davinciucberkeley-collab/DBF-VTOL/DESIGN.md

---
name: Design-Build-Fly Review Platform
description: Interactive engineering review platform for a student lift + cruise VTOL; an app shell of sidebar, sub-tabs and visual-first workspaces, dark graphite by default with a light theme, one blue signal accent.
colors:
  signal-blue: "#5B9DFF"
  signal-blue-hover: "#8AB8FF"
  signal-blue-wash: "#15243A"
  signal-blue-rule: "#2C4D7D"
  on-signal: "#0E1116"
  night-graphite: "#0E1116"
  panel-graphite: "#151A21"
  raised-graphite: "#1C222B"
  pressed-graphite: "#242B35"
  hairline: "#20262F"
  divider: "#2A313C"
  strong-rule: "#3A4250"
  text-primary: "#E6EAF0"
  text-secondary: "#A3ADBA"
  text-tertiary: "#828C9A"
  status-met: "#5FD3A2"
  status-met-wash: "#10301F"
  status-risk: "#F0C46E"
  status-risk-wash: "#33270F"
  status-fail: "#F59393"
  status-fail-wash: "#391B1D"
  status-fail-frame: "#7A3A3D"
  status-open: "#B9AEFF"
  status-open-wash: "#251F45"
  status-open-frame: "#4A4290"
  series-1: "#6EA8FE"
  series-2: "#5CC8B8"
  series-3: "#E8B65A"
  series-4: "#D98BC0"
  series-5: "#9AA7B8"
  series-6: "#A9C46A"
  stage-top: "#1B212A"
  stage-bottom: "#0F1318"
  drawing-paper: "#FFFFFF"
  light-canvas: "#F7F8FA"
  light-panel: "#FFFFFF"
  light-raised: "#EEF1F5"
  light-pressed: "#E3E7ED"
  light-hairline: "#E6E9EE"
  light-divider: "#DADEE4"
  light-strong-rule: "#B9C0CA"
  light-text-primary: "#0F1419"
  light-text-secondary: "#4A5361"
  light-text-tertiary: "#616B79"
  light-signal-blue: "#2A66CC"
  light-signal-blue-hover: "#1F57B8"
  light-signal-blue-wash: "#E7EFFC"
  light-signal-blue-rule: "#A9C3EE"
  light-status-met: "#11734A"
  light-status-met-wash: "#E3F5EC"
  light-status-risk: "#8A5A0B"
  light-status-risk-wash: "#FBF0D9"
  light-status-fail: "#A42828"
  light-status-fail-wash: "#FBE5E5"
  light-status-fail-frame: "#E2A5A5"
  light-status-open: "#4B3BA8"
  light-status-open-wash: "#ECE9FC"
  light-status-open-frame: "#B7AEEB"
  light-series-2: "#1E8C7E"
  light-series-3: "#B7791F"
  light-series-4: "#A2427F"
  light-series-5: "#5B6B7C"
  light-series-6: "#5F7A1E"
  light-stage-top: "#F3F5F8"
  light-stage-bottom: "#DCE1E8"
  print-canvas: "#FBFBFA"
  print-surface-2: "#F4F5F6"
  print-line: "#E3E5E8"
  print-line-2: "#CBCFD4"
  print-line-3: "#9EA4AC"
  print-text-primary: "#16191D"
  print-text-secondary: "#474E57"
  print-text-tertiary: "#6C737C"
  print-status-met: "#23744A"
  print-status-risk: "#94600A"
  print-status-fail: "#AD2A1F"
  print-status-open: "#57489A"
typography:
  cover-title:
    fontFamily: "IBM Plex Sans, system-ui, -apple-system, Segoe UI, sans-serif"
    fontSize: "1.875rem"
    fontWeight: 600
    lineHeight: 1.15
    letterSpacing: "-0.025em"
  page-title:
    fontFamily: "IBM Plex Sans, system-ui, -apple-system, Segoe UI, sans-serif"
    fontSize: "1.625rem"
    fontWeight: 600
    lineHeight: 1.15
    letterSpacing: "-0.02em"
  verdict-headline:
    fontFamily: "IBM Plex Sans, system-ui, -apple-system, Segoe UI, sans-serif"
    fontSize: "1.5rem"
    fontWeight: 600
    lineHeight: 1.3
    letterSpacing: "-0.02em"
  section-title:
    fontFamily: "IBM Plex Sans, system-ui, -apple-system, Segoe UI, sans-serif"
    fontSize: "1.125rem"
    fontWeight: 600
    lineHeight: 1.15
    letterSpacing: "-0.012em"
  subhead:
    fontFamily: "IBM Plex Sans, system-ui, -apple-system, Segoe UI, sans-serif"
    fontSize: "0.9375rem"
    fontWeight: 600
    lineHeight: 1.15
    letterSpacing: "-0.012em"
  lede:
    fontFamily: "IBM Plex Sans, system-ui, -apple-system, Segoe UI, sans-serif"
    fontSize: "1.0625rem"
    fontWeight: 400
    lineHeight: 1.65
  body:
    fontFamily: "IBM Plex Sans, system-ui, -apple-system, Segoe UI, sans-serif"
    fontSize: "0.9375rem"
    fontWeight: 400
    lineHeight: 1.6
    letterSpacing: "-0.003em"
    fontFeature: "tnum"
  ui-label:
    fontFamily: "IBM Plex Sans, system-ui, -apple-system, Segoe UI, sans-serif"
    fontSize: "0.875rem"
    fontWeight: 500
    lineHeight: 1.3
  meta-label:
    fontFamily: "IBM Plex Sans, system-ui, -apple-system, Segoe UI, sans-serif"
    fontSize: "0.75rem"
    fontWeight: 500
    lineHeight: 1.3
    letterSpacing: "0.01em"
  chip:
    fontFamily: "IBM Plex Sans, system-ui, -apple-system, Segoe UI, sans-serif"
    fontSize: "0.75rem"
    fontWeight: 600
    lineHeight: 1
  data-value:
    fontFamily: "IBM Plex Mono, ui-monospace, Cascadia Mono, Consolas, monospace"
    fontSize: "1rem"
    fontWeight: 500
    lineHeight: 1.3
    letterSpacing: "-0.01em"
  table-number:
    fontFamily: "IBM Plex Mono, ui-monospace, Cascadia Mono, Consolas, monospace"
    fontSize: "0.78rem"
    fontWeight: 400
    letterSpacing: "-0.01em"
  source-line:
    fontFamily: "IBM Plex Mono, ui-monospace, Cascadia Mono, Consolas, monospace"
    fontSize: "0.75rem"
    fontWeight: 400
    lineHeight: 1.55
  est-mark:
    fontFamily: "IBM Plex Mono, ui-monospace, Cascadia Mono, Consolas, monospace"
    fontSize: "0.75rem"
    fontWeight: 600
    lineHeight: 1
    letterSpacing: "0.04em"
  signature:
    fontFamily: "STIX Two Text, Times New Roman, serif"
    fontSize: "1rem"
    fontWeight: 400
    lineHeight: "30px"
  icon:
    fontFamily: "Material Symbols Outlined"
    fontSize: "20px"
    fontWeight: 300
    lineHeight: 1
rounded:
  mark: "4px"
  chip: "5px"
  control: "6px"
  panel: "8px"
  popover: "10px"
spacing:
  unit: "4px"
  tight: "8px"
  snug: "12px"
  base: "16px"
  roomy: "28px"
  gutter: "40px"
  topbar-height: "52px"
  sidebar-width: "248px"
  inspector-width: "300px"
  workspace-max: "1200px"
components:
  button-primary:
    backgroundColor: "{colors.signal-blue}"
    textColor: "{colors.on-signal}"
    typography: "{typography.ui-label}"
    rounded: "{rounded.control}"
    padding: "0 16px"
    height: "38px"
  button-primary-hover:
    backgroundColor: "{colors.signal-blue-hover}"
    textColor: "{colors.on-signal}"
  button-quiet:
    backgroundColor: "transparent"
    textColor: "{colors.text-primary}"
    rounded: "{rounded.control}"
    padding: "0 16px"
    height: "38px"
  button-quiet-hover:
    backgroundColor: "{colors.raised-graphite}"
  toolbar-button:
    backgroundColor: "transparent"
    textColor: "{colors.text-secondary}"
    rounded: "{rounded.control}"
    padding: "0 9px"
    height: "36px"
  toolbar-button-pressed:
    backgroundColor: "{colors.signal-blue-wash}"
    textColor: "{colors.text-primary}"
  search-trigger:
    backgroundColor: "{colors.panel-graphite}"
    textColor: "{colors.text-tertiary}"
    rounded: "{rounded.control}"
    padding: "0 9px"
    height: "36px"
    width: "220px"
  nav-item:
    backgroundColor: "transparent"
    textColor: "{colors.text-secondary}"
    typography: "{typography.ui-label}"
    rounded: "{rounded.control}"
    padding: "0 10px"
    height: "34px"
  nav-item-current:
    backgroundColor: "{colors.raised-graphite}"
    textColor: "{colors.text-primary}"
  sub-tab:
    backgroundColor: "transparent"
    textColor: "{colors.text-tertiary}"
    typography: "{typography.ui-label}"
    padding: "0 12px"
    height: "40px"
  sub-tab-selected:
    textColor: "{colors.text-primary}"
  viewer-toggle:
    backgroundColor: "{colors.raised-graphite}"
    textColor: "{colors.text-secondary}"
    rounded: "{rounded.chip}"
    padding: "0 15px"
    height: "34px"
  viewer-toggle-pressed:
    backgroundColor: "{colors.signal-blue-wash}"
    textColor: "{colors.text-primary}"
  chip-met:
    backgroundColor: "{colors.status-met-wash}"
    textColor: "{colors.status-met}"
    typography: "{typography.chip}"
    rounded: "{rounded.chip}"
    padding: "4px 7px"
  chip-risk:
    backgroundColor: "{colors.status-risk-wash}"
    textColor: "{colors.status-risk}"
    typography: "{typography.chip}"
    rounded: "{rounded.chip}"
    padding: "4px 7px"
  chip-fail:
    backgroundColor: "{colors.status-fail-wash}"
    textColor: "{colors.status-fail}"
    typography: "{typography.chip}"
    rounded: "{rounded.chip}"
    padding: "4px 7px"
  chip-open:
    backgroundColor: "{colors.status-open-wash}"
    textColor: "{colors.status-open}"
    typography: "{typography.chip}"
    rounded: "{rounded.chip}"
    padding: "4px 7px"
  est-mark:
    backgroundColor: "transparent"
    textColor: "{colors.text-secondary}"
    typography: "{typography.est-mark}"
    rounded: "{rounded.mark}"
    padding: "2px 4px"
  panel:
    backgroundColor: "{colors.panel-graphite}"
    textColor: "{colors.text-primary}"
    rounded: "{rounded.panel}"
    padding: "16px 18px"
  key-parameter-row:
    backgroundColor: "{colors.panel-graphite}"
    textColor: "{colors.text-primary}"
    typography: "{typography.data-value}"
    padding: "10px 14px"
  search-palette:
    backgroundColor: "{colors.panel-graphite}"
    textColor: "{colors.text-primary}"
    rounded: "{rounded.popover}"
    width: "640px"
---

# Design System: Design-Build-Fly Review Platform

## Overview

**Creative North Star: "The Engineering Workspace"**

The review is a tool the client and the team work inside, not a document they scroll. It borrows its presentation of geometry from Onshape, its organisation of analysis cases from SimScale, and its type, spacing and navigation from Linear. A sticky top bar and a persistent left sidebar frame a single workspace; each chapter is a page, long chapters split into sub-tabs, and wherever the project owns a viewer (the live SOLIDWORKS model, the drawing set, the CFD flow field) that viewer leads the page with an inspector beside it.

The surface is quiet so the engineering can be loud. Dark graphite is the default and a light theme is one click away; both are built from the same token names. One blue signal accent marks where the reader is and what is selected. Green, amber, red and violet are reserved for verdicts, and every other hue belongs to data. Panels are flat with 1px borders and 8px corners; nothing floats except popovers. Numbers, parameters and source paths are set in IBM Plex Mono so a reader can tell measured values from prose at a glance.

The traditional report is not abandoned. Report view and print render every page in order from the same content as one document, with a cover, revision record, approvals, contents and every disclosure open.

**Key Characteristics:**
- App shell: 52px sticky top bar, 248px sidebar, workspace capped at 1200px.
- Pages are chapters; sub-tabs come from the chapter's own section headings; hash routes per page and tab.
- Visual-first workspaces: the viewer leads, a 300px inspector sits beside it.
- IBM Plex Sans for prose and UI, IBM Plex Mono for anything measured or cited.
- One blue signal accent; verdict colours carry status only; other hues are data.
- Flat 1px panels, 8px radius, shadows on popovers only.
- Key parameters are a spec list, never hero metric tiles.

## Colors

A cool, low-chroma graphite (or near-white) field, one blue signal, four tinted verdict hues and a separate data palette.

### Primary
- **Signal Blue** (signal-blue; light theme light-signal-blue): links, keyboard focus rings, the selected sub-tab underline, the current sidebar entry's icon, the brand mark, pressed viewer toggles (as a wash with a blue rule), the highlighted row in the search palette, measurement IDs, and the fill of the one primary button style. It is never a status and never a large area.
- **Signal Blue Hover** (signal-blue-hover): link and primary-button hover.
- **Signal Blue Wash / Rule** (signal-blue-wash, signal-blue-rule): the selected state of toggles, the chosen table row, the picked concept card and the active Report view button. A wash with a 1px blue rule is how selection looks on any control larger than a link.

### Tertiary (verdicts)
- **Met** (status-met, on status-met-wash), **At risk** (status-risk, on status-risk-wash), **Fail** (status-fail, on status-fail-wash, framed by status-fail-frame on blocking decisions), **Open** (status-open, on status-open-wash, framed by status-open-frame). Light-theme equivalents carry the light- prefix. These colour status chips, verdict table cells, key-parameter values and decision-card labels, and nothing else.

### Data
- **Series 1 to 6** (series-1 to series-6; light theme uses light-signal-blue as series 1 and light-series-2 to 6): chart series, the design-iterations bars and the CFD colour ramps. Warm and cool hues outside the accent and verdict sets appear only here.
- **Model stage** (stage-top to stage-bottom): the radial gradient behind the live CAD model.
- **Drawing Paper** (drawing-paper): drawing sheets and the static render sit on white in both themes, because the shop drawings are white sheets.

### Neutral
- **Night Graphite** (night-graphite): page canvas, top bar (at 92% with a blur), sidebar and table header background in dark.
- **Panel Graphite** (panel-graphite): every panel: key parameters, tables, charts, viewers, inspector, decision cards, cover, palette.
- **Raised Graphite** (raised-graphite): hover fills, the current sidebar entry, inline code, recommendation boxes, total rows.
- **Pressed Graphite** (pressed-graphite): pressed segmented buttons and viewer-toggle hover.
- **Hairline** (hairline): panel borders, row dividers, the top bar and sidebar edges, the sub-tab baseline.
- **Divider** (divider): control borders, table header underline, decision-card frames.
- **Strong Rule** (strong-rule): the EST outline, scrollbar thumbs, signature lines, total-row rules, chart axes.
- **Text Primary / Secondary / Tertiary** (text-primary, text-secondary, text-tertiary): headings and values; prose summaries, labels and inactive controls; meta, captions, sources, group labels and numbering.
- The light theme mirrors every neutral with the light- prefix.

### Print
Print and the printing state switch to a fixed warm-white paper palette (print- tokens) regardless of screen theme, so charts redrawn before printing use it.

### Named Rules
**The One Signal Rule.** Blue means "here" or "selected" or "follow this". It is never a status, never a section fill and never decoration. A second accent hue is not added.

**The Verdict Colours Rule.** Green, amber, red and violet mean met, at risk, fail and open, and nothing else. They never colour chart series or decoration, and no status is shown that the analysis has not established.

**The Never-Colour-Alone Rule.** Every status shown by colour is also stated in words: chips carry their label, verdict cells carry a note, decision cards carry an "Open" or "Blocking" label.

**The Data-Owns-Hue Rule.** Warm and cool hues beyond the accent and the verdicts are reserved for data: chart series, CFD ramps and the model stage.

## Typography

**Display Font:** IBM Plex Sans (with system-ui, -apple-system, Segoe UI, sans-serif)
**Body Font:** IBM Plex Sans 400/500/600
**Label/Mono Font:** IBM Plex Mono 400/500 (with ui-monospace, Cascadia Mono, Consolas)
**Signature Font:** STIX Two Text italic, loaded only in italic
**Icons:** Material Symbols Outlined, weight 300, unfilled, 19 to 22px

**Character:** A neutral, engineered sans that stays out of the way, paired with its own mono so values and file paths read as a different register without a different personality.

### Hierarchy
- **Cover title** (600, 1.875rem, 1.15, -0.025em): the report title on Report info and in Report view.
- **Page title** (600, 1.625rem, 1.15, -0.02em; 1.375rem below 560px): each page's heading, preceded by its chapter number in mono at text-tertiary. Hidden on the Overview home page, where the verdict headline leads.
- **Verdict headline** (600, 1.5rem, 1.3, -0.02em; 1.25rem on phones): the first bold sentence of the Overview verdict, capped at 34ch.
- **Section title** (600, 1.125rem): sub-section headings; these also become the sub-tab labels.
- **Subhead** (600, 0.9375rem): panel and box headings such as "What the team must measure".
- **Lede** (400, 1.0625rem, 1.65): chapter verdict paragraphs in text-secondary with bold phrases in text-primary, to 78ch.
- **Body** (400, 0.9375rem, 1.6, -0.003em): prose to 72ch, tabular numerals throughout.
- **UI label** (500, 0.875rem): sidebar entries, sub-tabs, disclosure summaries, palette results.
- **Meta label** (500, 0.75rem, 0.01em): sidebar group names, table headers, viewer control group labels.
- **Chip** (600, 0.75rem): status chips.
- **Data value** (Mono 500, 1rem, -0.01em): key-parameter values; chain values at 1.25rem.
- **Table number** (Mono 400, 0.78rem): right-aligned numeric cells.
- **Source line** (Mono 400, 0.75rem, 1.55): every citation, prefixed "Source" in the sans at 600.
- **EST mark** (Mono 600, 0.75rem, 0.04em, uppercase): the estimate label.
- **Signature** (STIX Two Text italic 400, 1rem on a 30px line): approval signature lines only.

### Named Rules
**The Mono-for-Measured Rule.** Every key-parameter value, numeric table cell, formula, file path, source line, issue chip, revision date, measurement and figure number is IBM Plex Mono. Prose, labels and controls are IBM Plex Sans.

**The Tabular Numbers Rule.** Every digit uses tabular numerals so columns of figures line up.

**The Generated Numbering Rule.** Chapter numbers are filled from page order at load and set in mono at text-tertiary; they are never typed by hand.

## Layout

The shell is a 52px sticky top bar over a fixed 248px left sidebar; the workspace beside it centres its content at a 1200px maximum with 28px top and 40px side padding (24px/28px below 1100px, 20px/16px below 900px). The sidebar groups pages as an ungrouped Overview and Requirements block, then Design, Verification, Program, Build and software, and Documentation, each with a 0.75rem group label.

A chapter with four or more section headings gets a sub-tab bar: its lead-in becomes the Summary tab, each section becomes a tab, routes read `#page/tab`, and legacy anchors resolve to the page and tab that now hold them. The CAD page opens on its model tab.

Workspaces put the visual first: a two-column grid with a 16px gap. The Overview pairs the shared live model (about 1.55fr) with the key-parameter list (minimum 300px); the CAD page pairs the model with a 300px parts inspector; the drawing viewer pairs a 220px sticky sheet rail with one large sheet. One SOLIDWORKS viewport is moved between the Overview and CAD slots rather than duplicated.

Below 1100px workspaces stack. Below 900px the sidebar becomes a focus-trapped drawer (up to 300px, 86vw) opened from a menu button, the issue chip and subtitle hide, the search and Report view buttons collapse to icons, and the sheet rail becomes a horizontal strip. Below 900px every top-bar control, sidebar entry and sub-tab grows to 44px. Spacing steps on a 4px unit, mostly 8, 12, 16 and 28px.

### Named Rules
**The Visual-First Rule.** Where the project has a viewer, the page opens on it with its inspector beside; the chapter text follows below.

**The Same-Content Report Rule.** Report view and print show the same chapters, in page order, as one document: cover with revision record and approvals, contents, every tab panel visible and every disclosure open. There is never a second copy of the content.

## Elevation & Depth

The platform is flat. Depth comes from tonal steps (canvas, panel, raised, pressed) and 1px borders. A 1px inset ring (`box-shadow: inset 0 0 0 1px`) marks a pressed or picked control; it is a border drawn inside the box, not elevation. The top bar uses a translucent canvas with a 10px blur so content passing under it stays legible.

### Shadow Vocabulary
- **Popover** (`box-shadow: 0 12px 32px rgba(0,0,0,.45), 0 2px 6px rgba(0,0,0,.3)` in dark; `0 12px 32px rgba(15,20,25,.16), 0 2px 6px rgba(15,20,25,.08)` in light): the search palette, the drawing lightbox, the narrow-screen drawer and the CAD part tooltip.

### Named Rules
**The Popover-Only Shadow Rule.** Only surfaces that sit above the workspace temporarily cast a shadow. Panels, cards, tables, charts and viewers never do.

## Shapes

Gently rounded rectangles on a fixed ladder: 4px for inline marks (code, keyboard hints, the EST mark, decision labels), 5px for status chips and viewer toggles, 6px for controls (buttons, sidebar entries, sheet rail, palette rows), 8px for panels, 10px for the search palette. Borders are always 1px; the only 2px line is the selected sub-tab's blue underline and the focus ring.

## Components

### Buttons
- **Shape:** control radius (6px), 38px tall, 16px side padding, UI label type.
- **Primary:** Signal Blue fill with on-signal text, for links out to companion documents and downloads.
- **Hover / Focus:** fill steps to Signal Blue Hover; focus is a 2px Signal Blue ring offset 2px.
- **Quiet:** transparent with a divider border and text-primary; hover adds a raised fill and strong-rule border.

### Top bar controls
- **Icon and toolbar buttons:** 36px, transparent, text-secondary, 6px radius; hover adds a raised fill. The Report view toggle carries a divider border and, when on, a blue wash with a blue rule.
- **Search trigger:** a 220px field-like button on panel-graphite with a divider border, a search icon, "Search" and a Ctrl K hint in a mono keyboard mark. It opens the search palette.
- **Issue chip:** mono 0.75rem in text-secondary with a divider border and chip radius, naming the document and issue.

### Chips
- **Style:** tinted wash with the verdict colour as text, no border, chip type, 4px 7px padding.
- **State:** met, at risk, fail and open only. The EST mark is the one outlined chip: mono uppercase in text-secondary inside a strong-rule border.

### Cards / Containers
- **Corner Style:** panel radius (8px).
- **Background:** panel-graphite on the canvas.
- **Shadow Strategy:** none (see Elevation & Depth).
- **Border:** 1px hairline; decision cards use the divider, and a blocking decision uses status-fail-frame. A picked option adds a blue inset ring.
- **Internal Padding:** 16px 18px; tables pad cells 8px 12px.

### Key parameters
A bordered spec list, not hero numbers: each row pairs a UI label in text-secondary, a mono value (in a verdict colour when it carries one) and a 0.8125rem note in text-tertiary, divided by hairlines.

### Inputs / Fields
- **Search palette input:** borderless, 50px tall, 1rem body type on the palette panel, separated from results by a hairline. Results are 40px rows with an icon, title and group; the active row takes the blue wash.
- **Sliders:** native range inputs tinted Signal Blue in a bordered panel, with mono output values.

### Navigation
- **Sidebar:** 34px entries (44px on touch widths) with a 19px outlined icon in text-tertiary and a UI label in text-secondary. Hover and current both use a raised fill; the current entry's icon turns Signal Blue and the entry carries `aria-current`.
- **Sub-tabs:** 40px text tabs on a hairline baseline, text-tertiary; the selected tab is text-primary with a 2px Signal Blue underline. Arrow keys move between them.
- **Narrow screens:** the sidebar slides in as a drawer over a canvas-tinted scrim, with the popover shadow, closed by Escape or the scrim.

### Model viewport and inspector
The live SOLIDWORKS model renders on a radial stage gradient inside a panel, with a control bar of 34px viewer toggles (raised fill; pressed = blue wash with a blue rule) and mono meta text. The inspector beside it lists parts as small bordered buttons. Touch devices tap once to arm the canvas before it takes gestures.

### Drawing sheet viewer
A sticky rail of numbered sheets (mono numbers) beside one large sheet on white paper; selecting a sheet shows it, and clicking the sheet opens a lightbox at full resolution.

### Flow viewer
The CFD view on a panel: a control bar of segmented toggles and a play button, a canvas, and a footer pairing a colour-ramp legend with a reading note.

### Report view cover
A panel holding a mono masthead, the cover title, subtitle, document reference, a revision record table and three approval signature lines in STIX italic over a strong-rule line.

## Do's and Don'ts

### Do:
- **Do** use Signal Blue only for links, focus, the current place and selection; show selection on controls as a blue wash with a 1px blue rule.
- **Do** set every measured or cited value (parameters, numeric cells, formulas, paths, sources, dates, IDs) in IBM Plex Mono with tabular numerals.
- **Do** bind every number to its repo source and print a Source line beneath it; mark estimates with the EST mark.
- **Do** lead with the viewer where a page has one, with a 300px inspector beside it above 1100px.
- **Do** build panels flat: panel-graphite, 1px hairline border, 8px radius.
- **Do** give every interactive control a 44px target on touch widths (below 900px).
- **Do** read theme tokens in charts and redraw them on theme change and before printing.
- **Do** respect reduced motion: transitions and animations switch off.

### Don't:
- **Don't** show key parameters as hero metric tiles; they are a spec list.
- **Don't** put shadows on panels, cards, tables, charts or viewers; only the palette, lightbox, drawer and CAD tooltip float.
- **Don't** add a second accent or use the verdict colours for decoration or chart series.
- **Don't** border status chips; only the EST mark is outlined.
- **Don't** show a status the analysis has not established; the states are met, at risk, fail, open and EST.
- **Don't** set UI or prose in a serif; STIX Two Text italic is for signature lines.
- **Don't** keep a separate copy of content for Report view or print.
- **Don't** set any label, chip or chart text below 12 px (0.75rem); the EST mark, key hints and decision labels sit at that floor.
