davinciucberkeley-collab/DBF-VTOL/analysis/aero/plots/aircraft_polar.png

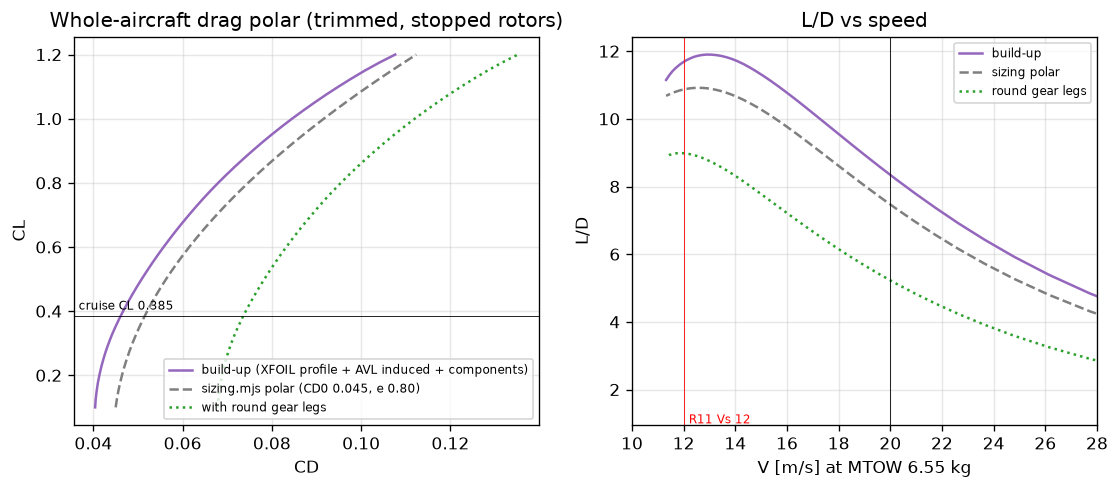
analysis/aero/plots/aircraft_polar.png
