davinciucberkeley-collab/DBF-VTOL/analysis/aero/plots/cg_np.png

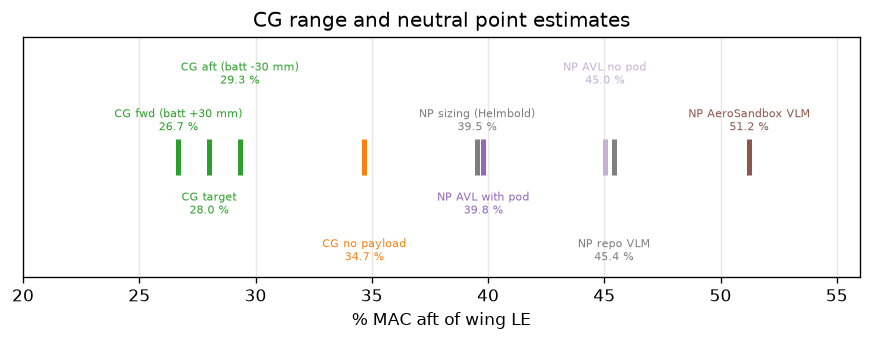
analysis/aero/plots/cg_np.png
