davinciucberkeley-collab/DBF-VTOL/analysis/aero/plots/cp_distributions.png

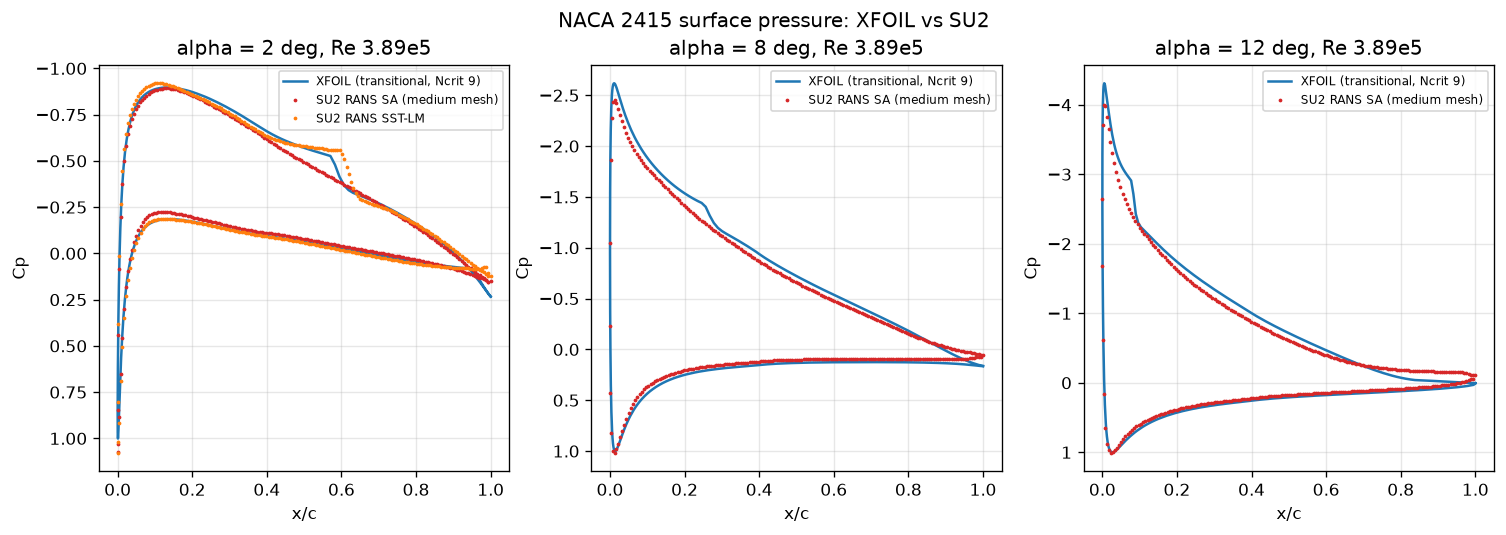
analysis/aero/plots/cp_distributions.png
