davinciucberkeley-collab/DBF-VTOL/analysis/aero/plots/drag_breakdown.png

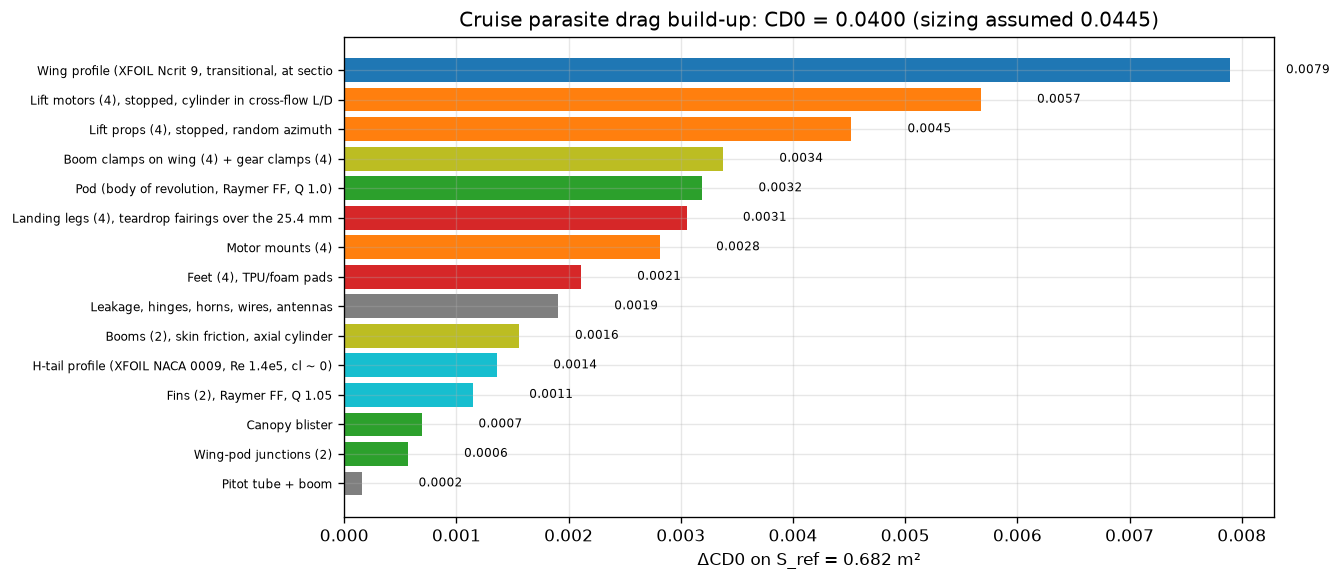
analysis/aero/plots/drag_breakdown.png
