davinciucberkeley-collab/DBF-VTOL/analysis/aero/plots/drag_pie.png

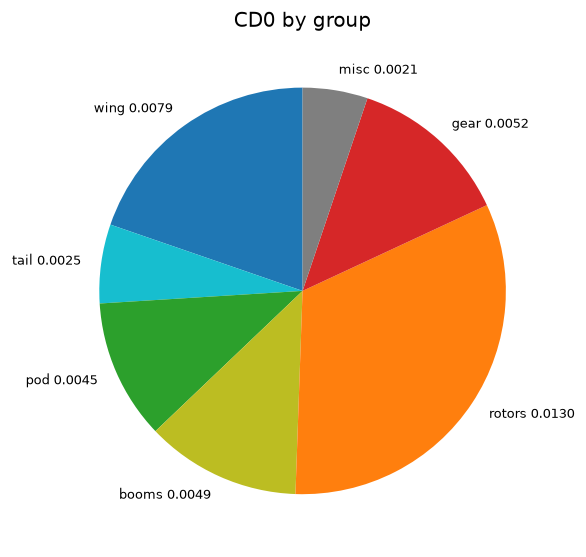
analysis/aero/plots/drag_pie.png
