davinciucberkeley-collab/DBF-VTOL/analysis/aero/plots/flow_0.png

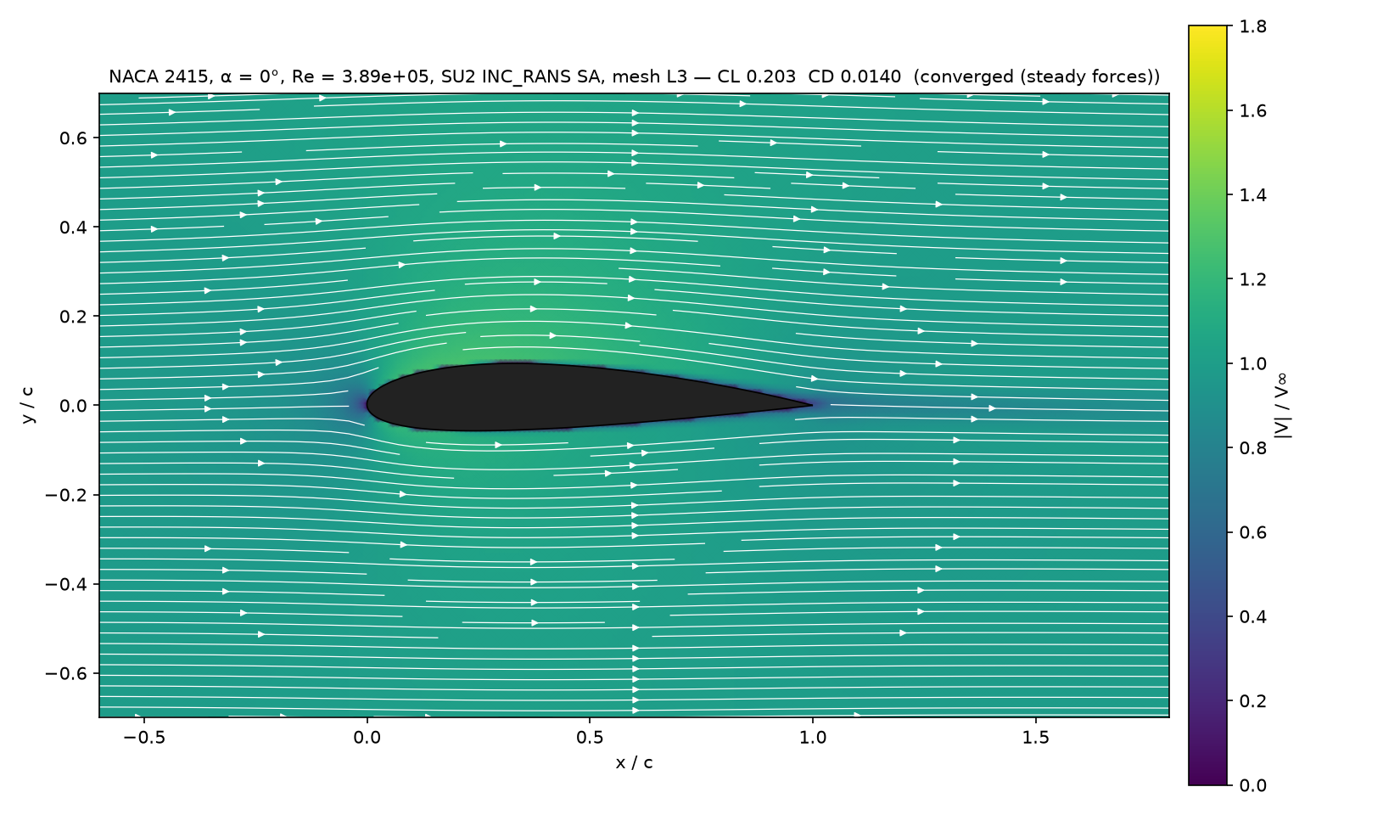
analysis/aero/plots/flow_0.png
