davinciucberkeley-collab/DBF-VTOL/analysis/aero/plots/flow_3d.png

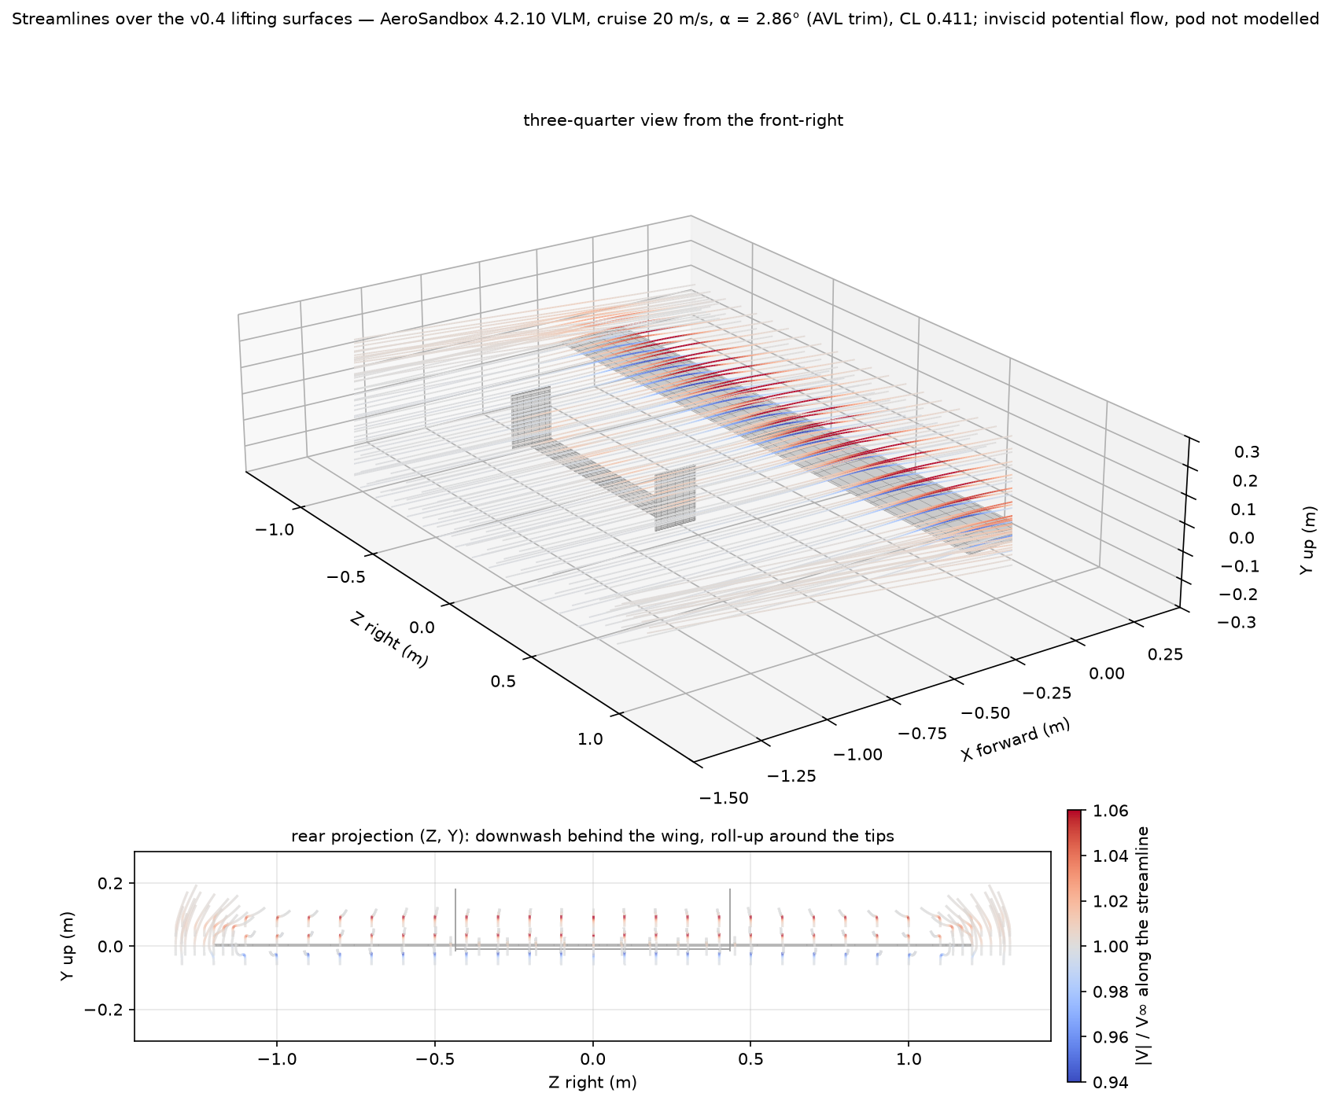
analysis/aero/plots/flow_3d.png
