davinciucberkeley-collab/DBF-VTOL/analysis/aero/plots/flow_4.png

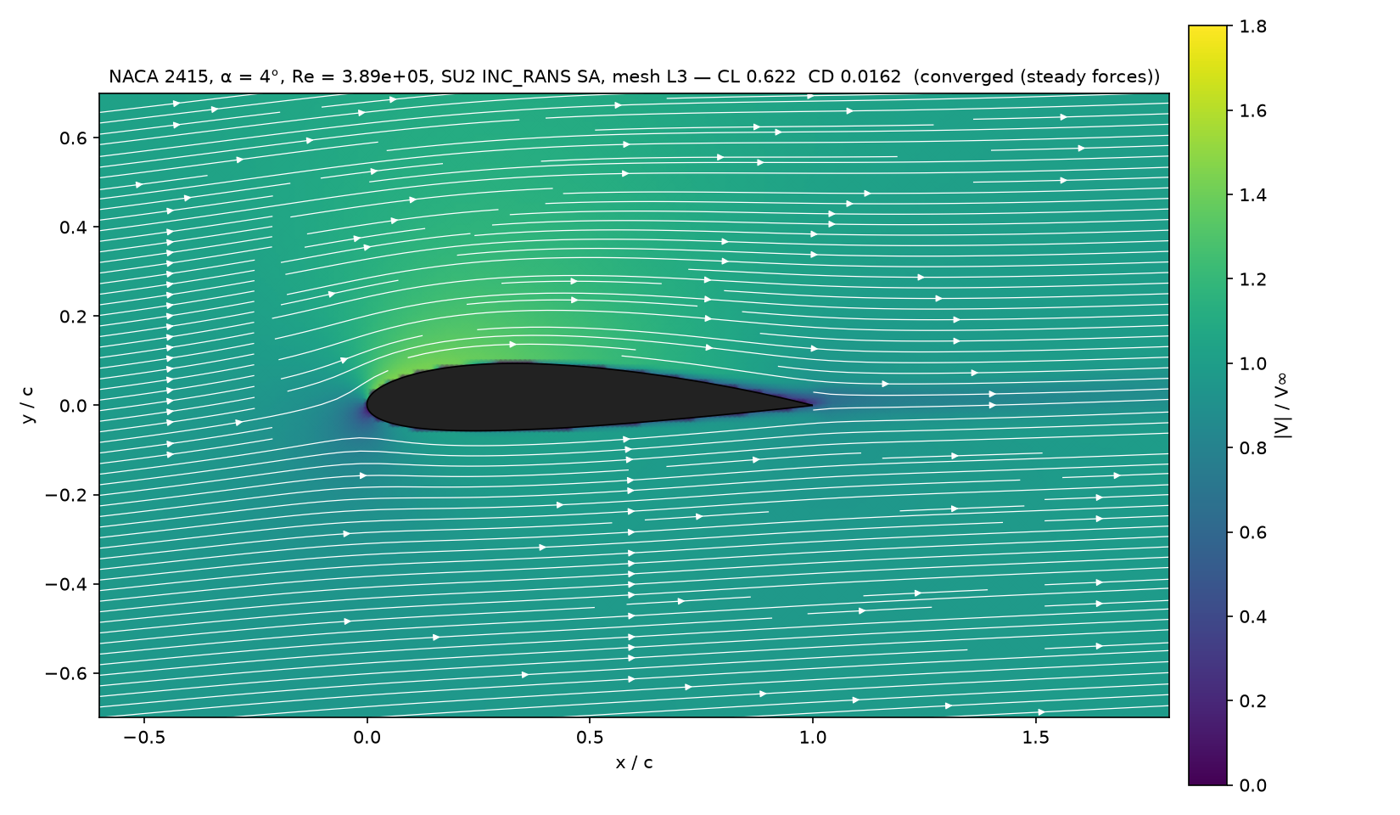
analysis/aero/plots/flow_4.png
