davinciucberkeley-collab/DBF-VTOL/analysis/aero/plots/flow_8.png

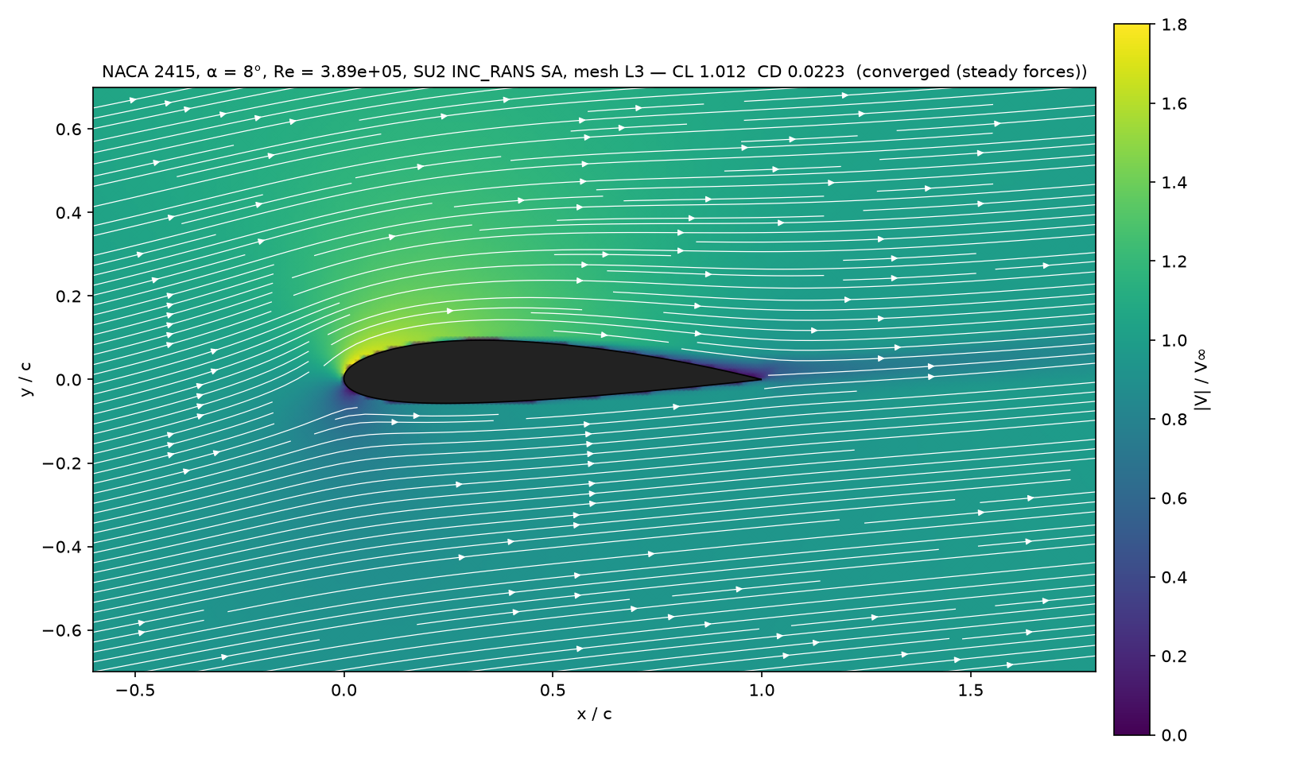
analysis/aero/plots/flow_8.png
