davinciucberkeley-collab/DBF-VTOL/analysis/aero/plots/flow_12.png

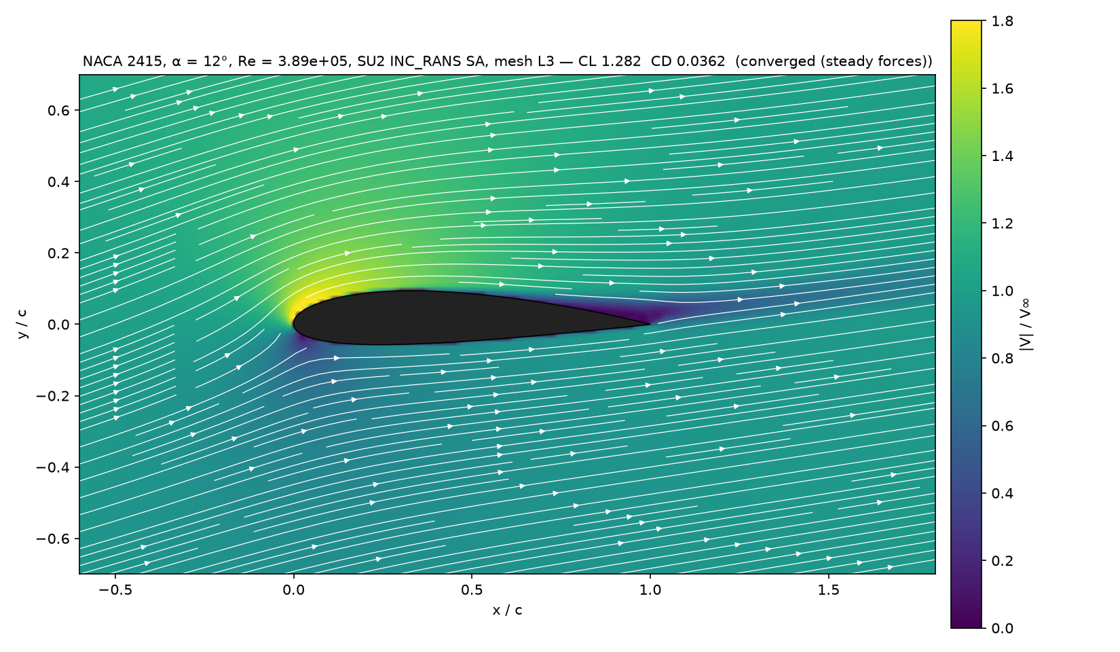
analysis/aero/plots/flow_12.png
