davinciucberkeley-collab/DBF-VTOL/analysis/aero/plots/mesh_check_L1.png

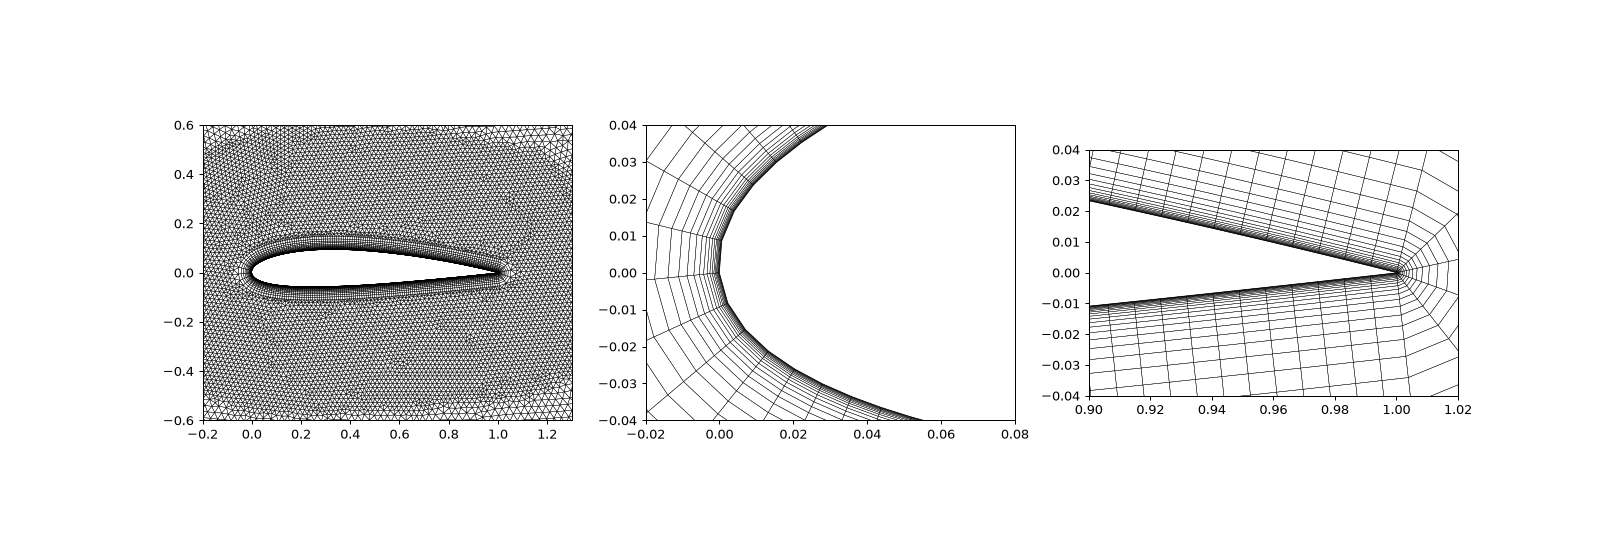
analysis/aero/plots/mesh_check_L1.png
