davinciucberkeley-collab/DBF-VTOL/analysis/aero/plots/section_polars.png

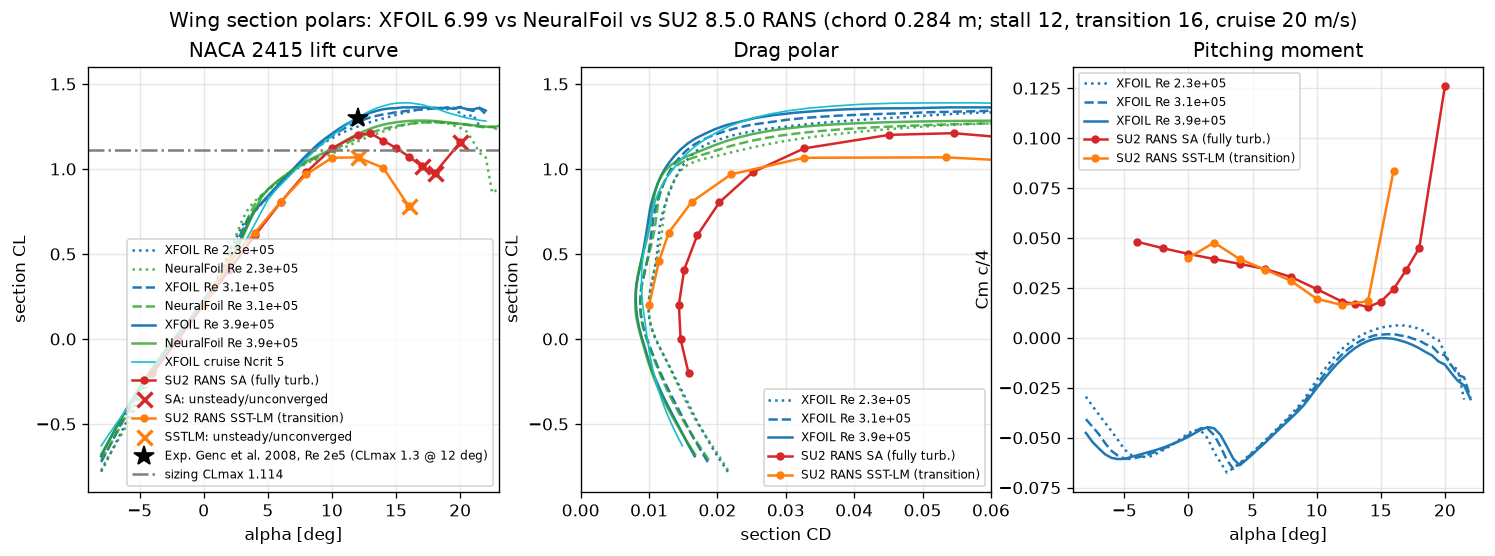
analysis/aero/plots/section_polars.png
