davinciucberkeley-collab/DBF-VTOL/analysis/aero/plots/span_loading.png

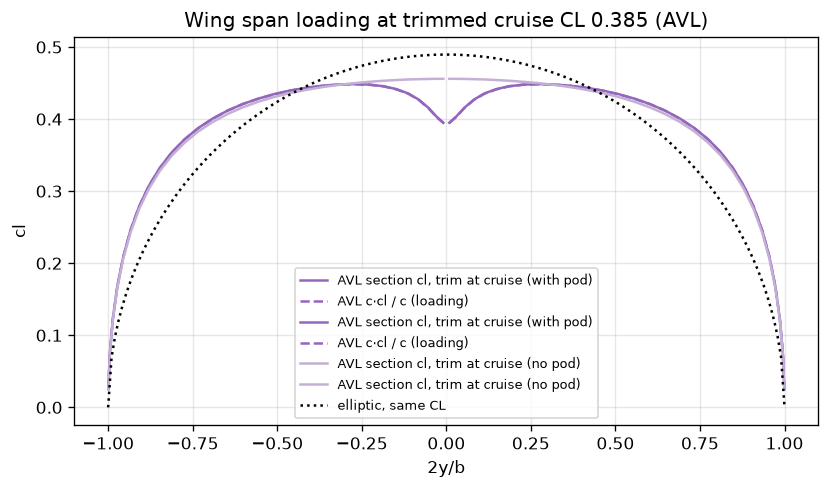
analysis/aero/plots/span_loading.png
