davinciucberkeley-collab/DBF-VTOL/analysis/aero/plots/stability.png

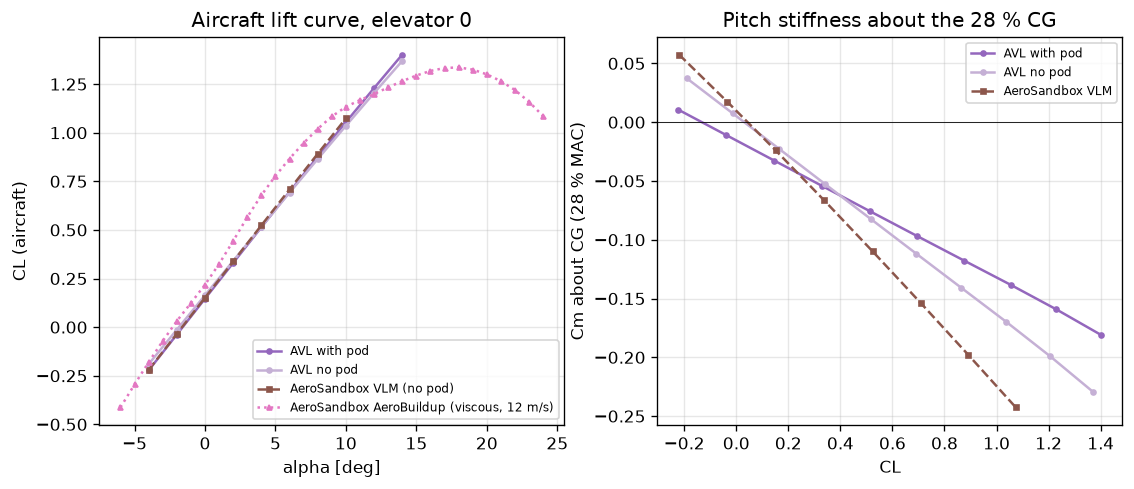
analysis/aero/plots/stability.png
