davinciucberkeley-collab/DBF-VTOL/analysis/aero/plots/su2_convergence.png

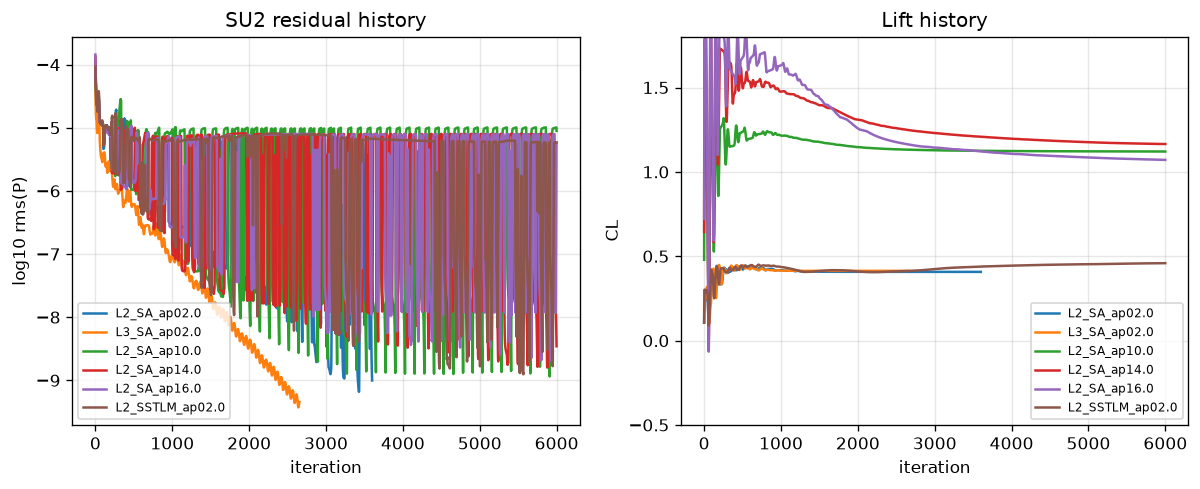
analysis/aero/plots/su2_convergence.png
