davinciucberkeley-collab/DBF-VTOL/analysis/aero/plots/su2_mesh_study.png

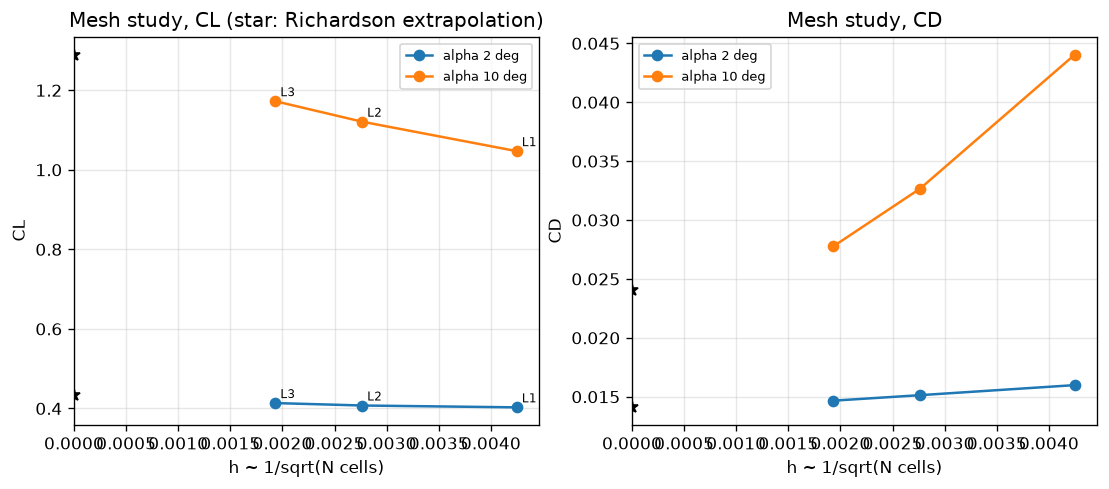
analysis/aero/plots/su2_mesh_study.png
