davinciucberkeley-collab/DBF-VTOL/analysis/aero/plots/tail_section_polars.png

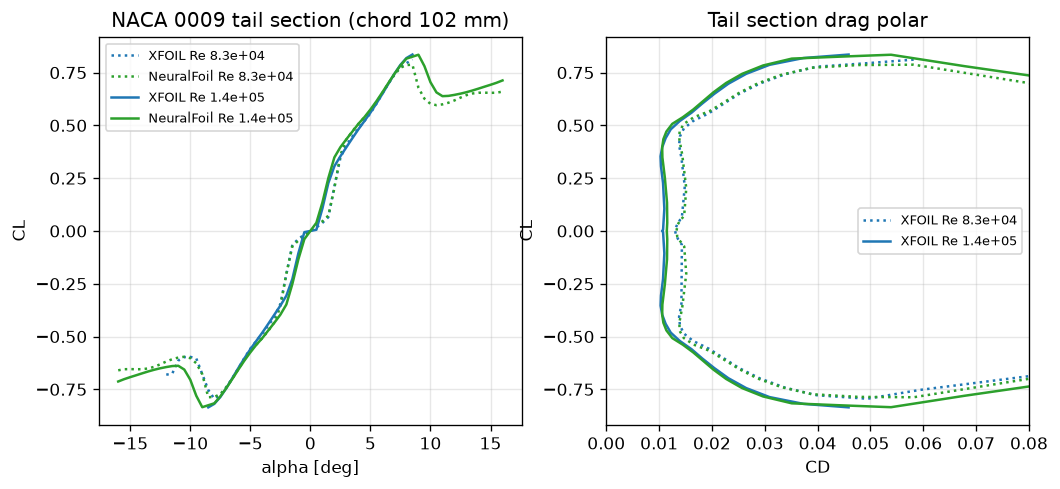
analysis/aero/plots/tail_section_polars.png
