davinciucberkeley-collab/DBF-VTOL/analysis/thermal/img/lift_unit_mission.png

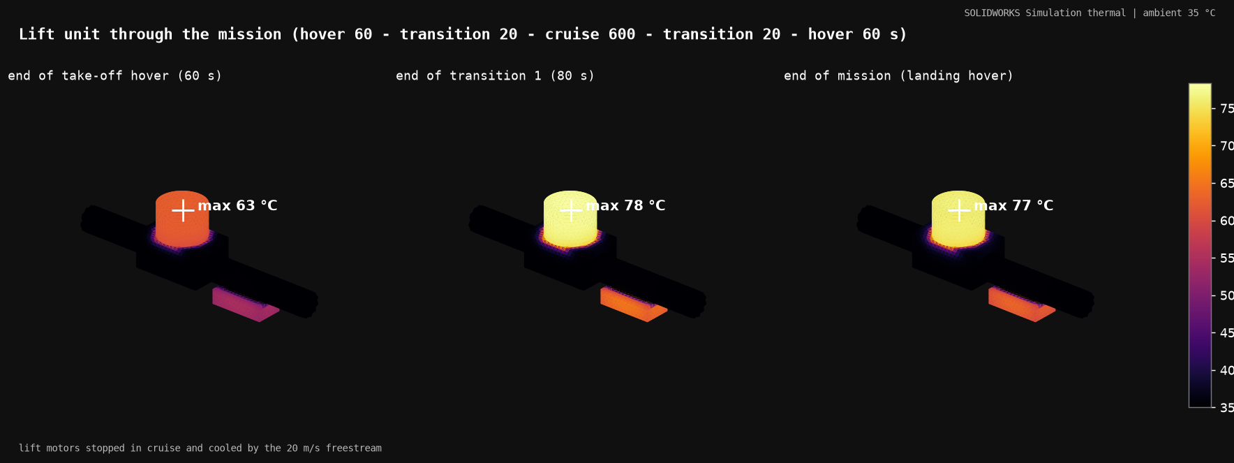
analysis/thermal/img/lift_unit_mission.png
