davinciucberkeley-collab/DBF-VTOL/analysis/thermal/img/lift_unit_steady.png

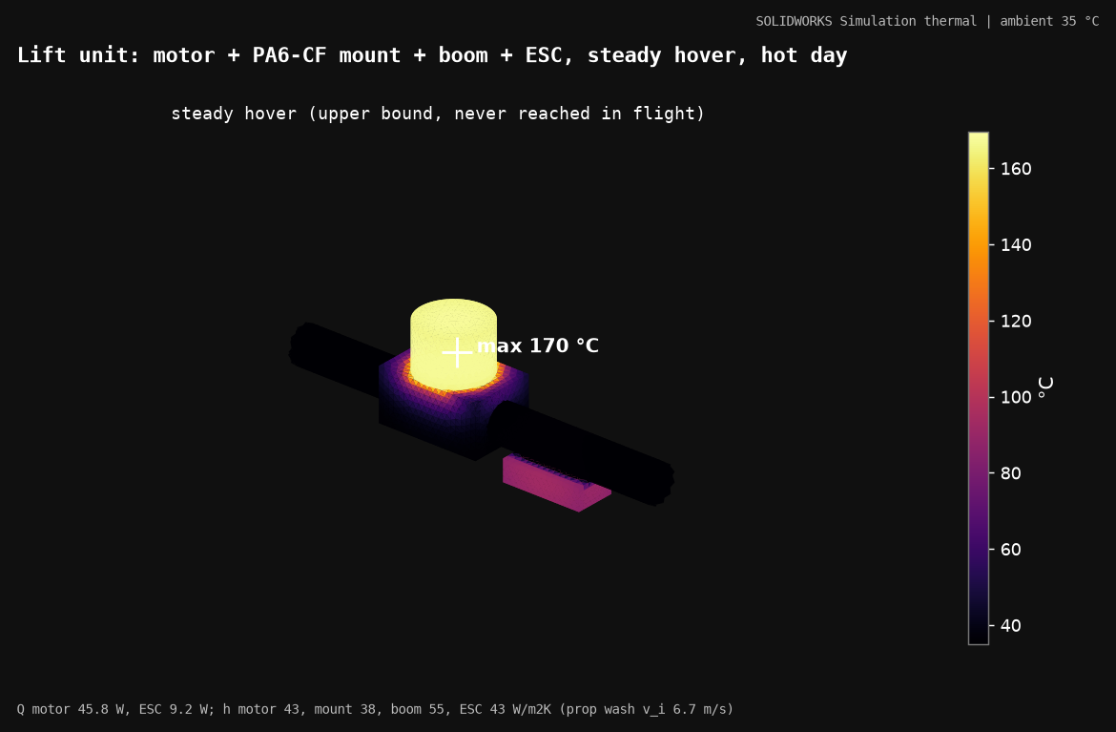
analysis/thermal/img/lift_unit_steady.png
