davinciucberkeley-collab/DBF-VTOL/analysis/thermal/img/pod_end_cruise.png

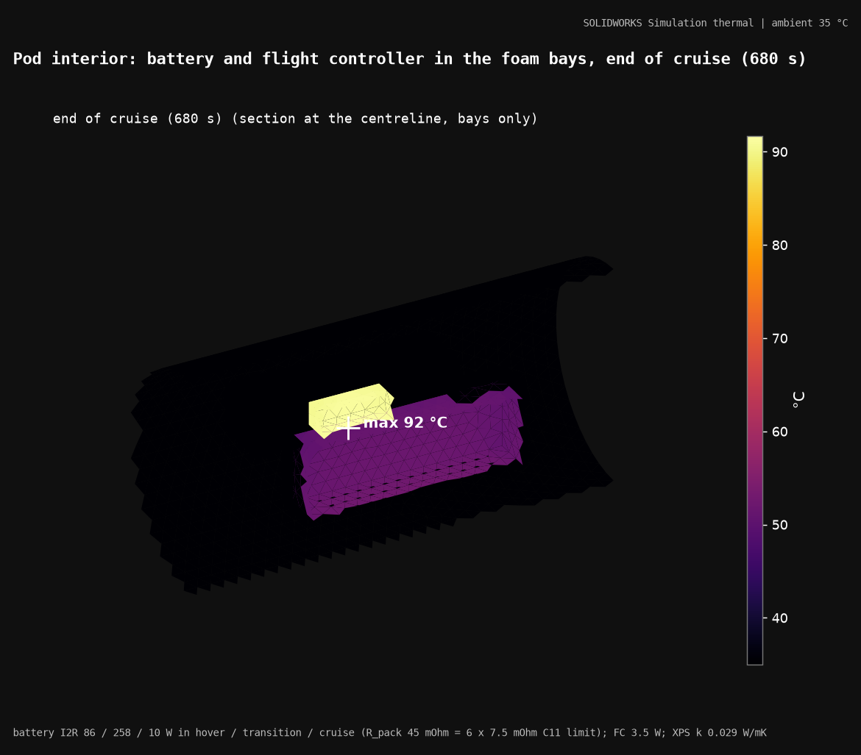
analysis/thermal/img/pod_end_cruise.png
