davinciucberkeley-collab/DBF-VTOL/analysis/thermal/img/pusher_cruise.png

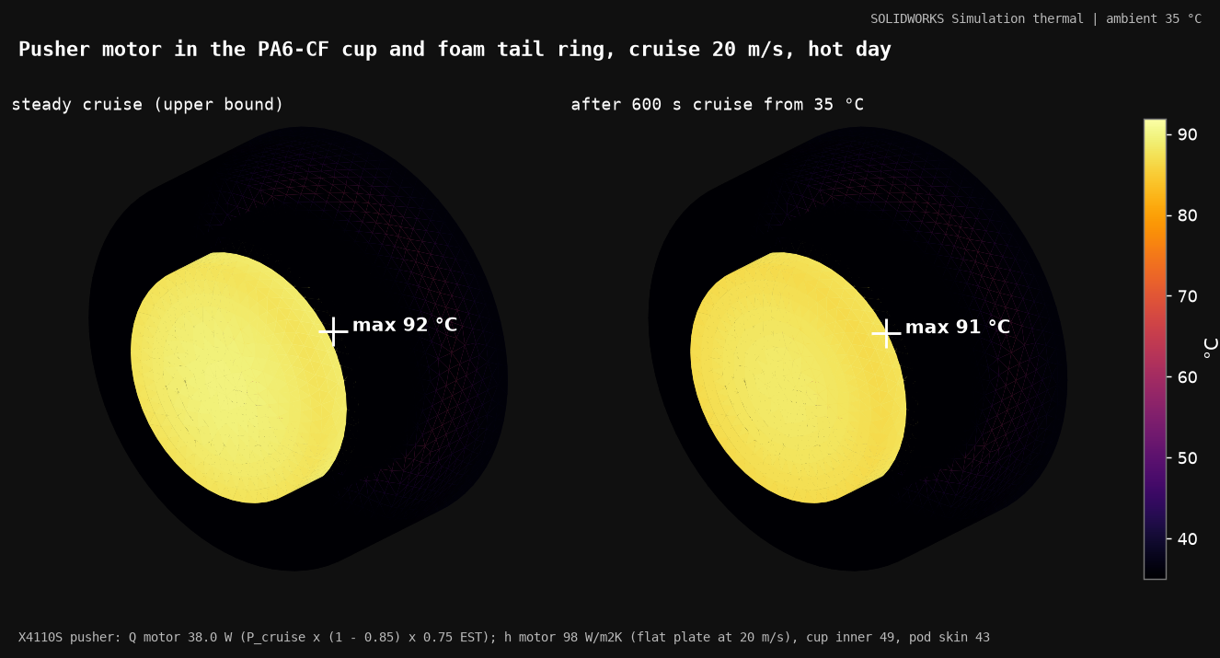
analysis/thermal/img/pusher_cruise.png
