davinciucberkeley-collab/DBF-VTOL/cad/drawings/DBF-DRW-001_sheet2.png

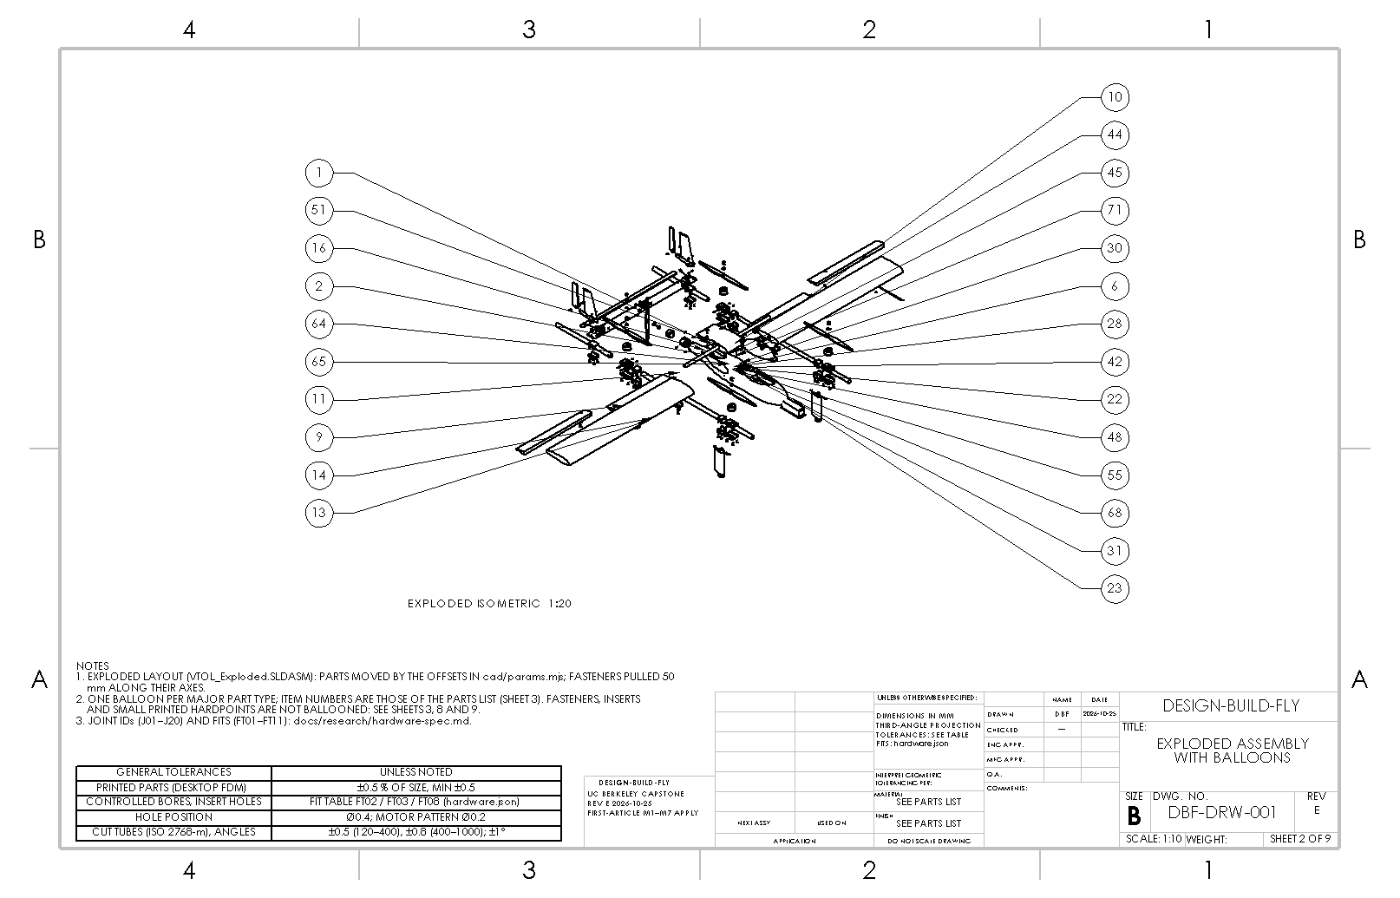
cad/drawings/DBF-DRW-001_sheet2.png
