davinciucberkeley-collab/DBF-VTOL/cad/drawings/DBF-DRW-001_sheet4.png

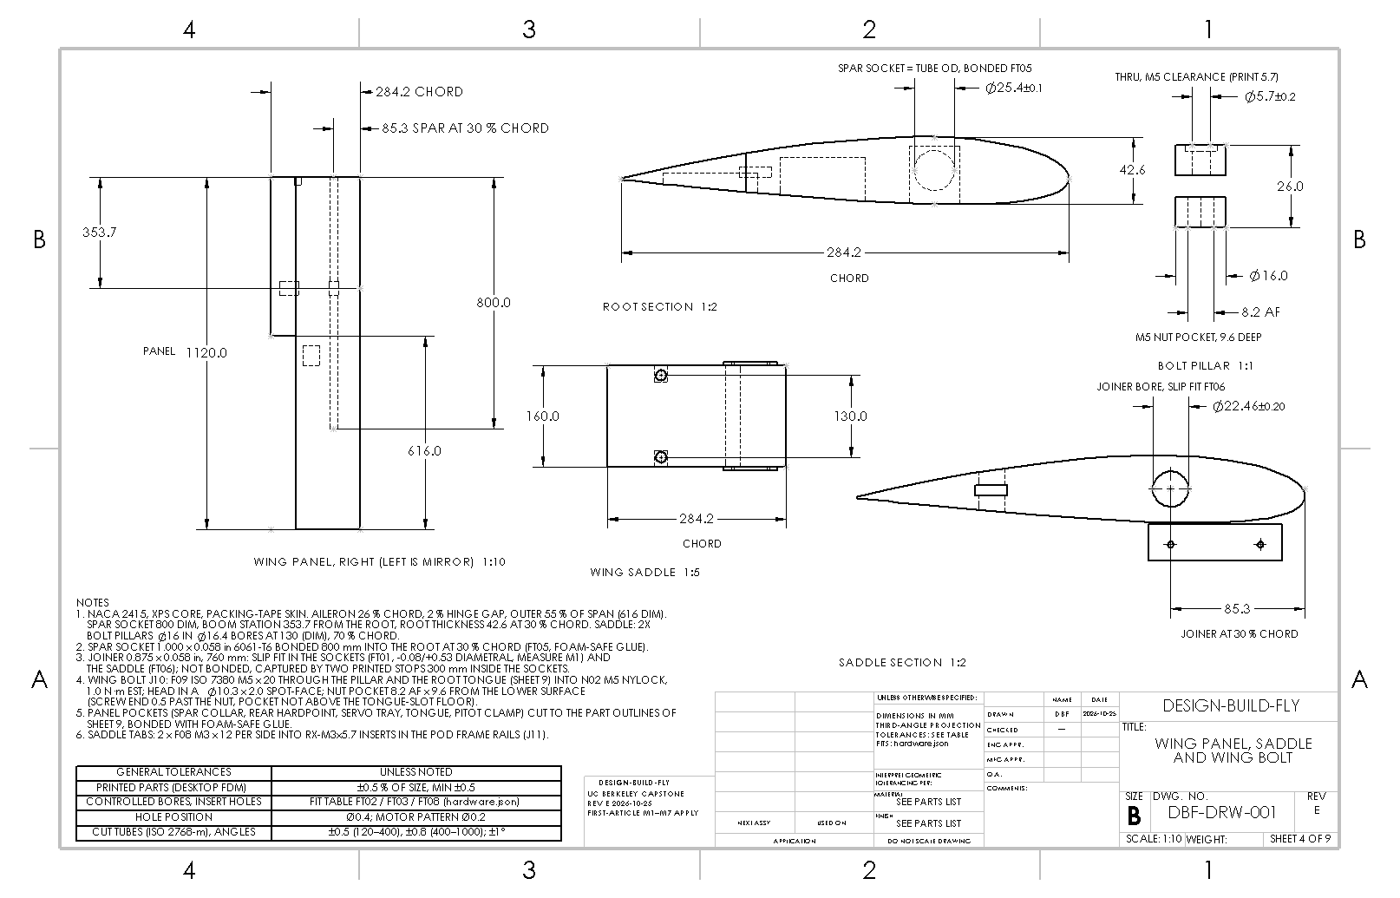
cad/drawings/DBF-DRW-001_sheet4.png
