davinciucberkeley-collab/DBF-VTOL/cad/drawings/DBF-DRW-001_sheet7.png

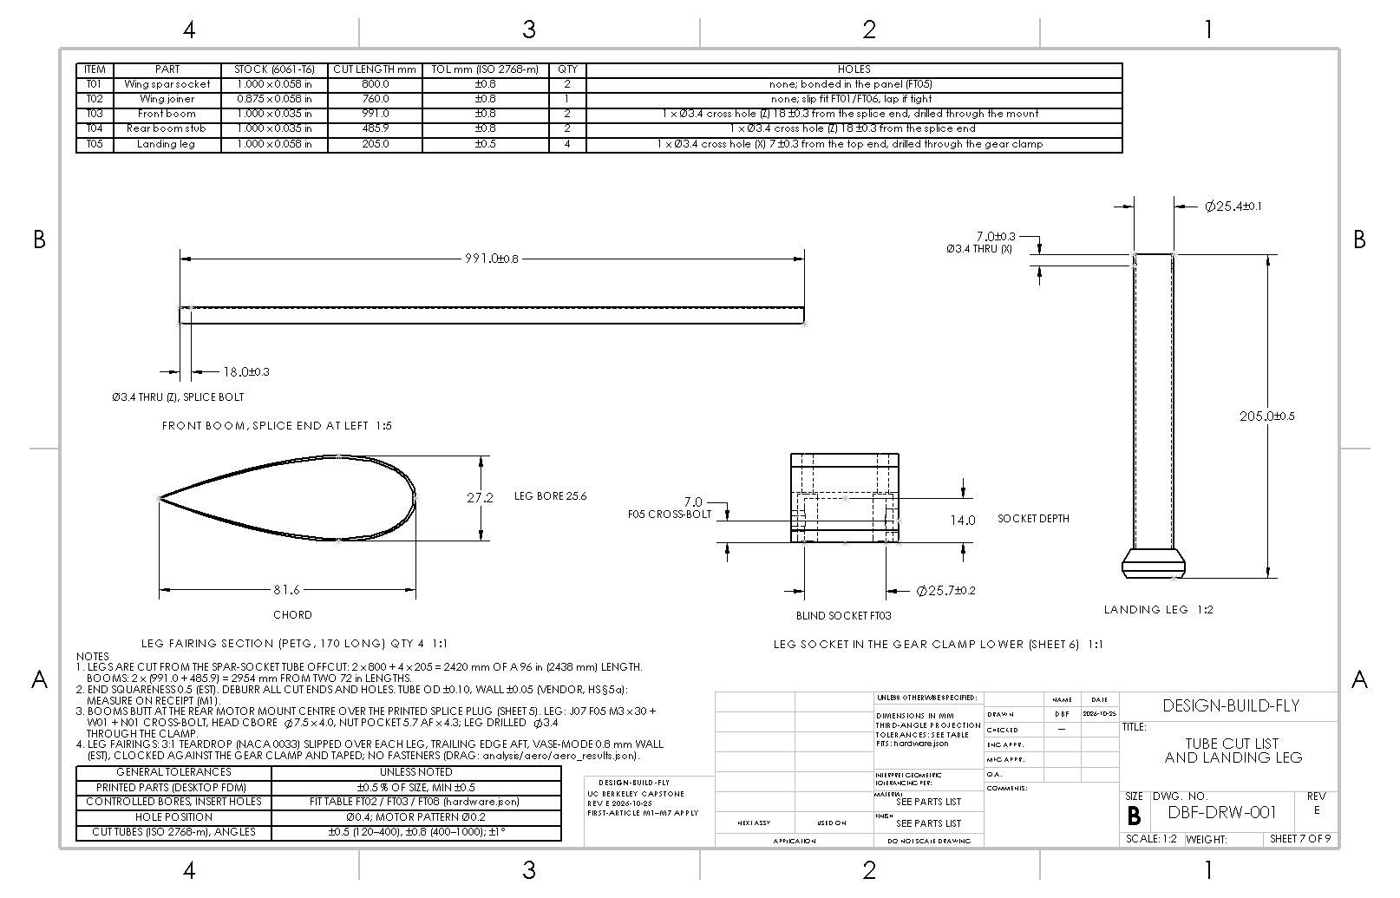
cad/drawings/DBF-DRW-001_sheet7.png
