davinciucberkeley-collab/DBF-VTOL/cad/images/VTOL_Concept_front.png

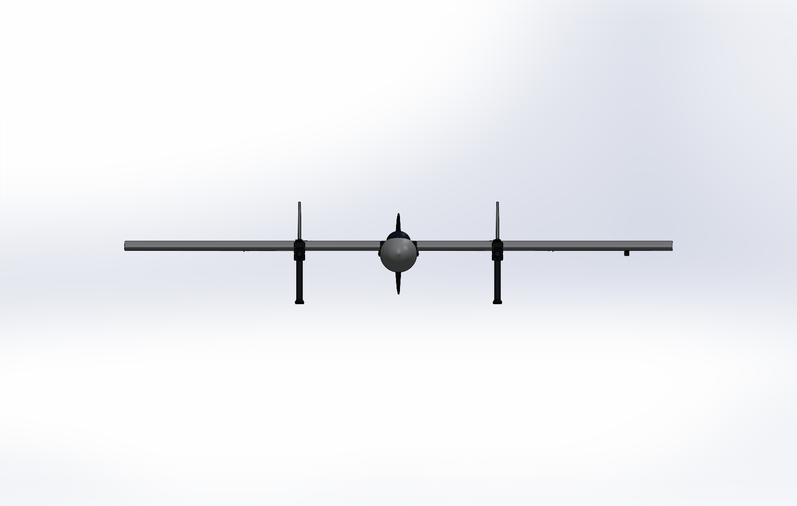
cad/images/VTOL_Concept_front.png
