davinciucberkeley-collab/DBF-VTOL/cad/sim/FEA_Boom_vonMises.png

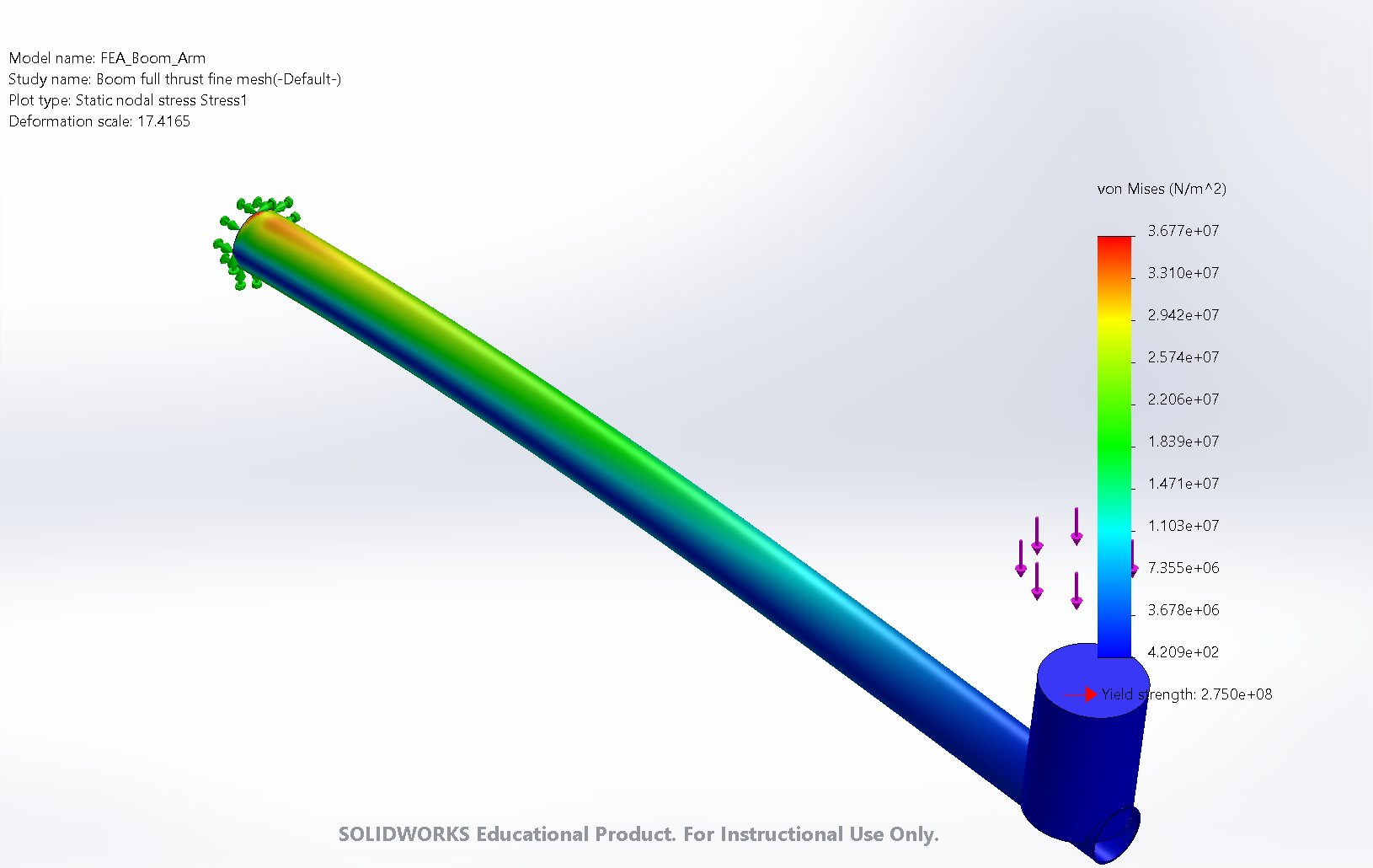
cad/sim/FEA_Boom_vonMises.png
