davinciucberkeley-collab/DBF-VTOL/cad/sim/FEA_Spar_vonMises.png

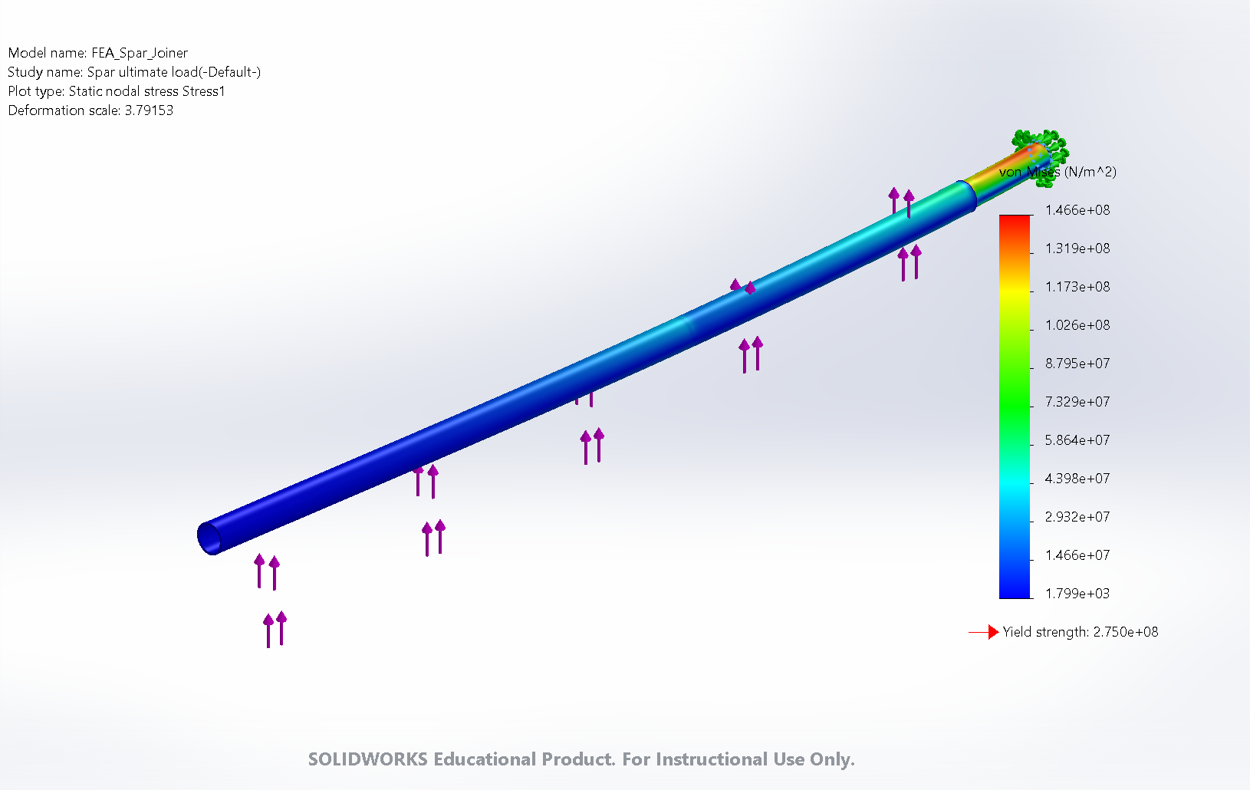
cad/sim/FEA_Spar_vonMises.png
