davinciucberkeley-collab/DBF-VTOL/concepts/variants/a1/fusion/detail_tip_nacelle.png

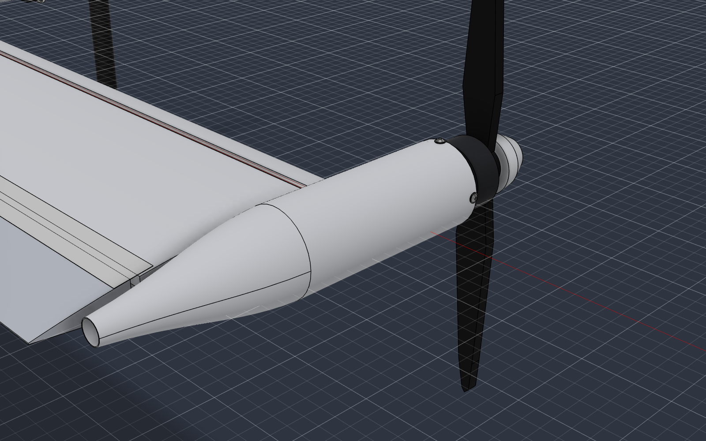
concepts/variants/a1/fusion/detail_tip_nacelle.png
