davinciucberkeley-collab/DBF-VTOL/concepts/variants/a1/fusion/view_iso.png

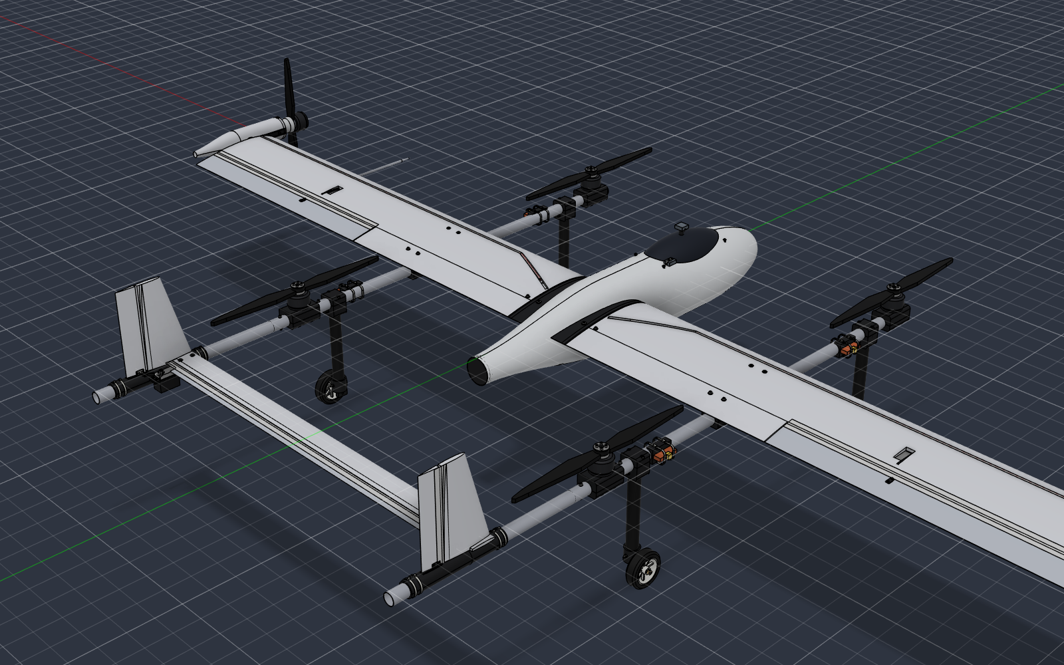
concepts/variants/a1/fusion/view_iso.png
