davinciucberkeley-collab/DBF-VTOL/concepts/variants/a1/fusion/view_side.png

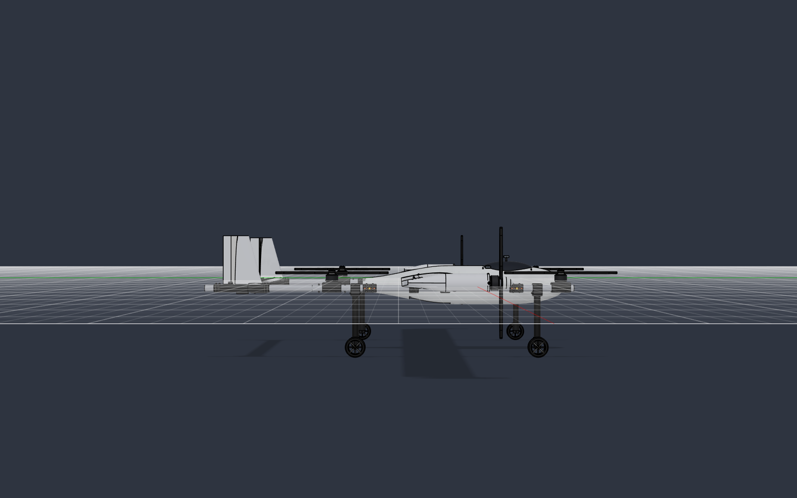
concepts/variants/a1/fusion/view_side.png
