davinciucberkeley-collab/DBF-VTOL/concepts/variants/a1/fusion/view_top.png

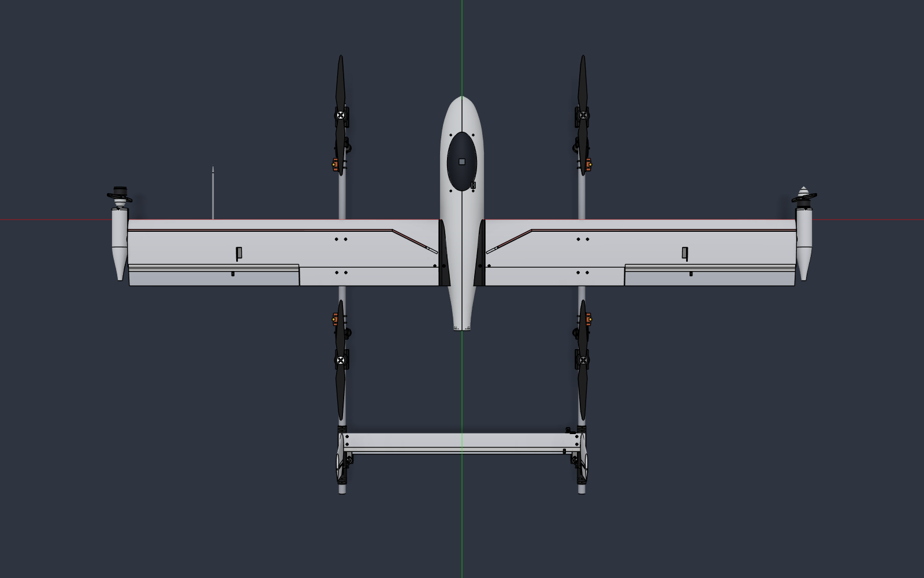
concepts/variants/a1/fusion/view_top.png
