davinciucberkeley-collab/DBF-VTOL/concepts/variants/a2/fusion/detail_tail_cone.png

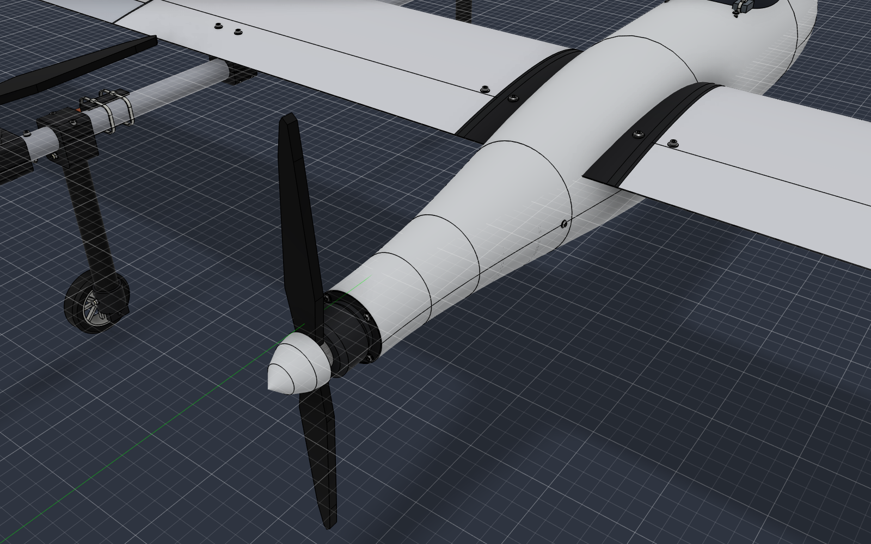
concepts/variants/a2/fusion/detail_tail_cone.png
