davinciucberkeley-collab/DBF-VTOL/concepts/variants/a2/fusion/view_iso.png

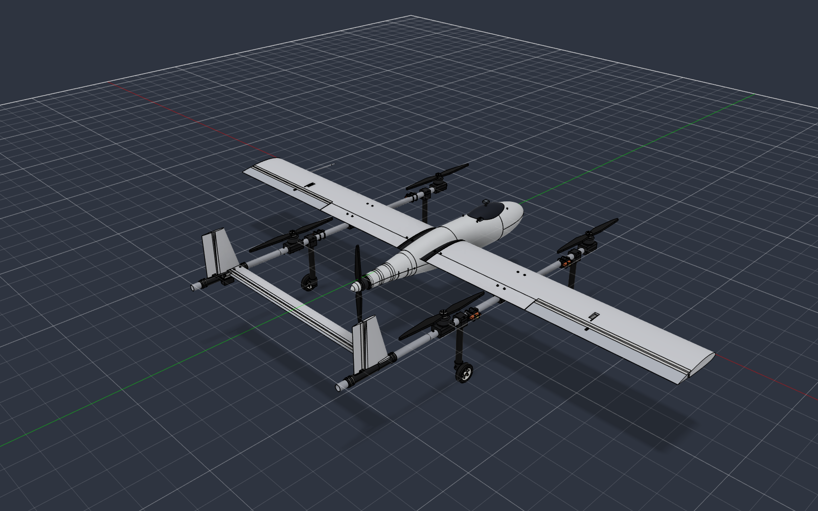
concepts/variants/a2/fusion/view_iso.png
