davinciucberkeley-collab/DBF-VTOL/concepts/variants/a2/fusion/view_side.png

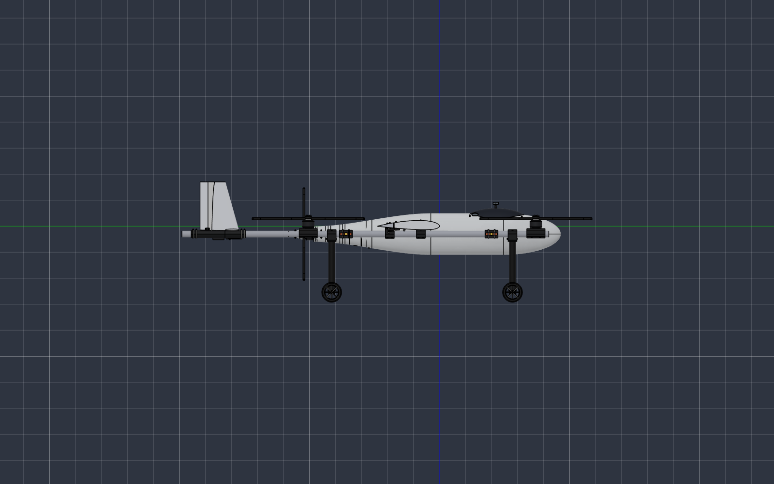
concepts/variants/a2/fusion/view_side.png
