davinciucberkeley-collab/DBF-VTOL/concepts/variants/a2/fusion/view_top.png

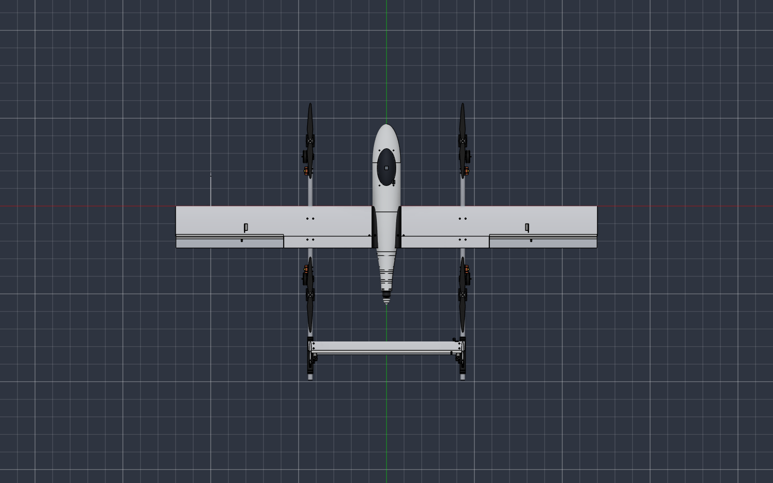
concepts/variants/a2/fusion/view_top.png
