davinciucberkeley-collab/DBF-VTOL/concepts/variants/a3/fusion/detail_nacelle.png

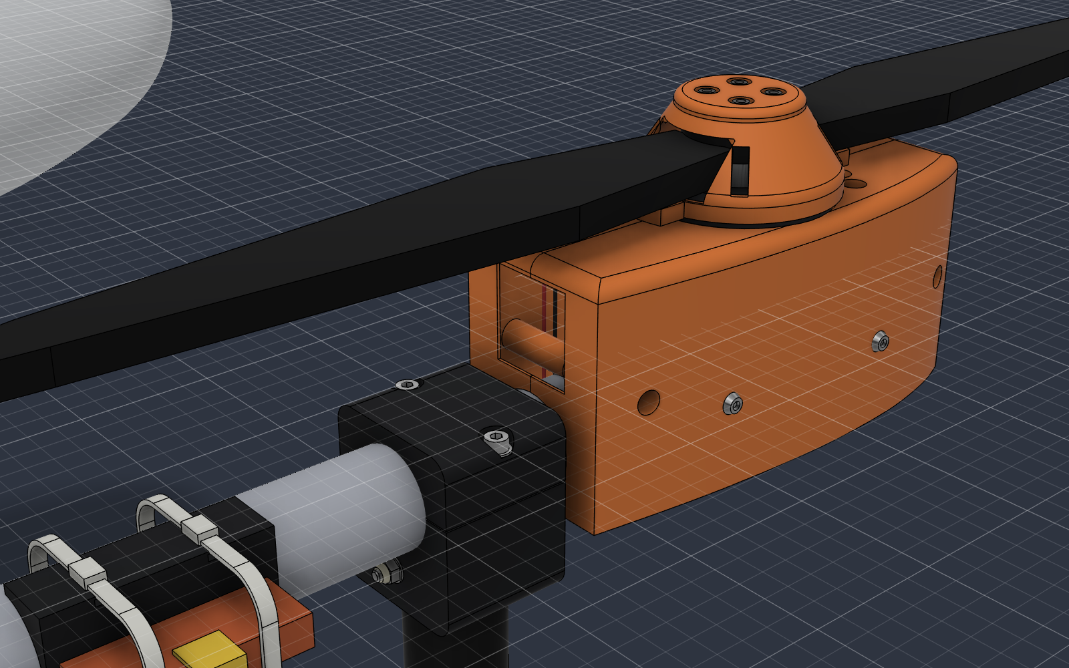
concepts/variants/a3/fusion/detail_nacelle.png
