davinciucberkeley-collab/DBF-VTOL/concepts/variants/a3/fusion/view_top.png

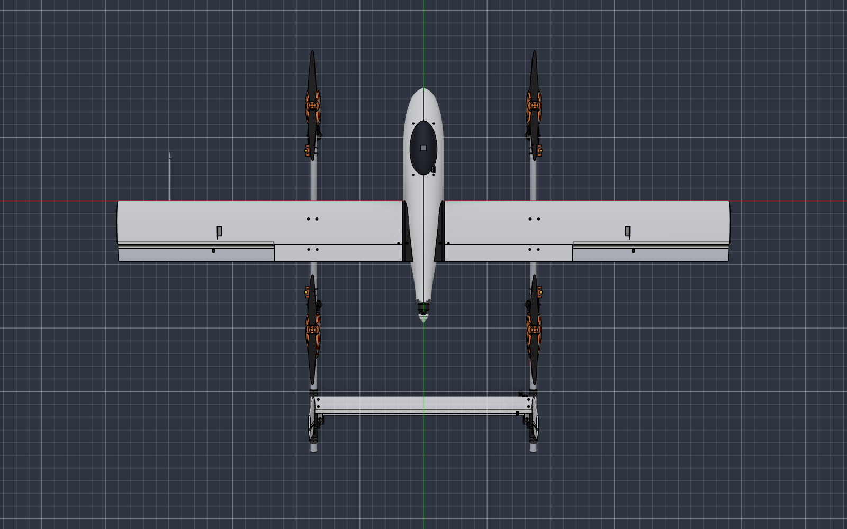
concepts/variants/a3/fusion/view_top.png
