davinciucberkeley-collab/DBF-VTOL/fusion/joints_aileron_max.png

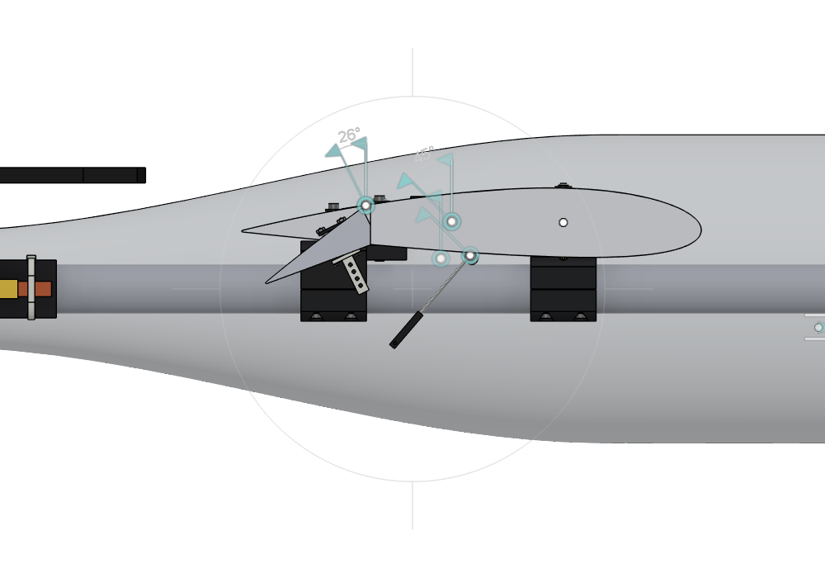
fusion/joints_aileron_max.png
