davinciucberkeley-collab/DBF-VTOL/inventory/DBF-Inventory-sheet.csv

Design-Build-Fly inventory (DBF-INV-001) | Owner: Tristan Hottier, Inventory Czar. Rows generated 2026-10-19 from C0_BOM.csv (prices checked 2026-10-13) and cad/params.txt. Edit Qty ordered, Qty on hand, Status, Location, dates, Inspected, Actual USD, Notes.
Inputs |  | Kit name | Kit | Lines | Still to get | Plan goods USD
Budget cap (DESIGN-BASIS.md R6) | 2000 | Wing | K1 | =COUNTIFS($D$16:$D$1000,D3) | =COUNTIFS($D$16:$D$1000,D3,$I$16:$I$1000,">0") | =SUMIFS($M$16:$M$1000,$D$16:$D$1000,D3,$C$16:$C$1000,"Buy")
Tax rate (C0_BOM.csv, CDTFA 2026-10-01) | 0.1025 | Booms & lift | K2 | =COUNTIFS($D$16:$D$1000,D4) | =COUNTIFS($D$16:$D$1000,D4,$I$16:$I$1000,">0") | =SUMIFS($M$16:$M$1000,$D$16:$D$1000,D4,$C$16:$C$1000,"Buy")
Shipping allowance (estimate) | 100 | Tail | K3 | =COUNTIFS($D$16:$D$1000,D5) | =COUNTIFS($D$16:$D$1000,D5,$I$16:$I$1000,">0") | =SUMIFS($M$16:$M$1000,$D$16:$D$1000,D5,$C$16:$C$1000,"Buy")
Goods subtotal | =SUMIFS($M$16:$M$1000,$C$16:$C$1000,"Buy") | Pod, avionics & pusher | K4 | =COUNTIFS($D$16:$D$1000,D6) | =COUNTIFS($D$16:$D$1000,D6,$I$16:$I$1000,">0") | =SUMIFS($M$16:$M$1000,$D$16:$D$1000,D6,$C$16:$C$1000,"Buy")
Tax | =B6*B4 | Landing gear | K5 | =COUNTIFS($D$16:$D$1000,D7) | =COUNTIFS($D$16:$D$1000,D7,$I$16:$I$1000,">0") | =SUMIFS($M$16:$M$1000,$D$16:$D$1000,D7,$C$16:$C$1000,"Buy")
Committed spend | =B6+B7+B5 | Ground support & test | K6 | =COUNTIFS($D$16:$D$1000,D8) | =COUNTIFS($D$16:$D$1000,D8,$I$16:$I$1000,">0") | =SUMIFS($M$16:$M$1000,$D$16:$D$1000,D8,$C$16:$C$1000,"Buy")
Crash reserve | =B3-B8 | Raw stock & consumables | K7 | =COUNTIFS($D$16:$D$1000,D9) | =COUNTIFS($D$16:$D$1000,D9,$I$16:$I$1000,">0") | =SUMIFS($M$16:$M$1000,$D$16:$D$1000,D9,$C$16:$C$1000,"Buy")
Spent so far (Actual USD) | =SUM($N$16:$N$1000)
NWA swap: retail props on hold, with tax | =SUMIFS($M$16:$M$1000,$J$16:$J$1000,"Hold*")*(1+B4)
Reserve if NWA props confirmed (EST: free, no shipping) | =B9+B11
Proposed additions with tax (not committed) | =SUMIFS($M$16:$M$1000,$C$16:$C$1000,"Proposed")*(1+B4)
Reserve after proposed additions (EST) | =B9-B13
ID | Item | Type | Kit | CAD part | Qty needed | Qty ordered | Qty on hand | Qty still to get | Status | Vendor | Unit USD | Ext USD | Actual USD | Made from | Process | Location | Order date | Received date | Inspected | Notes
P-01 | Polymaker PA6-CF20 500 g (motor mounts: HDT 173 °C) | Buy | K7 |  | 1 | 0 | 0 | =MAX(0,F16-H16-N(G16)) | To order | — | 39.99 | =F16*L16 |  |  |  | — |  |  |  | PETG too close to motor heat (sec. 12)
P-02 | Hot-wire bow, nichrome + bench supply (wing cores) | Buy | K7 |  | 1 | 0 | 0 | =MAX(0,F17-H17-N(G17)) | To order | — | 40 | =F17*L17 |  |  |  | — |  |  |  | not priced; borrow if a makerspace has one
P-03 | Scotch heavy-duty packing tape, 6 rolls (skin) | Buy | K7 |  | 1 | 0 | 0 | =MAX(0,F18-H18-N(G18)) | To order | Amazon | 19.98 | =F18*L18 |  |  |  | —
P-04 | Hardware kit: XT90S, wire, extensions, screws, inserts, horns, pushrods, hinge tape, heat shrink, UBEC, epoxy | Buy | K7 |  | 1 | 0 | 0 | =MAX(0,F19-H19-N(G19)) | To order | Amazon | 124.01 | =F19*L19 |  |  |  | —
P-05 | ELEGOO PETG 1 kg (clamps, pod frames, gear clamps) | Buy | K7 |  | 2 | 0 | 0 | =MAX(0,F20-H20-N(G20)) | To order | Amazon | 12.99 | =F20*L20 |  |  |  | —
P-06 | BNTECHGO 12 AWG silicone wire, 2nd pack (ESC feeds) | Buy | K7 |  | 1 | 0 | 0 | =MAX(0,F21-H21-N(G21)) | To order | Amazon | 14.98 | =F21*L21 |  |  |  | —
P-07 | 14 AWG silicone wire (pusher / BEC feeds) | Buy | K7 |  | 1 | 0 | 0 | =MAX(0,F22-H22-N(G22)) | To order | Amazon | 9.99 | =F22*L22 |  |  |  | —
P-08 | XT60H connectors 12 pairs (boom harness disconnects) | Buy | K7 |  | 1 | 0 | 0 | =MAX(0,F23-H23-N(G23)) | To order | Amazon | 6.99 | =F23*L23 |  |  |  | —
P-09 | 300 mm servo extension leads, 2nd pack | Buy | K7 |  | 1 | 0 | 0 | =MAX(0,F24-H24-N(G24)) | To order | Amazon | 6.99 | =F24*L24 |  |  |  | —
P-10 | Foam-safe glue 4 oz | Buy | K7 |  | 1 | 0 | 0 | =MAX(0,F25-H25-N(G25)) | To order | Amazon | 12.99 | =F25*L25 |  |  |  | —
P-11 | ShareGoo LiPo battery straps (10) | Buy | K7 |  | 1 | 0 | 0 | =MAX(0,F26-H26-N(G26)) | To order | Amazon | 7.99 | =F26*L26 |  |  |  | —
P-12 | Ovonic 6S 6500 100C — 2-pack listing (2 packs) | Buy | K4 | Battery_6S_LiPo | 1 | 0 | 0 | =MAX(0,F27-H27-N(G27)) | To order | Amazon | 138.99 | =F27*L27 |  |  |  | — |  |  |  | second pack per R7; EC5 leads: re-terminate to XT90S
P-13 | HTRC C150 charger (150 W, ~6 A on 6S) | Buy | K6 |  | 1 | 0 | 0 | =MAX(0,F28-H28-N(G28)) | To order | Amazon | 56.99 | =F28*L28 |  |  |  | —
P-14 | JeeFly 1755 carbon prop (pair) | Buy | K2 | Lift_Prop | 2 | 0 | 0 | =MAX(0,F29-H29-N(G29)) | Hold: NWA swap pending | Amazon | 18.6 | =F29*L29 |  |  |  | — |  |  |  | $4.99 delivery, likely CN; Retail fallback if the Nautical Wings carbon props are not confirmed
P-15 | SoloGood 45A ESC (4-pack) | Buy | K2 |  | 2 | 0 | 0 | =MAX(0,F30-H30-N(G30)) | To order | Amazon | 39.99 | =F30*L30 |  |  |  | — |  |  |  | 4 lift + pusher + 3 spare; low stock: fallback LANRC 35A
P-16 | JeeFly 1755 spare pair (amazon.com) | Buy | K2 |  | 1 | 0 | 0 | =MAX(0,F31-H31-N(G31)) | Hold: NWA swap pending | Amazon | 18.6 | =F31*L31 |  |  |  | — |  |  |  | Retail fallback if the Nautical Wings carbon props are not confirmed
P-17 | Du-Bro 230 pushrod 5-pack (spares) | Buy | K7 |  | 1 | 0 | 0 | =MAX(0,F32-H32-N(G32)) | To order | Amazon | 12.48 | =F32*L32 |  |  |  | —
P-18 | Tenergy LiPo bag | Buy | K6 |  | 1 | 0 | 0 | =MAX(0,F33-H33-N(G33)) | To order | Amazon | 8.99 | =F33*L33 |  |  |  | —
P-19 | Watt meter 150 A / 60 V | Buy | K6 |  | 1 | 0 | 0 | =MAX(0,F34-H34-N(G34)) | To order | Amazon | 12.99 | =F34*L34 |  |  |  | —
P-20 | IR thermometer | Buy | K6 |  | 1 | 0 | 0 | =MAX(0,F35-H35-N(G35)) | To order | Amazon | 8.98 | =F35*L35 |  |  |  | —
P-21 | 20 kg load cell + HX711 kit (thrust stand) | Buy | K6 |  | 1 | 0 | 0 | =MAX(0,F36-H36-N(G36)) | To order | Amazon | 8.98 | =F36*L36 |  |  |  | —
P-22 | Arduino Nano clone (thrust stand) | Buy | K6 |  | 1 | 0 | 0 | =MAX(0,F37-H37-N(G37)) | To order | Amazon | 8.99 | =F37*L37 |  |  |  | —
P-23 | APC 14x8.5EP pusher prop | Buy | K4 | Pusher_Prop_14in | 3 | 0 | 0 | =MAX(0,F38-H38-N(G38)) | Hold: NWA swap pending | APC Propellers | 6.79 | =F38*L38 |  |  |  | — |  |  |  | Retail fallback if the Nautical Wings carbon props are not confirmed
P-24 | EMAX ES3005HV servo | Buy | K1 |  | 5 | 0 | 0 | =MAX(0,F39-H39-N(G39)) | To order | EMAX USA | 19.99 | =F39*L39 |  |  |  | — |  |  |  | 2 ailerons, elevator, 2 rudders
P-25 | EMAX ES3005HV spare servo | Buy | K1 |  | 1 | 0 | 0 | =MAX(0,F40-H40-N(G40)) | To order | EMAX USA | 19.99 | =F40*L40 |  |  |  | —
P-26 | Harbor Freight 0.50 cal ammo can (pack storage) | Buy | K6 |  | 1 | 0 | 0 | =MAX(0,F41-H41-N(G41)) | To order | Harbor Freight | 19.99 | =F41*L41 |  |  |  | —
P-27 | Holybro MS5525DSO + PT40 airspeed | Buy | K4 | Pitot_Tube | 1 | 0 | 0 | =MAX(0,F42-H42-N(G42)) | To order | Holybro (ships CN) | 59.99 | =F42*L42 |  |  |  | — |  |  |  | ships CN
P-28 | FOAMULAR NGX F-250 2 in x 4 x 8 ft (wing cores) | Buy | K7 |  | 1 | 0 | 0 | =MAX(0,F43-H43-N(G43)) | To order | Home Depot | 59.97 | =F43*L43 |  |  |  | —
P-29 | FOAMULAR 150 1 in x 4 x 8 ft (tail, pod) | Buy | K7 |  | 1 | 0 | 0 | =MAX(0,F44-H44-N(G44)) | To order | Home Depot | 30.97 | =F44*L44 |  |  |  | —
P-30 | 6061-T6 tube 1.000 x 0.035 in x 72 in (booms) | Buy | K7 |  | 2 | 0 | 0 | =MAX(0,F45-H45-N(G45)) | To order | OnlineMetals | 26.2 | =F45*L45 |  |  |  | — |  |  |  | cut list 0.955 + 0.516 + 0.955 + 0.516 m
P-31 | 6061-T6 tube 1.000 x 0.058 in x 96 in (spar sockets + gear legs) | Buy | K7 |  | 1 | 0 | 0 | =MAX(0,F46-H46-N(G46)) | To order | OnlineMetals | 53.97 | =F46*L46 |  |  |  | — |  |  |  | 2 x 0.8 m sockets + 4 x 0.205 m legs + kerf
P-32 | 6061-T6 tube 0.875 x 0.058 in x 36 in (joiner) | Buy | K7 |  | 1 | 0 | 0 | =MAX(0,F47-H47-N(G47)) | To order | OnlineMetals | 18.45 | =F47*L47 |  |  |  | — |  |  |  | 0.76 m joiner, 0.30 m engagement per side; 0.23 mm clearance
P-33 | HGLRC M100-5883 GPS + compass | Buy | K4 |  | 1 | 0 | 0 | =MAX(0,F48-H48-N(G48)) | To order | RaceDayQuads | 20.49 | =F48*L48 |  |  |  | —
P-34 | NewBeeDrone BeeID v1.1 Remote ID (FAA DoC RID000001995) | Buy | K4 |  | 1 | 0 | 0 | =MAX(0,F49-H49-N(G49)) | To order | RaceDayQuads | 36.99 | =F49*L49 |  |  |  | —
P-35 | RadioMaster Pocket Crush ELRS | Buy | K6 |  | 1 | 0 | 0 | =MAX(0,F50-H50-N(G50)) | To order | RadioMaster | 64.99 | =F50*L50 |  |  |  | —
P-36 | RadioMaster RP3 V2 ELRS receiver | Buy | K4 |  | 1 | 0 | 0 | =MAX(0,F51-H51-N(G51)) | To order | RadioMaster | 19.99 | =F51*L51 |  |  |  | —
P-37 | CoreWing F405 Wing APP V2 (12 out, 90 A sensor) | Buy | K4 |  | 1 | 0 | 0 | =MAX(0,F52-H52-N(G52)) | To order | ReadyMadeRC | 67.26 | =F52*L52 |  |  |  | — |  |  |  | ArduPilot target beta-only (4.7.2-beta); fallback Matek F405-WMO $69.99
P-38 | SunnySky X4110S 400KV (pusher) | Buy | K4 | Pusher_Motor | 1 | 0 | 0 | =MAX(0,F53-H53-N(G53)) | To order | SunnySky USA | 46.99 | =F53*L53 |  |  |  | — |  |  |  | same motor as lift: one spare covers both
P-39 | SunnySky X4110S 400KV | Buy | K2 | Lift_Motor | 4 | 0 | 0 | =MAX(0,F54-H54-N(G54)) | To order | SunnySky USA | 46.99 | =F54*L54 |  |  |  | —
P-40 | X4110S spare motor (lift or pusher) | Buy | K4 |  | 1 | 0 | 0 | =MAX(0,F55-H55-N(G55)) | To order | SunnySky USA | 46.99 | =F55*L55 |  |  |  | —
M-01 | Left wing panel, NACA 2415 (EST), XPS core + tape skin, chord 239 mm | Make | K1 | Wing_Panel_L | 1 |  | 0 | =MAX(0,F56-H56-N(G56)) | To make | In-house | 0 | =F56*L56 |  | P-28 | Hot-wire XPS core, packing-tape skin | —
M-02 | Right wing panel, NACA 2415 (EST), XPS core + tape skin, chord 239 mm | Make | K1 | Wing_Panel_R | 1 |  | 0 | =MAX(0,F57-H57-N(G57)) | To make | In-house | 0 | =F57*L57 |  | P-28 | Hot-wire XPS core, packing-tape skin | —
M-03 | Left aileron, 26 % chord, 55 % of panel span | Make | K1 | Aileron_L | 1 |  | 0 | =MAX(0,F58-H58-N(G58)) | To make | In-house | 0 | =F58*L58 |  | P-28 | Cut from wing panel trailing edge, tape hinge | —
M-04 | Right aileron, 26 % chord, 55 % of panel span | Make | K1 | Aileron_R | 1 |  | 0 | =MAX(0,F59-H59-N(G59)) | To make | In-house | 0 | =F59*L59 |  | P-28 | Cut from wing panel trailing edge, tape hinge | —
M-05 | Wing centre-section saddle over the joiner: XPS block from the budgeted FOAMULAR sheet, taped, with printed PETG root plates (EST) | Make | K1 | Wing_Saddle | 1 |  | 0 | =MAX(0,F60-H60-N(G60)) | To make | In-house | 0 | =F60*L60 |  | P-28 | XPS block, taped; printed PETG root plates; bore for joiner | —
M-06 | 6061-T6 1.000 x 0.058 in spar socket, 0.8 m | Make | K1 | Spar_Tube | 2 |  | 0 | =MAX(0,F61-H61-N(G61)) | To make | In-house | 0 | =F61*L61 |  | P-31 | Cut 0.8 m from 96 in tube | —
M-07 | 6061-T6 0.875 x 0.058 in joiner, 0.76 m | Make | K1 | Wing_Joiner | 1 |  | 0 | =MAX(0,F62-H62-N(G62)) | To make | In-house | 0 | =F62*L62 |  | P-32 | Cut 0.76 m from 36 in tube | —
M-08 | M5 x 30 stainless button screw into a captive nut in the saddle (hardware kit, budget-airframe.md §3a item 5) | Make | K1 | Wing_Bolt | 2 |  | 0 | =MAX(0,F63-H63-N(G63)) | To make | In-house | 0 | =F63*L63 |  | P-04 | M5 x 30 from hardware kit, captive nut in saddle | —
M-09 | Front boom, 6061-T6 1.000 x 0.035 in | Make | K2 | Boom_Front | 2 |  | 0 | =MAX(0,F64-H64-N(G64)) | To make | In-house | 0 | =F64*L64 |  | P-30 | Cut 0.955 m from 72 in tube | —
M-10 | Rear boom stub carrying the tail, 6061-T6 | Make | K2 | Boom_Rear_Stub | 2 |  | 0 | =MAX(0,F65-H65-N(G65)) | To make | In-house | 0 | =F65*L65 |  | P-30 | Cut 0.516 m from 72 in tube | —
M-11 | Printed PETG boom-to-wing clamp at the spar; top meets the wing lower surface | Make | K2 | Boom_Clamp_Front | 2 |  | 0 | =MAX(0,F66-H66-N(G66)) | To make | In-house | 0 | =F66*L66 |  | P-05 | 3D print, PETG | —
M-12 | Printed PETG boom-to-wing clamp at 80 % chord; top meets the wing lower surface | Make | K2 | Boom_Clamp_Rear | 2 |  | 0 | =MAX(0,F67-H67-N(G67)) | To make | In-house | 0 | =F67*L67 |  | P-05 | 3D print, PETG | —
M-13 | Printed PA6-CF motor mount on boom, covers the boom splice at the rear station (EST) | Make | K2 | Motor_Mount | 4 |  | 0 | =MAX(0,F68-H68-N(G68)) | To make | In-house | 0 | =F68*L68 |  | P-01 | 3D print, PA6-CF (motor heat) | —
M-14 | Horizontal stabiliser, NACA 0009 (EST), area from V_h = 0.35 | Make | K3 | H_Tail | 1 |  | 0 | =MAX(0,F69-H69-N(G69)) | To make | In-house | 0 | =F69*L69 |  | P-29 | Hot-wire or sand XPS, tape skin | —
M-15 | Elevator, 30 % chord, NACA 0009 | Make | K3 | Elevator | 1 |  | 0 | =MAX(0,F70-H70-N(G70)) | To make | In-house | 0 | =F70*L70 |  | P-29 | Cut XPS, tape hinge | —
M-16 | Vertical fin, NACA 0009, lofted taper 65 % tip chord | Make | K3 | Fin | 2 |  | 0 | =MAX(0,F71-H71-N(G71)) | To make | In-house | 0 | =F71*L71 |  | P-29 | Cut XPS, tape skin | —
M-17 | Fuselage pod, 0.85 m x 0.16 m, foam + PETG frames + tape (EST) | Make | K4 | Fuselage_Pod | 1 |  | 0 | =MAX(0,F72-H72-N(G72)) | To make | In-house | 0 | =F72*L72 |  | P-29 | XPS shell on printed PETG frames, taped | —
M-18 | Avionics hatch blister (EST) | Make | K4 | Canopy | 1 |  | 0 | =MAX(0,F73-H73-N(G73)) | To make | In-house | 0 | =F73*L73 |  | P-05 | 3D print or foam blister (EST) | —
M-19 | Pusher spinner 42 mm (EST) | Make | K4 | Spinner | 1 |  | 0 | =MAX(0,F74-H74-N(G74)) | To source | — | 0 | =F74*L74 |  | — | Not in the BOM: buy or print (—) | —
M-20 | Gear leg: 6061 1.000 x 0.058 in offcut + printed TPU/PETG foot (EST) | Make | K5 | Landing_Leg | 4 |  | 0 | =MAX(0,F75-H75-N(G75)) | To make | In-house | 0 | =F75*L75 |  | P-31 | Cut 0.205 m from socket-tube offcut; printed TPU/PETG foot | —
M-21 | Printed PETG gear socket clamp under the boom | Make | K5 | Gear_Clamp | 4 |  | 0 | =MAX(0,F76-H76-N(G76)) | To make | In-house | 0 | =F76*L76 |  | P-05 | 3D print, PETG | —
N-01 | Carbon lift prop 17 in (design on demand, 2 CW + 2 CCW + 2 spare) | NWA | K2 | Lift_Prop | 6 | 0 | 0 | =MAX(0,F77-H77-N(G77)) | Proposed: NWA sponsor offer (verbal) | Nautical Wings Aerospace | 0 | =F77*L77 |  |  | Send spec sheet; designer proposes pitch | — |  |  |  | NWA founders offered to sponsor the team (met in person; team-reported, Oct 2026). Sponsorship rules not yet confirmed in writing. Replaces JeeFly 1755 x 6 if confirmed. Fit to X4110S bolt-on adapter (4 mm shaft); hover point 15.2 N per rotor
N-02 | Carbon pusher prop 14 in (design on demand) | NWA | K4 | Pusher_Prop_14in | 2 | 0 | 0 | =MAX(0,F78-H78-N(G78)) | Proposed: NWA sponsor offer (verbal) | Nautical Wings Aerospace | 0 | =F78*L78 |  |  | Send spec sheet; APC 14x8.5EP is the baseline | — |  |  |  | NWA founders offered to sponsor the team (met in person; team-reported, Oct 2026). Sponsorship rules not yet confirmed in writing. Replaces APC 14x8.5EP x 3 if confirmed; keep one APC as thrust-stand baseline (team call)
G-01 | Du-Bro Super Lite 3.00 in wheel pair (SKU 300SL, 16.8 g/wheel, 5/32 in axle) | Proposed | K5 | Landing_Leg | 2 | 0 | 0 | =MAX(0,F79-H79-N(G79)) | Proposed: wheeled gear | Gator RC | 6.75 | =F79*L79 |  |  |  | — |  |  |  | Landing gear on the four existing legs (2 pairs = 4 wheels); raises ground plane 0.048 m EST (wheel radius 0.0381 m + 10 mm axle offset EST), pusher disc clearance 36 to 84 mm. Gator RC page read 2026-10-19: $6.75 per pair, 'Only 1 left' for the product, so one pair must come from another vendor; re-quote before ordering.
G-02 | Du-Bro axle shaft 2-pack, 5/32 in x 2 in (DUB248), with 2 nylon-insert nuts | Proposed | K5 | Landing_Leg | 2 | 0 | 0 | =MAX(0,F80-H80-N(G80)) | Proposed: wheeled gear | Gator RC | 9.05 | =F80*L80 |  |  |  | — |  |  |  | Four axles for four wheels; thread size not published (—), fit-check against leg tip.
G-03 | Du-Bro 5/32 in wheel collars 4-pack (DUB140) | Proposed | K5 | Landing_Leg | 2 | 0 | 0 | =MAX(0,F81-H81-N(G81)) | Proposed: wheeled gear | Gator RC | 2.95 | =F81*L81 |  |  |  | — |  |  |  | Wheel retention; 8 collars, 4 needed, 4 spare.
G-04 | Panasonic 470 uF 35 V low-ESR capacitor | Proposed | K2 |  | 6 | 0 | 0 | =MAX(0,F82-H82-N(G82)) | Proposed: electrical | Race Day Quads | 2.49 | =F82*L82 |  |  |  | — |  |  |  | FC battery-side cap (vendor guide) plus one per lift ESC and pusher ESC; stock, size, lead length not on page (—). Voltage 35 V from title only.
