davinciucberkeley-collab/DBF-VTOL/docs/build/print-list.csv

id | part | cad_part | qty | material | nozzle_mm | nozzle_type | nozzle_C | bed_C | fan_pct | layer_mm | walls | top_bottom_layers | infill_pct | infill_pattern | orientation | supports | cad_volume_cm3 | mass_g_est_each | print_h_est_each | inserts_I01_each | critical_features | post_process | drawing_sheet | source
P01 | Motor mount upper half (motor plate + saddle) | Motor_Mount_Upper | 4 | Polymaker Fiberon PA6-CF20 | 0.4 | hardened steel | 280-300 | 40-50 | 0 | 0.2 | 5 | 6 | 100 | rectilinear | motor plate face DOWN (floor = first layers; bore axis horizontal) | yes (bore roof) | 45.1 | 55 | 6.4 | 4 | Bore dia 25.60 (FT02); floor 4.50 +-0.15; 4 x dia 3.4 on dia 25 PCD at 45 deg to the wire slot (drill after print); counterbores dia 7.5 (rev B: washer 7.0) from the bore to the floor; centre relief dia 8 x 2.0; insert holes 4 x dia 4.0 x 7.5 at (x +-28, z +-17.5); splice cross-bolt half-grooves at x +-18 (used at the rear station) | dry 100 C / 10 h before; anneal 100 C / 16 h after; drill motor holes 3.4; 4 x I01; coupon M2/M3 first | 5 | hardware-spec.md C1 J01 J02 + CAD notes (counterbore 7.5); Fiberon PA6-CF20 TDS v1.1; cad/verification.txt
P02 | Motor mount lower cap | Motor_Mount_Cap | 4 | Polymaker Fiberon PA6-CF20 | 0.4 | hardened steel | 280-300 | 40-50 | 0 | 0.2 | 5 | 6 | 100 | rectilinear | flat face DOWN | no | 27.1 | 33 | 3.9 | 0 | Bore dia 25.60; 4 x dia 3.4 through + counterbore dia 6.5 x 5.6 (F02); splice cross-bolt half-grooves at x +-18 with dia 7.5 x 5.0 head counterbore one side and 5.7 AF x 8.0 nut pocket the other (F04/N01) | anneal with P01; drill the cross holes 3.4 through cap + boom + plug + boom + cap in one pass (WP7 7.6) | 5 | hardware-spec.md J02 J04; cad/mesh/meta.json
P03 | Pusher motor cup | Pusher_Cup | 1 | Polymaker Fiberon PA6-CF20 | 0.4 | hardened steel | 280-300 | 40-50 | 0 | 0.2 | 5 | 6 | 100 | rectilinear | floor DOWN (open end up) | no | 26.9 | 33 | 3.8 | 4 | OD 55.6 x 30 (FT11 in the dia 56 tail ring); floor 4.5 +-0.15; 4 x dia 3.4 on dia 25 PCD + counterbore dia 7.5 from inside; centre relief + wire groove; 4 bosses with radial dia 4.0 x 7.0 insert holes (F07); no vent slots (the cup sits inside the tail-ring bore; thermal.md 6.3-6.4 item 6: measure the pusher first, BUILD-MANUAL 2.7) | anneal; drill motor holes; 4 x I01 (no vent slots: BUILD-MANUAL 2.7) | 9 | hardware-spec.md J12 FT11 + CAD notes
P04 | Boom splice plug | Splice_Plug | 2 | ELEGOO PETG | 0.4 | brass | 250 | 80 | 50 | 0.2 | 4 | 5 | 60 | gyroid | axis VERTICAL | no | 33.4 | 25 | 3.3 | 0 | OD 23.20 +-0.2 (FT04); length 80; 2 x dia 3.4 cross holes at 18 mm from each end (drilled in situ) | sand OD to slide into the boom by hand | 5 | hardware-spec.md J04 FT04
P05 | Boom clamp front (upper + lower) | Boom_Clamp_F_Upper + Boom_Clamp_F_Lower | 2 sets | ELEGOO PETG | 0.4 | brass | 250 | 80 | 50 | 0.2 | 4 | 5 | 40 | gyroid | split plane DOWN for both halves | no | 12.0 + 16.0 | 25 (set) | 2.8 | 0 | Width 46; bore 25.60; split gap 1.2; upper top meets the wing lower surface at 30 % c (clampTopF 14.0) and is bonded to the spar collar; 2 x F06 M3 x 35 on a DIAGONAL (x +-12, z +-17.5 opposite corners, rev B) through both halves into the collar inserts; counterbore dia 6.5 x 4.3 in the lower | check bore on the coupon | 6 | hardware-spec.md J05a + CAD notes; cad/verification.txt
P06 | Boom clamp rear (upper + lower) | Boom_Clamp_R_Upper + Boom_Clamp_R_Lower | 2 sets | ELEGOO PETG | 0.4 | brass | 250 | 80 | 50 | 0.2 | 4 | 5 | 40 | gyroid | split plane DOWN | no | 27.2 + 15.8 | 39 (set) | 4.3 | 0 | Width 46; bore 25.60; upper top meets the lower surface at 80 % c (clampTopR 23.8) and is bonded to the rear hardpoint; 2 x F04 M3 x 40 on a diagonal; counterbore dia 6.5 x 7.5 in the lower | — | 6 | hardware-spec.md J05b + CAD notes
P07 | Gear clamp (upper + lower) | Gear_Clamp_Upper + Gear_Clamp_Lower | 4 sets | ELEGOO PETG | 0.4 | brass | 250 | 80 | 50 | 0.2 | 4 | 5 | 40 | gyroid | split plane DOWN | no | 16.1 + 25.1 | 37 (set) | 4.1 | 4 | Width 46; bore 25.60; lower -28.7..-0.6 with the blind leg socket dia 25.70 x 14.0 (FT03); 4 x F03 M3 x 20 at (x +-12, z +-17.5), counterbore dia 6.5 x 15.3 in the lower; F05 M3 x 30 cross-bolt along x: counterbore dia 7.5 x 4.0 + nut pocket 5.7 AF x 4.3 (both clear of the leg tube, rev B) | 4 x I01 in the upper; ream the socket if tight | 6 | cad/hardware.json F05; hardware-spec.md J06 J07 + CAD notes
P08 | Tail clamp (upper + cap) | Tail_Clamp_Upper + Tail_Clamp_Cap | 2 sets | ELEGOO PETG | 0.4 | brass | 250 | 80 | 50 | 0.2 | 4 | 5 | 40 | gyroid | split plane DOWN | no | 21.4 + 19.2 | 36 (set) | 4.1 | 6 | 50 x 46; upper +0.6..+15.7 with a flat top (2.9 mm wall over the bore) carrying the stabiliser; cap -15.0..-0.6; 4 x F02 M3 x 16 counterbore dia 6.5 x 5.6; 4 inserts from the split face + 2 from the top for the fin-shoe screws (J09) | 6 x I01 | 6 | hardware-spec.md J08 J09 + CAD notes
P09 | Fin root shoe | Fin_Shoe | 2 | ELEGOO PETG | 0.4 | brass | 250 | 80 | 50 | 0.2 | 3 | 4 | 30 | gyroid | flange DOWN | no | 16.4 | 21 | 1.6 | 0 | 3 mm floor; 20 mm walls 1.6 thick around the fin root section (NACA 0009 c 159.68 + 0.4); 32 x 46 flange with 2 x dia 3.6 holes matching the tail-clamp top inserts | bond the fin in with foam-safe glue | 9 | hardware-spec.md J09 + CAD notes
P10 | Stabiliser crush sleeve | Crush_Sleeve | 4 | ELEGOO PETG | 0.4 | brass | 250 | 80 | 50 | 0.1 | 100% walls | — | 100 | — | axis VERTICAL | no | 0.3 | 0.3 | 0.2 | 0 | OD 7.0 / ID 3.4 x 9.1 long (stabiliser 9.1 thick, params tailT) | — | 9 | cad/mesh/meta.json Crush_Sleeve
P11 | Spar collar hardpoint | Spar_Collar | 2 | ELEGOO PETG | 0.4 | brass | 250 | 80 | 50 | 0.2 | 4 | 5 | 100 | — | bosses DOWN | no | 30.3 | 38 | 3.0 | 2 | 32 x 46 collar bonded around the spar socket at the boom station (353.7 mm from the panel root face); 2 x I01 facing down on the DIAGONAL beside the tube (not under it) | 2 x I01 | 9 | hardware-spec.md J05a C5 + CAD notes
P12 | Rear wing hardpoint plate | Rear_Hardpoint | 2 | ELEGOO PETG | 0.4 | brass | 250 | 80 | 50 | 0.2 | 4 | 5 | 100 | — | flat | no | 27.1 | 34 | 2.7 | 2 | 60 x 46 x 10 bonded flush into the lower surface at 80 % c (227.3 mm aft of the LE) at the boom station; 2 x I01 on the diagonal | 2 x I01 | 9 | hardware-spec.md J05b C5
P13 | Saddle root plates + side tabs | (part of Wing_Saddle) | 2 | ELEGOO PETG | 0.4 | brass | 250 | 80 | 50 | 0.2 | 3 | 4 | 30 | gyroid | flat | no | ~50 (EST: 83 cm2 section x 6 mm; 73 cm2 at chord 266.6 x (284.2/266.6)^2) | 35 | 5.0 | 0 | 284.2 mm long (params chord): flat needs a bed >= 286 mm, diagonal >= 250 x 250 mm, else print two halves with a 20 mm half-lap at 46-54 % c and bond (BUILD-MANUAL K1); profile = wing_saddle template; joiner bore dia 22.455 SLIP FIT (FT06: drill 22.6 if tight); 6 mm side tab with 2 x dia 3.4 at -0.10 c and -0.30 c for the F08 screws into the pod-rail inserts (J11) | — | 4 | hardware-spec.md CAD notes J11; cad/mesh/meta.json Wing_Saddle
P14 | Saddle bolt pillar | Bolt_Pillar | 2 | ELEGOO PETG | 0.4 | brass | 250 | 80 | 50 | 0.2 | 100% walls | — | 100 | — | axis VERTICAL | no | 3.0 | 3.7 | 0.3 | 0 | Dia 16 x 26.0 (full section at 70 % c, CAD rev D, params pillarH); tongue slot 20.4 x 6.8; hole dia 5.7; spot-face dia 10.3 x 2.0 top (params pillarSpot: M5 button head near-flush); M5 nylock pocket 8.2 AF x 9.6 from the lower surface (params pillarNutDepth) | — | 4 | cad/mesh/meta.json Bolt_Pillar; hardware-spec.md CAD notes
P15 | Panel root tongue | Root_Tongue | 2 | ELEGOO PETG | 0.4 | brass | 250 | 80 | 50 | 0.2 | 100% walls | — | 100 | — | flat | no | 6.2 | 7.9 | 0.6 | 0 | 20 x 6.4 x 50: 25 mm bonded into the panel root at 70 % c, 25 mm into the pillar slot; hole dia 5.7 | bond into the root pocket with foam-safe glue | 9 | cad/mesh/meta.json Root_Tongue
P16 | Aileron horn hardpoint | Horn_Hardpoint | 2 | ELEGOO PETG | 0.4 | brass | 250 | 80 | 50 | 0.2 | 100% walls | — | 100 | — | flat | no | 2.2 | 2.8 | 0.2 | 0 | 20 x 12 x 10 bonded flush in the aileron lower surface at 75-83 % c, 596.4 mm from the panel root; 2 x dia 2.6 holes + 4.2 AF x 2.0 nut pockets (N03, captive against the foam) | — | 9 | cad/mesh/meta.json Horn_Hardpoint; cad/params.txt zHornPanel hornHpX
P17 | Servo tray (L-bracket) | Servo_Tray | 5 | ELEGOO PETG | 0.4 | brass | 250 | 80 | 50 | 0.2 | 3 | 4 | 30 | gyroid | plate flat | no | 4.0 | 5.1 | 0.4 | 0 | Plate 50 x 28 x 3 with the ES3005HV body cutout, 4 x dia 2.6 + 4.2 AF x 2.0 nut pockets at the tab pattern (46 x 10 EST: MEASURE, M6); 15 mm foot bonded to foam. Ailerons: servo on its side in the wing pocket, arm through the lower surface; tail: foot down on the stabiliser top | do not print before M6 | 9 | cad/mesh/meta.json Servo_Tray Servo; hardware-spec.md J14 + CAD notes
P18 | FC tray | FC_Tray | 1 | ELEGOO PETG | 0.4 | brass | 250 | 80 | 50 | 0.2 | 3 | 4 | 30 | gyroid | flat | no | 9.1 | 11.6 | 0.9 | 4 | 60 x 44 x 3 with 4 insert bosses on 45 x 25 (EST: MEASURE the CoreWing pattern, M6); FC on 4 printed standoffs dia 7 x 5.0 / hole 3.4 with M3 x 12 (thermal.md 6.4 item 5; BUILD-MANUAL 8.2a); bonded to the avionics-bay floor at y -20, x +0.225 | 4 x I01 | 9 | cad/mesh/meta.json FC_Tray; hardware-spec.md J15 M6
P19 | Pitot clamp | Pitot_Clamp | 1 | ELEGOO PETG | 0.4 | brass | 250 | 80 | 50 | 0.2 | 100% walls | — | 100 | — | bore axis VERTICAL | no | 7.8 | 9.9 | 0.8 | 1 | 20 x 20 x 21.5 bonded into the left wing lower surface at x -50 (18 % c), tube centre 9.5 below the lower surface; bore = measured PT40 OD + 0.2 (6.2 EST); 1 x I01 + F07 pinch screw from below | 1 x I01 | 9 | cad/mesh/meta.json Pitot_Clamp; hardware-spec.md J16 + CAD notes
P20 | Pod frames (nose ring; 3 mid frames; 2 top rails; tail ring) | (pod internal structure EST) | 1 set | ELEGOO PETG | 0.4 | brass | 250 | 80 | 50 | 0.2 | 3 | 4 | 25 | gyroid | flat | no | ~60 (EST set) | 65 | 7.0 | 6 | Tail ring bore dia 56.0 +-0.2 (FT11) with 4 radial dia 3.4; 2 side rails at the saddle station with 2 x I01 each for the F08 side-tab screws (horizontal); 2 x I01 for the hatch flange (F07); frame OD to the pod profile (2.0 mm wall EST). The CAD pod is one solid: this is the manual's method | 6 x I01 | — | hardware-spec.md J11 J12 J13 FT11 + CAD notes (EST geometry)
P21 | Battery tray | Battery_Tray | 1 | ELEGOO PETG | 0.4 | brass | 250 | 80 | 50 | 0.2 | 3 | 4 | 25 | gyroid | flat | no | 27.3 | 35 | 2.7 | 0 | 165 x 56 x 3 with two 22 x 3 strap slots; bonded in the bay with the pack centre at x +0.189 +-0.030 (CG sweep), y -0.052 | — | — | cad/mesh/meta.json Battery_Tray; cad/params.txt battX
P22 | Canopy hatch flange + front tongue | (part of Canopy) | 1 | ELEGOO PETG | 0.4 | brass | 250 | 80 | 50 | 0.2 | 3 | 4 | 25 | gyroid | flat | no | ~8 (EST) | 9 | 1.0 | 0 | 2.0 mm rear flange with 2 x dia 3.4 holes (F07) + 2 mm front tongue under the pod skin; pockets in the pod | bond to the foam blister F08 | — | hardware-spec.md J13 + CAD notes
P23 | Dome foot | (part of Landing_Leg) | 4 | ELEGOO PETG | 0.4 | brass | 250 | 80 | 50 | 0.2 | 3 | 4 | 20 | gyroid | dome UP | no | ~6 (EST) | 6 | 0.7 | 0 | Plug dia 22.3 x 15 into the leg ID 22.454; dome dia 40; bonded with epoxy | — | 7 | cad/mesh/meta.json Landing_Leg
P24 | GPS pad + harness anchors | (not modelled) | 1 + 6 | ELEGOO PETG | 0.4 | brass | 250 | 80 | 50 | 0.2 | 2 | 3 | 20 | gyroid | flat | no | ~3 (EST) | 3 | 0.4 | 0 | GPS pad 25 x 25 x 3 on the canopy top; anchors 10 x 10 x 3 with a 4 mm zip-tie slot, bonded | — | — | hardware-spec.md J15 J19
P25 | Landing-leg fairing (teardrop) | Gear_Fairing | 4 | ELEGOO PETG | 0.4 | brass | 250 | 80 | 50 | 0.2 | 1 (vase / spiralise) | 0 top; 2 bottom | 0 | — | standing (170 mm tall; TE up or down) | no | 20.0 | 25 (29.6 EST in the spec) | 1.5 | 0 | 3:1 teardrop, NACA 0033 section, chord 81.6 x 170 long, 0.8 mm vase-mode wall; inner cavity clears the dia 25.4 leg (+0.3); slipped over the leg before the foot is bonded, TE aft, clocked against the gear clamp and taped. Required by the drag build-up (R10) | tape to the clamp; no fasteners | 7 | cad/mesh/meta.json Gear_Fairing; cad/BuildVtol.cs GearFairing; docs/research/aerodynamics.md 7
P26 | Joiner stop | Joiner_Stop | 2 | ELEGOO PETG | 0.4 | brass | 250 | 80 | 50 | 0.2 | 100% walls | — | 100 | — | flat (disc) | no | 3.9 | 5 | 0.4 | 0 | Disc dia 22.4 x 10, bonded with foam-safe/epoxy 300 mm inside each spar socket from the root face; captures the slip-fit joiner once both panels are bolted on (J11/FT06 rev B) | — | 4 | cad/mesh/meta.json Joiner_Stop; hardware-spec.md CAD notes
P27 | Hole + insert coupon (M2 first article) | — | 1 each PETG and PA6-CF | both | 0.4 | per material | per material | per material | per material | 0.2 | 4 | 5 | 100 | — | flat | no | ~12 (EST) | 14 | 1.5 | 3 | M3 clearance holes at 3.4/3.6; insert holes at 3.8/3.9/4.0/4.1; 25.4 bore rings at 25.5/25.6/25.7; 4.5 mm floor pad for the M3 crush test | measure every hole; record on traveler WP2 | — | hardware-spec.md M2 M3 FT07 FT08
P28 | Boom cross-hole drill guide | — | 1 | ELEGOO PETG | 0.4 | brass | 250 | 80 | 50 | 0.2 | 4 | 5 | 100 | — | bore axis VERTICAL | no | ~15 (EST) | 17 | 1.8 | 0 | V-block saddle for a 25.4 tube with a dia 3.4 guide 18.0 +-0.1 from a hard stop face; second guide at the leg hole distance. Used only if the caps/clamps are not yet printed | — | — | this manual WP3
P29 | Hot-wire template backing (optional) | — | 6-9 | ELEGOO PETG | 0.4 | brass | 250 | 80 | 50 | 0.2 | 3 | 4 | 20 | gyroid | flat | no | ~22 (EST each) | 24 | 2.5 | 0 | Profiles from docs/build/templates/section_coordinates.csv extruded 3 mm; the wing root is 284.2 mm long: print flat on a bed >= 286 mm, diagonally on >= 250 x 250 mm, else in two halves with a 20 mm lap joint (BUILD-MANUAL K1) | sand edges; wax | — | this manual WP4
