davinciucberkeley-collab/DBF-VTOL/docs/build/wiring.csv

id | circuit | from | to | fc_output_or_port | conductor | awg | qty_runs | length_m_est | connector | termination | max_current_A | notes | source
W01 | Battery main | Ovonic 6S 6500 pack lead | XT90-S male (re-terminated from EC5) | — | 2 x pack lead | 10 | 1 | 0.10 (pack lead) | XT90-S male on the pack | solder cup + heat shrink 2:1 | 75.7 (transition est) | Cut the EC5 off; strip 6 mm; tin; solder red to +; shrink; polarity check with a meter before the first plug-in | C0_BOM.csv (EC5 note); results.json C0.sized.I_trans; hardware-spec J19
W02 | Battery pigtail | XT90-S female | CoreWing F405 Wing V2 PDB BAT+ / BAT- pads | PDB BAT+ BAT- | 2 x 10 AWG silicone | 10 | 1 | 0.12 | XT90-S female | solder to pads; fit the included 35 V 470 uF capacitor across BAT+/BAT- | 75.7 | XT90-S is the physical disconnect (R20); plugged in last | DESIGN-BASIS R20; firmware/README.md 4.1
W03 | Lift ESC feed - pod side | PDB ESC pads (4 pairs) | XT60H female at the wing root (one per ESC) | PDB | 2 x 12 AWG silicone | 12 | 4 | 0.35 | XT60H female | solder | 27.7 per motor at 100 % (sunnyskyusa X4110S table) | Route out of the pod top beside the saddle tabs; label FR/RL/FL/RR; zip-tie to P24 anchors | budget-lift.md A3; hardware-spec J19
W04 | Lift ESC feed - wing/boom side | XT60H male | SoloGood 45A ESC input leads | — | 2 x 12 AWG silicone | 12 | 4 | 0.75 front / 0.80 rear | XT60H male | solder to the ESC input pads/leads + shrink | 27.7 | 6 x 6 mm channel in the wing lower surface from the root to the boom station (353.7 mm), then along the boom underside and up to the ESC: front ESC on the boom side or top face in the prop wash between the front gear clamp and the front wing clamp (180-240 mm from the boom tip, inside the 216 mm disc radius), rear ESC likewise between the rear wing clamp and the rear gear clamp (780-840 mm); tape over (BUILD-MANUAL 7.8; docs/research/thermal.md 6.4 item 4) | cad/params.txt zBoomPanel xFront xRear (stations calc EST)
W05 | Motor phase | SoloGood 45A ESC output pads | X4110S motor leads (3) | — | motor's own leads (length —); extend with 14 AWG if short | — (motor) | 4 x 3 | as supplied | none (direct solder) | solder + 2:1 shrink each lead | 27.7 | ESC on a 3 mm foam pad on the boom side or top face in the prop wash (BUILD-MANUAL 7.8); swap any two leads to reverse rotation after the direction test | hardware-spec J15 J19
W06 | Pusher ESC feed | PDB ESC pads (5th pair) | SoloGood 45A ESC (pusher) in the pod tail | PDB | 2 x 14 AWG silicone | 14 | 1 | 0.55 | none (soldered both ends) | solder | 33.3 at 25 V (sunnyskyusa X4110S table) | Pusher ESC inside the pod ahead of the tail ring; service loop | C0_BOM.csv 14 AWG; budget-lift A3
W07 | Pusher phase | pusher ESC | X4110S pusher motor leads | — | motor's own leads | — | 3 | as supplied | none | solder + shrink | 33.3 | Solder before the cup is fitted (J12 screws go in from inside the cup) | hardware-spec J12
S01 | Aileron L servo | FC S1 header | EMAX ES3005HV (left aileron; wing pocket at 55 % c, 556.5 mm from the panel root) | SERVO1_FUNCTION 4 (group 1 PWM) | 3-core servo lead | 22-26 (lead) | 1 | 1.0 | JR 3-pin | 300 mm extensions x 3-4 (BOM: 4 packs = 40 leads) | ~1.5 peak EST | Servo rail set to 6 V on the FC (ES3005HV has no 5 V rating). Field disconnect at the wing root | firmware/vtol_c0.param SERVO1; firmware/README.md 4.1; cad/params.txt zServoPanel xServo
S02 | Aileron R servo | FC S2 header | ES3005HV (right aileron) | SERVO2_FUNCTION 4 (group 1) | 3-core | 22-26 | 1 | 1.0 | JR 3-pin | as S01 | ~1.5 | Set SERVO2_REVERSED after the direction check (README 7) | firmware/vtol_c0.param SERVO2
S03 | Elevator servo | FC S3 header | ES3005HV (elevator; standing on the stabiliser top at z -21 mm, x -842) | SERVO3_FUNCTION 19 (group 2) | 3-core | 22-26 | 1 | 1.6 | JR 3-pin | 5 x 300 mm extensions | ~1.5 | Route: pod -> wing channel -> left boom underside -> stub -> tail clamp. Field disconnect at the left tail clamp | firmware/vtol_c0.param SERVO3; cad/params.txt comp Servo
S04 | Rudder L servo | FC S4 header | ES3005HV (left fin; on the stabiliser top at z -361 mm) | SERVO4_FUNCTION 21 (group 2) | 3-core | 22-26 | 1 | 1.6 | JR 3-pin | as S03 | ~1.5 | Same bundle as S03 along the left boom | firmware/vtol_c0.param SERVO4
S11 | Rudder R servo | FC S11 header | ES3005HV (right fin; stabiliser top at z +361 mm) | SERVO11_FUNCTION 21 (group 5; PWM-only output) | 3-core | 22-26 | 1 | 1.6 | JR 3-pin | 5 x 300 mm | ~1.5 | Along the right boom; field disconnect at the right tail clamp. S11 is PWM-only: correct for a servo | firmware/vtol_c0.param SERVO11; firmware/README.md 4.4
M01 | Motor1 DShot | FC S5 header | ESC front-right (motor CCW seen from above) | SERVO5_FUNCTION 33 (group 3 DShot150) | signal + GND | 26 | 1 | 1.0 | servo-lead 2 pins (no red wire to the rail) | solder to ESC signal/GND pads | — | ArduPilot Quad X: M1 front-right CCW. DShot150, no ESC calibration. Motor-test button A | firmware/vtol_c0.param SERVO5 Q_M_PWM_TYPE; firmware/README.md 4.1 and 7
M02 | Motor2 DShot | FC S6 header | ESC rear-left (CCW) | SERVO6_FUNCTION 34 (group 3) | signal + GND | 26 | 1 | 1.0 | — | solder | — | M2 rear-left CCW; motor-test button C | same
M03 | Motor3 DShot | FC S7 header | ESC front-left (CW) | SERVO7_FUNCTION 35 (group 3) | signal + GND | 26 | 1 | 1.0 | — | solder | — | M3 front-left CW; motor-test button D | same
M04 | Motor4 DShot | FC S8 header | ESC rear-right (CW) | SERVO8_FUNCTION 36 (group 4) | signal + GND | 26 | 1 | 1.0 | — | solder | — | M4 rear-right CW; motor-test button B. S10 (same group) must stay empty | same
M05 | Pusher DShot | FC S9 header | pusher ESC | SERVO9_FUNCTION 70 (group 4; SERVO_BLH_MASK bit 8; OTYPE 4) | signal + GND | 26 | 1 | 0.5 | — | solder | — | DShot150; stopped in Q modes; air must blow aft | firmware/vtol_c0.param SERVO9 SERVO_BLH_*; firmware/README.md 7
A01 | GPS + compass | FC GPS connector (UART5 + I2C + 4V5) | HGLRC M100-5883: GPS TX -> R5; GPS RX -> T5; SDA/SCL | SERIAL5_PROTOCOL 5 | 6-wire (4V5 GND TX RX SDA SCL) | 28 | 1 | 0.15 | FC GPS connector (pin order differs from the pads: check the board image) | supplied cable | 0.1 | Module on the printed pad P24 on the canopy top, arrow forward; 115200 UBX | firmware/README.md 4.1 4.2; ardupilot.org common-CoreWingF405WingV2 (checked 2026-10-21)
A02 | RC receiver | FC TX6 / RX6 + 5 V + GND (SERIAL6 RCIN) | RadioMaster RP3 V2: receiver TX -> RX6; receiver RX -> TX6 | SERIAL6_PROTOCOL 23 (CRSF) | 4-wire | 28 | 1 | 0.15 | supplied CRSF wire | solder/plug | 0.1 | Antennas 90 deg apart taped inside the canopy; receiver failsafe = no pulses | firmware/vtol_c0.param SERIAL6_PROTOCOL RC_OPTIONS; firmware/README.md 4.1 and 8
A03 | Remote ID | FC 5 V pad (5.2 V / 4 A BEC) + GND | NewBeeDrone BeeID v1.1: 5V and GND only (TX/RX NOT connected) | — | 2-wire | 28 | 1 | 0.15 | — | solder | 0.1 | Broadcast module only; nav GPS stays the HGLRC. Not the 4V5 USB rail. Foam tape on the canopy, clear of the GPS | firmware/README.md 4.1; budget-avionics 4.2
A04 | Airspeed sensor | FC I2C airspeed connector (SDA SCL 5V GND) | Holybro MS5525DSO board INSIDE the pod near the FC - CSB pin re-strapped to GND (I2C 0x77) BEFORE first power-up | ARSPD_TYPE 5 (MS5525 at 0x77); ARSPD_BUS 0 | 4-wire | 28 | 1 | 0.15 | supplied | plug | 0.05 | Ships at 0x76 = the board baro address on the same (only) I2C bus. Bench check: Messages shows 'MS5525[0]: Found on bus 0 addr 0x77' and the baro still reads altitude. Fallback: MS4525DO sensor-only + PT40 (ARSPD_TYPE 1) | firmware/README.md 4.3; firmware/vtol_c0.param ARSPD_TYPE; firmware/peripherals.md 4; docs/research/firmware.md 4 R8
A05 | Pitot pneumatic lines | MS5525 board ports | PT40 pitot under the left wing (x -50 mm = 18 % c, tube centre 9.5 mm below the lower surface, z -1.0 m) | — | 2 x silicone tube (kit; length —) | — | 2 | 1.25 each | push-on | none | — | Run in the wing channel beside S01; field disconnect at the root (2 tubes). If the kit tubing is short see Gaps G3 | cad/params.txt pitotX pitotY pitotZ; hardware-spec J16 + CAD notes
A06 | Servo rail power | FC servo BEC (5 / 6 / 7.2 V select) | servo rail S1-S11 | — | on-board | — | — | — | — | — | 8 cont / 14 peak (board) | Select 6 V. Five ES3005HV at ~1.5 A peak each EST < 8 A. Never connect an ESC BEC red wire to the rail | ardupilot.org common-CoreWingF405WingV2 (checked 2026-10-21); firmware/README.md 4.1
A07 | UBEC 5 V 5 A (kit item 12) | not installed on the aircraft | — | — | — | — | — | — | — | — | — | Spare; the FC supplies 5.2 V 4 A and the servo rail. Use on the thrust stand to power the Nano if needed | budget-airframe 3a item 12; budget-avionics 1.2
A08 | Bench GCS link | CoreWing BLE/WiFi module on the USB extender connector | laptop (Mission Planner) | SERIAL1_PROTOCOL 2 (MAVLink2 115200) | module | — | — | — | — | — | — | Bench and field laptop link; a SiK radio on TELEM2/4 (SERIAL4) is reserved, not bought | firmware/README.md 4.1 4.2
