davinciucberkeley-collab/DBF-VTOL/docs/test/test-matrix.csv

ID | Series | Title | Requirements | Method | Predicted (source) | Pass criterion | Prerequisites | Planned date | Crew | Duration | Status
C01 | C | Printed hole and bore coupon (first article; adds 22.46 joiner bore) | R2 | I | holes 0.2-0.4 mm undersize EST (Xometry FDM tol via hardware-spec 5b) | model value found that prints 3.4 / 4.0 / 22.46 / 25.6 +-0.1 mm in PETG and PA6-CF | Order B | 2026-12-15 | 1 | 3.5 h | open
C02 | C | Heat-set insert torque-out PETG and PA6-CF | R9 | T | - (not published) | every insert >= 1.0 N.m (hardware-spec M3) | C01 | 2026-12-16 | 1 | 1 h | open
C03 | C | Heat-set insert pull-out PETG and PA6-CF | R9 | T | - (not published) | min >= 300 N PETG and >= 400 N PA6-CF (EST = 10 x Tmax 30.7 N results.json struct.Tmax) | C02 | 2026-12-16 | 2 | 1 h | open
C04 | C | Motor-floor crush and 24 h relaxation PA6-CF (Ø7.5 counterbore) | R9 | T | - (not published) | re-torque angle <= 30 deg after 24 h at 0.6 N.m (hardware-spec M3); washer seats flat in Ø7.5 | C01 | 2026-12-17 | 1 | 0.5 h + 24 h | open
C05 | C | Tube receipt measurement and joiner fit | R9 | I | nominal clearance 0.23 mm (cad/README.md) | OD +-0.102 mm; wall +-0.051 mm; joiner enters by hand; play <= 5 mm at 1.2 m (budget-airframe M4) | Order B | 2026-12-15 | 1 | 1 h | open
C06 | C | Thrust-stand build and calibration (review T1; 2 % of reading) | R13 | T | HX711 resolution << 1 g; linearity set by stand EST | error <= 2 % of reading 0.5-5 kg; hysteresis <= 1 %; drift <= 20 g / 10 min | Order A | 2026-11-16 | 2 | 5 h | open
C07 | C | Lift motor thrust curve every motor (review T2; R13 strict) | R13;R10 | T | 1500 g/8.1 A/180 W; 3130 g/27.7 A/615 W at 22.2 V (budget-lift A3); hover 1638 g at 229 W FMeta 0.516 (results.json sized v0.4, 11.75 m/s stall target 2026-10-25); hover throttle ~0.52 | max >= 2.62 kgf at 22.2 V (1.6 x 6.55 / 4); P_elec at 1638 g <= 300 W; spread <= 5 %; Imax <= 36 A | C06 | 2026-11-18 | 2 | 4 h | open
C08 | C | Hover-duty heat (review T3 expanded) | R9;R10 | T | can +39 K / ESC +28 K over ambient at 90 s EST (74 / 63 degC on a 35 degC day; docs/research/thermal.md 6.1, 45.8 W = 20 % of 229 W); lumped 76 degC; steady 143.9 degC (cad/sim/results.txt) | can <= 80 degC EST after 90 s; ESC <= 70 degC EST; no cut-out; time constant >= 100 s (review 12 M2) | C07 | 2026-11-20 | 2 | 2 h | open
C09 | C | Pusher thrust curve X4110S + APC 14x8.5EP (review T4 expanded) | R11 | T | - (no vendor table); cruise thrust 0.88 kgf sizing / 0.79 kgf aero at 20 m/s (results.json D_cruise; aero_results drag.cruise.D_N); C0 SITL model ~890 W at 100 % on a full pack (EST) | static >= 1.5 kgf at 60 %; peak <= 40 A (review 5 M3); runout < 1 mm; bench M1: power at THR_MAX 85 on a full pack <= 615 W | C06 | 2026-11-21 | 2 | 1 h | open
C10 | C | Stopped-prop behaviour and drag (review T5 + 4 M3; aero M3) | R10 | T | 0.54 N per stopped unit at 20 m/s (calc aero_results CdA_per_rotor_unit 0.00222) | no windmilling; stop <= 30 deg off flow; drag <= 0.8 N EST per unit | C07 | 2026-11-28 | 3 | 1 h | open
C11 | C | Battery capacity sag and internal resistance | R10;R13 | T | 144.3 Wh nameplate; 21.0 V loaded at hover (vtol_c0.param); mission 102.0 Wh from pack lands at 29 % (calc); pack +3.9 K per mOhm/cell over a mission (thermal.md 5) | delivered >= 110 Wh to 3.5 V/cell at 15 A (calc 0.8x144.3x0.95); >= 3.4 V/cell at 41 A; >= 3.2 V/cell at 76 A; <= 7.3 mOhm/cell EST; > 5 mOhm/cell = hot-day no-go (thermal.md 6.4); packs within 3 % | C06 | 2026-11-23 | 2 | 4 h | open
C12 | C | Servo torque speed and centering (ES3005HV x5; no spare in BOM) | R9 | T | 8 kg.cm at 6.0 V (budget-avionics 6) | stall >= 6.4 kg.cm at 6.0 V EST; centring <= 1 deg; five within 10 % | Order B | 2027-01-06 | 1 | 1.5 h | open
C13 | C | Harness connector and ESC heating | R9 | T | 10.3 A per lift ESC hover; 41.2 A / 75.7 A pack (results.json v0.4); lift ESC 56 degC after 60 s hover on a 35 degC day (thermal.md 6.1) | connectors and wire <= 60 degC EST; ESC <= 70 degC EST; no discolouration | G03 | 2027-03-01 | 2 | in G03 | open
C14 | C | Tape-skin mass sample (review 6 M4) | R2;R10 | T | wGlass 0.06 kg/m2 (results.json base) | <= 0.1 kg/m2 per side | Order B | 2026-12-18 | 1 | 0.5 h | open
C15 | C | Prop and hub inspection | R9 | I | - | screw engagement 4.5-8.0 mm (hardware-spec M5); balanced; runout < 1 mm | Order A | 2026-11-17 | 1 | 1 h | open
C16 | C | Gear-clamp F05 M3x30 and motor counterbore Ø7.5 first-article fit (new rev B) | R9 | I;T | cad/verification.txt F05 box 33.0 mm; 0 cut warnings | F05 nut/head clear leg tube >= 0.5 mm; nylock >= 2 threads; Ø7.0 washers seat flat in Ø7.5; motor screw tip <= 3.2 mm (hardware-spec M4) | C01 | 2026-12-18 | 1 | 1 h | open
C17 | C | Joiner slip fit and joiner-stop retention (new rev B) | R4;R9 | T | FT06 band -0.072..+0.532 mm; engagement 0.30 m (results.json struct.engage) | joiner in/out by hand <= 5 kg push EST; stops hold 98 N; no wear after 10 cycles; pod piece <= 0.5 m with joiner out | C05;saddle+panels built | 2027-02-10 | 2 | 1 h | open
S01 | S | Wing static proof load 3.0 g limit | R9;R2 | T | spar tip 15.5 mm at 3 g (FEA 23.2 mm at 4.5 g x 3/4.5, CAD rev D); real 15-60 mm EST; joiner 105 MPa RF 2.62 | tip <= 120 mm; residual <= 2 mm EST; joiner straight <= 0.5 mm; no crush; stop discs intact; 30 s hold | C05;C17;wing built | 2027-02-19 | 3 | 2 h | open
S02 | S | Boom static stiffness (review 12 M1) | R9 | T | 2.84 mm hand (results.json struct.defl_max) / 2.70 mm FEA at 30.7 N, Lb 0.462 m | deflection at 30.7 N <= 4.0 mm (1.5 x FEA); residual 0; no slip | booms built | 2027-01-25 | 2 | 1 h | open
S03 | S | Boom modal tap test (review 6 M2) | R9 | T | 32.3 Hz hand (results.json struct.fn v0.4) / 34.4 Hz FEA (CAD rev D) | 26-41 Hz both planes; not within +-15 % of hover rotor frequency or 2x | S02 | 2027-02-20 | 2 | 1 h | open
S04 | S | Boom clamp and splice slip proof (hardware-spec M7; review 6 M5) | R9 | T | clamp capacity ~16 N.m EST; Mclamp 14.2 N.m | 4.9 N.m torsion: witness unmoved; 46 N bending: rotation <= 1 deg; no crack | C02;booms built | 2027-01-26 | 2 | 1 h | open
S05 | S | Motor-mount pull and insert test on real parts (rev B split mount) | R9 | T | Tmax 30.7 N | 2 x Tmax = 61 N for 60 s: no crack no insert movement; re-torque <= 30 deg | C02;C03;C16;mounts printed | 2027-01-20 | 2 | 0.5 h | open
S06 | S | Landing-gear drop test 0.3 m with leg fairings (review 6 M3) | R9 | T | 2.43 m/s; 8-32 g bare legs (results.json strokes) - expected to fail without feet | peak <= 8 g; no crack or set in legs; fairings undamaged; ballast unmoved | S01;S10;gear built | 2027-02-23 | 2 | 1 h | open
S07 | S | Hinge moment and joiner/spar post-test inspection | R9 | T;I | - (hinge moment not computed) | hinge moment <= 4 kg.cm (review 10 M3); joiner set <= 0.5 mm; no crush | S01 | 2027-02-24 | 2 | 1.5 h | open
S08 | S | Transport car fit (joiner out) and two-person carry | R4;R5 | D | longest piece 1.20 m (results.json geo.longestPiece); pod piece <= 0.5 m | all pieces fit measured car; pod piece <= 0.5 m; carry 50 m assembled | C17;airframe built | 2027-02-25 | 2 | 1 h | open
S09 | S | Built component masses and empty weight (review 2 M1; cad/verification.txt roll-up) | R2 | T | empty 5.23 kg (results.json sized.m 6.55 - pack - payload); CAD modelled 6.36 kg incl. pack | empty <= 6.02 kg (5.23 x 1.15) | none | 2027-01-04 onward | 1 | ongoing | open
S10 | S | Ballast-mount retention (new rev B) | R12;R9 | T | 4.5 g = 22 N; 8 g landing = 39 N on 0.5 kg (calc) | <= 2 mm movement at 78 N (2 x 8 g) in three directions; no strap slip; unchanged after S06 drops | pod built | 2027-02-18 | 1 | 0.5 h | open
E01 | E | Power-up smoke test and V/I sensor calibration | R20 | T | 11.05 V/V; 64 A/V board defaults (vtol_c0.param) | idle <= 1.0 A EST; V within 0.1 V; I within 5 % at >= 5 A | C13 harness;E11 | 2027-02-22 | 2 | 1 h | open
E02 | E | ESC protocol motor order direction spin thresholds | R1;R20 | T | Q_M_SPIN_ARM 0.10 SPIN_MIN 0.15 (vtol_c0.param); lift S5-S8 pusher S9 | correct order/direction; SPIN_ARM >= measured + 0.02; no desync at 100 % 3 s props off | E01 | 2027-02-23 | 2 | 1 h | open
E03 | E | Servo direction throws centering on airframe (5 servos; rudders S4/S11) | R9 | T | elevator at stall -8.2 deg (aero_results stall.trim_at_Vstall); throws +-20 deg EST | correct sense all 5; return within 1 mm; no binding; <= 1 A each EST; elevator throw >= 15 deg EST | C12;E01 | 2027-02-23 | 2 | 1 h | open
E04 | E | RC link channel map switches CRSF telemetry and 300 m range walk | R20 | T | - (ELRS range not in repo) | all switches map; LQ >= 90 % EST at 300 m; handset telemetry V within 0.1 V; no failsafe | E01 | 2027-02-24 | 2 | 1 h | open
E05 | E | Failsafe test: SITL portion done (B C D E F G); hardware bench portion open | R20 | T | FS_LONG_TIMEOUT 5 s; Q_TRANS_FAIL 15 s; low RTL / critical QLAND; fence 110 m peak 113.1 m (firmware/sitl/results/summary.json) | hardware: each failsafe gives configured mode within timeout; params restored (check_params.py) | E04 | 2027-02-25 | 2 | 1.5 h | SITL done 2026-10-21 (generic, firmware/sitl/results/summary.json) and 2026-10-25 (C0 airframe model, firmware/sitl/results_c0.json); hardware open
E06 | E | SITL rehearsal (review F0; 13 M1): scripted A-G done; pilot hand-flying and lift-motor-fail open | R14;R15;R20 | D | mission_test.py scenarios A-G PASS on the generic and on the C0 airframe model; C0: transition 13 s / 144 m, back-transition 1.7 m loss with a -17/+33 deg pitch swing, VTOL land 0.0 m from home (firmware/sitl/README.md) | each pilot (on the C0 model, run_c0_sitl.ps1) recovers failed transition and pusher-out 3/3, flies 3 back-transitions from 20 m/s and stays inside the 300 m fence; SIM_ENGINE_FAIL hover scenario run | E11 | 2027-01-11 to 02-19 | PIC+GCS | 2 h/pilot | scripted done 2026-10-21 (generic) and 2026-10-25 (C0 model, firmware/sitl/results_c0/); pilot portion open
E07 | E | Compass and GPS calibration | R20 | T | - | fitness good; heading error <= 10 deg EST; HDOP <= 1.5; sats >= 10 EST | E01 | 2027-02-24 | 1 | 0.5 h | open
E08 | E | Airspeed sensor bench check (MS5525DSO strapped to 0x77; ARSPD_TYPE 5) | R11 | T | blow test >= 6 m/s (ardupilot.org airspeed calibration 2026-10-21); baro at 0x76 (firmware.md D4) | baro and airspeed both detected on bus 0; 0 +-1 m/s static; >= 6 m/s blow; holds 10 s sealed | E01 | 2027-02-24 | 1 | 0.5 h | open
E09 | E | Bench vibration and ESC thermal soak (in G03) | R9 | T | VIBE < 30 m/s2 (ardupilot.org measuring vibration 2026-10-21) | VIBE X/Y/Z < 30; clip 0; ESC <= 70 degC EST | G03 | 2027-03-01 | 2 | in G03 | open
E10 | E | Telemetry links (CRSF handset; ELRS MAVLink overlay; BLE/WiFi bench) | R20 | T | - (ranges not in repo); no SiK radio (firmware.md 4 R9) | handset telemetry at 300 m; MAVLink overlay if used holds >= 300 m EST; BLE/WiFi range recorded | E04 | 2027-02-26 | 2 | 0.5 h | open
E11 | E | Firmware and parameter inspection (R17; beta risk closed) | R17;R20 | I | ArduPlane 4.7.2 stable CoreWingF405WingV2 (vtol_c0.param header; firmware.md 4 R20) | stable release with QuadPlane; zero mismatches (SITL read-back 133 equal); ARMING_SKIPCHK 0 | FC received | 2026-12-20 and 2027-02-22 | 1 | 1 h | open
E12 | E | Remote ID check (serial and broadcast) | R18 | I;T | BeeID DoC RID000001995 (BOM) | serial listed at uasdoc.faa.gov; broadcast received at 30 m EST | BeeID received;registration | 2026-12-20 | 1 | 0.5 h | open
G01 | G | Weight and balance with ballast (review 9 M1) | R2;R12 | T | CG 26.7-29.3 % MAC with payload (results.json cg); SM 11.8 % aero / 11.5 % sizing | mass <= 7.53 kg; CG 28 +-2 % MAC (+-5.7 mm); never aft of 31.8 % MAC (NP 39.8 - 8); within 20 mm of thrust centroid | S09;avionics fitted | 2027-02-26 | 2 | 1 h | open
G09 | G | CG with and without ballast; ballast rule check (new rev B; aero M4) | R12;R9 | T | 34.7 % MAC without payload (results.json cg.pct.noPayload; aero_results CG_no_payload); SM 5.1 % aero / 4.9 % sizing | empty-bay CG recorded (expected aft of 31.8 %); with 0.5 kg ballast 28 +-2 % MAC; rule and station written on GA note 5 and every card | G01;S10 | 2027-02-26 | 2 | 0.5 h | open
G02 | G | Hand-carry sensor sanity walk | R20 | T | - | attitude within 5 deg; GPS track matches; no EKF/compass warning; airspeed < 3 m/s | E07;E08 | 2027-02-27 | 2 | 0.5 h | open
G03 | G | Full-system tied-down run (review T6 expanded) | R10;R13;R20 | T | 41.2 A hover; 43.6 A at 21 V; 75.7 A transition (results.json v0.4) | >= 3.4 V/cell hover; >= 3.2 V/cell burst; I_hover 41.2 A +-15 % EST; I_trans <= 85 A; VIBE < 30 clip 0; temps per C08/C13; no desync | S04;E02;E03;E05;G01 | 2027-03-01 | 3 | 2 h | open
G04 | G | Compass interference (compassmot) | R20 | T | - | interference <= 30 % EST (ardupilot compassmot page 404 on 2026-10-21); heading change < 10 deg | E07;G03 | 2027-03-01 | 2 | in G03 | open
G05 | G | Tethered hover (review F2) | R13;R20 | T | hover throttle ~0.52 (1638/3130 calc) | 30 s stable at 1 m; attitude error < 15 deg; lift output < 60 %; VIBE < 30; tether slack | G03;G04;G09;I02 | 2027-03-13 | 4 | 2 h | open
G06 | G | Pusher ground run on airframe | R11 | T | pusher ground clearance 41.9 mm (cad/verification.txt) | pull >= 1.5 kgf at 60 %; <= 40 A; no tail buffet; clearance >= 40 mm loaded | C09;G03 | 2027-03-02 | 3 | 0.5 h | open
G07 | G | Assembly and breakdown time incl. joiner slide-in (review 2 M3) | R5 | D | <= 15 min (design basis R5 EST) | median of 3 runs <= 15 min; hex keys only | S08 | 2027-03-05 | 2 | 1.5 h | open
G08 | G | Field procedure rehearsal and charge time (review 13 M2) | R19;R20 | D | ~1.1 h per pack at 6 A EST (review 13) | checklist complete; charge <= 1.5 h per pack | G05 planned | 2027-03-10 | 4 | 2 h | open
F01 | F | First lift-off QSTABILIZE hops (card FTC-F01) | R13;R20 | T | hover throttle ~0.52 | no oscillation; attitude error < 15 deg; VIBE < 30; clip 0 | G05 | 2027-03-14 | 4 | 1 session | open
F02 | F | QHOVER hover-throttle learn and notch log from two 60 s batch-logged hovers (FTC-F02) | R13 | T | Q_M_THST_HOVER learned 0.3-0.6 (ardupilot tuning 2026-10-21); expected 0.52; INS_LOG_BAT_OPT 4 (firmware.md D13) | learned <= 0.60; FFT peak found; front/rear split <= 15 % (review 9 M2) | F01 | 2027-03-16 | 4 | 1 session | open
F03 | F | QLOITER free hover 3 x 60 s thermal (FTC-F03) | R9;R13 | T | hover current 41.2 A; can 63 degC / ESC 56 degC after a 60 s hover on a 35 degC day EST (thermal.md 6.1) | hold within 2 m EST; motors <= 80 degC; cooled < 45 degC between; current 41.2 A +-15 %; hovers <= 60 s | F02 | 2027-03-18 | 4 | 1 session | open
F04 | F | Q-mode handling low forward speed (FTC-F04) | R9 | T | - | box at 5-8 m/s; no unexpected Q_ASSIST; attitude error < 15 deg; airspeed reads +-2 m/s | F03 | 2027-03-21 | 4 | 1 session | open
F05 | F | Hover failsafes and R20 demonstration (FTC-F05) | R20 | D | QLAND on RC loss in Q modes (SITL C); low RTL (SITL E); fence RTL (SITL F) | each action within timeout; touchdown within 5 m of pad EST | F04;E05 | 2027-03-25 | 4 | 1 session | open
F06 | F | Partial transitions Q_ASSIST on from the upwind edge (FTC-F06) | R9;R11 | T | C0 SITL model: 16 m/s 8 s after start, transition done 13 s / 144 m; back-transition airbrake pitch-up <= 2 m loss (firmware/sitl/README.md) | airspeed rising within 6 s (review F5); altitude loss <= 10 m EST; back-transition clean; x3 | F05;I02 RFS | 2027-04-03 | 4 | 1 session | open
F07 | F | Full transition with immediate turn circuit back-transition QLAND (FTC-F07) | R1;R9;R11;R14;R16 | T | transition 10-11 s in generic SITL, 13-14 s on the C0 model; <= 15 s and <= 100 m (review 10 M2); straight run reaches 300 m fence ~6 s after transition | transition <= 15 s <= 100 m; turn started <= 3 s after Transition done; lift outputs at min in cruise; QLAND touchdown <= 1 m/s EST | F06 x3 | 2027-04-05 | 4 | 1 session | open
F08 | F | Airspeed calibration and cruise performance (FTC-F08) | R10;R11 | T | P_cruise 337 W sizing / 302 W aero; 15.2 / 13.6 A at 20 m/s; ARSPD_RATIO 1.5-3.0; pusher can 90 degC after 600 s (thermal.md 6.3 bound) | ratio 1.5-3.0; airspeed vs GPS error <= 10 %; cruise power <= 414 W / 18.6 A at 20 m/s (calc); pusher can <= 80 degC EST by IR after the legs | F07 | 2027-04-08 | 4 | 1 session | open
F13 | F | Gear-fairing A/B at 20 m/s (new rev B; aero M5) (FTC-F13) | R10 | T | 302 W faired vs 482 W bare legs (aero_results drag.gear_faired_case / gear_round_case) | faired <= 414 W; delta >= 100 W confirms fairings are R10-critical | F08 | 2027-04-09 | 4 | 1 session (2 flights) | open
F09 | F | Stall-speed determination in fixed-wing mode (new rev B; aero M2) (FTC-F09) | R11 | T;A | Vs 11.75 m/s (aero_results stall.V_stall_mps; CLmax3D 1.114 = sizing CL_max; 11.75 m/s design stall target, 2.1 % margin to R11); elevator -8.2 deg at stall | Vs <= 12.0 pass; 12.0-12.5 team decision; > 12.5 fail; AIRSPEED_MIN 16 >= 1.3 x Vs; altitude loss <= 30 m EST | F08 | 2027-04-10 | 4 | 1 session | open
F10 | F | Fixed-wing failsafes pusher-out and RC loss in cruise (FTC-F10) | R15;R20 | D | Q_ASSIST_SPEED 13; RTL_RADIUS 100 (vtol_c0.param); SITL B and D PASS | hover re-entered altitude loss <= 30 m EST; RTL -> QRTL lands within 100 m of home | F09 | 2027-04-12 | 4 | 1 session | open
F11 | F | Mission dress rehearsal half duration (FTC-F11) | R9;R10 | T | 58.6 Wh = 53 % of usable for half mission (calc from results.json v0.4) | energy used <= 60 % of C11 usable; all phases logged; no failsafe | F10;F13 | 2027-04-14 | 4 | 1 session | open
F12 | F | Full mission with ballast and fairings (FTC-F12) | R1;R8;R9;R10;R12;R16 | D;T | land at 29 % energy (calc); cruise 12.3 min sizing / 13.7 min aero available | hover >= 120 s; cruise >= 600 s at 18-22 m/s; landing >= 20 % usable and >= 1300 mAh; no failsafe; undamaged; by 2027-04-30 | F11 x2 | 2027-04-17 | 4 | 1 session | open
I01 | I | Budget ledger audit (no spare servo/pushrods held) | R6;R7 | I | $1896.79 committed; $103.21 reserve (C0_BOM.csv) | receipts total <= $2000.00; reserve >= $100 target; 2nd pack, spare motor, 3 ESCs, prop pair on shelf | orders placed | 2027-03-01 | 1 | 1 h | open
I02 | I | Legal and site compliance checklist | R18;R19 | I | review 11 compliance checklist | all items done before first flight; request on file per flight date | E12 | 2027-03-03 | 1 | ongoing | open
I03 | I | Configuration inspection against DBF-DRW-001 rev E | R1;R3;R14 | I | span 2.40 m; disc clearance 79.0 mm; pusher ground clearance 41.9 mm (cad/verification.txt) | matches drawing; span 2.40 +-0.02 m; clearance >= 20 mm; ground clearance >= 40 mm; ballast note and hover limits on cards | airframe built | 2027-02-26 | 1 | 1 h | open
