davinciucberkeley-collab/DBF-VTOL/inventory/fusion/animations/aileron_right.gif

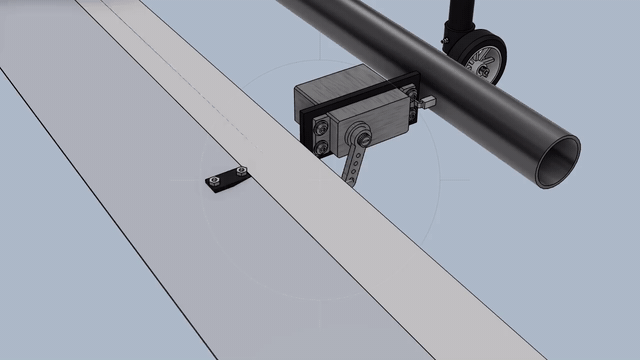
inventory/fusion/animations/aileron_right.gif
