davinciucberkeley-collab/DBF-VTOL/inventory/fusion/animations/all_controls.gif

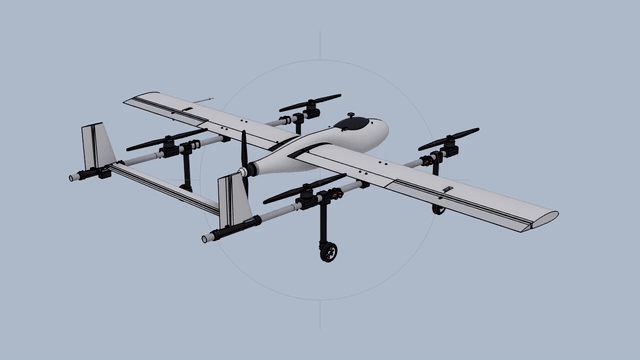
inventory/fusion/animations/all_controls.gif
