davinciucberkeley-collab/DBF-VTOL/inventory/fusion/detail_aileron.png

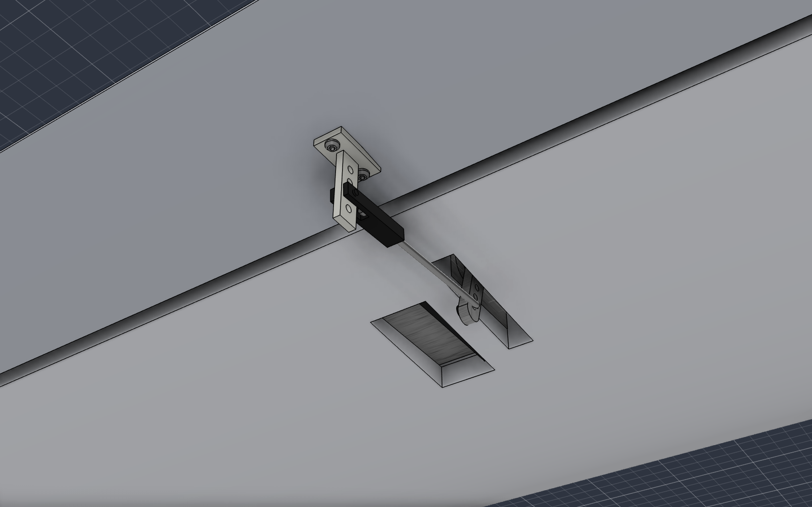
inventory/fusion/detail_aileron.png
