davinciucberkeley-collab/DBF-VTOL/inventory/fusion/detail_gear.png

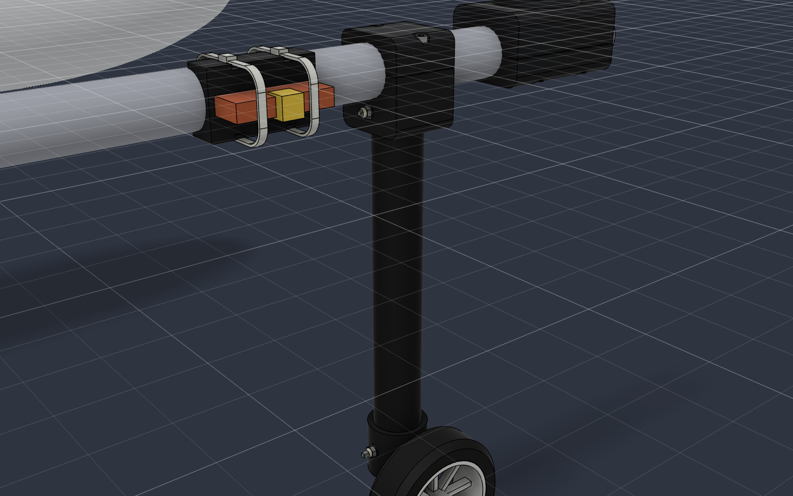
inventory/fusion/detail_gear.png
