davinciucberkeley-collab/DBF-VTOL/inventory/fusion/detail_motor.png

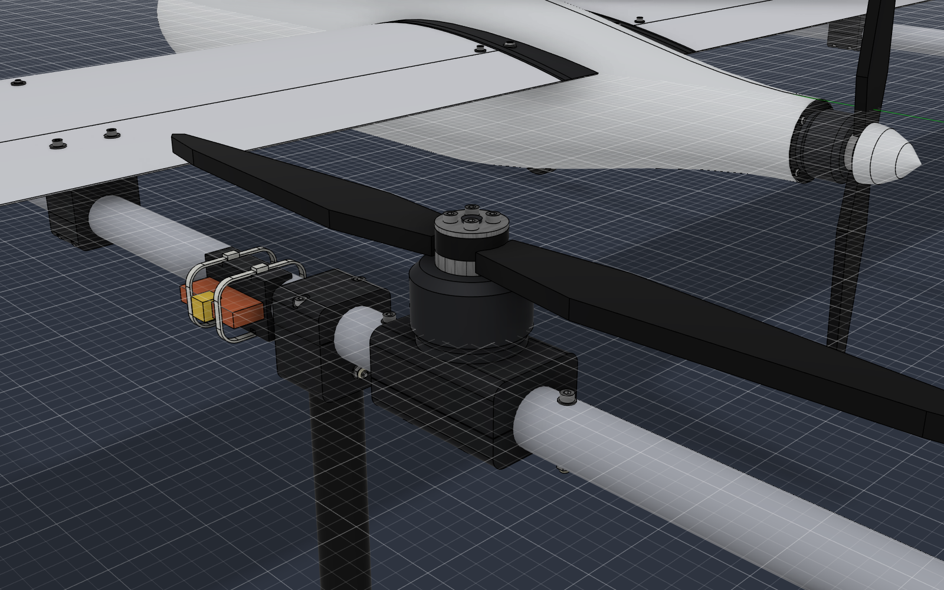
inventory/fusion/detail_motor.png
