davinciucberkeley-collab/DBF-VTOL/inventory/fusion/detail_saddle.png

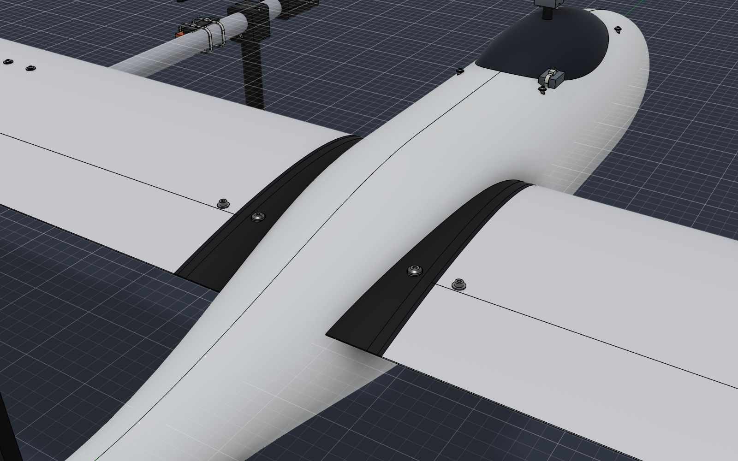
inventory/fusion/detail_saddle.png
