davinciucberkeley-collab/DBF-VTOL/inventory/fusion/detail_section.png

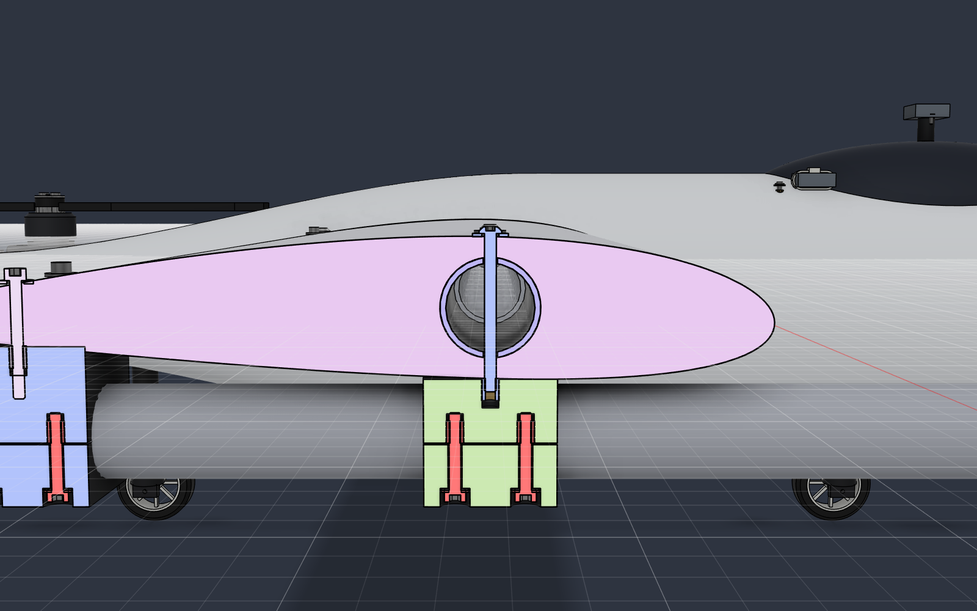
inventory/fusion/detail_section.png
