davinciucberkeley-collab/DBF-VTOL/inventory/fusion/detail_tail.png

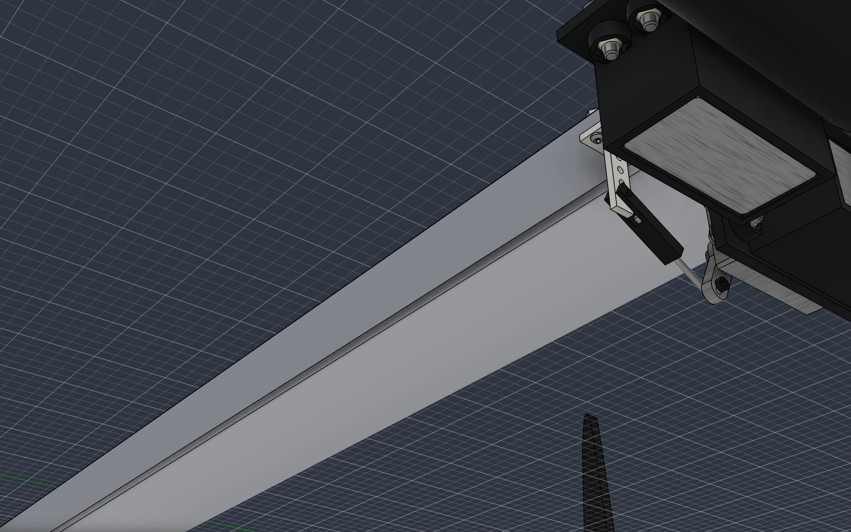
inventory/fusion/detail_tail.png
