davinciucberkeley-collab/DBF-VTOL/inventory/fusion/motion_clearance_aileron_te_down.png

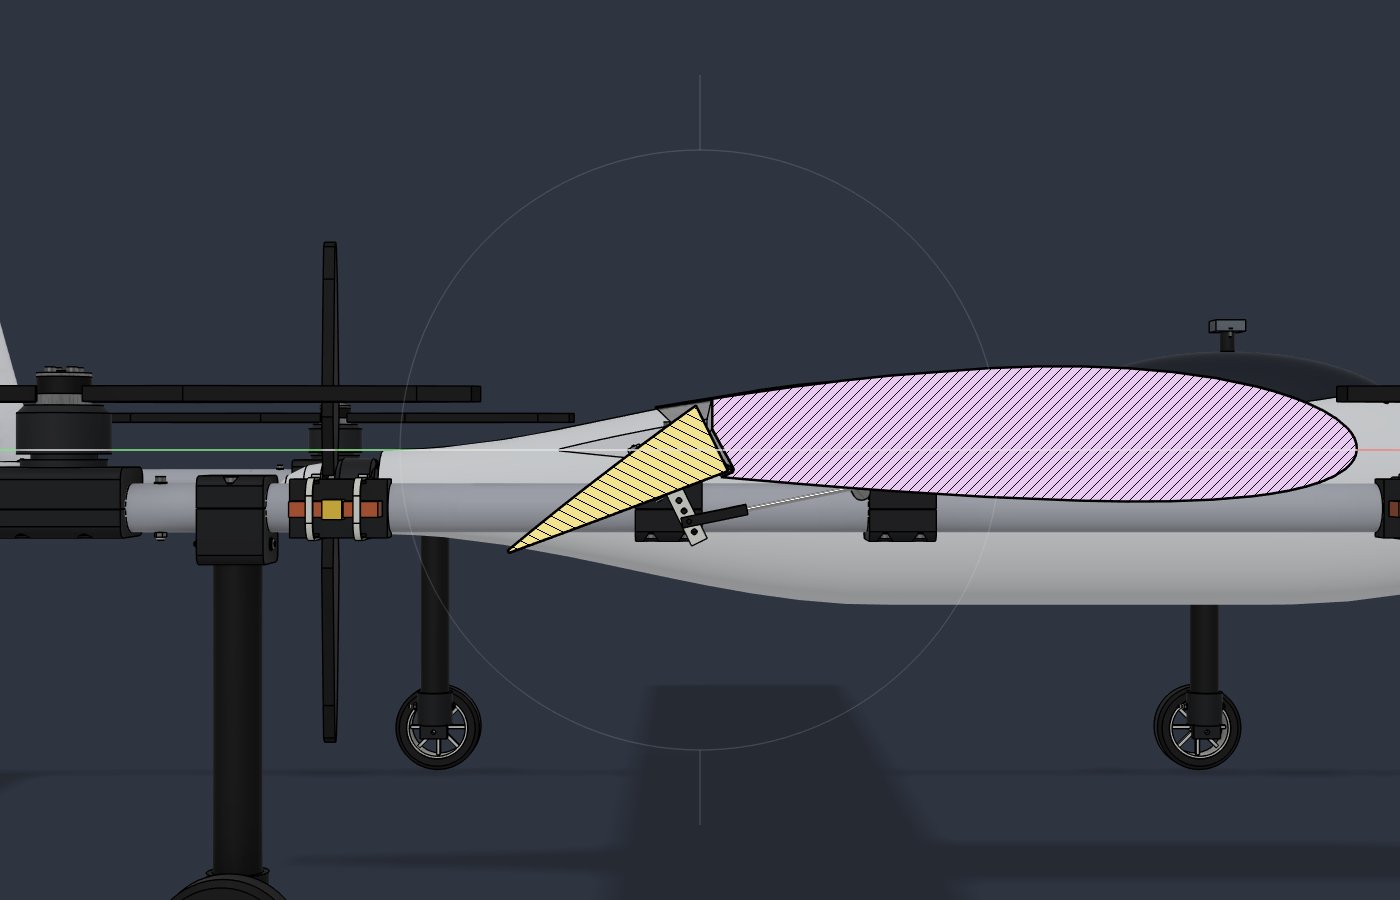
inventory/fusion/motion_clearance_aileron_te_down.png
