davinciucberkeley-collab/DBF-VTOL/inventory/fusion/motion_clearance_elevator_max.png

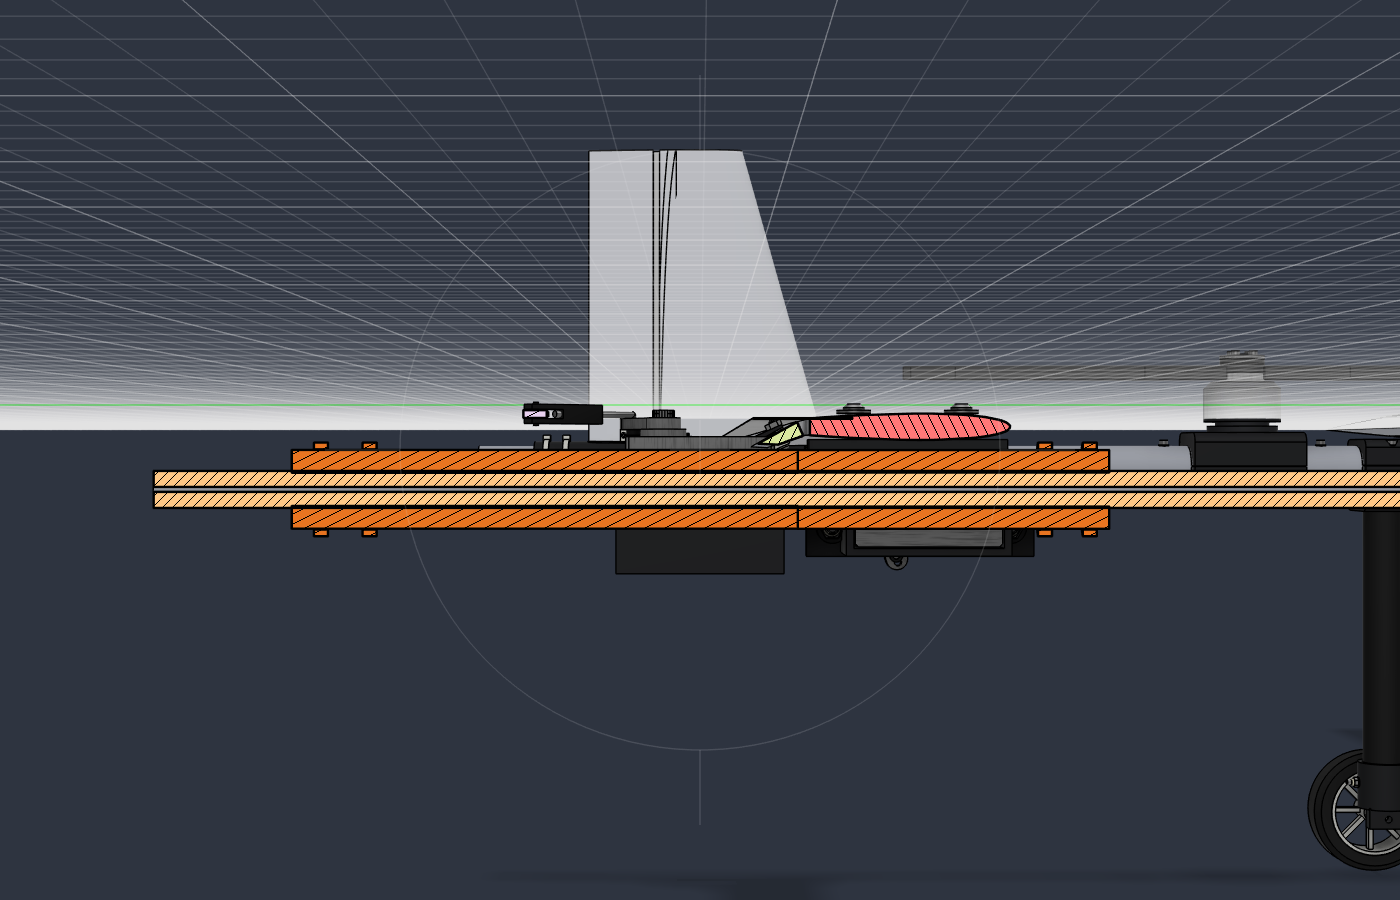
inventory/fusion/motion_clearance_elevator_max.png
