davinciucberkeley-collab/DBF-VTOL/inventory/fusion/motion_clearance_pushrod_slot.png

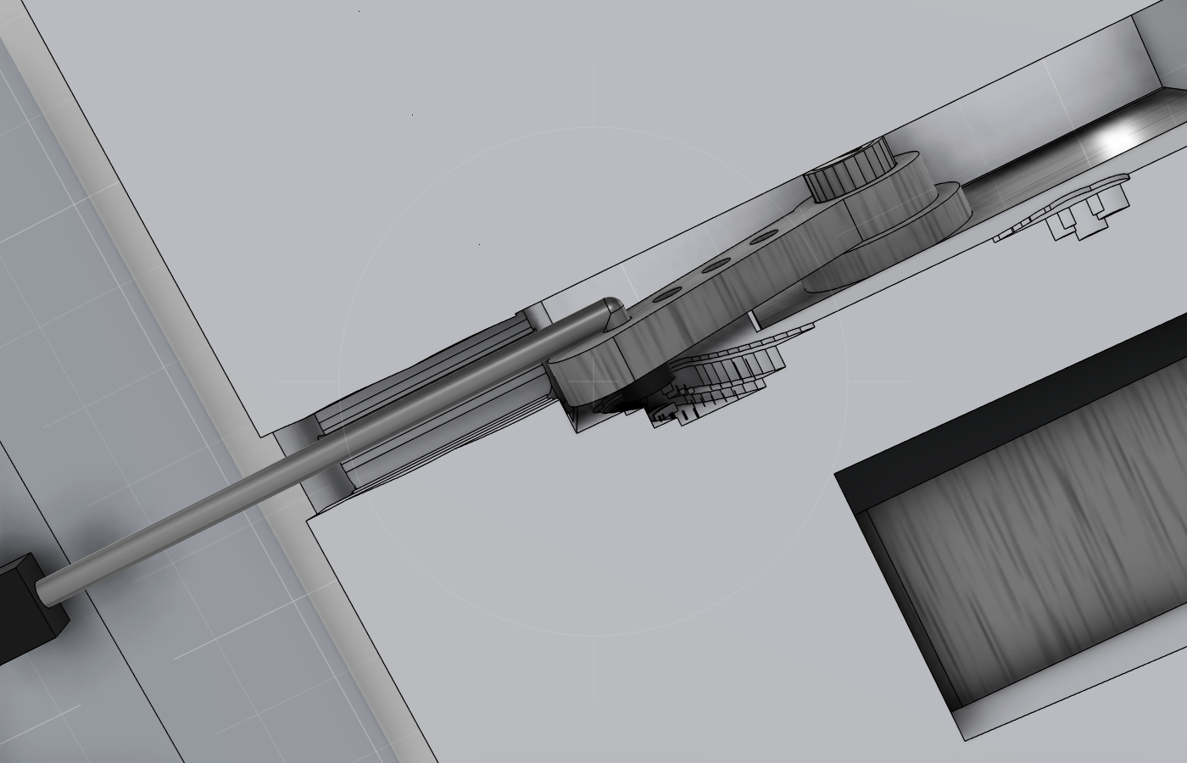
inventory/fusion/motion_clearance_pushrod_slot.png
