davinciucberkeley-collab/DBF-VTOL/inventory/fusion/view_front.png

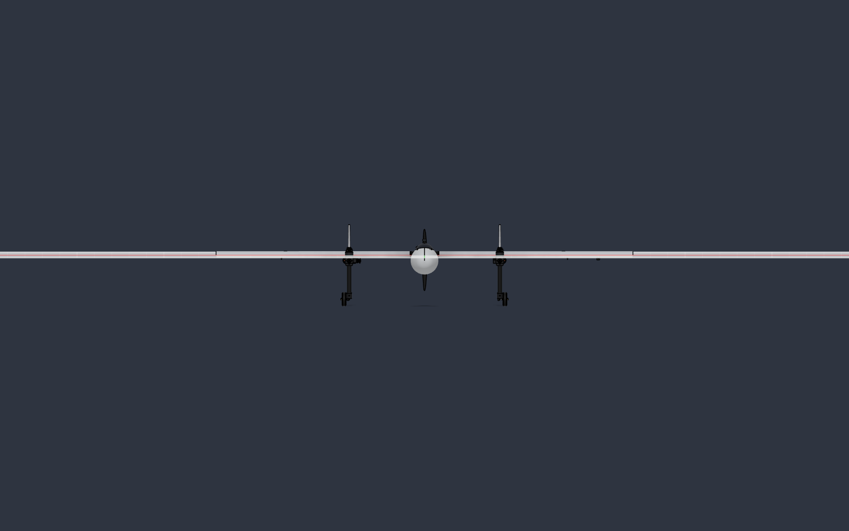
inventory/fusion/view_front.png
