davinciucberkeley-collab/DBF-VTOL/inventory/fusion/view_iso.png

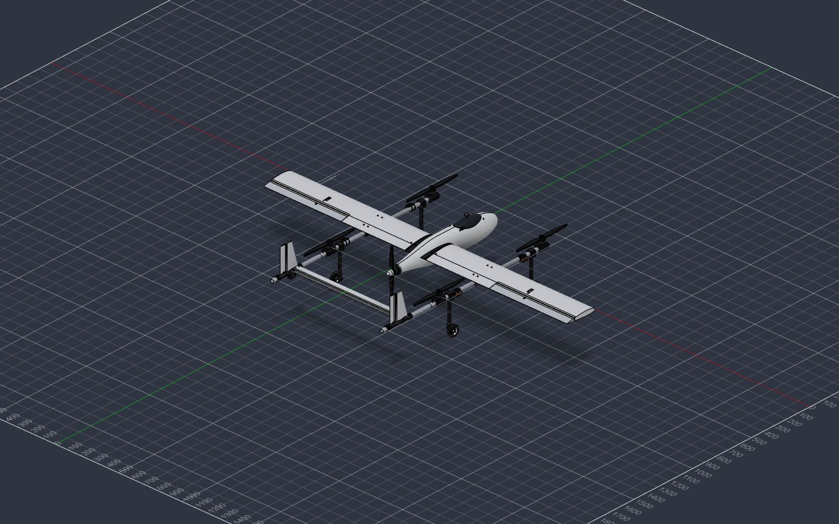
inventory/fusion/view_iso.png
