davinciucberkeley-collab/DBF-VTOL/inventory/fusion/view_side.png

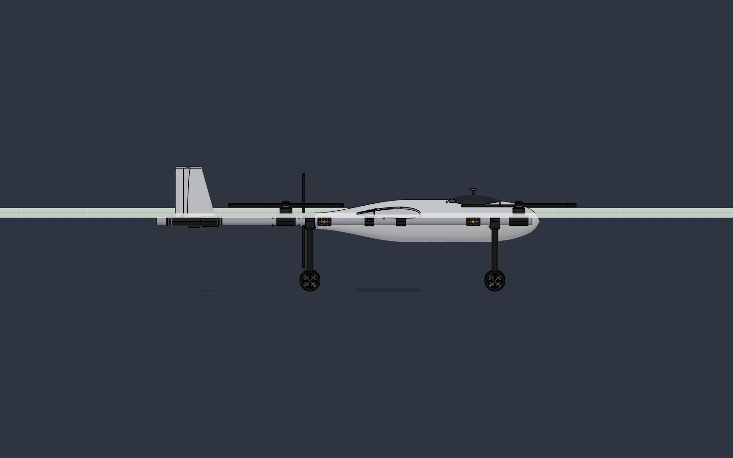
inventory/fusion/view_side.png
