davinciucberkeley-collab/DBF-VTOL/inventory/fusion/view_top.png

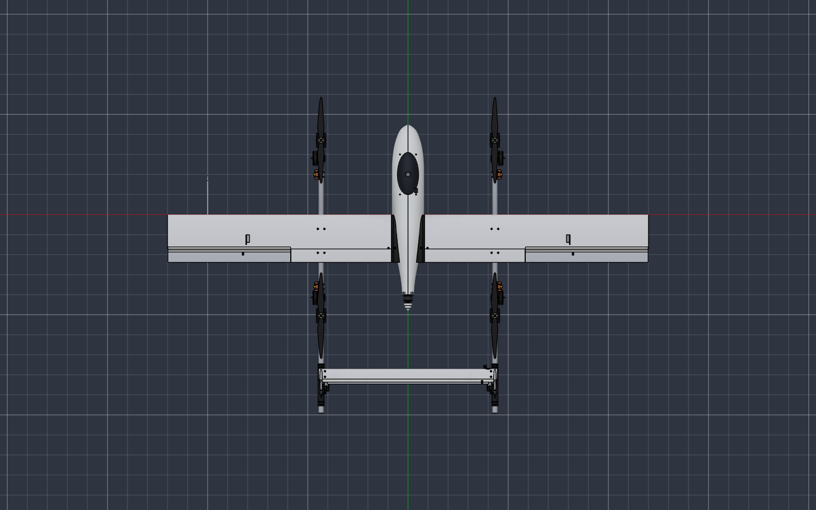
inventory/fusion/view_top.png
