davinciucberkeley-collab/DBF-VTOL/cad/mesh/N02_M5_Nylock.STL

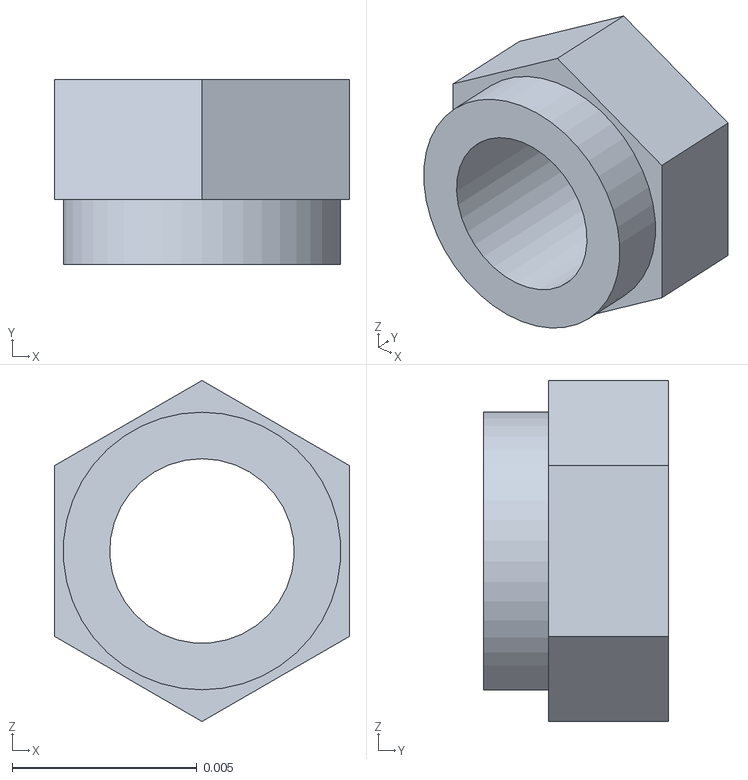
[picture p69: CAD file, 2026-11-04]
cad/mesh/N02_M5_Nylock.STL
0.008 x 0.005 x 0.00924
