davinciucberkeley-collab/DBF-VTOL/cad/sim/THERM_Lift_Motor.SLDPRT

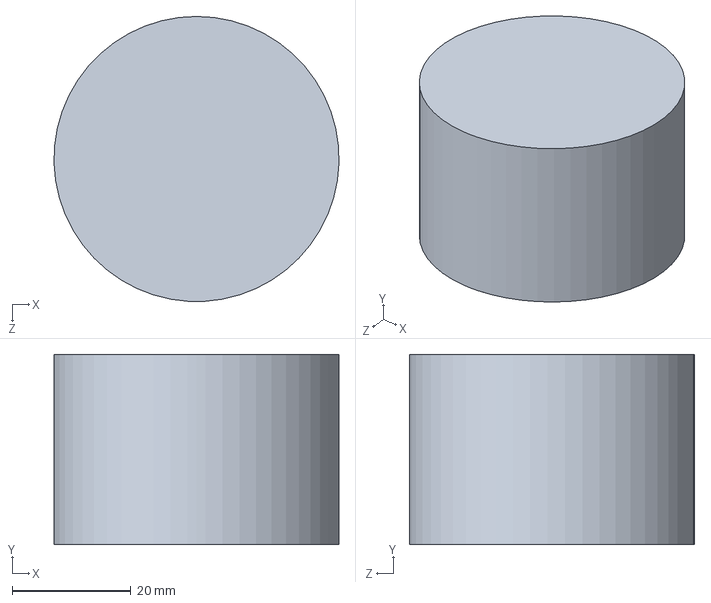
[picture p71: CAD file, 2026-11-04]
cad/sim/THERM_Lift_Motor.SLDPRT
48.0 x 32.0 x 48.0 mm
