davinciucberkeley-collab/DBF-VTOL/cad/sim/thermal/THERM_Pusher.SLDPRT

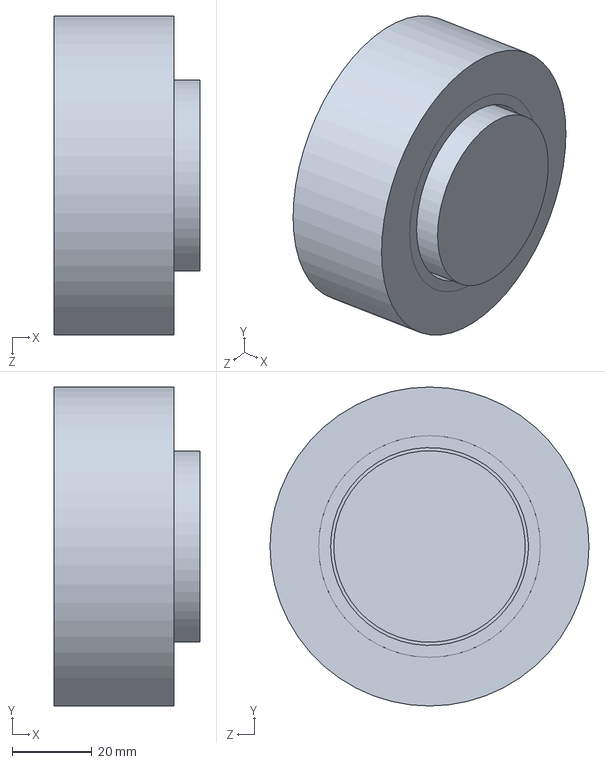
[picture p72: CAD file, 2026-11-04]
cad/sim/thermal/THERM_Pusher.SLDPRT
36.5 x 80.0 x 80.0 mm
