davinciucberkeley-collab/DBF-VTOL/concepts/variants/a1/fusion/a1.step

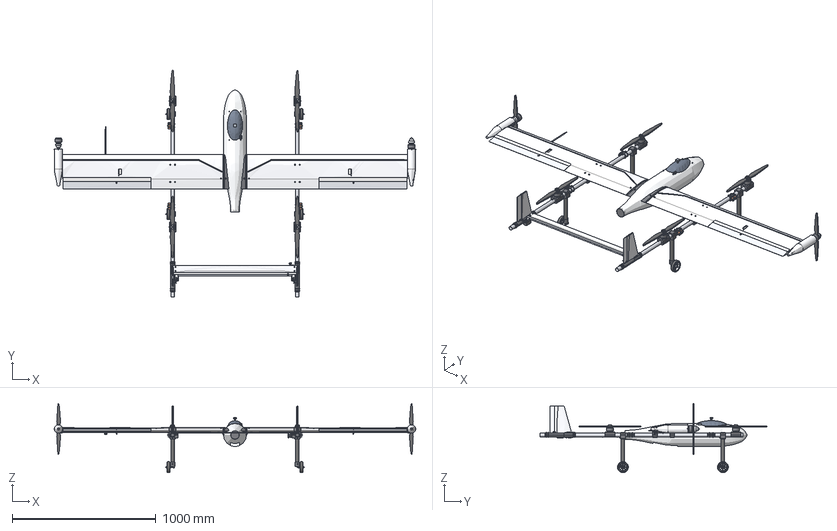
[picture p73: CAD file, 2026-11-03]
concepts/variants/a1/fusion/a1.step
2518.1 x 1577.3 x 481.6 mm
