davinciucberkeley-collab/DBF-VTOL/concepts/variants/a1/fusion/kinematics/Tip_Prop_Set_L.stl

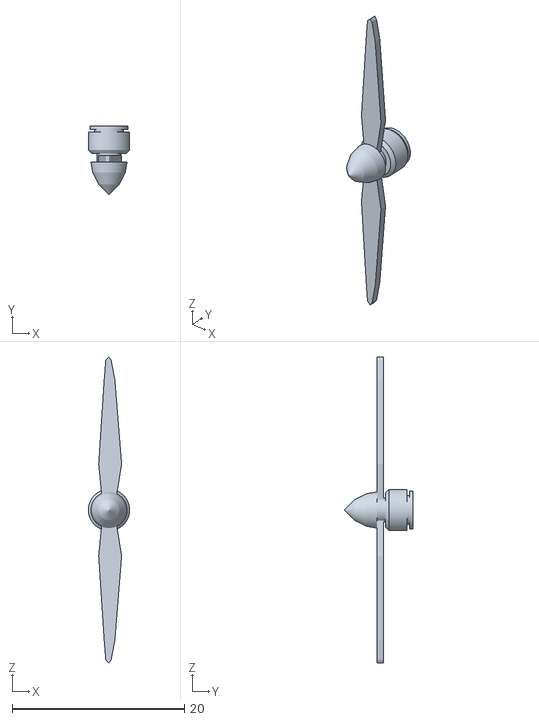
[picture p74: CAD file, 2026-11-03]
concepts/variants/a1/fusion/kinematics/Tip_Prop_Set_L.stl
4.80 x 8.00 x 35.6
