davinciucberkeley-collab/DBF-VTOL/concepts/variants/a1/fusion/stl/Fuselage_Pod.stl

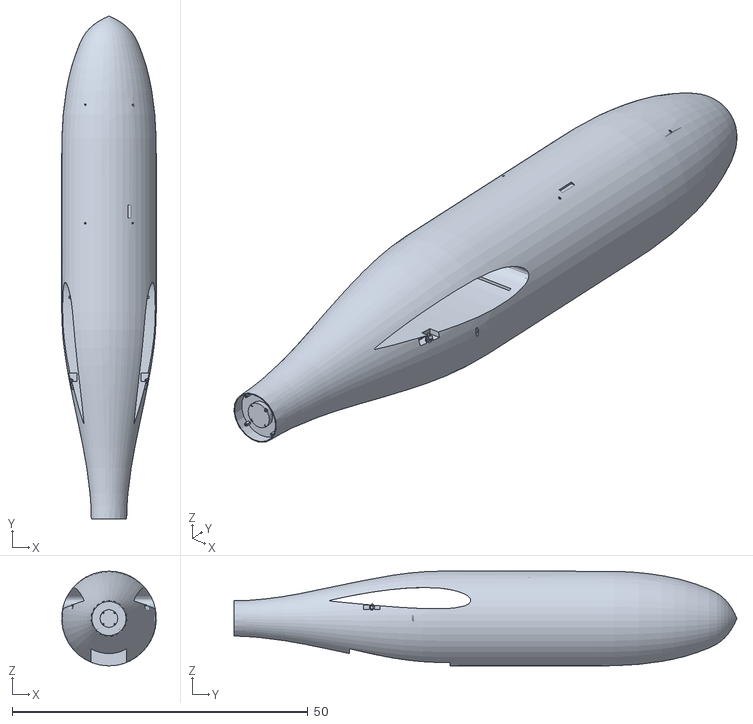
[picture p75: CAD file, 2026-11-03]
concepts/variants/a1/fusion/stl/Fuselage_Pod.stl
16.0 x 85.0 x 16.0
