davinciucberkeley-collab/DBF-VTOL/concepts/variants/a2/fusion/a2.step

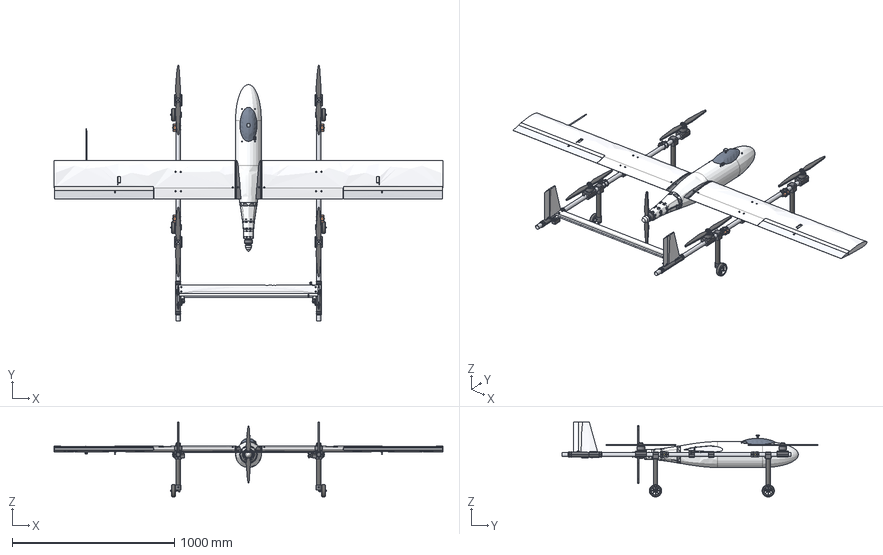
[picture p76: CAD file, 2026-11-03]
concepts/variants/a2/fusion/a2.step
2400.0 x 1577.3 x 462.5 mm
