davinciucberkeley-collab/DBF-VTOL/concepts/variants/a2/fusion/kinematics/Canopy.stl

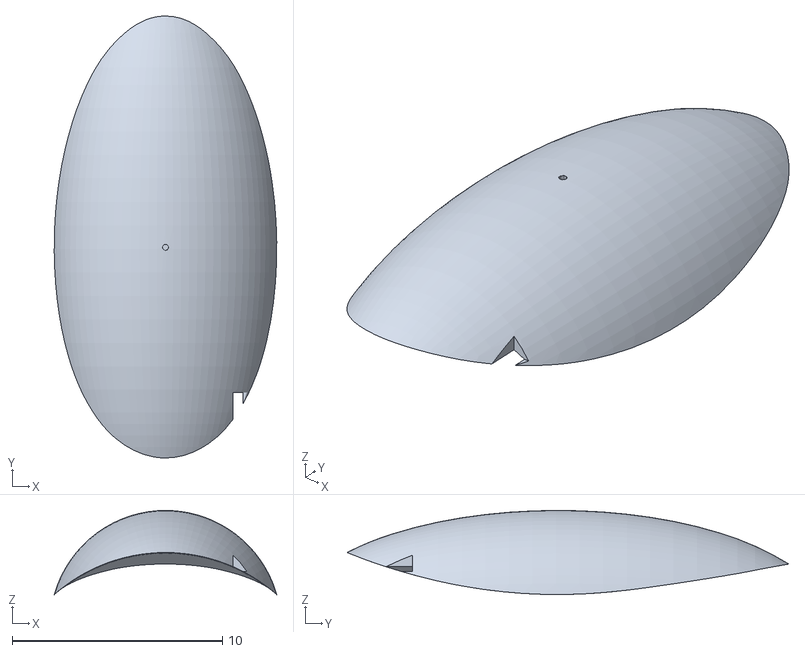
[picture p77: CAD file, 2026-11-03]
concepts/variants/a2/fusion/kinematics/Canopy.stl
10.6 x 21.0 x 4.00
