davinciucberkeley-collab/DBF-VTOL/concepts/variants/a2/fusion/stl/RX1.stl

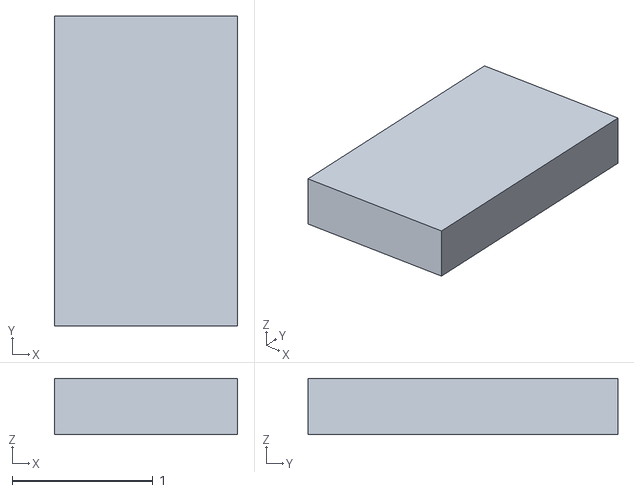
[picture p78: CAD file, 2026-11-03]
concepts/variants/a2/fusion/stl/RX1.stl
1.30 x 2.20 x 0.4
