davinciucberkeley-collab/DBF-VTOL/concepts/variants/a3/fusion/a3.step

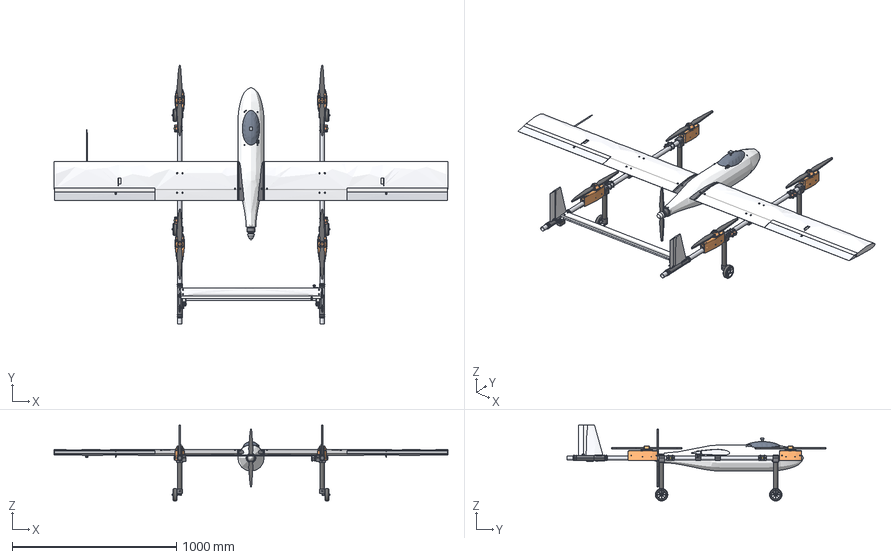
[picture p79: CAD file, 2026-11-03]
concepts/variants/a3/fusion/a3.step
2400.0 x 1577.3 x 462.5 mm
