davinciucberkeley-collab/DBF-VTOL/concepts/variants/a3/fusion/stl/Lift_Nacelle_L1.stl

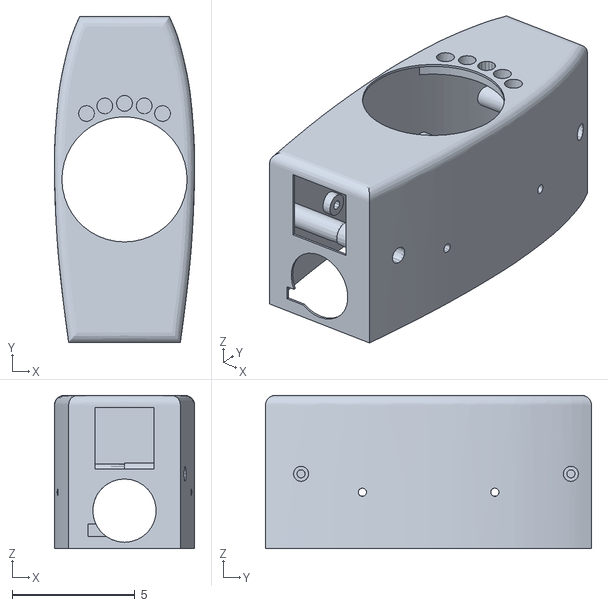
[picture p80: CAD file, 2026-11-03]
concepts/variants/a3/fusion/stl/Lift_Nacelle_L1.stl
5.72 x 13.3 x 6.25
