davinciucberkeley-collab/DBF-VTOL/inventory/fusion/kinematics/Elevator.stl

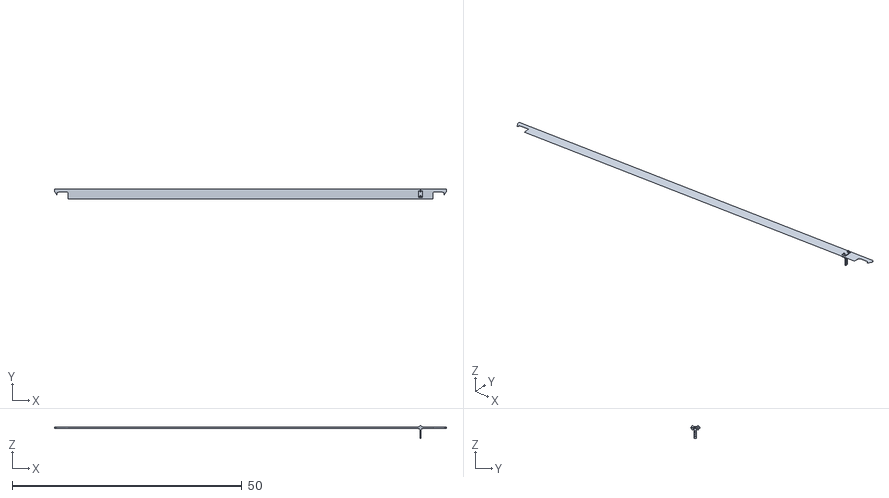
[picture p81: CAD file, 2026-11-02]
inventory/fusion/kinematics/Elevator.stl
85.2 x 2.07 x 2.80
