davinciucberkeley-collab/DBF-VTOL/inventory/fusion/stl/Fuselage_Pod.stl

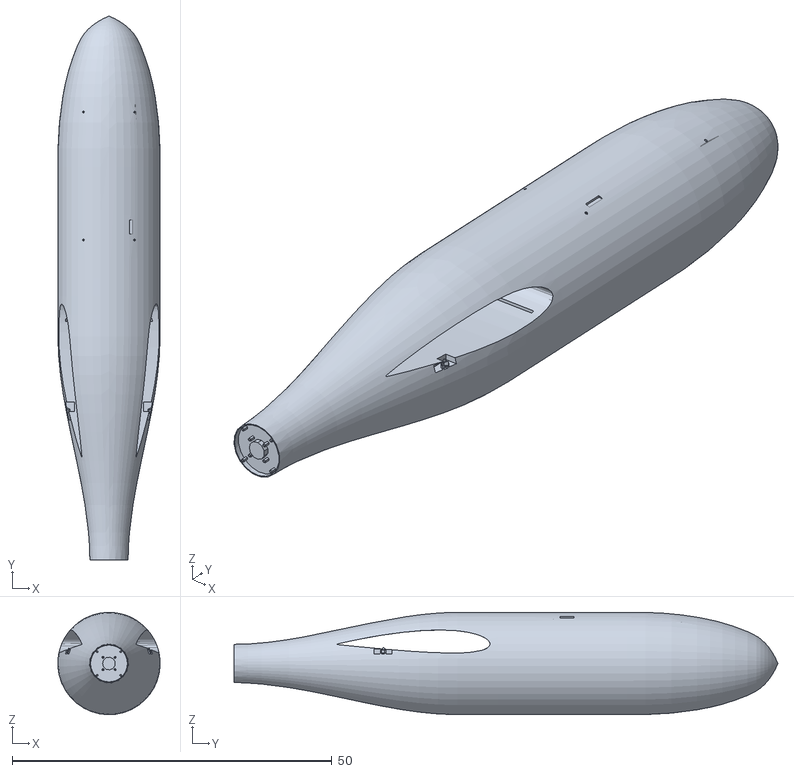
[picture p82: CAD file, 2026-11-02]
inventory/fusion/stl/Fuselage_Pod.stl
16.0 x 85.0 x 16.0
