davinciucberkeley-collab/DBF-VTOL/inventory/fusion/VTOL_Fusion.step

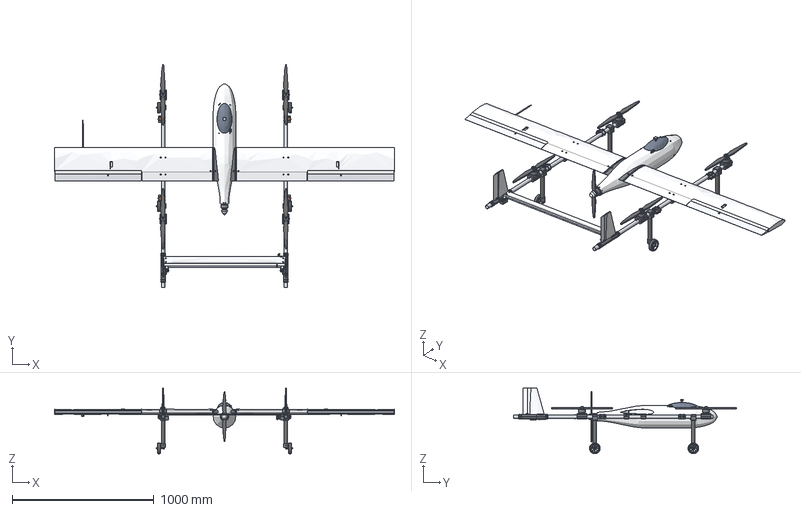
[picture p83: CAD file, 2026-11-02]
inventory/fusion/VTOL_Fusion.step
2400.0 x 1577.3 x 462.5 mm
