davinciucberkeley-collab/DBF-VTOL/inventory/v031/cad/mesh/Fuselage_Pod.STL

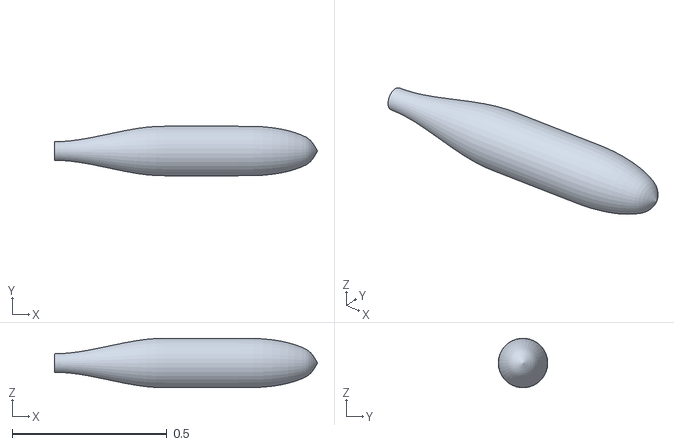
[picture p84: CAD file, 2026-11-04]
inventory/v031/cad/mesh/Fuselage_Pod.STL
0.85 x 0.16 x 0.159
