davinciucberkeley-collab/DBF-VTOL/cad/mesh/Fuselage_Pod.STL

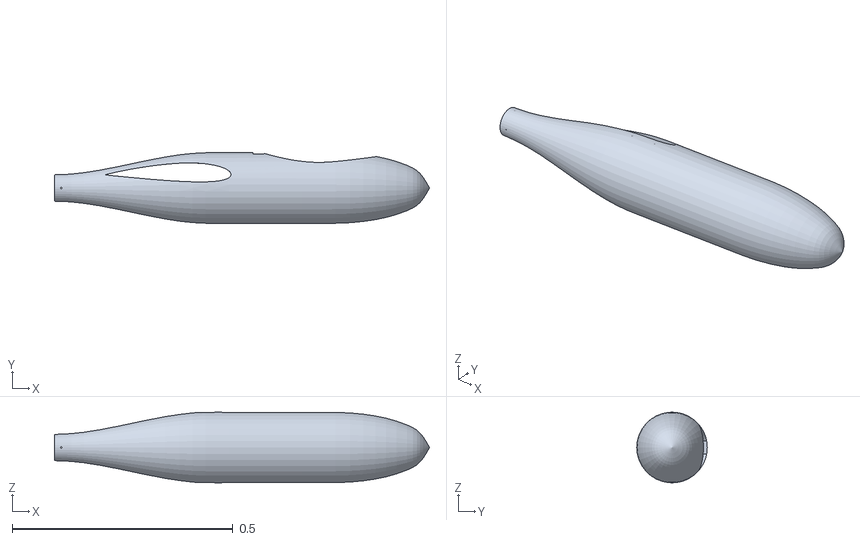
[picture p85: CAD file, 2026-11-04]
cad/mesh/Fuselage_Pod.STL
0.85 x 0.16 x 0.16
