davinciucberkeley-collab/DBF-VTOL/cad/model/Pushrod_Rudder.SLDPRT

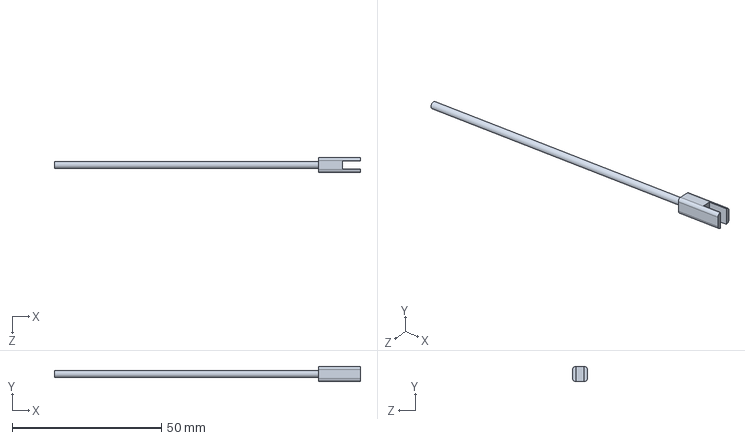
[picture p86: CAD file, 2026-11-04]
cad/model/Pushrod_Rudder.SLDPRT
102.4 x 5.00 x 5.00 mm
