davinciucberkeley-collab/DBF-VTOL/cad/sim/FEA_Boom_Arm.SLDPRT

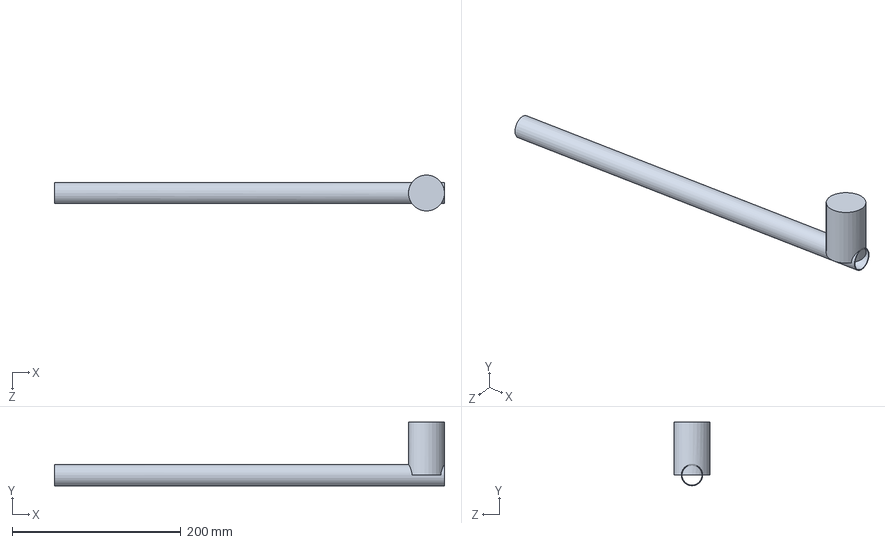
[picture p87: CAD file, 2026-11-04]
cad/sim/FEA_Boom_Arm.SLDPRT
462.0 x 75.4 x 42.7 mm
