davinciucberkeley-collab/DBF-VTOL/cad/sim/thermal/THERM_Pod.SLDPRT

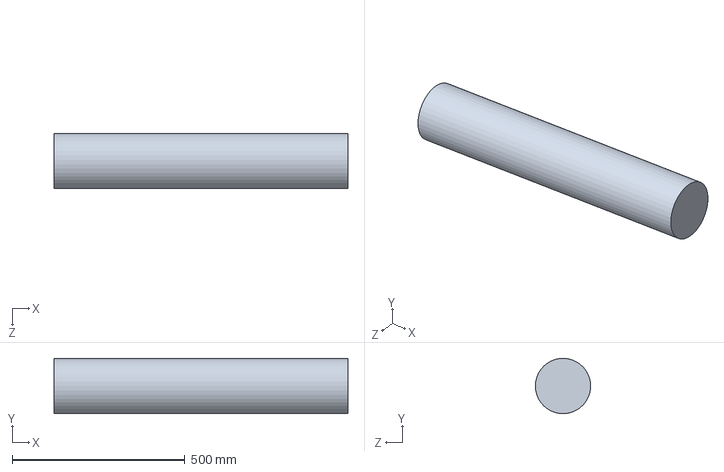
[picture p88: CAD file, 2026-11-04]
cad/sim/thermal/THERM_Pod.SLDPRT
850.0 x 159.9 x 160.0 mm
