davinciucberkeley-collab/DBF-VTOL/concepts/variants/a1/fusion/stl/Nacelle_Mount_R.stl

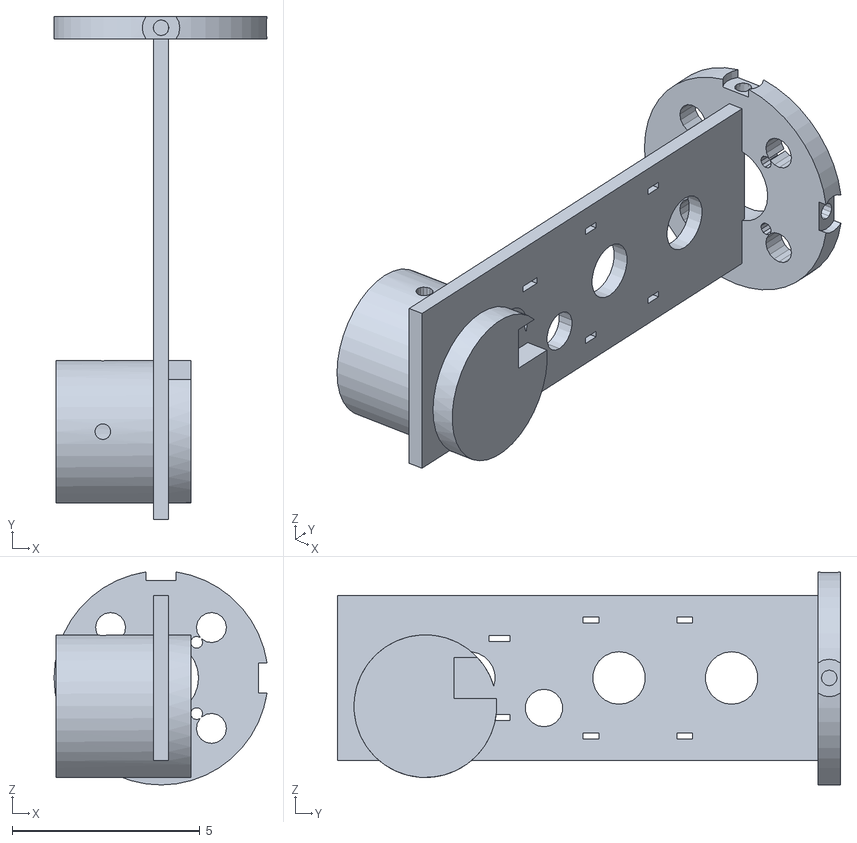
[picture p89: CAD file, 2026-11-03]
concepts/variants/a1/fusion/stl/Nacelle_Mount_R.stl
5.67 x 13.4 x 5.67
