davinciucberkeley-collab/DBF-VTOL/concepts/variants/a2/fusion/kinematics/Battery_6S_LiPo.stl

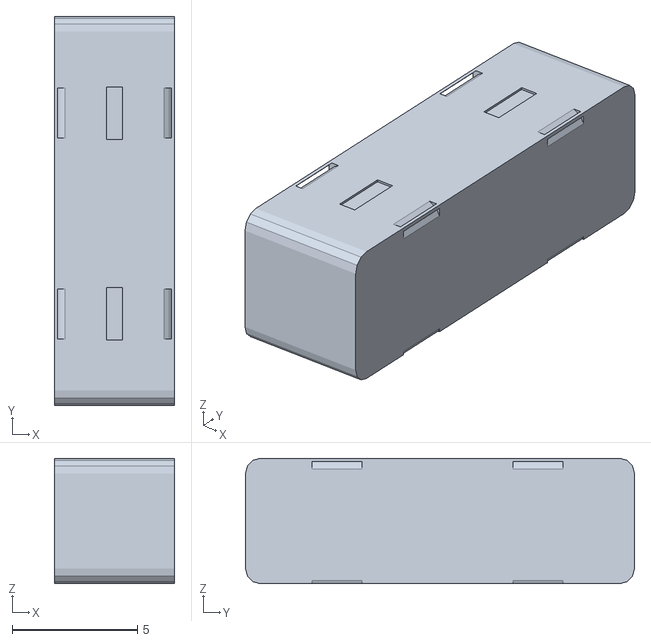
[picture p90: CAD file, 2026-11-03]
concepts/variants/a2/fusion/kinematics/Battery_6S_LiPo.stl
4.80 x 15.5 x 5.00
