davinciucberkeley-collab/DBF-VTOL/concepts/variants/a2/fusion/stl/J-A2-01_Tail_joint_inserts.stl

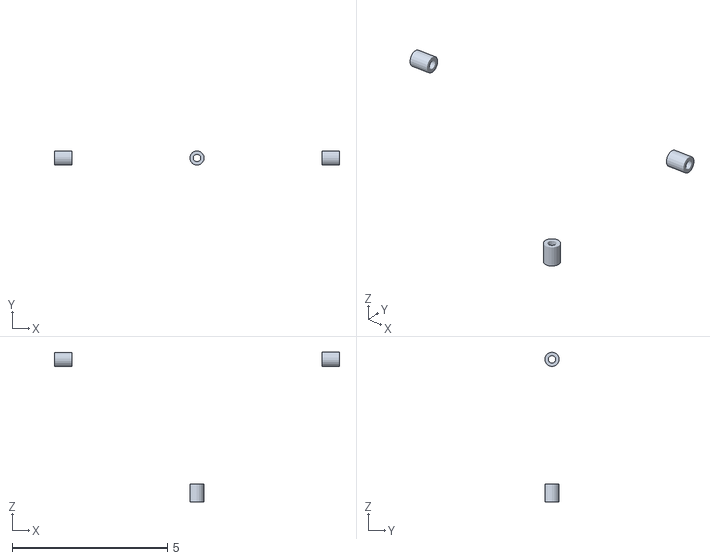
[picture p91: CAD file, 2026-11-03]
concepts/variants/a2/fusion/stl/J-A2-01_Tail_joint_inserts.stl
9.18 x 0.458 x 4.82
