davinciucberkeley-collab/DBF-VTOL/concepts/variants/a3/fusion/kinematics/Lift_Prop_L4.stl

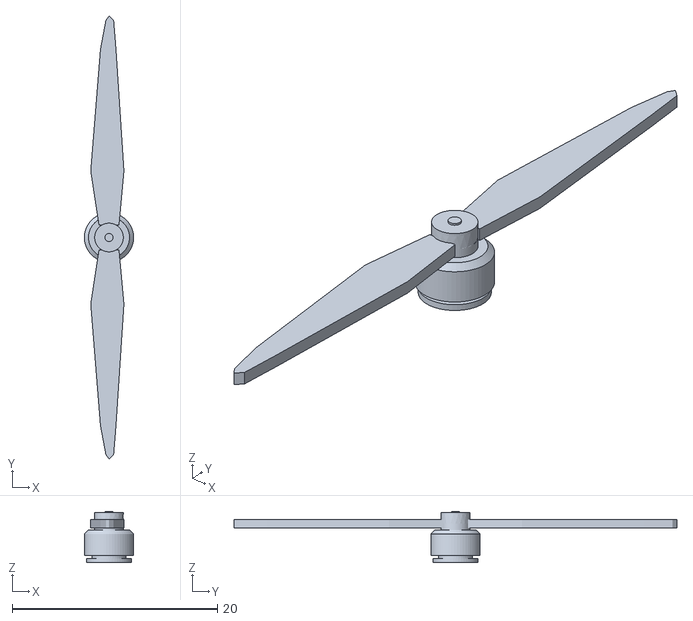
[picture p92: CAD file, 2026-11-03]
concepts/variants/a3/fusion/kinematics/Lift_Prop_L4.stl
4.79 x 43.2 x 5.00
