davinciucberkeley-collab/DBF-VTOL/concepts/variants/a3/fusion/stl/Motor_Mount_1.stl

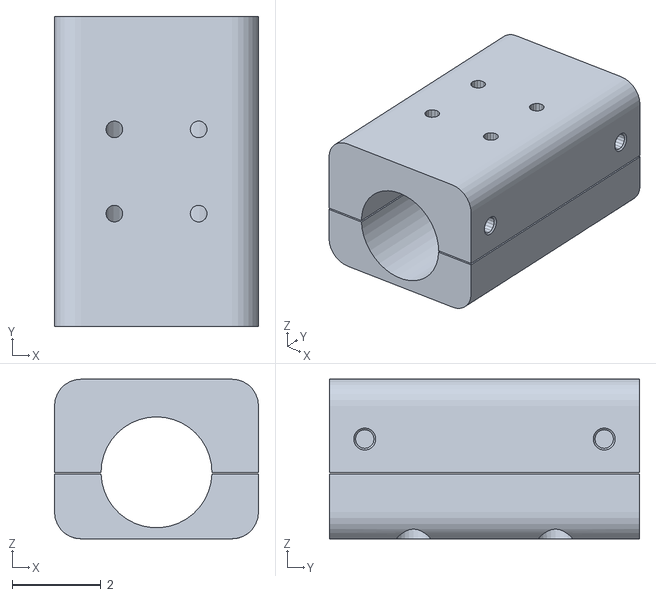
[picture p93: CAD file, 2026-11-03]
concepts/variants/a3/fusion/stl/Motor_Mount_1.stl
4.60 x 7.00 x 3.60
