davinciucberkeley-collab/DBF-VTOL/inventory/fusion/kinematics/Rudder_R.stl

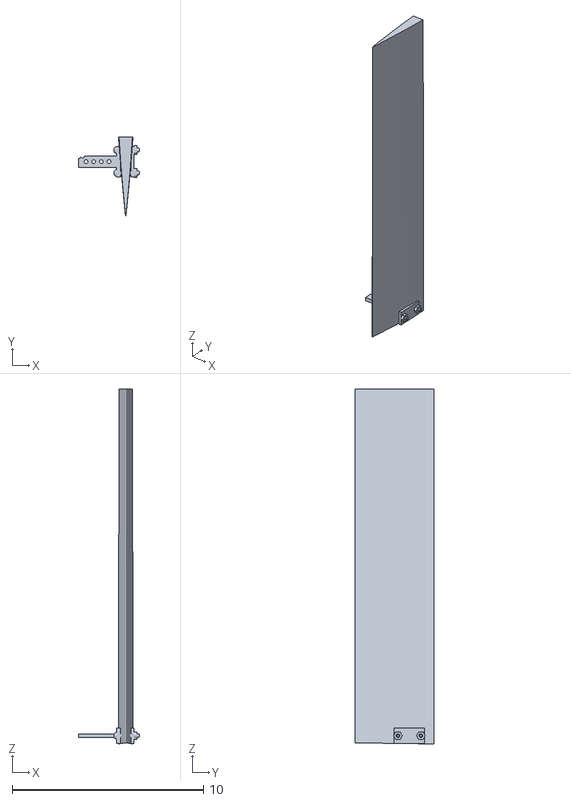
[picture p94: CAD file, 2026-11-02]
inventory/fusion/kinematics/Rudder_R.stl
3.20 x 4.11 x 18.6
