davinciucberkeley-collab/DBF-VTOL/inventory/fusion/stl/Wing_Panel_L.stl

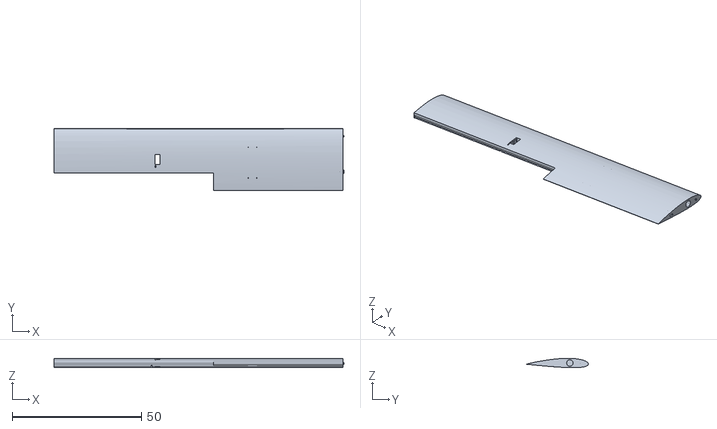
[picture p95: CAD file, 2026-11-02]
inventory/fusion/stl/Wing_Panel_L.stl
112.0 x 23.9 x 3.60
