davinciucberkeley-collab/DBF-VTOL/inventory/v031/cad/mesh/Pusher_Prop_14in.STL

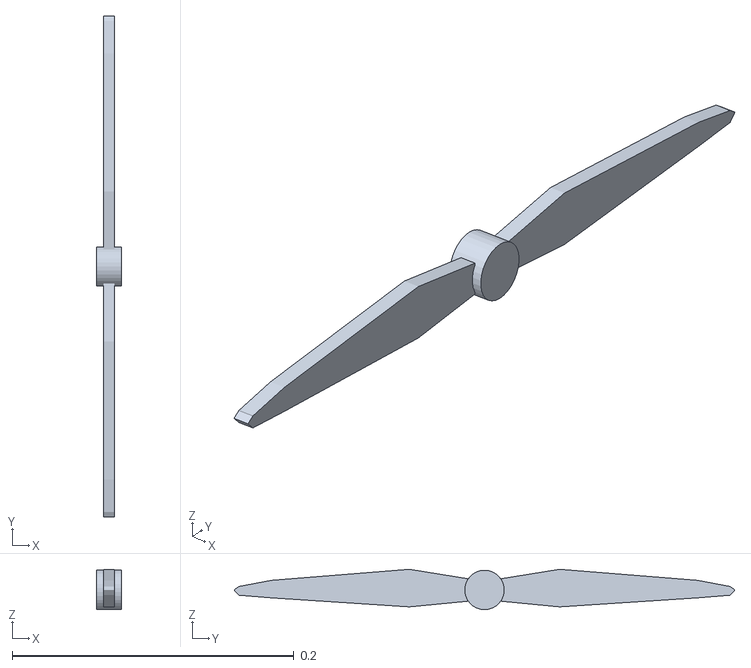
[picture p96: CAD file, 2026-11-04]
inventory/v031/cad/mesh/Pusher_Prop_14in.STL
0.0176 x 0.356 x 0.0287
