davinciucberkeley-collab/DBF-VTOL/cad/model/Pusher_Motor.SLDPRT

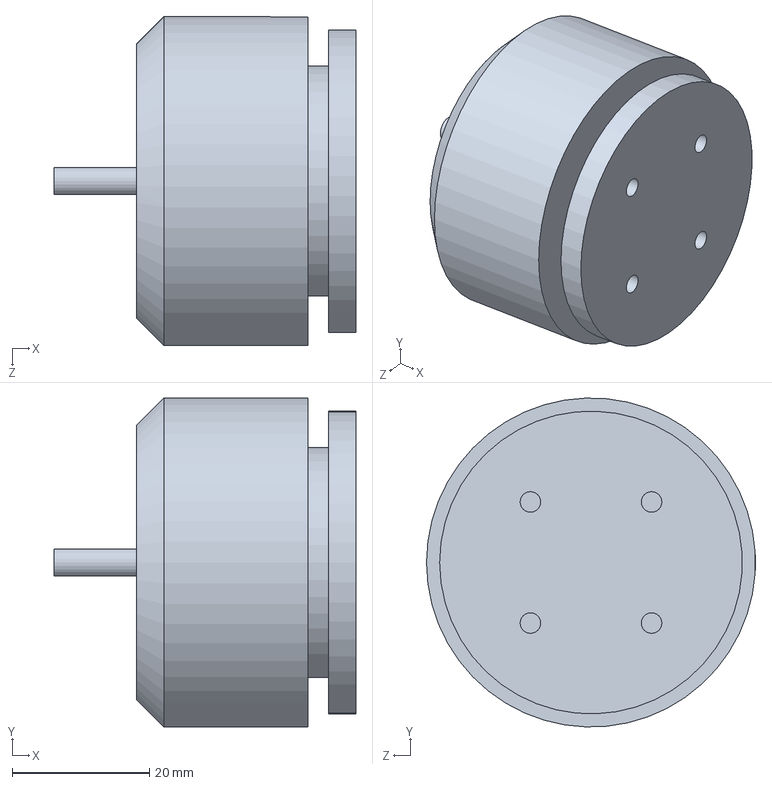
[picture p97: CAD file, 2026-11-04]
cad/model/Pusher_Motor.SLDPRT
44.0 x 48.0 x 48.0 mm
