davinciucberkeley-collab/DBF-VTOL/cad/sim/thermal/THERM_Lift_Unit.SLDPRT

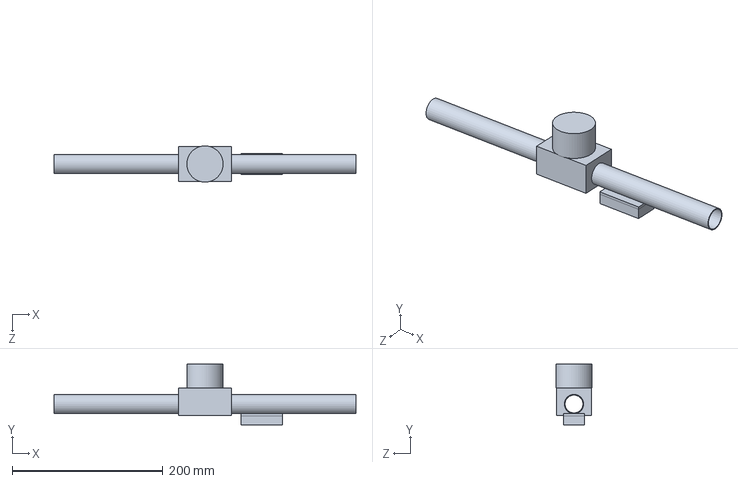
[picture p99: CAD file, 2026-11-04]
cad/sim/thermal/THERM_Lift_Unit.SLDPRT
400.0 x 80.7 x 48.0 mm
