davinciucberkeley-collab/DBF-VTOL/concepts/variants/a1/fusion/stl/Tip_Tube_Ext_R.stl

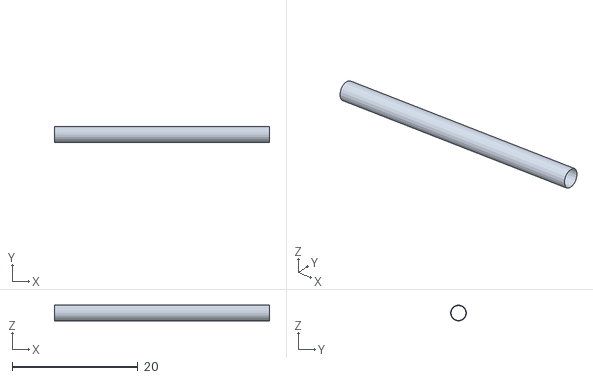
[picture p100: CAD file, 2026-11-03]
concepts/variants/a1/fusion/stl/Tip_Tube_Ext_R.stl
34.2 x 2.54 x 2.54
