davinciucberkeley-collab/DBF-VTOL/concepts/variants/a2/fusion/stl/J-26_FC_stack_on_avionics_deck_deck_on_formers.stl

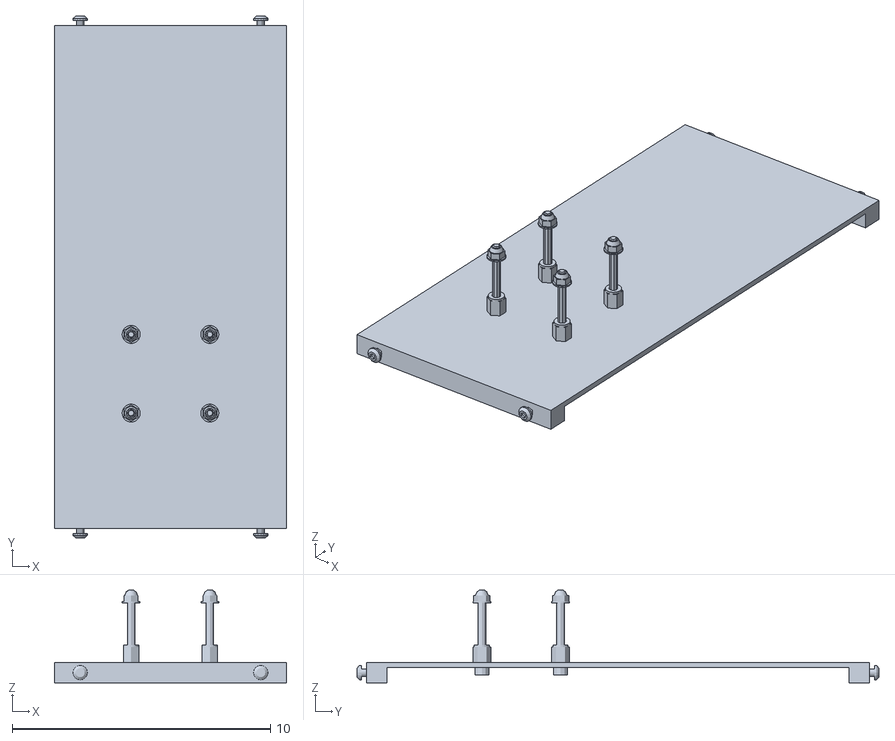
[picture p101: CAD file, 2026-11-03]
concepts/variants/a2/fusion/stl/J-26_FC_stack_on_avionics_deck_deck_on_formers.stl
9.00 x 20.2 x 3.60
