davinciucberkeley-collab/DBF-VTOL/inventory/v031/cad/mesh/Gear_Clamp.STL

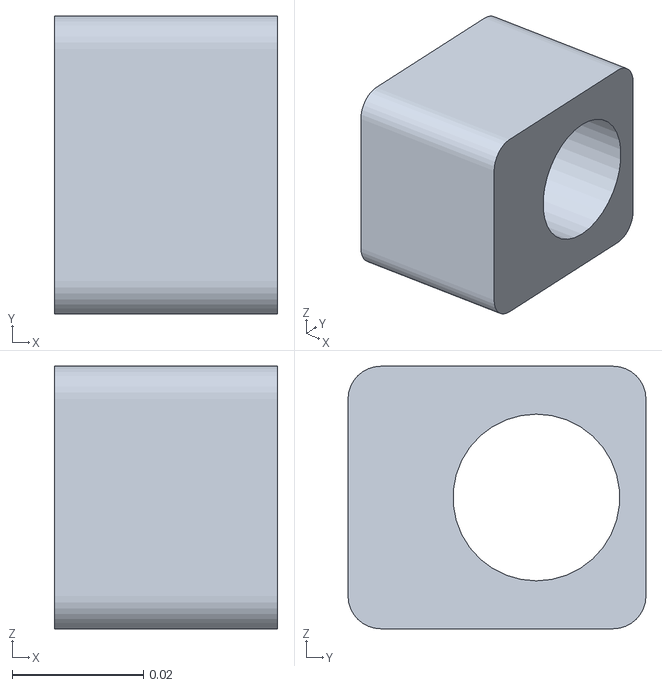
[picture p102: CAD file, 2026-11-04]
inventory/v031/cad/mesh/Gear_Clamp.STL
0.034 x 0.0454 x 0.04
