davinciucberkeley-collab/DBF-VTOL/cad/mesh/Battery_Tray.STL

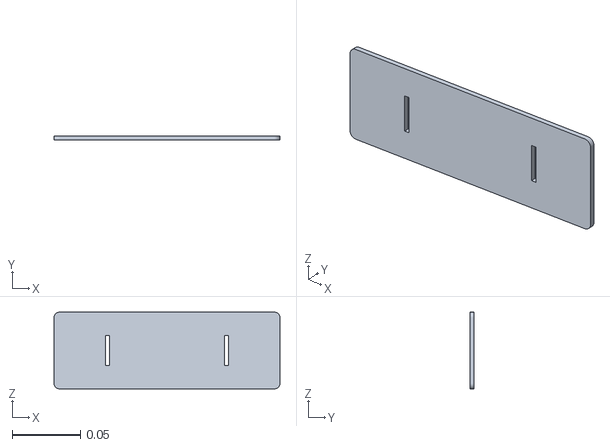
[picture p103: CAD file, 2026-11-04]
cad/mesh/Battery_Tray.STL
0.165 x 0.003 x 0.056
