davinciucberkeley-collab/DBF-VTOL/cad/model/Fin_Shoe.SLDPRT

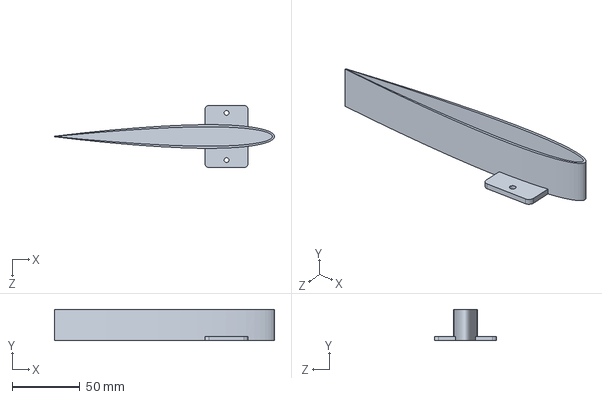
[picture p104: CAD file, 2026-11-04]
cad/model/Fin_Shoe.SLDPRT
162.9 x 23.0 x 46.0 mm
