davinciucberkeley-collab/DBF-VTOL/concepts/variants/a1/fusion/stl/Tip_Connectors_L.stl

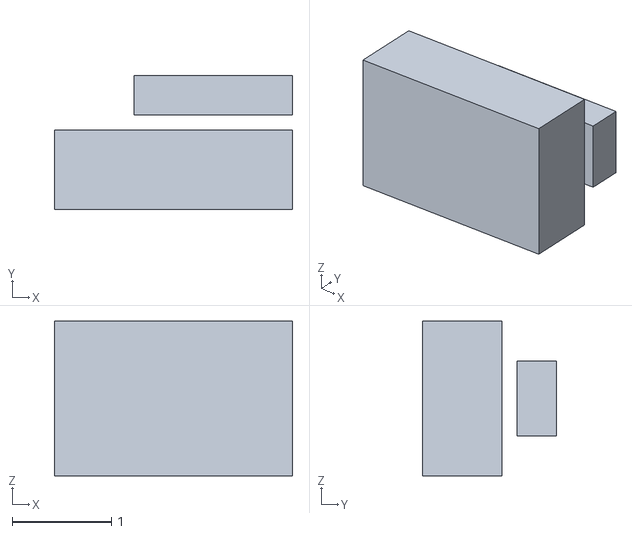
[picture p105: CAD file, 2026-11-03]
concepts/variants/a1/fusion/stl/Tip_Connectors_L.stl
2.40 x 1.35 x 1.56
