davinciucberkeley-collab/DBF-VTOL/concepts/variants/a2/fusion/stl/RID1.stl

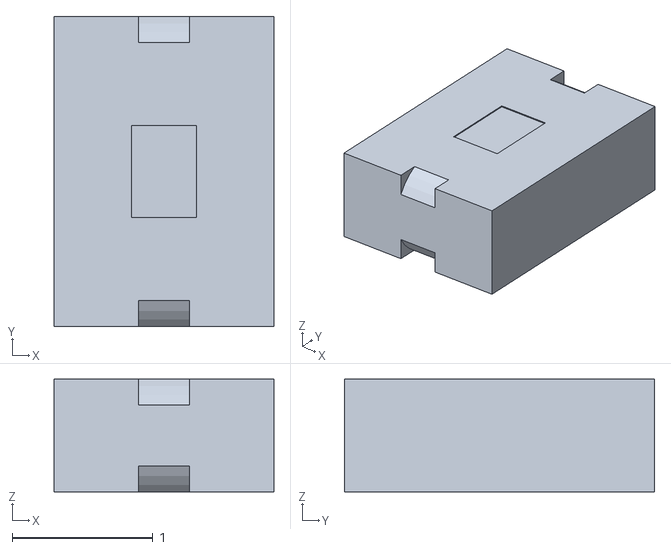
[picture p106: CAD file, 2026-11-03]
concepts/variants/a2/fusion/stl/RID1.stl
1.56 x 2.20 x 0.8
