davinciucberkeley-collab/DBF-VTOL/concepts/variants/a3/fusion/stl/Reed_L2.stl

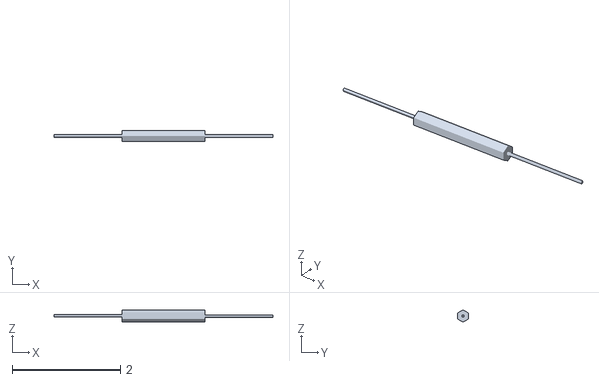
[picture p107: CAD file, 2026-11-03]
concepts/variants/a3/fusion/stl/Reed_L2.stl
4.04 x 0.197 x 0.228
