davinciucberkeley-collab/DBF-VTOL/inventory/fusion/kinematics/Arm_Aileron_R.stl

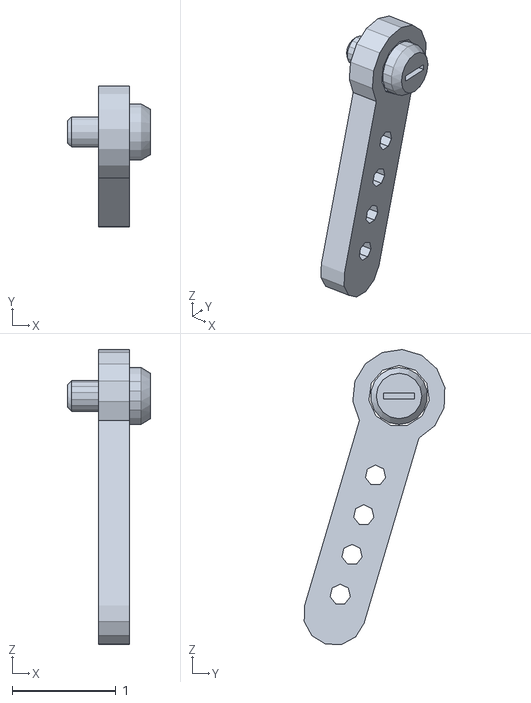
[picture p108: CAD file, 2026-11-02]
inventory/fusion/kinematics/Arm_Aileron_R.stl
0.8 x 1.36 x 2.85
