davinciucberkeley-collab/DBF-VTOL/inventory/fusion/stl/J-16_Tail_fin_and_R.stl

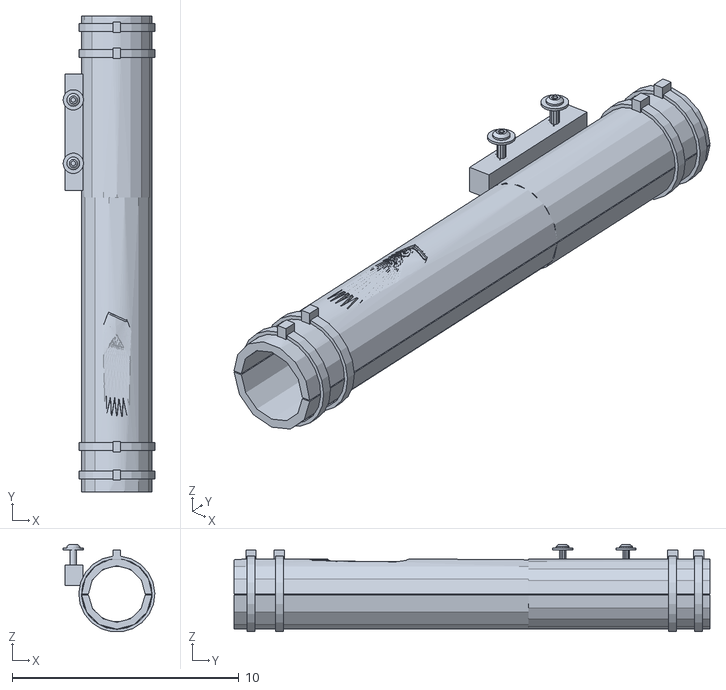
[picture p109: CAD file, 2026-11-02]
inventory/fusion/stl/J-16_Tail_fin_and_R.stl
4.05 x 21.0 x 3.86
