davinciucberkeley-collab/DBF-VTOL/inventory/v031/cad/mesh/Pitot_Tube.STL

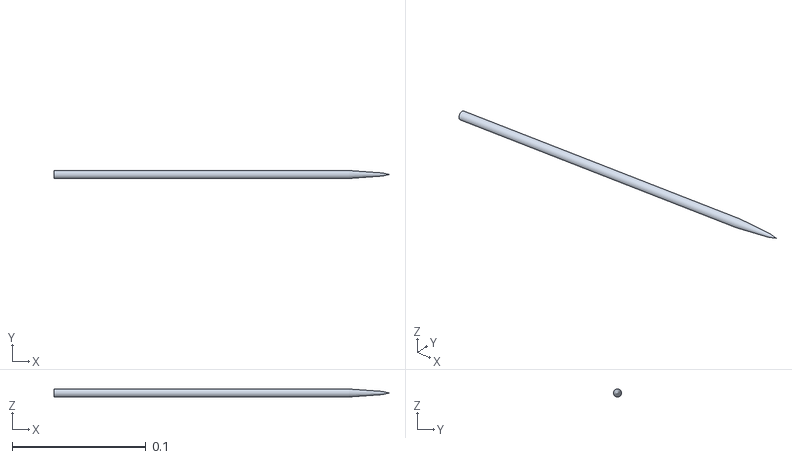
[picture p110: CAD file, 2026-11-04]
inventory/v031/cad/mesh/Pitot_Tube.STL
0.25 x 0.00597 x 0.006
