davinciucberkeley-collab/DBF-VTOL/cad/mesh/Lift_Motor.STL

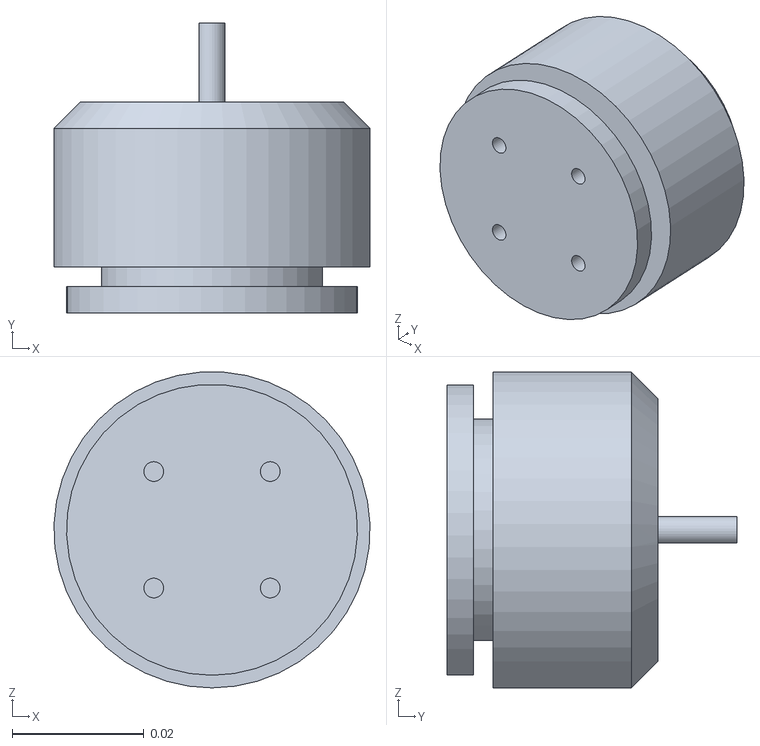
[picture p111: CAD file, 2026-11-04]
cad/mesh/Lift_Motor.STL
0.048 x 0.044 x 0.0479
