davinciucberkeley-collab/DBF-VTOL/cad/model/Boom_Rear_Stub.SLDPRT

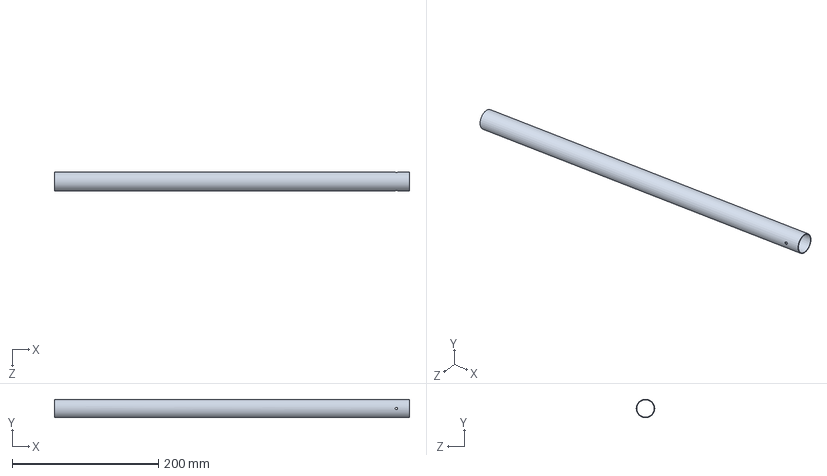
[picture p112: CAD file, 2026-11-04]
cad/model/Boom_Rear_Stub.SLDPRT
485.9 x 25.3 x 25.4 mm
