davinciucberkeley-collab/DBF-VTOL/concepts/variants/a1/fusion/stl/Pod_Aft_Cap.stl

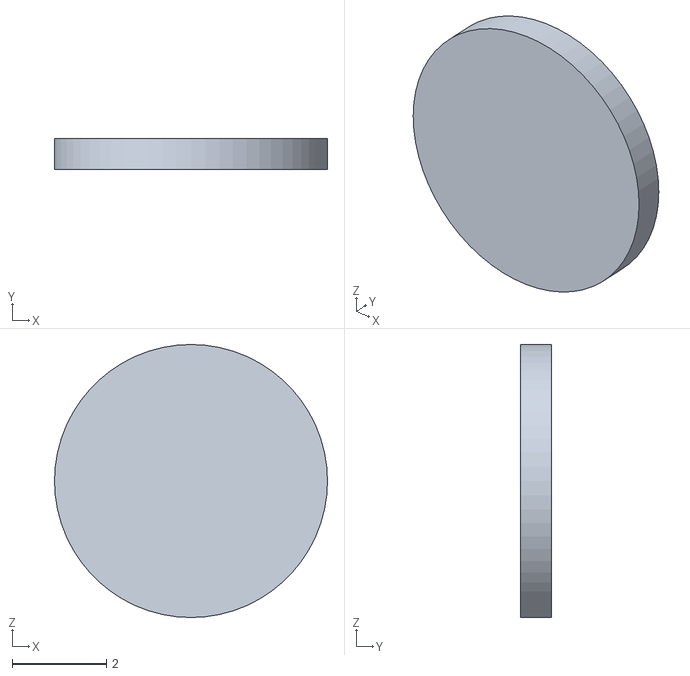
[picture p113: CAD file, 2026-11-03]
concepts/variants/a1/fusion/stl/Pod_Aft_Cap.stl
5.80 x 0.65 x 5.80
