davinciucberkeley-collab/DBF-VTOL/concepts/variants/a2/fusion/stl/XT90S_1.stl

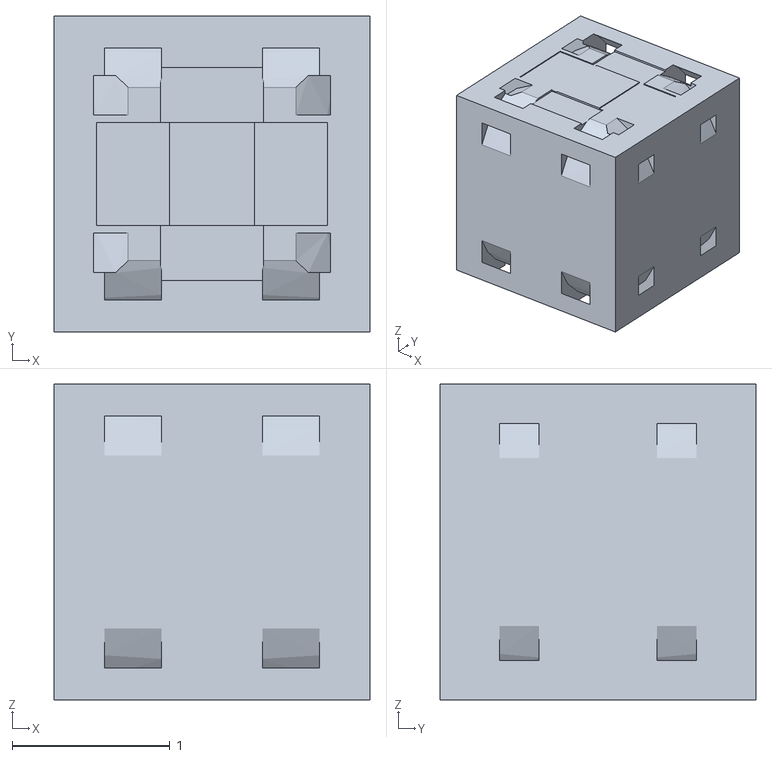
[picture p114: CAD file, 2026-11-03]
concepts/variants/a2/fusion/stl/XT90S_1.stl
2.00 x 2.00 x 2.00
