davinciucberkeley-collab/DBF-VTOL/concepts/variants/a3/fusion/stl/Reed_Wire_L1.stl

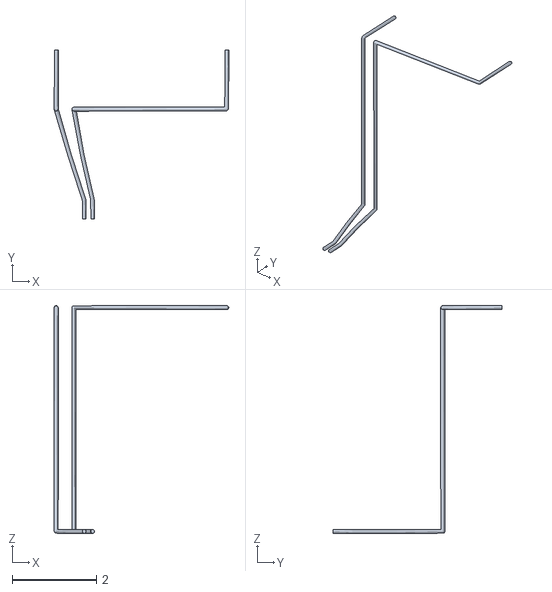
[picture p115: CAD file, 2026-11-03]
concepts/variants/a3/fusion/stl/Reed_Wire_L1.stl
4.14 x 4.00 x 5.40
