davinciucberkeley-collab/DBF-VTOL/inventory/fusion/kinematics/Pushrod_Aileron_L.stl

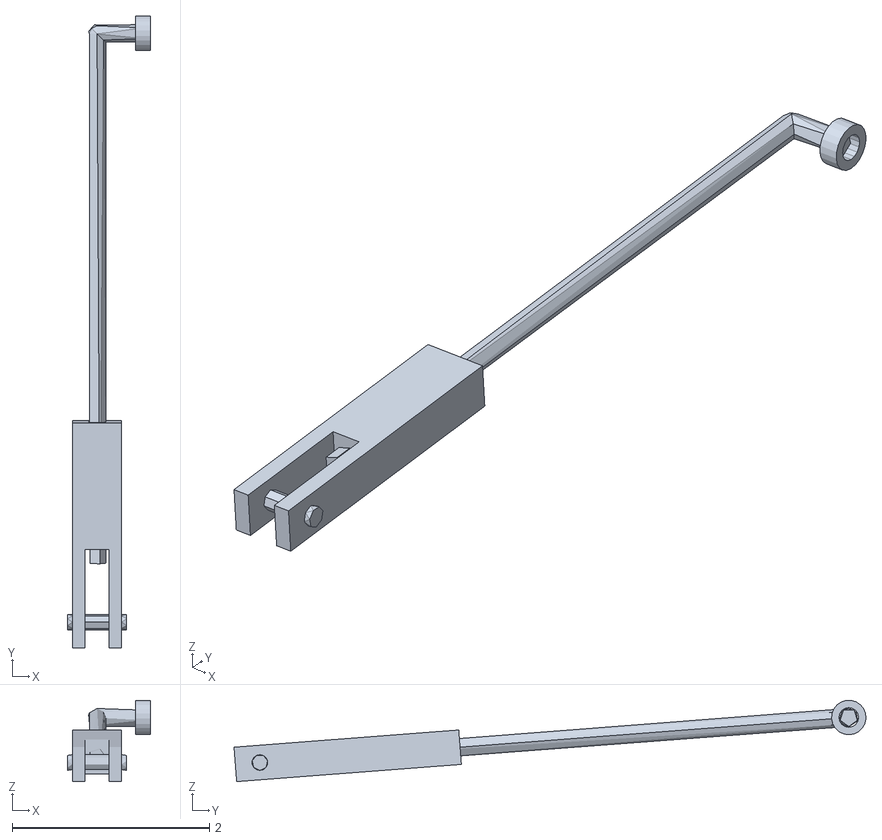
[picture p116: CAD file, 2026-11-02]
inventory/fusion/kinematics/Pushrod_Aileron_L.stl
0.842 x 6.41 x 0.824
