davinciucberkeley-collab/DBF-VTOL/inventory/fusion/stl/J-16_Tail_fin_and_L.stl

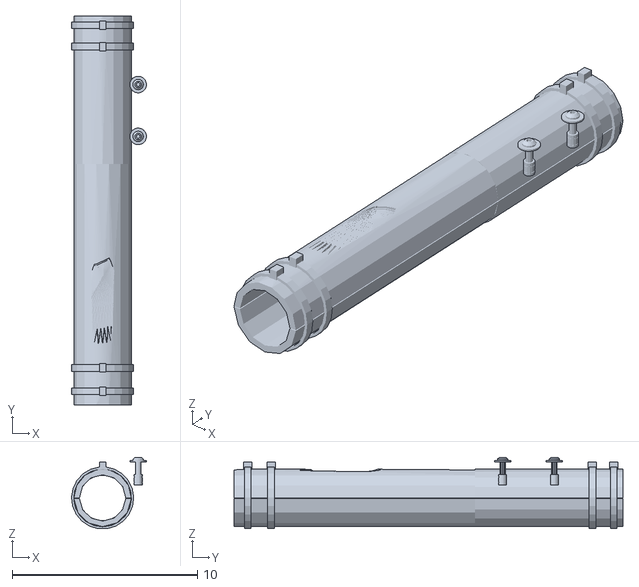
[picture p117: CAD file, 2026-11-02]
inventory/fusion/stl/J-16_Tail_fin_and_L.stl
4.05 x 21.0 x 3.86
