davinciucberkeley-collab/DBF-VTOL/inventory/v031/cad/mesh/Wing_Panel_R.STL

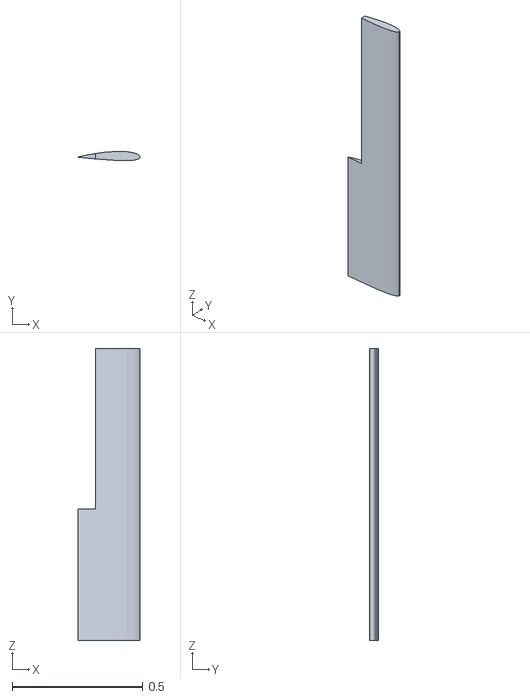
[picture p118: CAD file, 2026-11-04]
inventory/v031/cad/mesh/Wing_Panel_R.STL
0.239 x 0.036 x 1.12
