davinciucberkeley-collab/DBF-VTOL/cad/mesh/Spar_Collar.STL

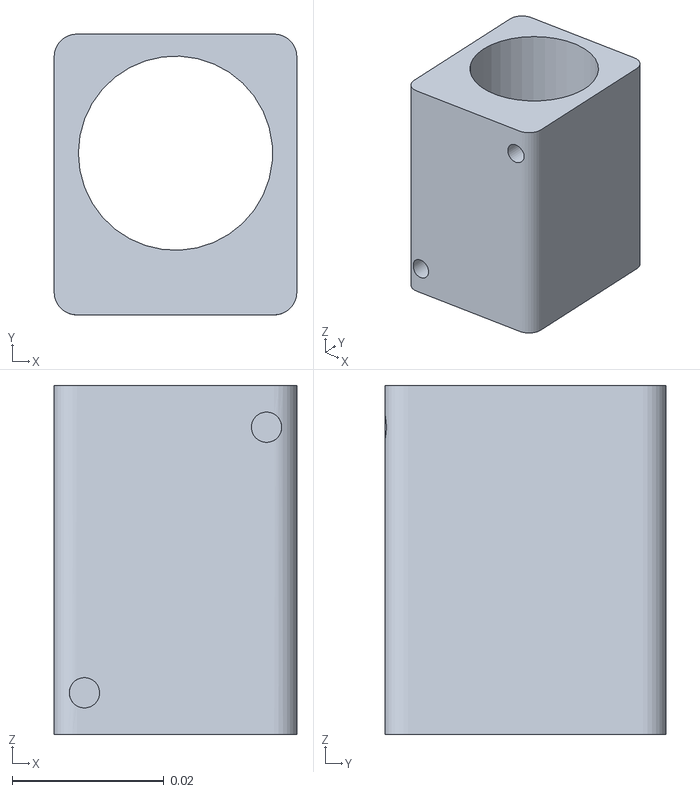
[picture p119: CAD file, 2026-11-04]
cad/mesh/Spar_Collar.STL
0.032 x 0.037 x 0.046
