davinciucberkeley-collab/DBF-VTOL/cad/model/Tail_Clamp_Cap.SLDPRT

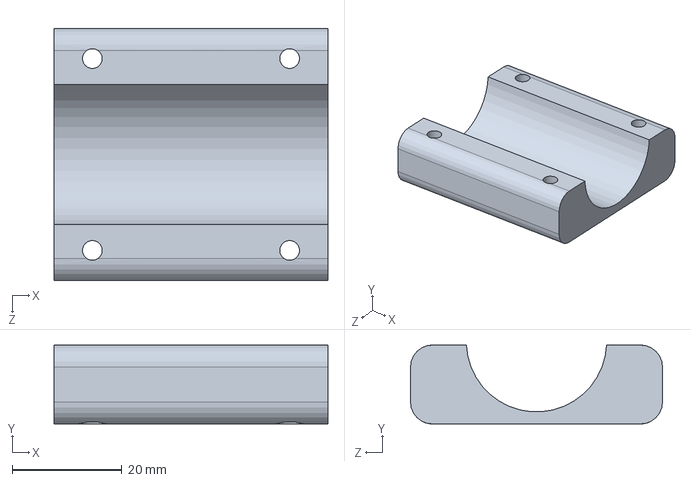
[picture p120: CAD file, 2026-11-04]
cad/model/Tail_Clamp_Cap.SLDPRT
50.0 x 14.4 x 46.0 mm
