davinciucberkeley-collab/DBF-VTOL/concepts/variants/a3/fusion/stl/Reed_Wire_L2.stl

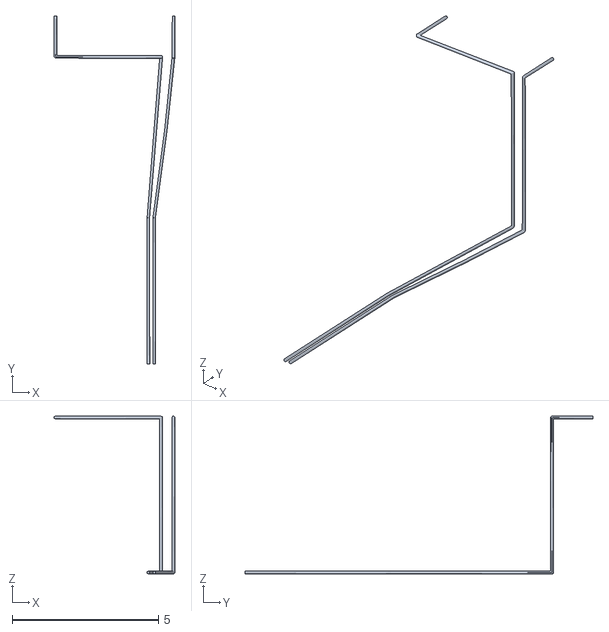
[picture p121: CAD file, 2026-11-03]
concepts/variants/a3/fusion/stl/Reed_Wire_L2.stl
4.13 x 11.9 x 5.40
