davinciucberkeley-collab/DBF-VTOL/inventory/fusion/kinematics/Wheel_RL.stl

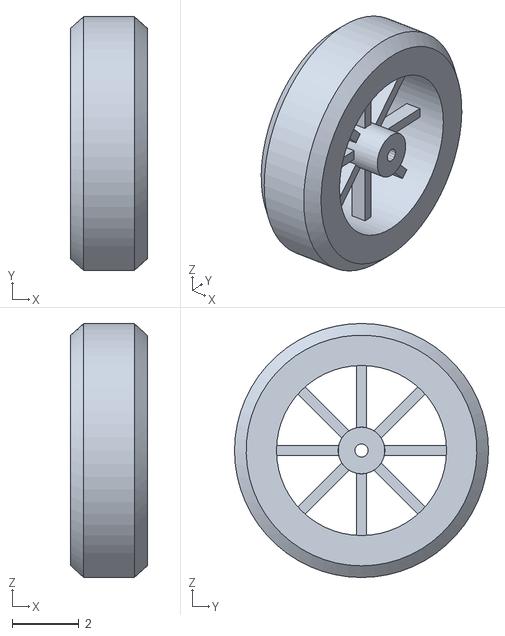
[picture p122: CAD file, 2026-11-02]
inventory/fusion/kinematics/Wheel_RL.stl
2.30 x 7.62 x 7.62
