davinciucberkeley-collab/DBF-VTOL/inventory/fusion/stl/J-29_ESC_mounting_lift_L.stl

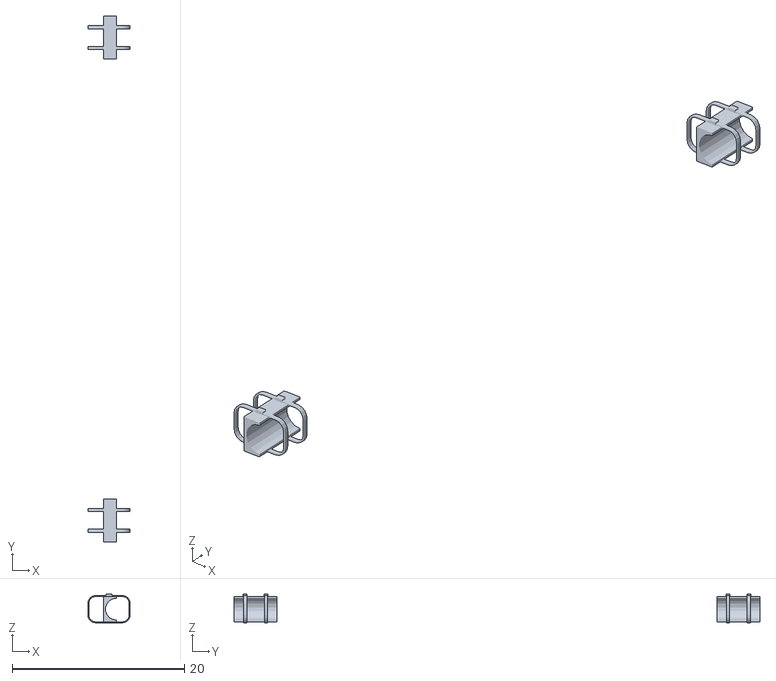
[picture p123: CAD file, 2026-11-02]
inventory/fusion/stl/J-29_ESC_mounting_lift_L.stl
4.91 x 61.0 x 3.34
