davinciucberkeley-collab/DBF-VTOL/inventory/v031/cad/mesh/Aileron_R.STL

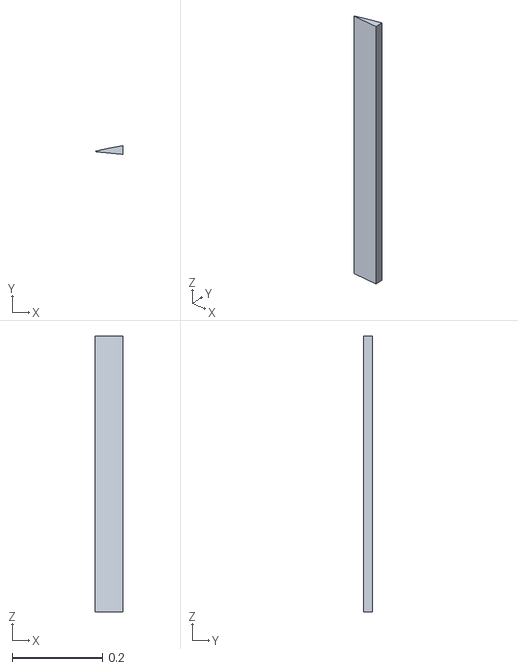
[picture p124: CAD file, 2026-11-04]
inventory/v031/cad/mesh/Aileron_R.STL
0.0621 x 0.0195 x 0.612
