davinciucberkeley-collab/DBF-VTOL/cad/mesh/Flight_Controller.STL

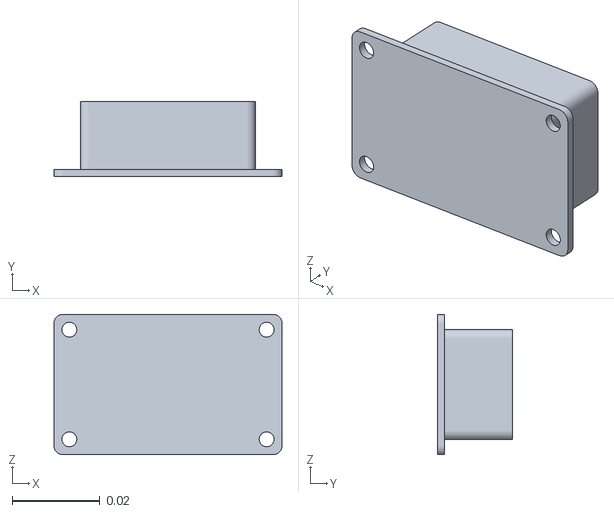
[picture p125: CAD file, 2026-11-04]
cad/mesh/Flight_Controller.STL
0.052 x 0.017 x 0.032
