davinciucberkeley-collab/DBF-VTOL/cad/model/Battery_Tray.SLDPRT

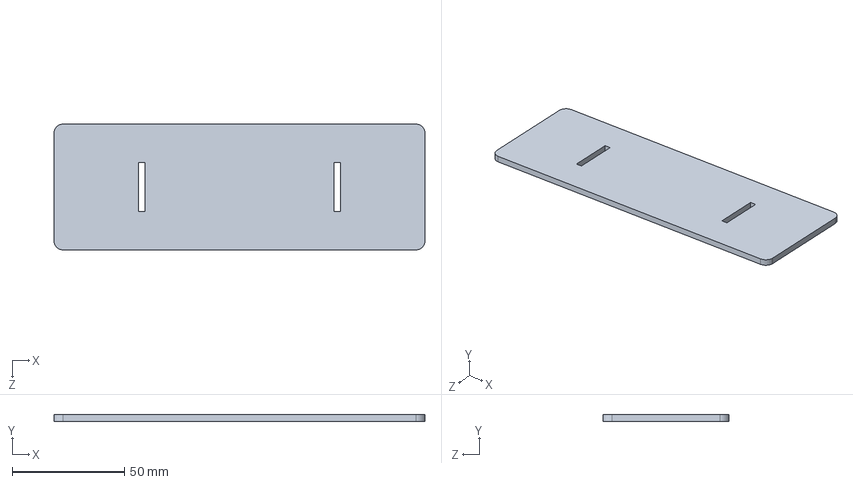
[picture p126: CAD file, 2026-11-04]
cad/model/Battery_Tray.SLDPRT
165.0 x 3.00 x 56.0 mm
