davinciucberkeley-collab/DBF-VTOL/concepts/variants/a2/fusion/stl/Fuselage_Pod.stl

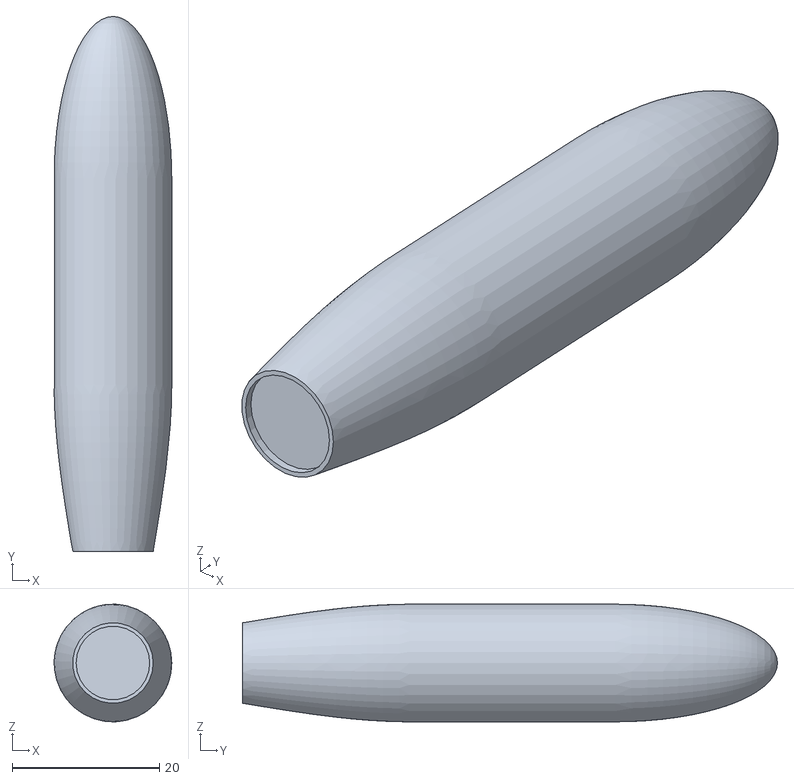
[picture p127: CAD file, 2026-11-03]
concepts/variants/a2/fusion/stl/Fuselage_Pod.stl
16.0 x 72.7 x 16.0
