davinciucberkeley-collab/DBF-VTOL/concepts/variants/a3/fusion/kinematics/Lift_Cap_L1.stl

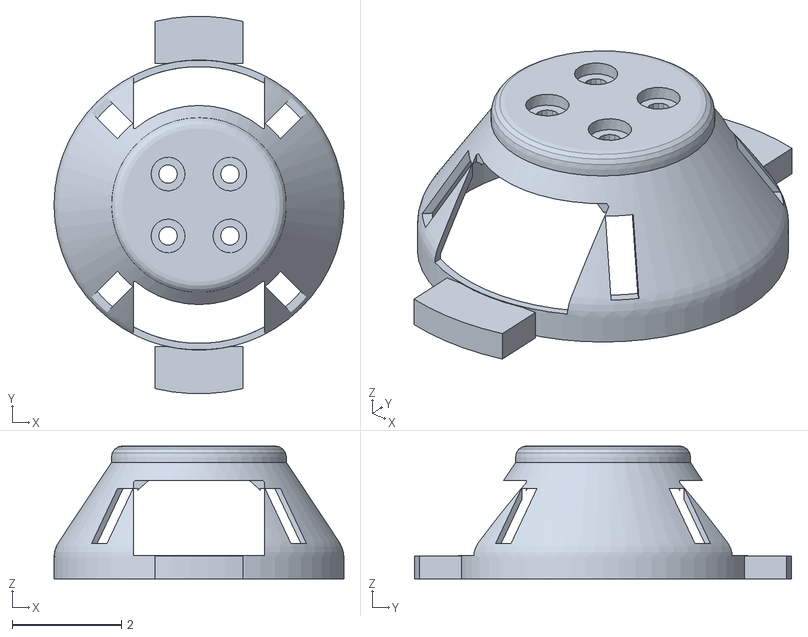
[picture p128: CAD file, 2026-11-03]
concepts/variants/a3/fusion/kinematics/Lift_Cap_L1.stl
5.30 x 6.89 x 2.43
