davinciucberkeley-collab/DBF-VTOL/concepts/variants/a3/fusion/stl/Magnet_Fix_L2.stl

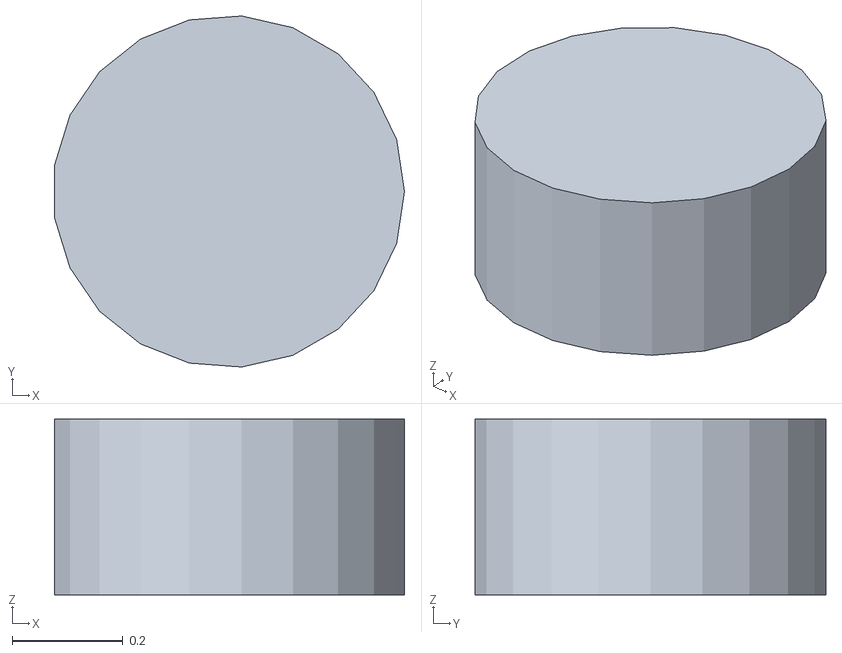
[picture p129: CAD file, 2026-11-03]
concepts/variants/a3/fusion/stl/Magnet_Fix_L2.stl
0.631 x 0.633 x 0.317
