davinciucberkeley-collab/DBF-VTOL/inventory/fusion/stl/JB_J1_L.stl

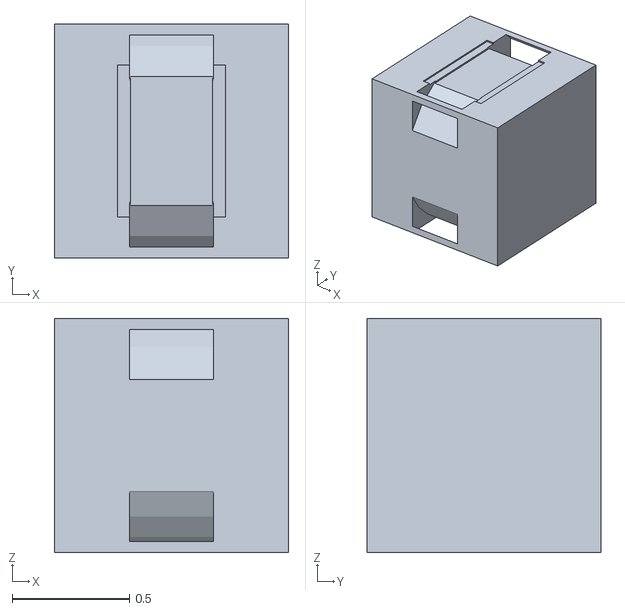
[picture p130: CAD file, 2026-11-02]
inventory/fusion/stl/JB_J1_L.stl
1.00 x 1.00 x 1.00
