davinciucberkeley-collab/DBF-VTOL/inventory/v031/cad/mesh/Landing_Leg.STL

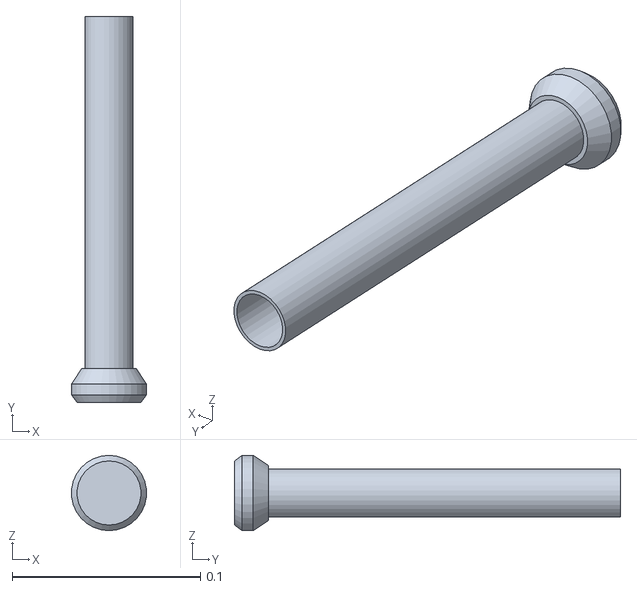
[picture p131: CAD file, 2026-11-04]
inventory/v031/cad/mesh/Landing_Leg.STL
0.0398 x 0.205 x 0.04
