davinciucberkeley-collab/DBF-VTOL/cad/mesh/Pushrod_Aileron.STL

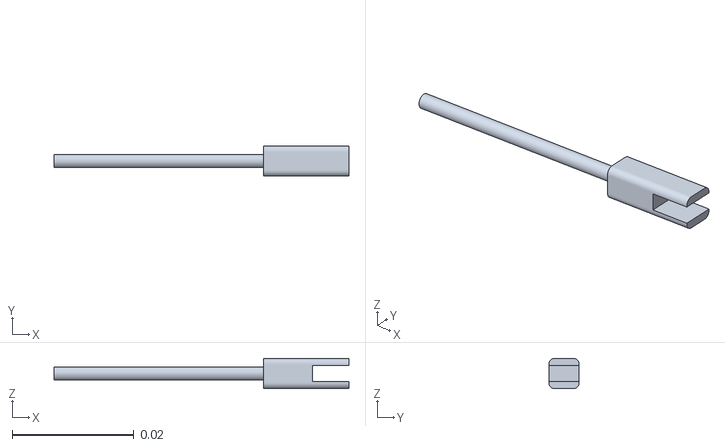
[picture p132: CAD file, 2026-11-04]
cad/mesh/Pushrod_Aileron.STL
0.0484 x 0.005 x 0.005
