davinciucberkeley-collab/DBF-VTOL/concepts/variants/a2/fusion/stl/Tail_connectors.stl

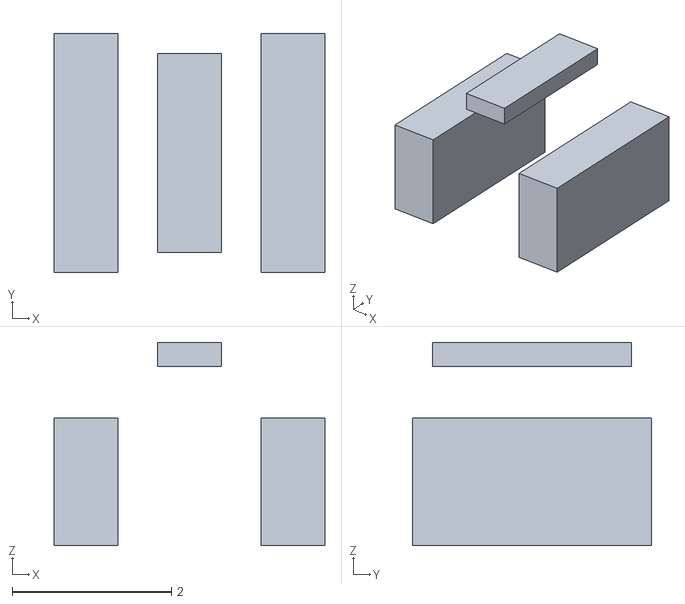
[picture p134: CAD file, 2026-11-03]
concepts/variants/a2/fusion/stl/Tail_connectors.stl
3.40 x 3.00 x 2.55
