davinciucberkeley-collab/DBF-VTOL/inventory/fusion/kinematics/Lift_Prop_L2.stl

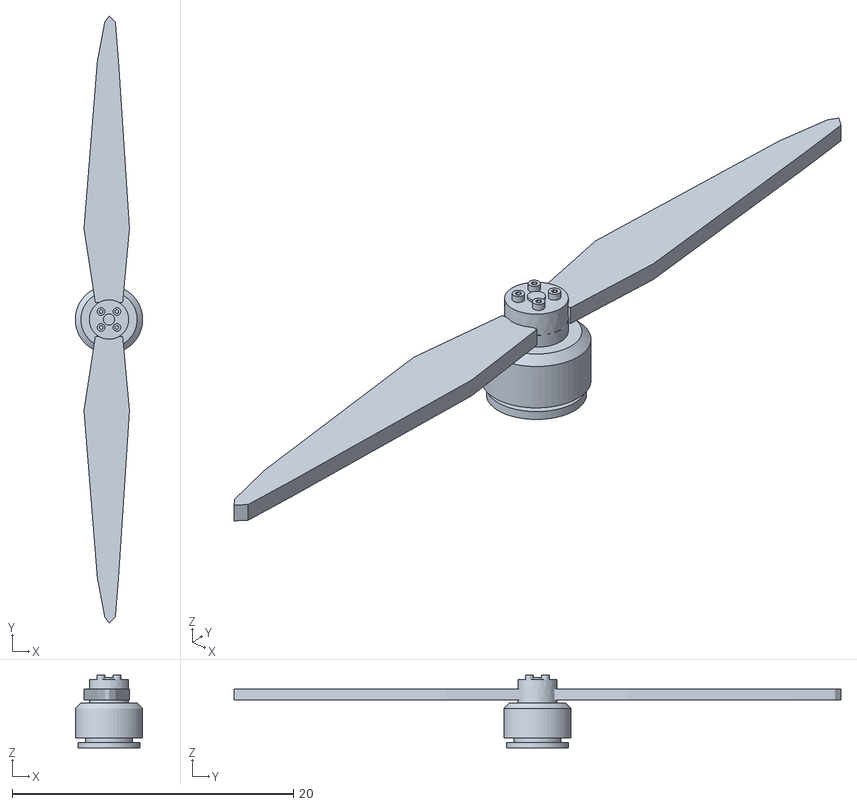
[picture p135: CAD file, 2026-11-02]
inventory/fusion/kinematics/Lift_Prop_L2.stl
4.79 x 43.2 x 5.18
