davinciucberkeley-collab/DBF-VTOL/inventory/fusion/stl/Hinge_Elevator.stl

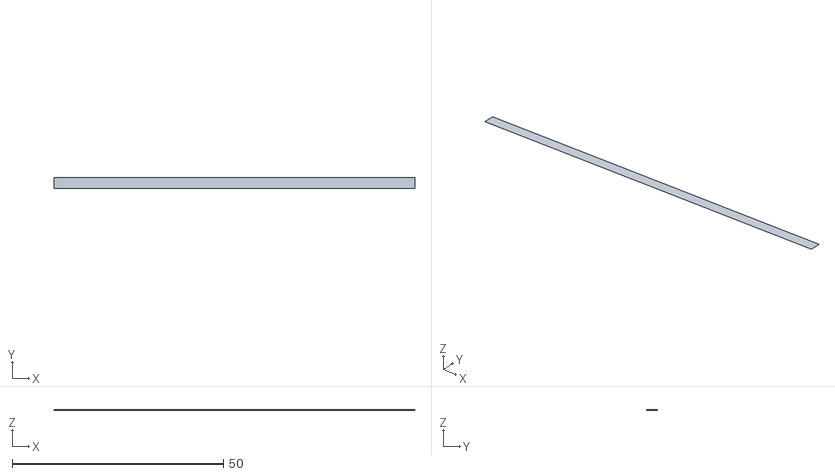
[picture p136: CAD file, 2026-11-02]
inventory/fusion/stl/Hinge_Elevator.stl
85.5 x 2.54 x 0.02
