davinciucberkeley-collab/DBF-VTOL/inventory/v031/cad/mesh/Battery_6S_LiPo.STL

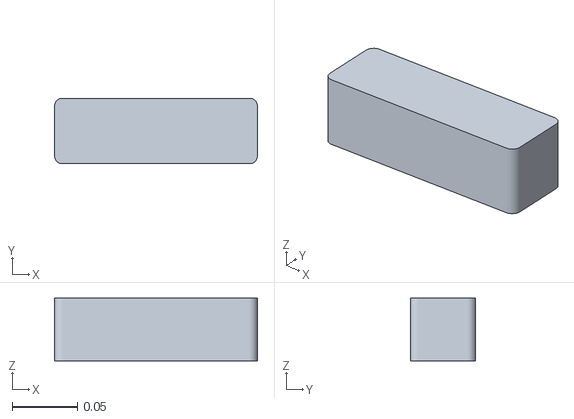
[picture p137: CAD file, 2026-11-04]
inventory/v031/cad/mesh/Battery_6S_LiPo.STL
0.155 x 0.05 x 0.048
