davinciucberkeley-collab/DBF-VTOL/cad/mesh/F02_M3x16_SHCS.STL

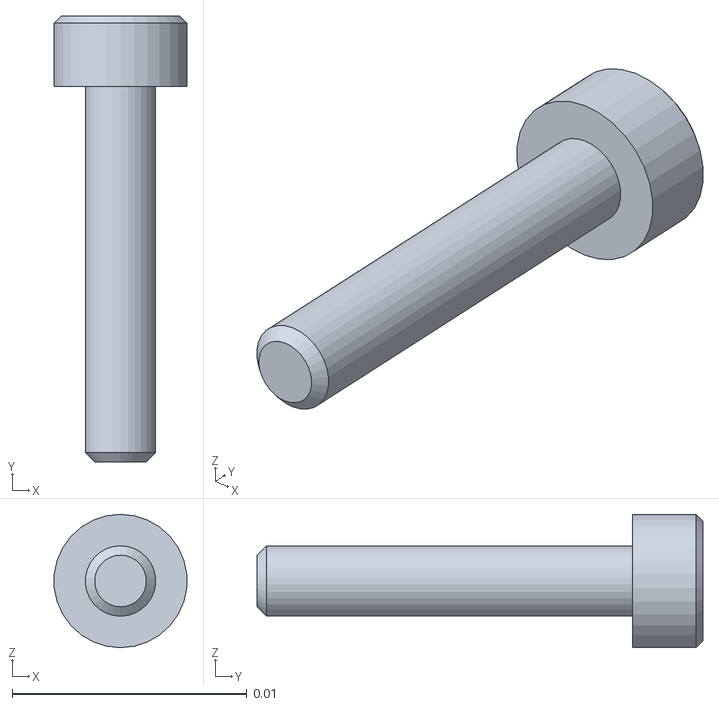
[picture p138: CAD file, 2026-11-04]
cad/mesh/F02_M3x16_SHCS.STL
0.00565 x 0.019 x 0.00568
