davinciucberkeley-collab/DBF-VTOL/cad/model/Pushrod_Aileron.SLDPRT

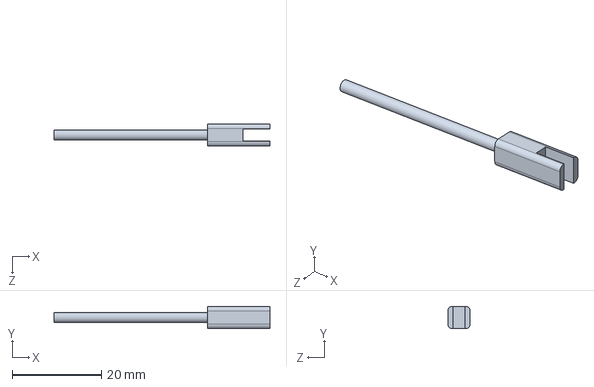
[picture p139: CAD file, 2026-11-04]
cad/model/Pushrod_Aileron.SLDPRT
48.4 x 5.00 x 5.00 mm
