davinciucberkeley-collab/DBF-VTOL/concepts/variants/a1/fusion/stl/Pitot_Tube.stl

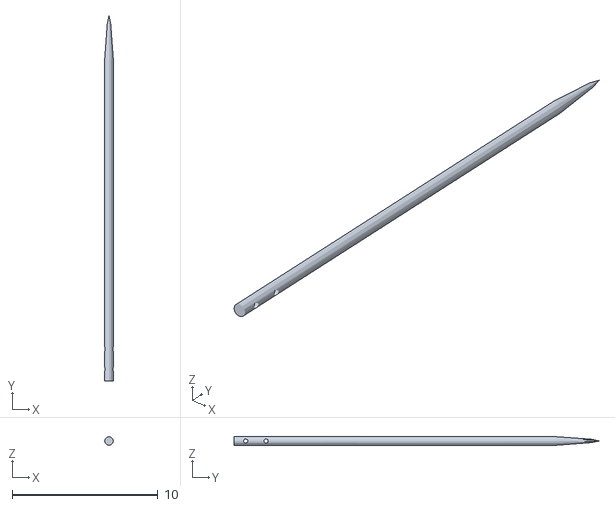
[picture p140: CAD file, 2026-11-03]
concepts/variants/a1/fusion/stl/Pitot_Tube.stl
0.6 x 25.0 x 0.6
