davinciucberkeley-collab/DBF-VTOL/concepts/variants/a2/fusion/stl/W15x_phase_extension.stl

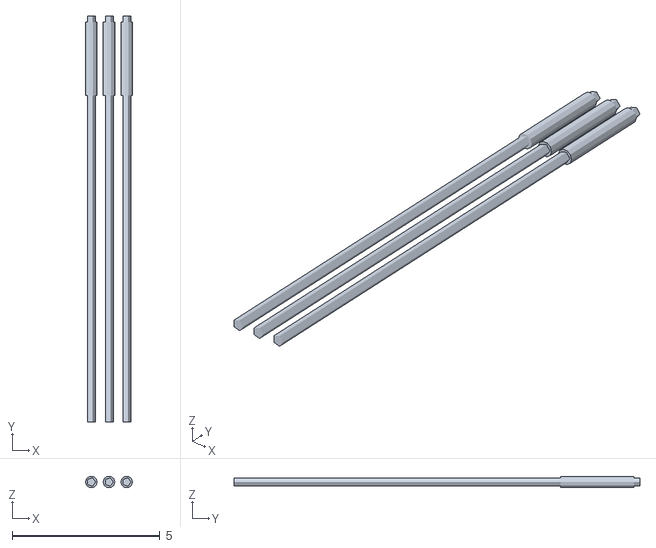
[picture p141: CAD file, 2026-11-03]
concepts/variants/a2/fusion/stl/W15x_phase_extension.stl
1.60 x 13.8 x 0.38
