davinciucberkeley-collab/DBF-VTOL/inventory/fusion/kinematics/Pushrod_Rudder_L.stl

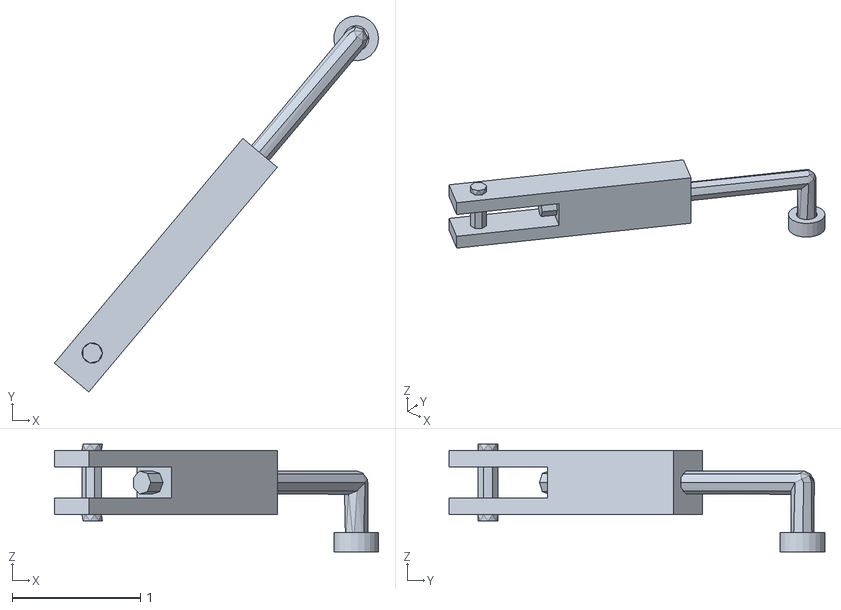
[picture p142: CAD file, 2026-11-02]
inventory/fusion/kinematics/Pushrod_Rudder_L.stl
2.53 x 2.93 x 0.841
