davinciucberkeley-collab/DBF-VTOL/inventory/fusion/stl/J-05_Rear_boom_clamp_R.stl

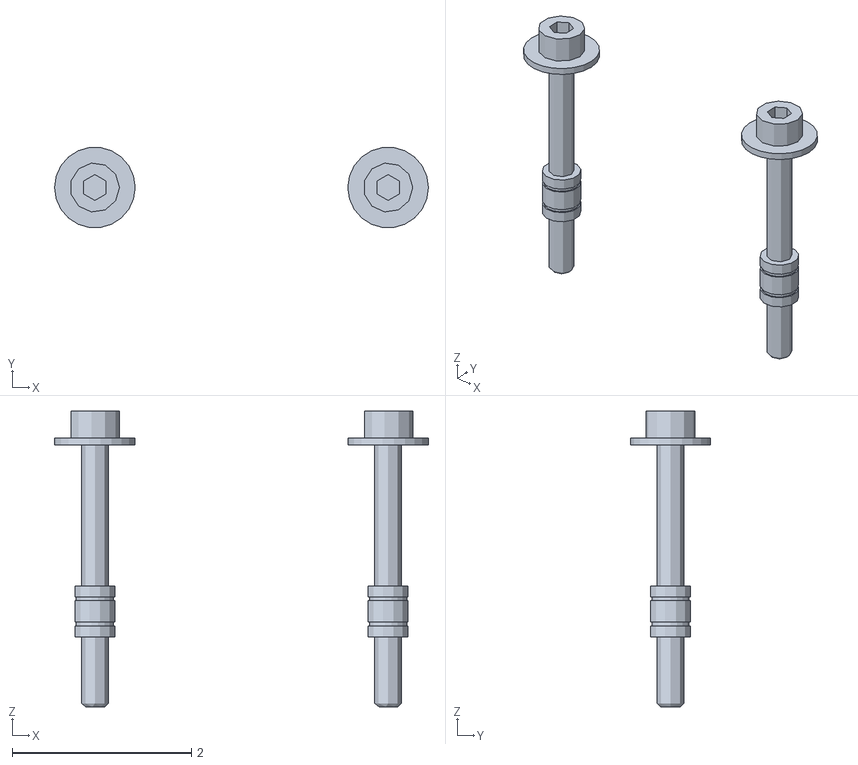
[picture p143: CAD file, 2026-11-02]
inventory/fusion/stl/J-05_Rear_boom_clamp_R.stl
4.17 x 0.891 x 3.30
