davinciucberkeley-collab/DBF-VTOL/inventory/v031/cad/mesh/Boom_Rear_Stub.STL

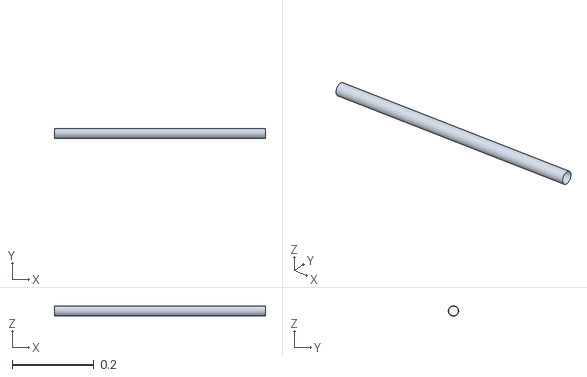
[picture p144: CAD file, 2026-11-04]
inventory/v031/cad/mesh/Boom_Rear_Stub.STL
0.516 x 0.0253 x 0.0254
