davinciucberkeley-collab/DBF-VTOL/cad/mesh/Boom_Rear_Stub.STL

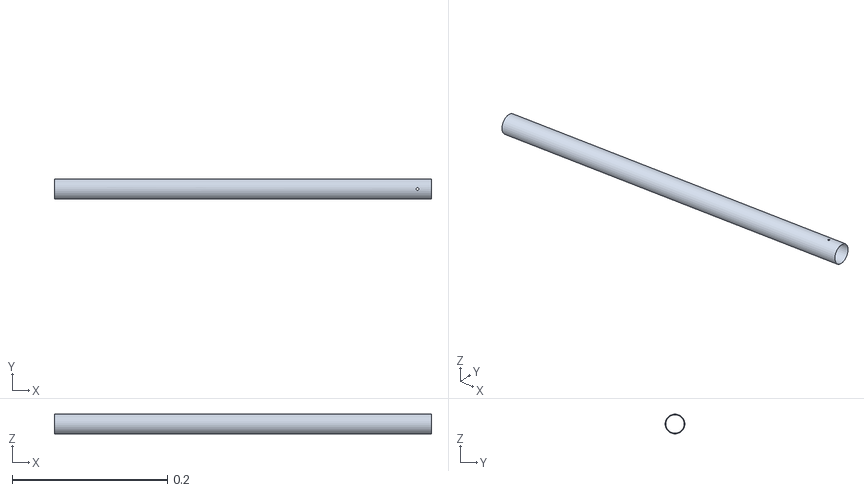
[picture p145: CAD file, 2026-11-04]
cad/mesh/Boom_Rear_Stub.STL
0.486 x 0.0253 x 0.0254
