davinciucberkeley-collab/DBF-VTOL/concepts/variants/a1/fusion/stl/W_TIP_R_pod.stl

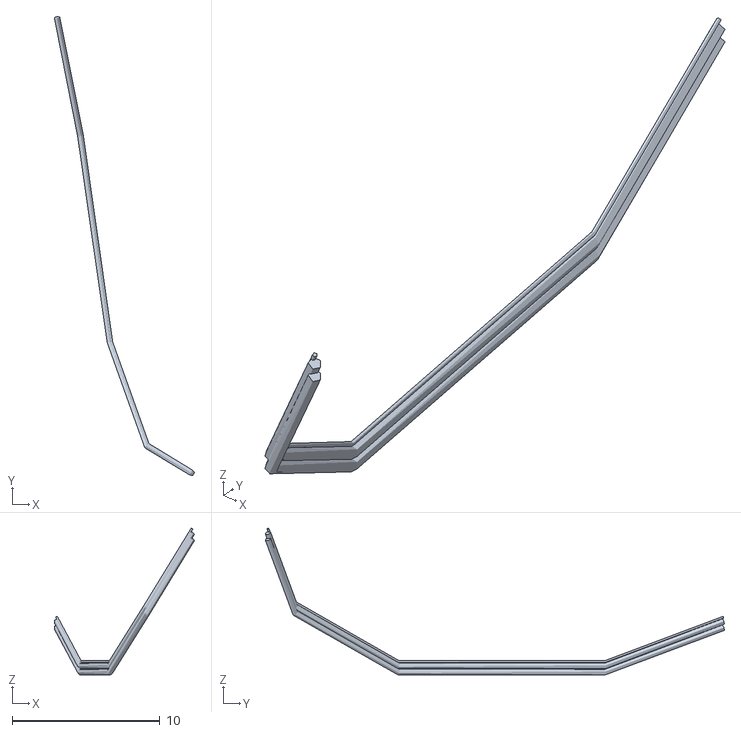
[picture p147: CAD file, 2026-11-03]
concepts/variants/a1/fusion/stl/W_TIP_R_pod.stl
9.48 x 31.1 x 9.95
