davinciucberkeley-collab/DBF-VTOL/concepts/variants/a2/fusion/stl/J-29_ESC_mounting_lift_ESCs_on_boom_outboard_faces__C_.stl

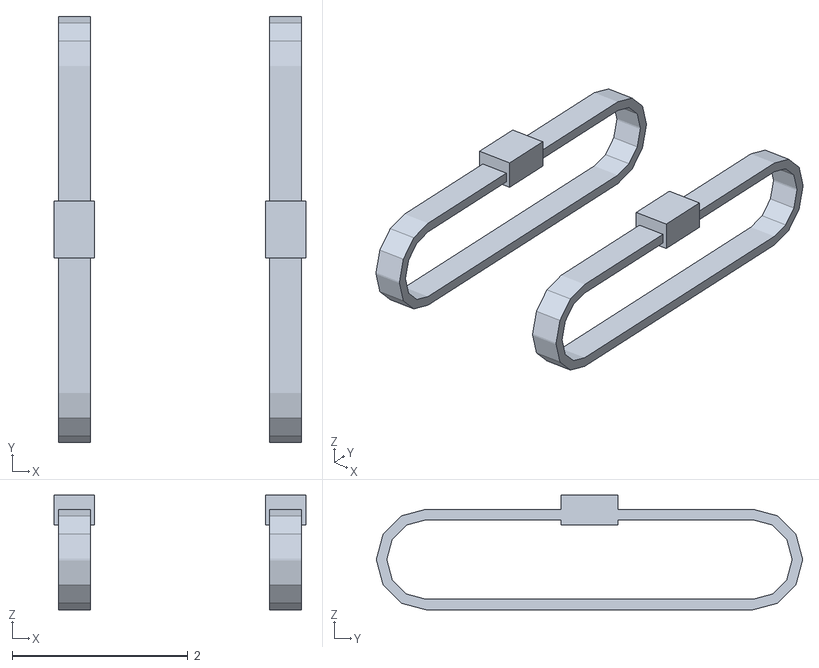
[picture p148: CAD file, 2026-11-03]
concepts/variants/a2/fusion/stl/J-29_ESC_mounting_lift_ESCs_on_boom_outboard_faces__C_.stl
2.86 x 4.84 x 1.30
