davinciucberkeley-collab/DBF-VTOL/inventory/fusion/kinematics/Arm_Rudder_R.stl

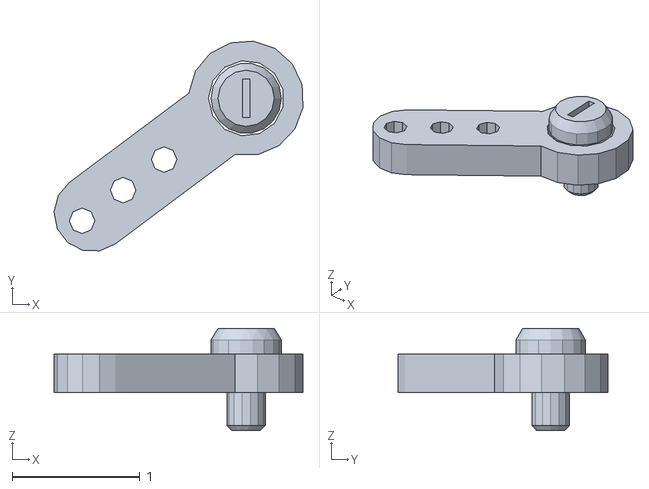
[picture p149: CAD file, 2026-11-02]
inventory/fusion/kinematics/Arm_Rudder_R.stl
1.95 x 1.64 x 0.8
