davinciucberkeley-collab/DBF-VTOL/inventory/fusion/stl/ESC_L4.stl

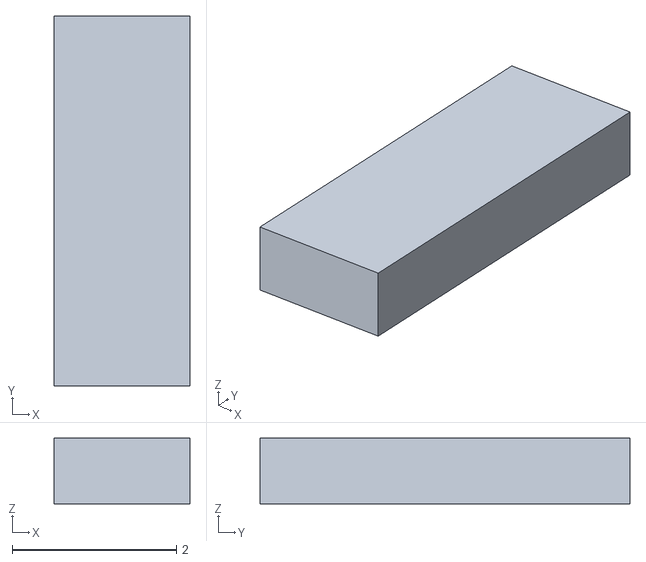
[picture p150: CAD file, 2026-11-02]
inventory/fusion/stl/ESC_L4.stl
1.65 x 4.50 x 0.8
