davinciucberkeley-collab/DBF-VTOL/inventory/v031/cad/mesh/Fin.STL

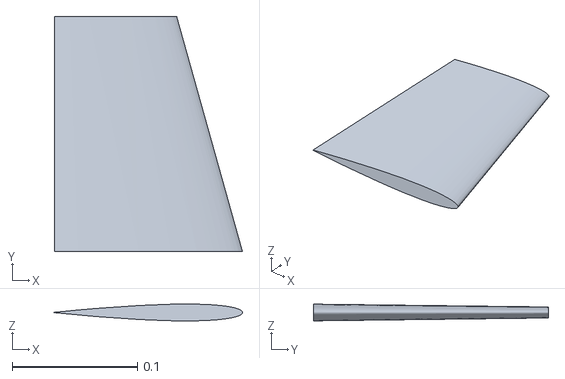
[picture p151: CAD file, 2026-11-04]
inventory/v031/cad/mesh/Fin.STL
0.15 x 0.188 x 0.0134
