davinciucberkeley-collab/DBF-VTOL/cad/mesh/N01_M3_Nylock.STL

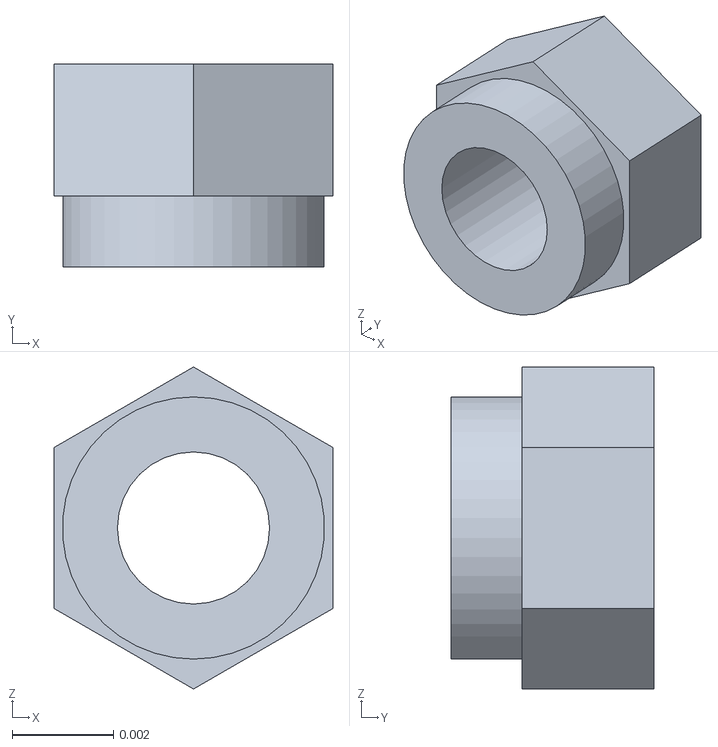
[picture p152: CAD file, 2026-11-04]
cad/mesh/N01_M3_Nylock.STL
0.0055 x 0.004 x 0.00635
