davinciucberkeley-collab/DBF-VTOL/cad/model/Wing_Joiner.SLDPRT

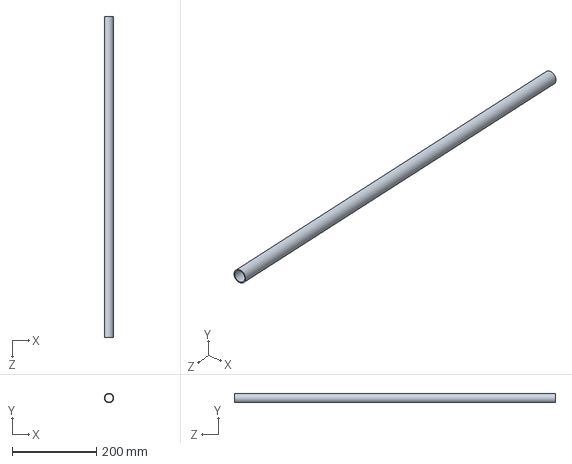
[picture p153: CAD file, 2026-11-04]
cad/model/Wing_Joiner.SLDPRT
22.2 x 22.1 x 760.0 mm
