davinciucberkeley-collab/DBF-VTOL/concepts/variants/a2/fusion/stl/J-28_RX_Remote_ID_UBEC_BUS1_XT90S_airspeed_module_c__C_.stl

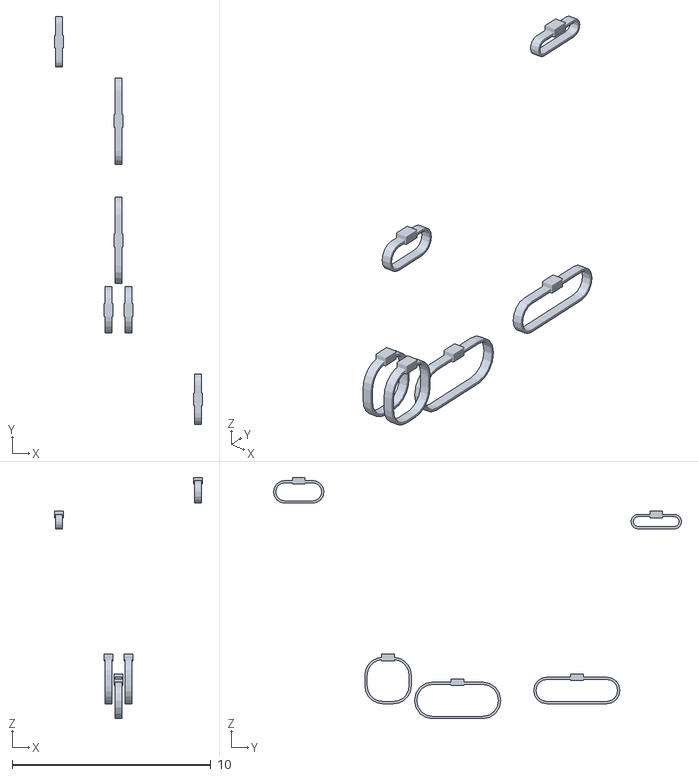
[picture p154: CAD file, 2026-11-03]
concepts/variants/a2/fusion/stl/J-28_RX_Remote_ID_UBEC_BUS1_XT90S_airspeed_module_c__C_.stl
7.46 x 20.5 x 12.2
