davinciucberkeley-collab/DBF-VTOL/concepts/variants/a3/fusion/kinematics/Magnet_Rot_L1.stl

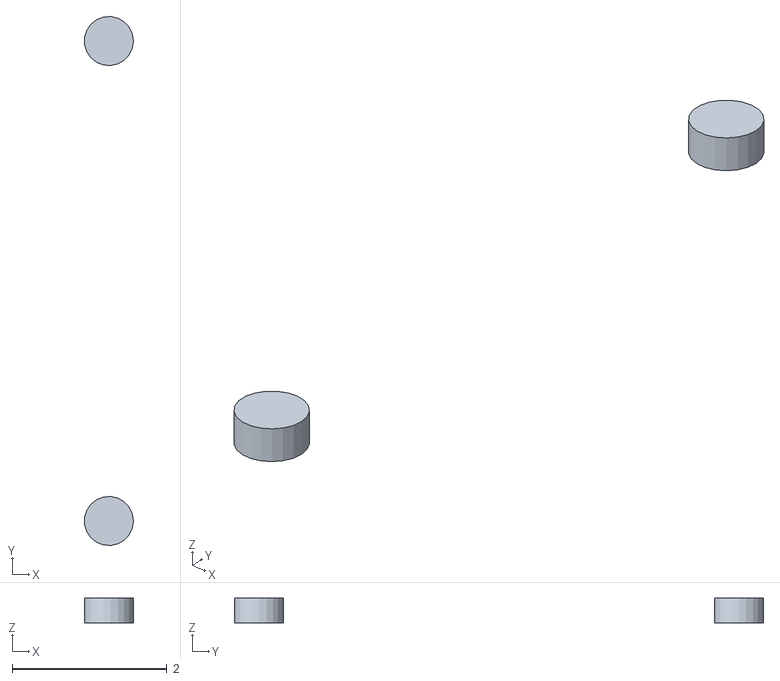
[picture p155: CAD file, 2026-11-03]
concepts/variants/a3/fusion/kinematics/Magnet_Rot_L1.stl
0.631 x 6.83 x 0.317
