davinciucberkeley-collab/DBF-VTOL/inventory/fusion/stl/J-02_Wing_saddle_pod_R.stl

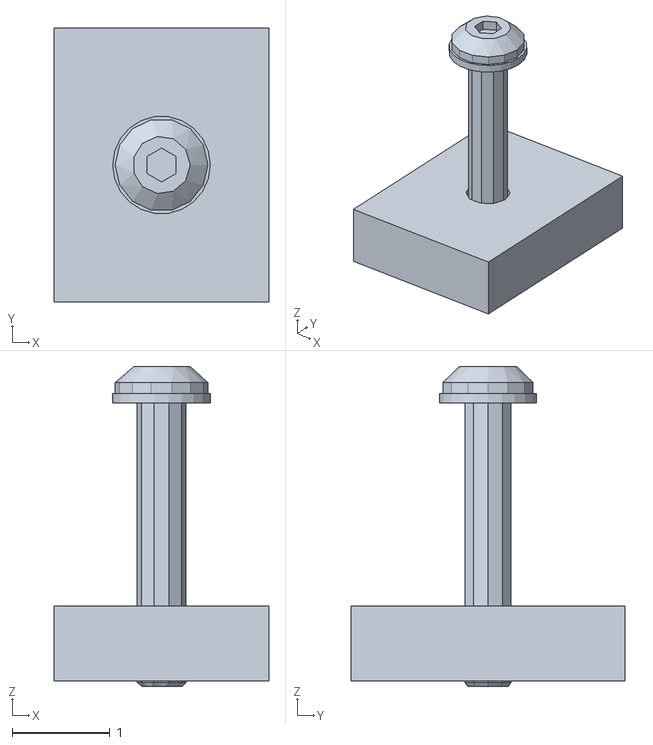
[picture p156: CAD file, 2026-11-02]
inventory/fusion/stl/J-02_Wing_saddle_pod_R.stl
2.20 x 2.80 x 3.27
