davinciucberkeley-collab/DBF-VTOL/inventory/v031/cad/mesh/Lift_Motor.STL

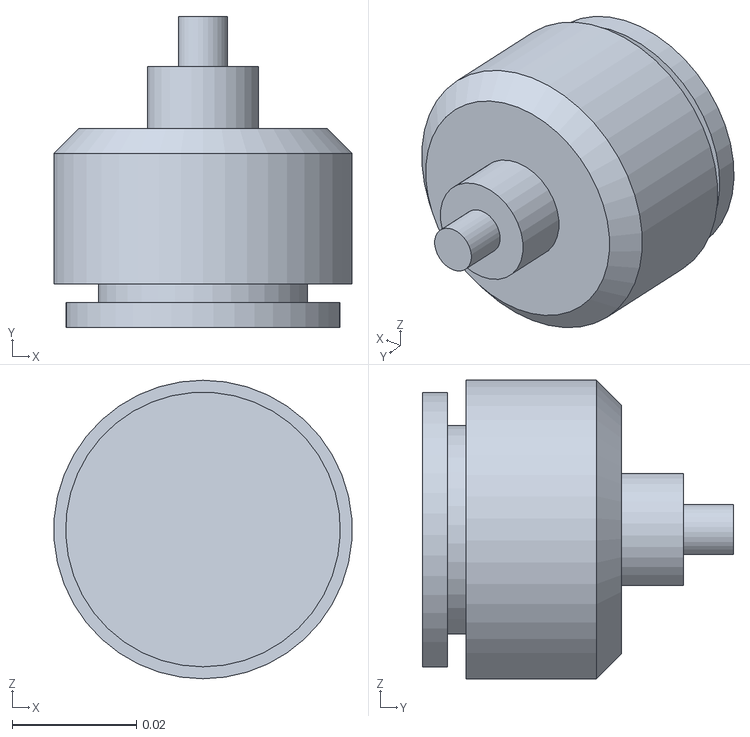
[picture p157: CAD file, 2026-11-04]
inventory/v031/cad/mesh/Lift_Motor.STL
0.0479 x 0.05 x 0.048
