davinciucberkeley-collab/DBF-VTOL/cad/mesh/H_Tail.STL

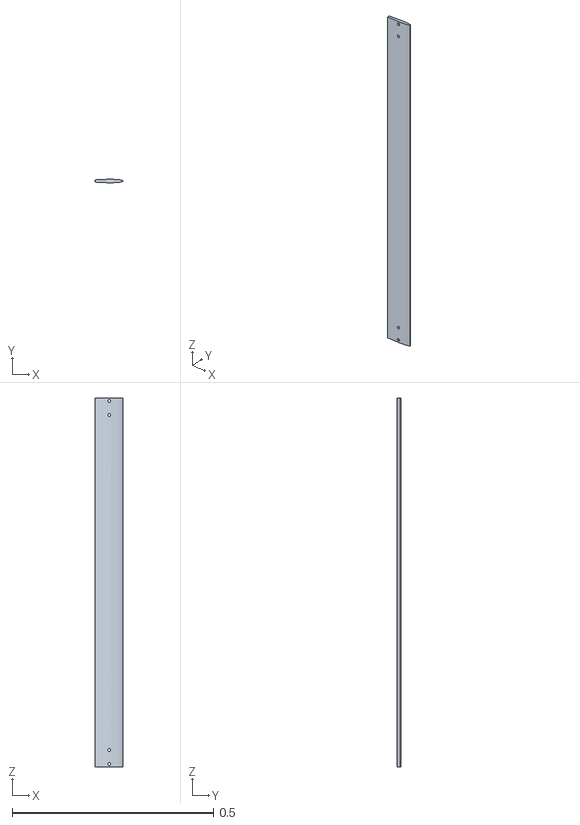
[picture p158: CAD file, 2026-11-04]
cad/mesh/H_Tail.STL
0.069 x 0.00914 x 0.917
