davinciucberkeley-collab/DBF-VTOL/concepts/variants/a1/fusion/stl/Nacelle_Shell_R.stl

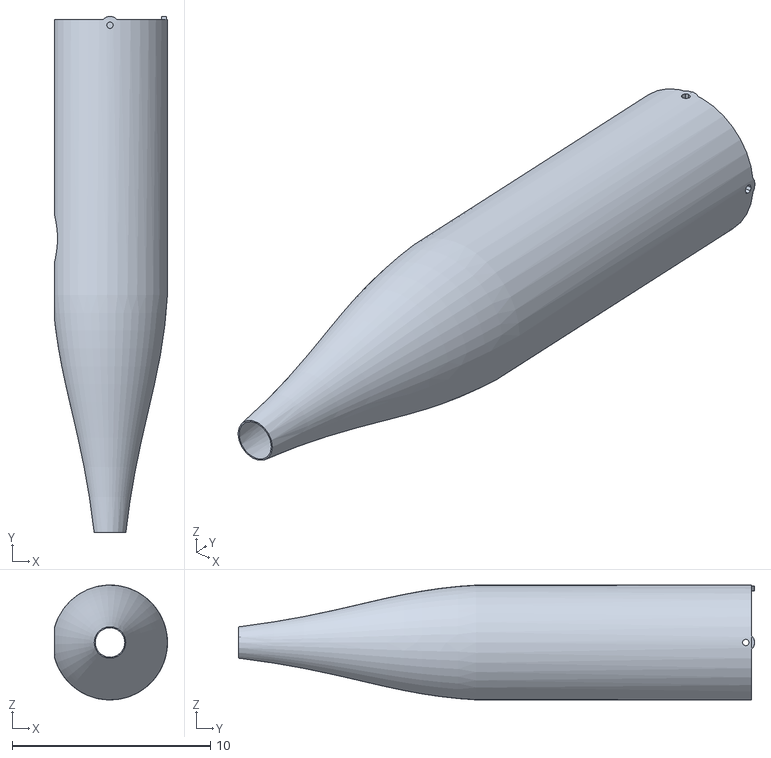
[picture p160: CAD file, 2026-11-03]
concepts/variants/a1/fusion/stl/Nacelle_Shell_R.stl
5.70 x 26.1 x 5.80
