davinciucberkeley-collab/DBF-VTOL/concepts/variants/a2/fusion/stl/CAP_P.stl

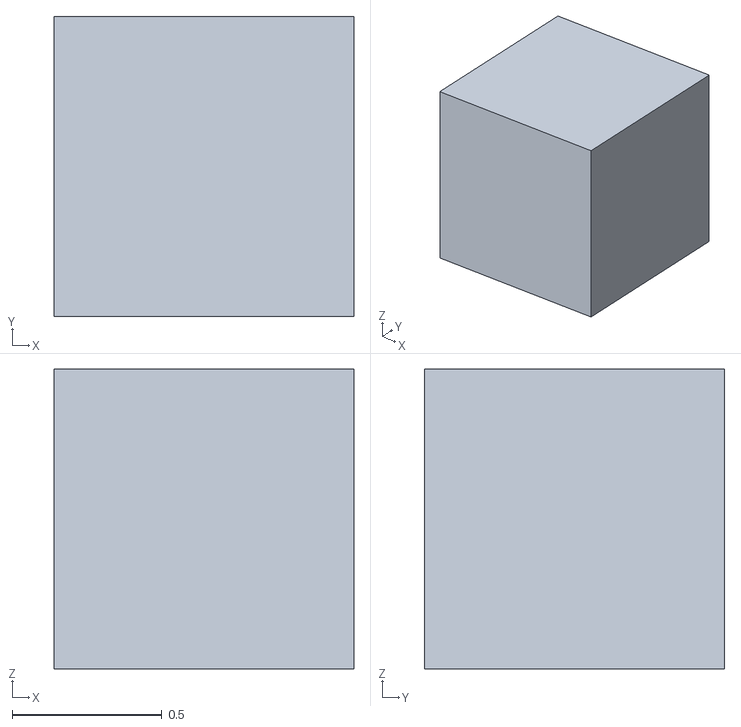
[picture p161: CAD file, 2026-11-03]
concepts/variants/a2/fusion/stl/CAP_P.stl
1.00 x 1.00 x 1.00
