davinciucberkeley-collab/DBF-VTOL/concepts/variants/a3/fusion/stl/Lift_Nacelle_L4.stl

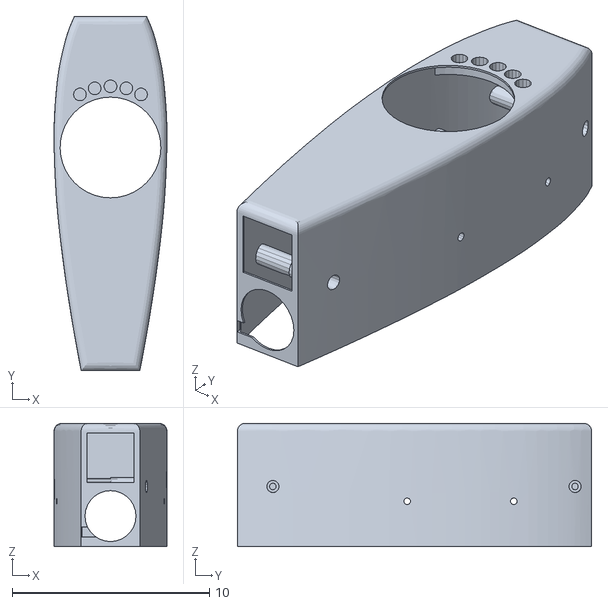
[picture p162: CAD file, 2026-11-03]
concepts/variants/a3/fusion/stl/Lift_Nacelle_L4.stl
5.72 x 17.9 x 6.25
