davinciucberkeley-collab/DBF-VTOL/inventory/fusion/stl/Boom_Front_1.stl

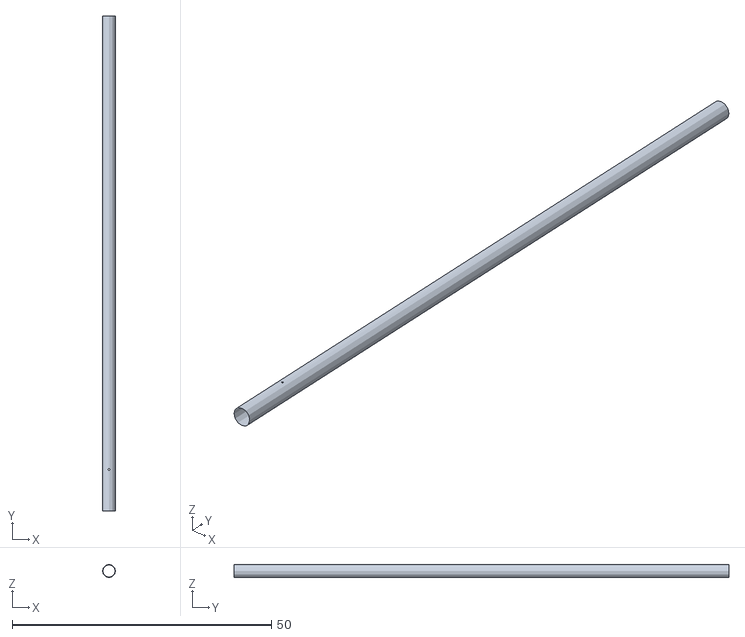
[picture p163: CAD file, 2026-11-02]
inventory/fusion/stl/Boom_Front_1.stl
2.54 x 95.5 x 2.54
