davinciucberkeley-collab/DBF-VTOL/inventory/v031/cad/mesh/H_Tail.STL

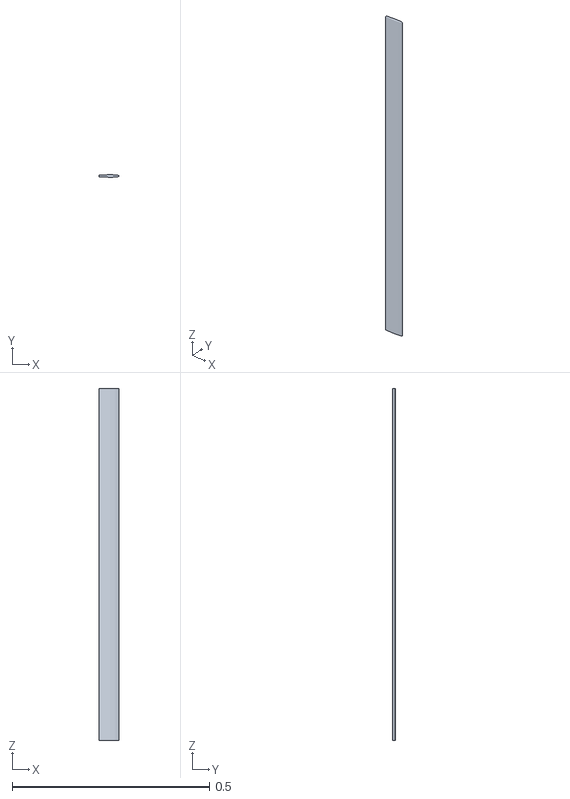
[picture p164: CAD file, 2026-11-04]
inventory/v031/cad/mesh/H_Tail.STL
0.0514 x 0.0068 x 0.893
