davinciucberkeley-collab/DBF-VTOL/cad/mesh/Tail_Clamp_Cap.STL

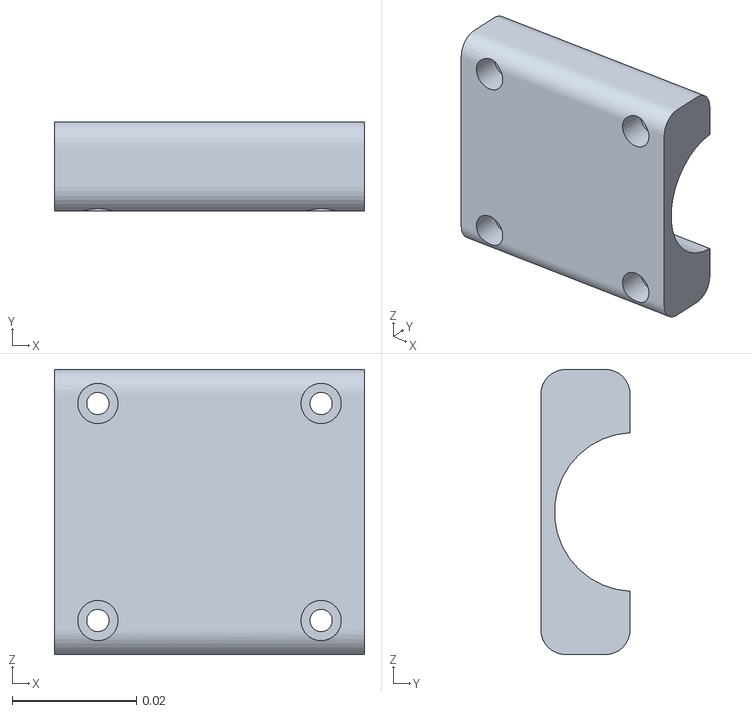
[picture p165: CAD file, 2026-11-04]
cad/mesh/Tail_Clamp_Cap.STL
0.05 x 0.0144 x 0.046
