davinciucberkeley-collab/DBF-VTOL/concepts/variants/a1/fusion/stl/Wing_Panel_L.stl

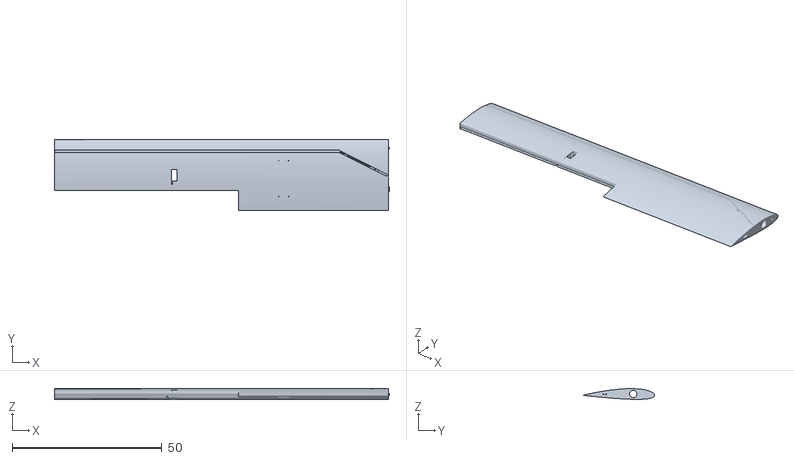
[picture p166: CAD file, 2026-11-03]
concepts/variants/a1/fusion/stl/Wing_Panel_L.stl
112.0 x 23.9 x 3.61
