davinciucberkeley-collab/DBF-VTOL/concepts/variants/a2/fusion/stl/GPS1.stl

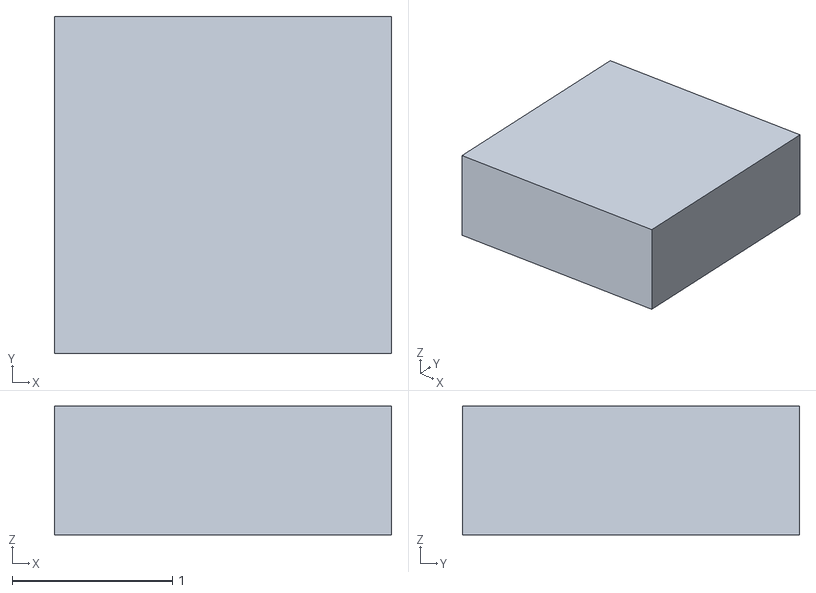
[picture p167: CAD file, 2026-11-03]
concepts/variants/a2/fusion/stl/GPS1.stl
2.10 x 2.10 x 0.802
