davinciucberkeley-collab/DBF-VTOL/inventory/fusion/kinematics/Pushrod_Aileron_R.stl

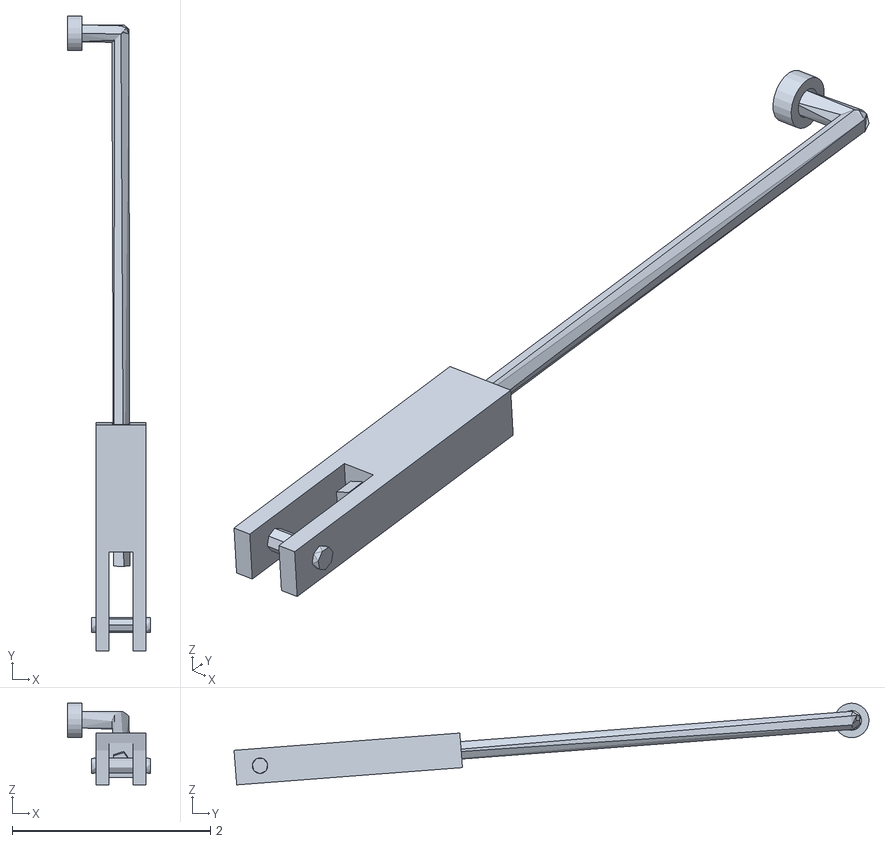
[picture p168: CAD file, 2026-11-02]
inventory/fusion/kinematics/Pushrod_Aileron_R.stl
0.842 x 6.41 x 0.826
