davinciucberkeley-collab/DBF-VTOL/inventory/fusion/stl/Boom_Rear_Stub_2.stl

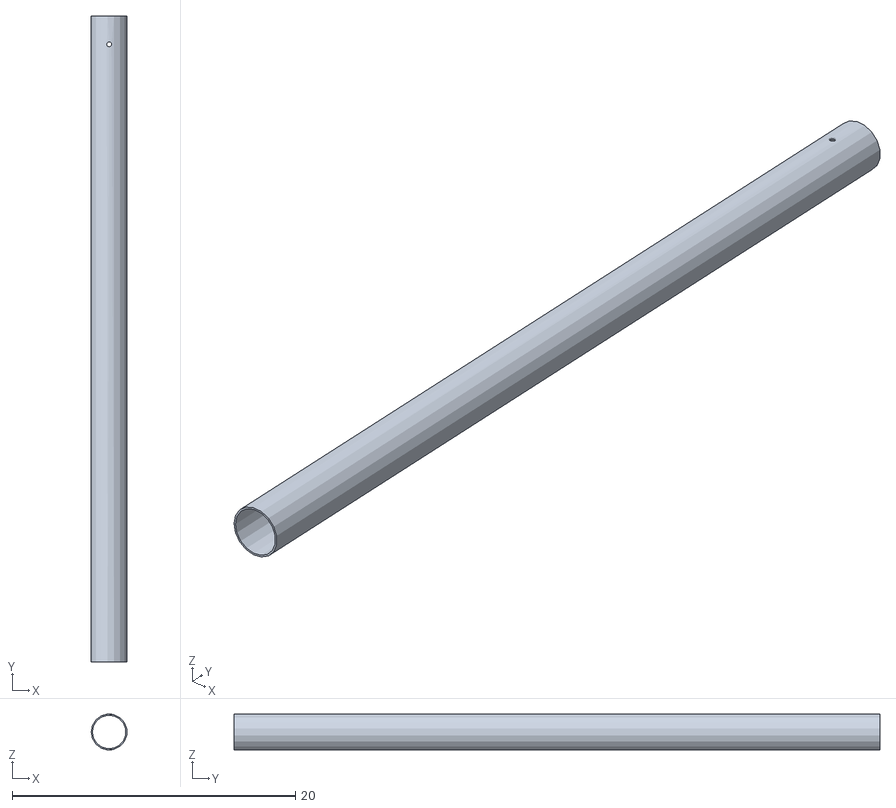
[picture p169: CAD file, 2026-11-02]
inventory/fusion/stl/Boom_Rear_Stub_2.stl
2.52 x 45.6 x 2.54
