davinciucberkeley-collab/DBF-VTOL/cad/model/Crush_Sleeve.SLDPRT

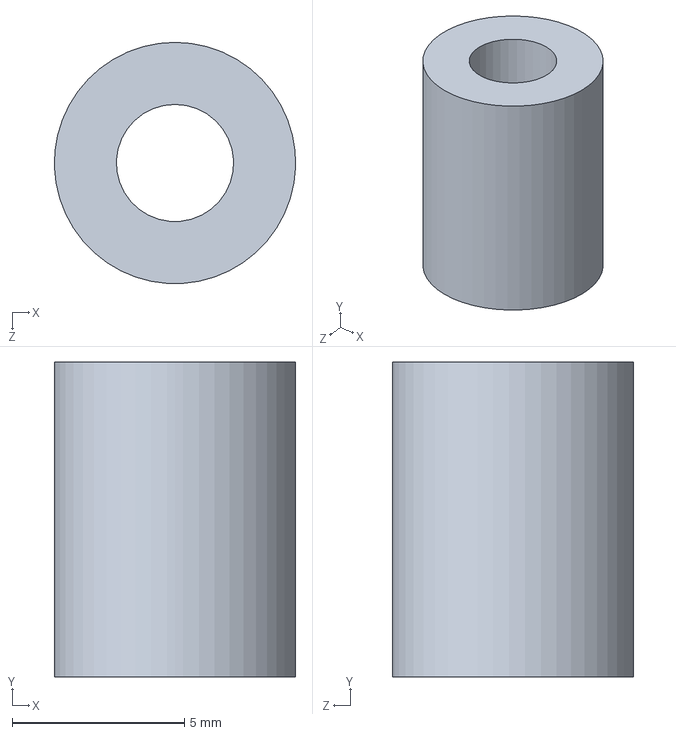
[picture p170: CAD file, 2026-11-04]
cad/model/Crush_Sleeve.SLDPRT
7.00 x 9.14 x 7.00 mm
