davinciucberkeley-collab/DBF-VTOL/concepts/variants/a1/fusion/stl/ESC_T_R.stl

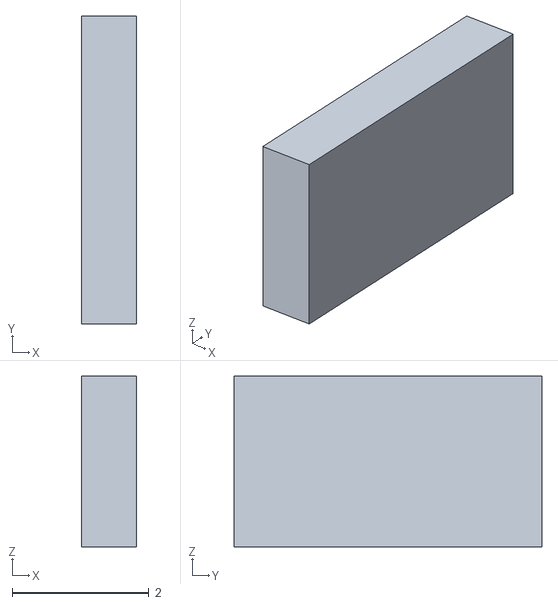
[picture p171: CAD file, 2026-11-03]
concepts/variants/a1/fusion/stl/ESC_T_R.stl
0.8 x 4.50 x 2.50
