davinciucberkeley-collab/DBF-VTOL/concepts/variants/a2/fusion/stl/FC1.stl

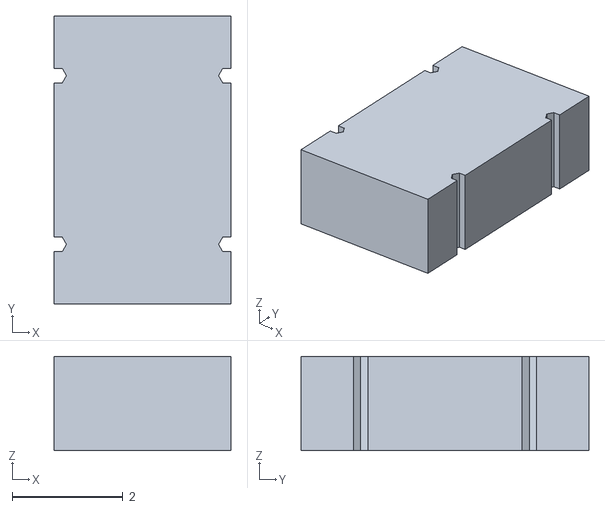
[picture p172: CAD file, 2026-11-03]
concepts/variants/a2/fusion/stl/FC1.stl
3.20 x 5.20 x 1.70
