davinciucberkeley-collab/DBF-VTOL/inventory/fusion/kinematics/Aileron_L.stl

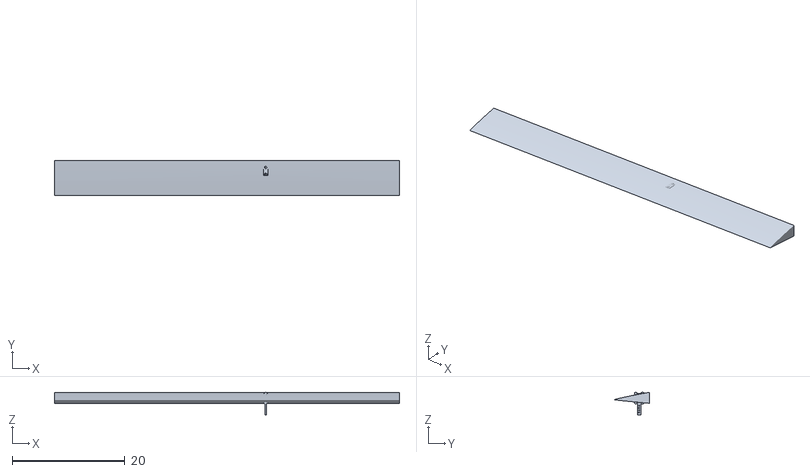
[picture p173: CAD file, 2026-11-02]
inventory/fusion/kinematics/Aileron_L.stl
61.2 x 6.21 x 4.00
