davinciucberkeley-collab/DBF-VTOL/inventory/v031/cad/mesh/Spinner.STL

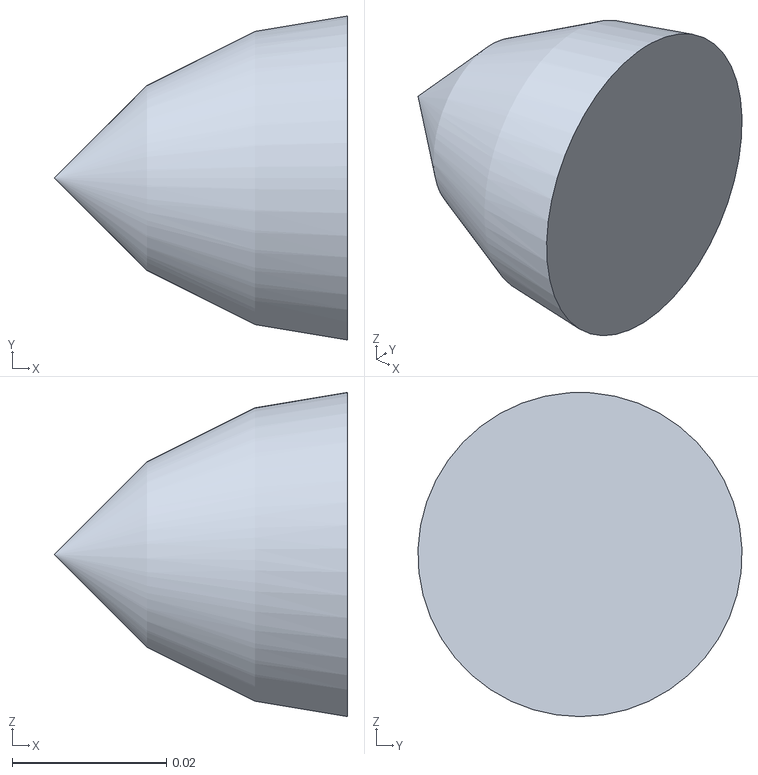
[picture p174: CAD file, 2026-11-04]
inventory/v031/cad/mesh/Spinner.STL
0.038 x 0.042 x 0.042
