davinciucberkeley-collab/DBF-VTOL/cad/model/F09_M5x20_BHCS.SLDPRT

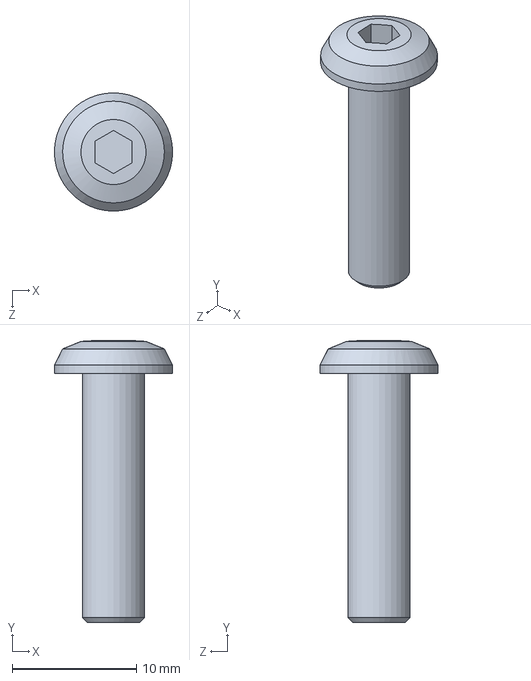
[picture p175: CAD file, 2026-11-04]
cad/model/F09_M5x20_BHCS.SLDPRT
9.50 x 22.7 x 9.50 mm
