davinciucberkeley-collab/DBF-VTOL/concepts/variants/a1/fusion/stl/Battery_6S_LiPo.stl

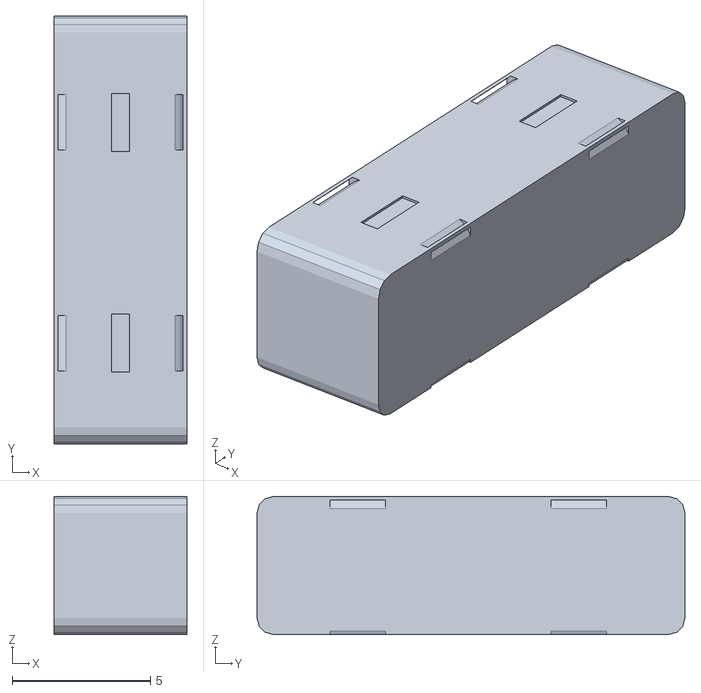
[picture p176: CAD file, 2026-11-03]
concepts/variants/a1/fusion/stl/Battery_6S_LiPo.stl
4.80 x 15.5 x 5.00
