davinciucberkeley-collab/DBF-VTOL/concepts/variants/a2/fusion/stl/Tail_Cone.stl

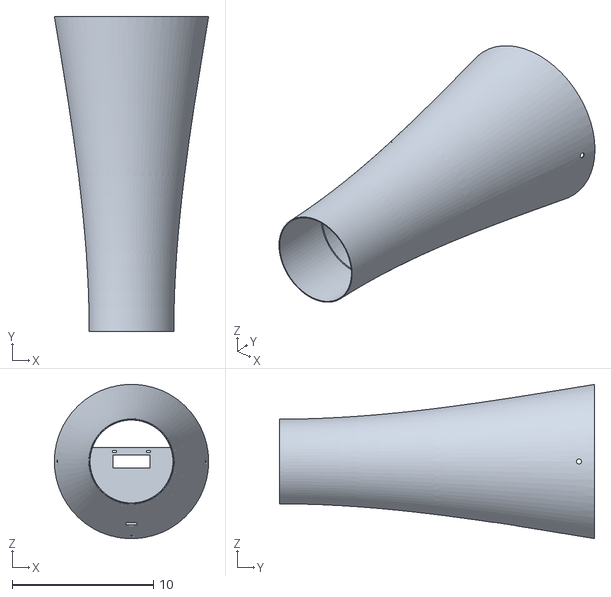
[picture p177: CAD file, 2026-11-03]
concepts/variants/a2/fusion/stl/Tail_Cone.stl
10.9 x 22.3 x 10.9
