davinciucberkeley-collab/DBF-VTOL/inventory/fusion/stl/J-18_Elevator_servo_right_R.stl

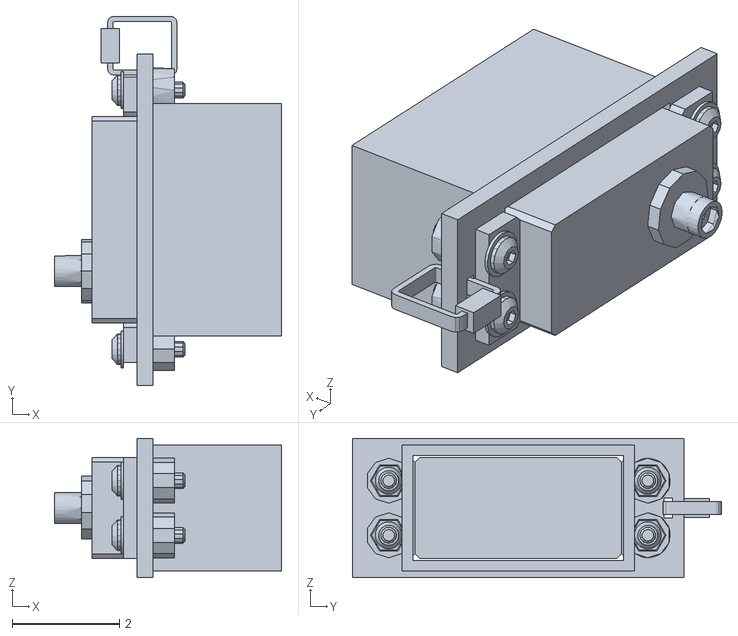
[picture p178: CAD file, 2026-11-02]
inventory/fusion/stl/J-18_Elevator_servo_right_R.stl
4.24 x 6.90 x 2.60
