davinciucberkeley-collab/DBF-VTOL/inventory/v031/cad/mesh/Boom_Clamp_Front.STL

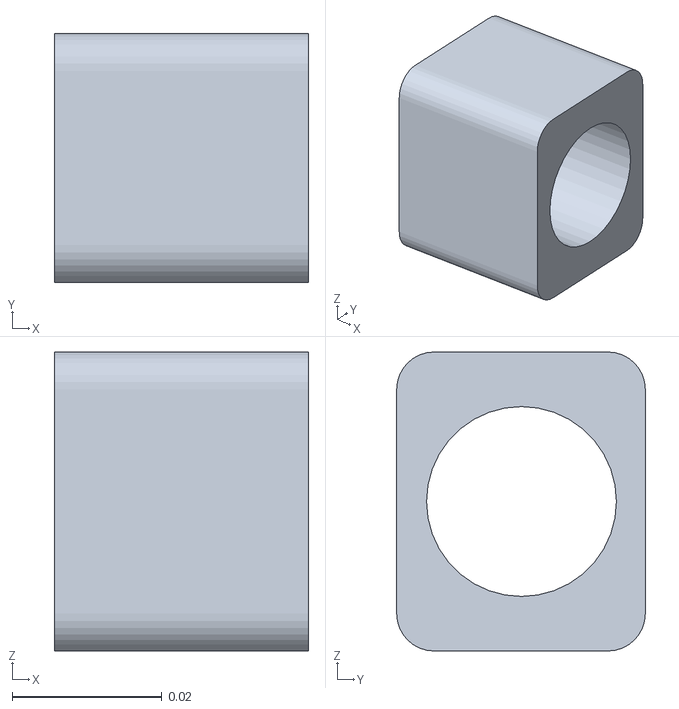
[picture p179: CAD file, 2026-11-04]
inventory/v031/cad/mesh/Boom_Clamp_Front.STL
0.034 x 0.0333 x 0.04
