davinciucberkeley-collab/DBF-VTOL/cad/mesh/F06_M3x35_SHCS.STL

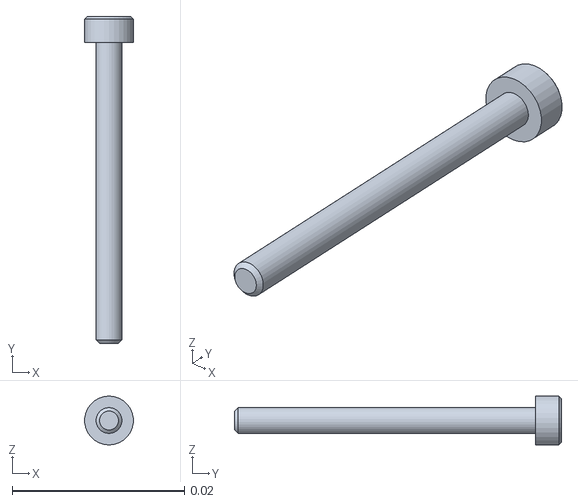
[picture p180: CAD file, 2026-11-04]
cad/mesh/F06_M3x35_SHCS.STL
0.00565 x 0.038 x 0.00568
