davinciucberkeley-collab/DBF-VTOL/concepts/variants/a1/fusion/stl/W_TIP_L_wing.stl

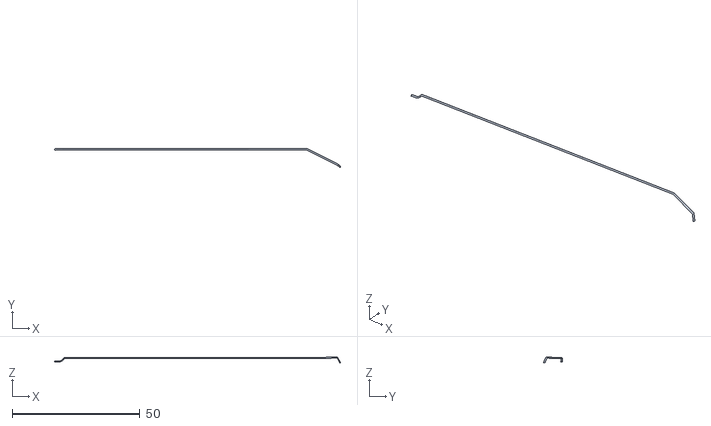
[picture p181: CAD file, 2026-11-03]
concepts/variants/a1/fusion/stl/W_TIP_L_wing.stl
111.8 x 7.49 x 2.32
