davinciucberkeley-collab/DBF-VTOL/inventory/fusion/stl/Gear_Clamp_3.stl

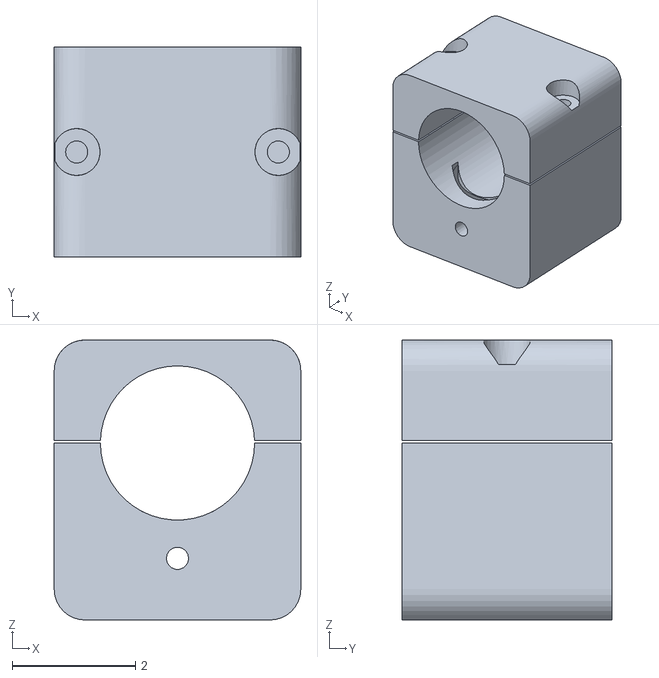
[picture p182: CAD file, 2026-11-02]
inventory/fusion/stl/Gear_Clamp_3.stl
4.00 x 3.40 x 4.54
