davinciucberkeley-collab/DBF-VTOL/(list of files, cad)

Other CAD files:
concepts/variants/a1/fusion/kinematics/Tip_Prop_Set_R.stl
concepts/variants/a2/fusion/kinematics/Pusher_Prop_Set.stl
concepts/variants/a3/fusion/stl/Motor_Mount_3.stl
inventory/fusion/kinematics/Rudder_L.stl
inventory/fusion/stl/Wing_Panel_R.stl
cad/sim/thermal/THERM_Motor_Only.SLDPRT
concepts/variants/a3/fusion/kinematics/Lift_Prop_L2.stl
concepts/variants/a1/fusion/stl/Tip_Tube_Ext_L.stl
concepts/variants/a1/fusion/stl/Nacelle_Mount_L.stl
inventory/fusion/kinematics/Arm_Aileron_L.stl
concepts/variants/a3/fusion/kinematics/Lift_Prop_L1.stl
concepts/variants/a3/fusion/stl/Reed_L1.stl
concepts/variants/a3/fusion/kinematics/Lift_Cap_L2.stl
concepts/variants/a3/fusion/stl/Reed_Wire_L4.stl
concepts/variants/a3/fusion/kinematics/Lift_Cap_L4.stl
concepts/variants/a3/fusion/stl/Motor_Mount_2.stl
concepts/variants/a3/fusion/stl/Lift_Nacelle_L3.stl
inventory/fusion/kinematics/Pusher_Prop_Set.stl
concepts/variants/a3/fusion/kinematics/Lift_Cap_L3.stl
inventory/fusion/kinematics/Lift_Prop_L4.stl
cad/model/Lift_Motor.SLDPRT
concepts/variants/a3/fusion/kinematics/Lift_Prop_L3.stl
concepts/variants/a3/fusion/stl/Magnet_Fix_L1.stl
inventory/v031/cad/mesh/Pusher_Motor.STL
cad/mesh/Pusher_Motor.STL
concepts/variants/a3/fusion/kinematics/Magnet_Rot_L3.stl
concepts/variants/a3/fusion/stl/Reed_L3.stl
inventory/fusion/stl/JB_J2_R.stl
concepts/variants/a3/fusion/kinematics/Magnet_Rot_L4.stl
concepts/variants/a3/fusion/stl/Lift_Nacelle_L2.stl
inventory/fusion/kinematics/Pushrod_Rudder_R.stl
concepts/variants/a2/fusion/stl/ESC_P.stl
concepts/variants/a3/fusion/kinematics/Magnet_Rot_L2.stl
concepts/variants/a3/fusion/stl/Magnet_Fix_L3.stl
inventory/fusion/kinematics/Arm_Rudder_L.stl
cad/drawings/DBF-DRW-001.SLDDRW
cad/mesh/Aileron_L.STL
cad/mesh/Aileron_R.STL
cad/mesh/Bolt_Pillar.STL
cad/mesh/Boom_Clamp_F_Lower.STL
cad/mesh/Boom_Clamp_F_Upper.STL
cad/mesh/Boom_Clamp_R_Lower.STL
cad/mesh/Boom_Clamp_R_Upper.STL
cad/mesh/Boom_Front.STL
cad/mesh/Canopy.STL
cad/mesh/Control_Horn.STL
cad/mesh/Crush_Sleeve.STL
cad/mesh/Elevator.STL
cad/mesh/F01_M3x8_SHCS.STL
cad/mesh/F03_M3x20_SHCS.STL
cad/mesh/F04_M3x40_SHCS.STL
cad/mesh/F05_M3x30_SHCS.STL
cad/mesh/F07_M3x8_BHCS.STL
cad/mesh/F08_M3x12_SHCS.STL
cad/mesh/F09_M5x20_BHCS.STL
cad/mesh/F10_M2x10_SHCS.STL
cad/mesh/F11_M2x14_PAN.STL
cad/mesh/F13_M3x8_SHCS.STL
cad/mesh/FC_Tray.STL
cad/mesh/Fin.STL
cad/mesh/Fin_Shoe.STL
cad/mesh/Gear_Clamp_Lower.STL
cad/mesh/Gear_Clamp_Upper.STL
cad/mesh/Gear_Fairing.STL
cad/mesh/Horn_Backplate.STL
cad/mesh/Horn_Hardpoint.STL
cad/mesh/I01_M3_Insert.STL
cad/mesh/Joiner_Stop.STL
cad/mesh/Landing_Leg.STL
cad/mesh/Lift_Prop.STL
cad/mesh/Motor_Mount_Cap.STL
cad/mesh/Motor_Mount_Upper.STL
cad/mesh/N03_M2_Hex_Nut.STL
cad/mesh/N04_M6_Bullet_Nut.STL
cad/mesh/Pitot_Clamp.STL
cad/mesh/Prop_Plate.STL
cad/mesh/Prop_Washer.STL
cad/mesh/Pusher_Adapter.STL
cad/mesh/Pusher_Cup.STL
cad/mesh/Pusher_Prop_14in.STL
cad/mesh/Pushrod_Elevator.STL
cad/mesh/Pushrod_Rudder.STL
cad/mesh/Rear_Hardpoint.STL
cad/mesh/Root_Tongue.STL
cad/mesh/Rudder.STL
cad/mesh/Servo.STL
cad/mesh/Servo_Tray.STL
cad/mesh/Splice_Plug.STL
cad/mesh/Tail_Clamp_Upper.STL
cad/mesh/W01_M3_Washer.STL
cad/mesh/Wing_Panel_L.STL
cad/mesh/Wing_Panel_R.STL
cad/mesh/Wing_Saddle.STL
cad/model/Aileron_L.SLDPRT
cad/model/Aileron_R.SLDPRT
cad/model/Battery_6S_LiPo.SLDPRT
cad/model/Bolt_Pillar.SLDPRT
cad/model/Boom_Clamp_F_Lower.SLDPRT
cad/model/Boom_Clamp_F_Upper.SLDPRT
cad/model/Boom_Clamp_R_Lower.SLDPRT
cad/model/Boom_Clamp_R_Upper.SLDPRT
cad/model/Boom_Front.SLDPRT
cad/model/Canopy.SLDPRT
cad/model/Control_Horn.SLDPRT
cad/model/Elevator.SLDPRT
cad/model/F01_M3x8_SHCS.SLDPRT
cad/model/F02_M3x16_SHCS.SLDPRT
cad/model/F03_M3x20_SHCS.SLDPRT
cad/model/F04_M3x40_SHCS.SLDPRT
cad/model/F05_M3x30_SHCS.SLDPRT
cad/model/F06_M3x35_SHCS.SLDPRT
cad/model/F07_M3x8_BHCS.SLDPRT
cad/model/F08_M3x12_SHCS.SLDPRT
cad/model/F10_M2x10_SHCS.SLDPRT
cad/model/F11_M2x14_PAN.SLDPRT
cad/model/F13_M3x8_SHCS.SLDPRT
cad/model/Fin.SLDPRT
cad/model/Flight_Controller.SLDPRT
cad/model/Fuselage_Pod.SLDPRT
cad/model/Gear_Clamp_Lower.SLDPRT
cad/model/Gear_Clamp_Upper.SLDPRT
cad/model/Gear_Fairing.SLDPRT
cad/model/H_Tail.SLDPRT
cad/model/Horn_Hardpoint.SLDPRT
cad/model/Joiner_Stop.SLDPRT
cad/model/Landing_Leg.SLDPRT
cad/model/Motor_Mount_Cap.SLDPRT
cad/model/Motor_Mount_Upper.SLDPRT
cad/model/N01_M3_Nylock.SLDPRT
cad/model/N02_M5_Nylock.SLDPRT
cad/model/N03_M2_Hex_Nut.SLDPRT
cad/model/N04_M6_Bullet_Nut.SLDPRT
cad/model/Pitot_Clamp.SLDPRT
cad/model/Pitot_Tube.SLDPRT
cad/model/Prop_Plate.SLDPRT
cad/model/Prop_Washer.SLDPRT
cad/model/Pusher_Adapter.SLDPRT
cad/model/Pusher_Cup.SLDPRT
cad/model/Pusher_Prop_14in.SLDPRT
cad/model/Pushrod_Elevator.SLDPRT
cad/model/Rear_Hardpoint.SLDPRT
cad/model/Root_Tongue.SLDPRT
cad/model/Rudder.SLDPRT
cad/model/Servo.SLDPRT
cad/model/Servo_Tray.SLDPRT
cad/model/Spar_Collar.SLDPRT
cad/model/Spar_Tube.SLDPRT
cad/model/Splice_Plug.SLDPRT
cad/model/Tail_Clamp_Upper.SLDPRT
cad/model/VTOL_Concept.SLDASM
cad/model/VTOL_Concept.STEP
cad/model/W01_M3_Washer.SLDPRT
cad/model/Wing_Panel_L.SLDPRT
cad/model/Wing_Panel_R.SLDPRT
cad/model/Wing_Saddle.SLDPRT
concepts/variants/a1/fusion/a1.f3d
concepts/variants/a1/fusion/stl/Battery_Tray_Ext.stl
concepts/variants/a1/fusion/stl/CAP_T_L.stl
concepts/variants/a1/fusion/stl/CAP_T_R.stl
concepts/variants/a1/fusion/stl/ESC_T_L.stl
concepts/variants/a1/fusion/stl/J-25_Pod_formers_battery_tray_straps.stl
concepts/variants/a1/fusion/stl/J-31_Pitot_clamp_on_left_wing_lower_skin__L_.stl
concepts/variants/a1/fusion/stl/J-A1-2_Tip_tube_-_nacelle_mount_barrel_2_x_M3x5_7_inserts___2_x_M3x6_grub__L_.stl
concepts/variants/a1/fusion/stl/J-A1-2_Tip_tube_-_nacelle_mount_barrel_2_x_M3x5_7_inserts___2_x_M3x6_grub__R_.stl
concepts/variants/a1/fusion/stl/J-A1-3_Tip_motor_-_nacelle_mount_4_x_M3x10___washers__ESC_and_cap_cable_ties__L_.stl
concepts/variants/a1/fusion/stl/J-A1-3_Tip_motor_-_nacelle_mount_4_x_M3x10___washers__ESC_and_cap_cable_ties__R_.stl
concepts/variants/a1/fusion/stl/J-A1-5_Nacelle_shell_-_mount_ring_2_x_M3x8___washers_into_inserts__L_.stl
concepts/variants/a1/fusion/stl/J-A1-5_Nacelle_shell_-_mount_ring_2_x_M3x8___washers_into_inserts__R_.stl
concepts/variants/a1/fusion/stl/J-A1-6_XT60H_mated-pair_retention_cable_tie__L_.stl
concepts/variants/a1/fusion/stl/J-A1-6_XT60H_mated-pair_retention_cable_tie__R_.stl
concepts/variants/a1/fusion/stl/Nacelle_Shell_L.stl
concepts/variants/a1/fusion/stl/Tip_Connectors_R.stl
concepts/variants/a1/fusion/stl/Tip_Splice_Sleeve_L.stl
concepts/variants/a1/fusion/stl/Tip_Splice_Sleeve_R.stl
concepts/variants/a1/fusion/stl/W_TIP_L_pod.stl
concepts/variants/a1/fusion/stl/W_TIP_R_wing.stl
concepts/variants/a1/fusion/stl/Wing_Panel_R.stl
concepts/variants/a1/fusion/stl/XT90S_1.stl
concepts/variants/a2/fusion/a2.f3d
concepts/variants/a2/fusion/stl/BUS1.stl
concepts/variants/a2/fusion/stl/J-11_Pusher_motor_-_firewall_-_pod_aft_bulkhead.stl
concepts/variants/a2/fusion/stl/J-24_27_Canopy_screws_and_GPS_mast.stl
concepts/variants/a2/fusion/stl/J-25_Pod_formers_battery_tray_straps.stl
concepts/variants/a2/fusion/stl/J-A2-01_Tail_cone_screws_washers.stl
concepts/variants/a2/fusion/stl/Tail_Joint_Sleeve.stl
concepts/variants/a2/fusion/stl/Tail_Joint_Spigot.stl
concepts/variants/a2/fusion/stl/UBEC1.stl
concepts/variants/a3/fusion/a3.f3d
concepts/variants/a3/fusion/kinematics/HW-A3-03_Cap_screws_L1.stl
concepts/variants/a3/fusion/kinematics/HW-A3-03_Cap_screws_L2.stl
concepts/variants/a3/fusion/kinematics/HW-A3-03_Cap_screws_L3.stl
concepts/variants/a3/fusion/kinematics/HW-A3-03_Cap_screws_L4.stl
concepts/variants/a3/fusion/stl/J-A3-01_Lift_Nacelle_Motor_Mount_L.stl
concepts/variants/a3/fusion/stl/J-A3-01_Lift_Nacelle_Motor_Mount_R.stl
concepts/variants/a3/fusion/stl/Magnet_Fix_L4.stl
concepts/variants/a3/fusion/stl/Motor_Mount_4.stl
concepts/variants/a3/fusion/stl/Reed_L4.stl
concepts/variants/a3/fusion/stl/Reed_Ladder_R.stl
concepts/variants/a3/fusion/stl/Reed_Wire_L3.stl
inventory/fusion/VTOL_Fusion.f3d
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
