davinciucberkeley-collab/DBF-VTOL/cad/verification.txt

# CAD verification log, generated by cad/BuildVtol.cs on 2026-10-25 13:59 (SOLIDWORKS 33.4.0)
# cut-direction probe: Dir=false cuts along -normal (COM y 0.025 mm)
  WARNING cut 'tail ring radial hole bottom' in Part88 removed nothing

## Model content
components 397 (122 structural/purchased + 275 fasteners); unique part files 75
cosmetic threads: 17 created, 0 failed; cut warnings 1
assembly bounding box x -1.036..0.607  y -0.250..0.197  z -1.200..1.200 m
pusher/lift disc clearance (params.mjs) 79.0 mm; pusher prop ground clearance 41.9 mm; boom cut lengths 991.0 / 485.9 mm
rotation check F05 (expected along X): box extents x 33.0 y 5.7 z 5.7 mm

## Mass roll-up (volume x density, or fixed vendor mass)  [part | qty | each g | total g | basis]
Aileron_L              |   1 |    18.18 |     18.2 | 568.25 cm3 x 32 kg/m3 (analysis/sizing.mjs rhoFoam 32 kg/m3 (AM 2a))
Aileron_R              |   1 |    18.18 |     18.2 | 568.27 cm3 x 32 kg/m3 (analysis/sizing.mjs rhoFoam 32 kg/m3 (AM 2a))
Battery_6S_LiPo        |   1 |   820.00 |    820.0 | fixed 820 g: Ovonic 6S 6500 (budget-energy-test.md 1)
Battery_Tray           |   1 |    34.65 |     34.6 | 27.28 cm3 x 1270 kg/m3 (EST: PETG typical datasheet density 1.27 g/cm3)
Bolt_Pillar            |   2 |     3.74 |      7.5 | 2.95 cm3 x 1270 kg/m3 (EST: PETG typical datasheet density 1.27 g/cm3)
Boom_Clamp_F_Lower     |   2 |    20.27 |     40.5 | 15.96 cm3 x 1270 kg/m3 (EST: PETG typical datasheet density 1.27 g/cm3)
Boom_Clamp_F_Upper     |   2 |    15.24 |     30.5 | 12.00 cm3 x 1270 kg/m3 (EST: PETG typical datasheet density 1.27 g/cm3)
Boom_Clamp_R_Lower     |   2 |    20.08 |     40.2 | 15.81 cm3 x 1270 kg/m3 (EST: PETG typical datasheet density 1.27 g/cm3)
Boom_Clamp_R_Upper     |   2 |    34.52 |     69.0 | 27.18 cm3 x 1270 kg/m3 (EST: PETG typical datasheet density 1.27 g/cm3)
Boom_Front             |   2 |   183.13 |    366.3 | 67.82 cm3 x 2700 kg/m3 (SOLIDWORKS library 6061-T6 (SS))
Boom_Rear_Stub         |   2 |    89.77 |    179.5 | 33.25 cm3 x 2700 kg/m3 (SOLIDWORKS library 6061-T6 (SS))
Canopy                 |   1 |    26.43 |     26.4 | 825.78 cm3 x 32 kg/m3 (analysis/sizing.mjs rhoFoam 32 kg/m3 (AM 2a))
Control_Horn           |   5 |     0.76 |      3.8 | 0.67 cm3 x 1140 kg/m3 (EST: nylon 6)
Crush_Sleeve           |   4 |     0.34 |      1.4 | 0.27 cm3 x 1270 kg/m3 (EST: PETG typical datasheet density 1.27 g/cm3)
Elevator               |   1 |     2.51 |      2.5 | 78.48 cm3 x 32 kg/m3 (analysis/sizing.mjs rhoFoam 32 kg/m3 (AM 2a))
F01_M3x8_SHCS          |  20 |     0.98 |     19.6 | 0.12 cm3 x 7900 kg/m3 (EST: 18-8 stainless, typical 7.9 g/cm3 (vendor gives none))
F02_M3x16_SHCS         |  36 |     1.42 |     51.3 | 0.18 cm3 x 7900 kg/m3 (EST: 18-8 stainless, typical 7.9 g/cm3 (vendor gives none))
F03_M3x20_SHCS         |  16 |     1.65 |     26.4 | 0.21 cm3 x 7900 kg/m3 (EST: 18-8 stainless, typical 7.9 g/cm3 (vendor gives none))
F04_M3x40_SHCS         |   8 |     2.76 |     22.1 | 0.35 cm3 x 7900 kg/m3 (EST: 18-8 stainless, typical 7.9 g/cm3 (vendor gives none))
F05_M3x30_SHCS         |   4 |     2.21 |      8.8 | 0.28 cm3 x 7900 kg/m3 (EST: 18-8 stainless, typical 7.9 g/cm3 (vendor gives none))
F06_M3x35_SHCS         |   4 |     2.49 |      9.9 | 0.31 cm3 x 7900 kg/m3 (EST: 18-8 stainless, typical 7.9 g/cm3 (vendor gives none))
F07_M3x8_BHCS          |  11 |     0.66 |      7.3 | 0.08 cm3 x 7900 kg/m3 (EST: 18-8 stainless, typical 7.9 g/cm3 (vendor gives none))
F08_M3x12_SHCS         |   4 |     1.20 |      4.8 | 0.15 cm3 x 7900 kg/m3 (EST: 18-8 stainless, typical 7.9 g/cm3 (vendor gives none))
F09_M5x20_BHCS         |   2 |     4.15 |      8.3 | 0.53 cm3 x 7900 kg/m3 (EST: 18-8 stainless, typical 7.9 g/cm3 (vendor gives none))
F10_M2x10_SHCS         |  20 |     0.42 |      8.5 | 0.05 cm3 x 7900 kg/m3 (EST: 18-8 stainless, typical 7.9 g/cm3 (vendor gives none))
F11_M2x14_PAN          |  10 |     0.45 |      4.5 | 0.06 cm3 x 7900 kg/m3 (EST: 18-8 stainless, typical 7.9 g/cm3 (vendor gives none))
F13_M3x8_SHCS          |   4 |     0.98 |      3.9 | 0.12 cm3 x 7900 kg/m3 (EST: 18-8 stainless, typical 7.9 g/cm3 (vendor gives none))
FC_Tray                |   1 |    11.60 |     11.6 | 9.14 cm3 x 1270 kg/m3 (EST: PETG typical datasheet density 1.27 g/cm3)
Fin                    |   2 |     5.97 |     11.9 | 186.44 cm3 x 32 kg/m3 (analysis/sizing.mjs rhoFoam 32 kg/m3 (AM 2a))
Fin_Shoe               |   2 |    20.80 |     41.6 | 16.38 cm3 x 1270 kg/m3 (EST: PETG typical datasheet density 1.27 g/cm3)
Flight_Controller      |   1 |    40.00 |     40.0 | fixed 40 g: CoreWing F405 Wing V2 (ArduPilot wiki)
Fuselage_Pod           |   1 |   301.56 |    301.6 | 9423.75 cm3 x 32 kg/m3 (analysis/sizing.mjs rhoFoam 32 kg/m3 (AM 2a))
Gear_Clamp_Lower       |   4 |    31.93 |    127.7 | 25.14 cm3 x 1270 kg/m3 (EST: PETG typical datasheet density 1.27 g/cm3)
Gear_Clamp_Upper       |   4 |    20.46 |     81.8 | 16.11 cm3 x 1270 kg/m3 (EST: PETG typical datasheet density 1.27 g/cm3)
Gear_Fairing           |   4 |    25.38 |    101.5 | 19.98 cm3 x 1270 kg/m3 (EST: PETG typical datasheet density 1.27 g/cm3)
H_Tail                 |   1 |    15.55 |     15.5 | 485.88 cm3 x 32 kg/m3 (analysis/sizing.mjs rhoFoam 32 kg/m3 (AM 2a))
Horn_Backplate         |   3 |     0.36 |      1.1 | 0.32 cm3 x 1140 kg/m3 (EST: nylon 6)
Horn_Hardpoint         |   2 |     2.85 |      5.7 | 2.24 cm3 x 1270 kg/m3 (EST: PETG typical datasheet density 1.27 g/cm3)
I01_M3_Insert          |  67 |     0.44 |     29.6 | 0.05 cm3 x 8500 kg/m3 (EST: brass, typical 8.5 g/cm3)
Joiner_Stop            |   2 |     5.00 |     10.0 | 3.94 cm3 x 1270 kg/m3 (EST: PETG typical datasheet density 1.27 g/cm3)
Landing_Leg            |   4 |   108.22 |    432.9 | 40.08 cm3 x 2700 kg/m3 (SOLIDWORKS library 6061-T6 (SS))
Lift_Motor             |   4 |   165.00 |    660.0 | fixed 165 g: SunnySky X4110S (budget-lift.md A3)
Lift_Prop              |   4 |    32.00 |    128.0 | fixed 32 g EST (analysis/sizing.mjs mProp)
Motor_Mount_Cap        |   4 |    33.28 |    133.1 | 27.06 cm3 x 1230 kg/m3 (EST: Polymaker PA6-CF20 about 1.23 g/cm3)
Motor_Mount_Upper      |   4 |    55.45 |    221.8 | 45.08 cm3 x 1230 kg/m3 (EST: Polymaker PA6-CF20 about 1.23 g/cm3)
N01_M3_Nylock          |   8 |     0.55 |      4.4 | 0.07 cm3 x 7900 kg/m3 (EST: 18-8 stainless, typical 7.9 g/cm3 (vendor gives none))
N02_M5_Nylock          |   2 |     1.26 |      2.5 | 0.16 cm3 x 7900 kg/m3 (EST: 18-8 stainless, typical 7.9 g/cm3 (vendor gives none))
N03_M2_Hex_Nut         |  30 |     0.14 |      4.1 | 0.02 cm3 x 7900 kg/m3 (EST: 18-8 stainless, typical 7.9 g/cm3 (vendor gives none))
N04_M6_Bullet_Nut      |   1 |     8.13 |      8.1 | 1.04 cm3 x 7850 kg/m3 (EST: carbon steel)
Pitot_Clamp            |   1 |     9.93 |      9.9 | 7.82 cm3 x 1270 kg/m3 (EST: PETG typical datasheet density 1.27 g/cm3)
Pitot_Tube             |   1 |    17.81 |     17.8 | 6.60 cm3 x 2700 kg/m3 (SOLIDWORKS library 6061-T6 (SS))
Prop_Plate             |   4 |     5.58 |     22.3 | 0.71 cm3 x 7850 kg/m3 (EST: carbon steel)
Prop_Washer            |   1 |     4.31 |      4.3 | 0.55 cm3 x 7850 kg/m3 (EST: carbon steel)
Pusher_Adapter         |   1 |    11.12 |     11.1 | 1.42 cm3 x 7850 kg/m3 (EST: carbon steel)
Pusher_Cup             |   1 |    33.02 |     33.0 | 26.85 cm3 x 1230 kg/m3 (EST: Polymaker PA6-CF20 about 1.23 g/cm3)
Pusher_Motor           |   1 |   165.00 |    165.0 | fixed 165 g: SunnySky X4110S (budget-lift.md A3)
Pusher_Prop_14in       |   1 |    37.00 |     37.0 | fixed 37 g: APC 14x8.5EP (pusher-battery-servo.md)
Pushrod_Aileron        |   2 |     3.05 |      6.1 | 0.39 cm3 x 7850 kg/m3 (EST: carbon steel)
Pushrod_Elevator       |   1 |     2.79 |      2.8 | 0.36 cm3 x 7850 kg/m3 (EST: carbon steel)
Pushrod_Rudder         |   2 |     4.63 |      9.3 | 0.59 cm3 x 7850 kg/m3 (EST: carbon steel)
Rear_Hardpoint         |   2 |    34.36 |     68.7 | 27.06 cm3 x 1270 kg/m3 (EST: PETG typical datasheet density 1.27 g/cm3)
Root_Tongue            |   2 |     7.87 |     15.7 | 6.19 cm3 x 1270 kg/m3 (EST: PETG typical datasheet density 1.27 g/cm3)
Rudder                 |   2 |     0.86 |      1.7 | 26.80 cm3 x 32 kg/m3 (analysis/sizing.mjs rhoFoam 32 kg/m3 (AM 2a))
Servo                  |   5 |    43.20 |    216.0 | fixed 43.2 g: EMAX ES3005HV (budget-avionics.md 6)
Servo_Tray             |   5 |     5.10 |     25.5 | 4.02 cm3 x 1270 kg/m3 (EST: PETG typical datasheet density 1.27 g/cm3)
Spar_Collar            |   2 |    38.44 |     76.9 | 30.27 cm3 x 1270 kg/m3 (EST: PETG typical datasheet density 1.27 g/cm3)
Spar_Tube              |   2 |   239.16 |    478.3 | 88.58 cm3 x 2700 kg/m3 (SOLIDWORKS library 6061-T6 (SS))
Splice_Plug            |   2 |    42.42 |     84.8 | 33.40 cm3 x 1270 kg/m3 (EST: PETG typical datasheet density 1.27 g/cm3)
Tail_Clamp_Cap         |   2 |    24.43 |     48.9 | 19.23 cm3 x 1270 kg/m3 (EST: PETG typical datasheet density 1.27 g/cm3)
Tail_Clamp_Upper       |   2 |    27.15 |     54.3 | 21.38 cm3 x 1270 kg/m3 (EST: PETG typical datasheet density 1.27 g/cm3)
W01_M3_Washer          |  28 |     0.12 |      3.4 | 0.02 cm3 x 7900 kg/m3 (EST: 18-8 stainless, typical 7.9 g/cm3 (vendor gives none))
Wing_Joiner            |   1 |   197.06 |    197.1 | 72.98 cm3 x 2700 kg/m3 (SOLIDWORKS library 6061-T6 (SS))
Wing_Panel_L           |   1 |   258.70 |    258.7 | 8084.36 cm3 x 32 kg/m3 (analysis/sizing.mjs rhoFoam 32 kg/m3 (AM 2a))
Wing_Panel_R           |   1 |   258.75 |    258.8 | 8085.95 cm3 x 32 kg/m3 (analysis/sizing.mjs rhoFoam 32 kg/m3 (AM 2a))
Wing_Saddle            |   1 |    40.76 |     40.8 | 1273.68 cm3 x 32 kg/m3 (analysis/sizing.mjs rhoFoam 32 kg/m3 (AM 2a))
TOTAL modelled mass 6.357 kg: fasteners 227.5 g, printed parts 1381.3 g, 6061 tubes 1671.9 g, foam (XPS at 32 kg/m3, skins not modelled) 954.3 g, fixed vendor masses 2121.9 g
sizing MTOW (analysis/results.json C0 sized.m) 6.552 kg includes wiring, ESCs, payload allowance, skins and avionics that are not solid-modelled; fastener mass is not tracked by sizing.mjs (see cad/README.md)

## Interference detection (InterferenceDetectionMgr, coincidence not counted)
277 interferences: 193 are heat-set inserts in their 4.0 holes (intended press fit FT08, total 1400.1 mm3), 84 other (total 446.1 mm3)
    102.45 mm3  Control_Horn-1  x  Pushrod_Rudder-1
     25.82 mm3  Wing_Panel_L-1  x  Spar_Tube-2
     23.48 mm3  Wing_Panel_R-1  x  Spar_Tube-1
     20.17 mm3  Wing_Panel_L-1  x  Spar_Tube-2
     18.34 mm3  Wing_Panel_R-1  x  Spar_Tube-1
     14.16 mm3  Elevator-1  x  F11_M2x14_PAN-9
     10.92 mm3  Elevator-1  x  Horn_Backplate-3
     10.92 mm3  Elevator-1  x  Control_Horn-5
      9.95 mm3  Elevator-1  x  F11_M2x14_PAN-10
      8.88 mm3  Wing_Panel_R-1  x  Boom_Clamp_F_Upper-1
      8.88 mm3  Wing_Panel_L-1  x  Boom_Clamp_F_Upper-2
      8.41 mm3  Control_Horn-5  x  F11_M2x14_PAN-9
      8.41 mm3  Control_Horn-5  x  F11_M2x14_PAN-10
      8.41 mm3  Control_Horn-4  x  F11_M2x14_PAN-8
      8.41 mm3  Control_Horn-4  x  F11_M2x14_PAN-7
      8.41 mm3  Control_Horn-3  x  F11_M2x14_PAN-6
      8.41 mm3  Control_Horn-3  x  F11_M2x14_PAN-5
      8.41 mm3  Control_Horn-2  x  F11_M2x14_PAN-4
      8.41 mm3  Control_Horn-2  x  F11_M2x14_PAN-3
      8.41 mm3  Control_Horn-1  x  F11_M2x14_PAN-2
      8.41 mm3  Control_Horn-1  x  F11_M2x14_PAN-1
      7.01 mm3  Spar_Collar-2  x  F06_M3x35_SHCS-4
      7.01 mm3  Spar_Collar-2  x  F06_M3x35_SHCS-3
      7.01 mm3  Spar_Collar-1  x  F06_M3x35_SHCS-2
      7.01 mm3  Spar_Collar-1  x  F06_M3x35_SHCS-1
      6.29 mm3  Aileron_R-1  x  F11_M2x14_PAN-4
      6.29 mm3  Aileron_R-1  x  F11_M2x14_PAN-3
      6.29 mm3  Aileron_L-1  x  F11_M2x14_PAN-8
      6.29 mm3  Aileron_L-1  x  F11_M2x14_PAN-7
      4.75 mm3  Fuselage_Pod-1  x  F07_M3x8_BHCS-9
      4.75 mm3  Fuselage_Pod-1  x  F07_M3x8_BHCS-8
      4.75 mm3  Fuselage_Pod-1  x  F07_M3x8_BHCS-7
      4.75 mm3  Fuselage_Pod-1  x  F07_M3x8_BHCS-10
      4.31 mm3  Wing_Panel_R-1  x  Spar_Collar-1
      4.31 mm3  Wing_Panel_L-1  x  Spar_Collar-2
      2.77 mm3  F11_M2x14_PAN-2  x  Pushrod_Rudder-1
      2.41 mm3  Wing_Panel_R-1  x  Spar_Collar-1
      2.41 mm3  Wing_Panel_L-1  x  Spar_Collar-2
      2.37 mm3  Control_Horn-3  x  Pushrod_Rudder-2
      1.54 mm3  Control_Horn-3  x  Pushrod_Rudder-2
      1.36 mm3  Fuselage_Pod-1  x  Wing_Saddle-1
      1.36 mm3  Fuselage_Pod-1  x  Wing_Saddle-1
      0.48 mm3  Gear_Clamp_Lower-4  x  N01_M3_Nylock-8
      0.48 mm3  Gear_Clamp_Lower-4  x  N01_M3_Nylock-8
      0.48 mm3  Gear_Clamp_Lower-3  x  N01_M3_Nylock-7
      0.48 mm3  Gear_Clamp_Lower-3  x  N01_M3_Nylock-7
      0.48 mm3  Gear_Clamp_Lower-2  x  N01_M3_Nylock-4
      0.48 mm3  Gear_Clamp_Lower-2  x  N01_M3_Nylock-4
      0.48 mm3  Gear_Clamp_Lower-1  x  N01_M3_Nylock-3
      0.48 mm3  Gear_Clamp_Lower-1  x  N01_M3_Nylock-3
      0.47 mm3  Gear_Clamp_Lower-4  x  N01_M3_Nylock-8
      0.47 mm3  Gear_Clamp_Lower-4  x  N01_M3_Nylock-8
      0.47 mm3  Gear_Clamp_Lower-4  x  N01_M3_Nylock-8
      0.47 mm3  Gear_Clamp_Lower-4  x  N01_M3_Nylock-8
      0.47 mm3  Gear_Clamp_Lower-3  x  N01_M3_Nylock-7
      0.47 mm3  Gear_Clamp_Lower-3  x  N01_M3_Nylock-7
      0.47 mm3  Gear_Clamp_Lower-3  x  N01_M3_Nylock-7
      0.47 mm3  Gear_Clamp_Lower-3  x  N01_M3_Nylock-7
      0.47 mm3  Gear_Clamp_Lower-2  x  N01_M3_Nylock-4
      0.47 mm3  Gear_Clamp_Lower-2  x  N01_M3_Nylock-4
      0.47 mm3  Gear_Clamp_Lower-2  x  N01_M3_Nylock-4
      0.47 mm3  Gear_Clamp_Lower-2  x  N01_M3_Nylock-4
      0.47 mm3  Gear_Clamp_Lower-1  x  N01_M3_Nylock-3
      0.47 mm3  Gear_Clamp_Lower-1  x  N01_M3_Nylock-3
      0.47 mm3  Gear_Clamp_Lower-1  x  N01_M3_Nylock-3
      0.47 mm3  Gear_Clamp_Lower-1  x  N01_M3_Nylock-3
      0.41 mm3  Fuselage_Pod-1  x  Wing_Saddle-1
      0.37 mm3  Aileron_R-1  x  Horn_Hardpoint-1
      0.37 mm3  Aileron_L-1  x  Horn_Hardpoint-2
      0.15 mm3  Wing_Panel_R-1  x  Rear_Hardpoint-1
      0.15 mm3  Wing_Panel_L-1  x  Rear_Hardpoint-2
      0.05 mm3  Fin_Shoe-2  x  Fin-2
      0.05 mm3  Fin_Shoe-1  x  Fin-1
      0.03 mm3  Rudder-2  x  Horn_Backplate-2
      0.03 mm3  Rudder-2  x  Control_Horn-3
      0.03 mm3  Rudder-1  x  Horn_Backplate-1
      0.03 mm3  Rudder-1  x  Control_Horn-1
      0.00 mm3  Servo-4  x  Pushrod_Aileron-2
      0.00 mm3  Fuselage_Pod-1  x  Canopy-1
      0.00 mm3  Fin_Shoe-2  x  Fin-2
      0.00 mm3  Fin_Shoe-2  x  Fin-2
      0.00 mm3  Fin_Shoe-1  x  Fin-1
      0.00 mm3  Fin_Shoe-1  x  Fin-1
      0.00 mm3  Fin_Shoe-1  x  Fin-1
