davinciucberkeley-collab/DBF-VTOL/docs/test/cards/DS-C01.md

# Data sheet DS-C01 — Printed hole and bore coupon (first article)
DBF-TP-001 rev B data sheet · Test C01 · Date ____ · Operator ____ · Witness ____ · Article/serials ____

Reference: docs/research/hardware-spec.md §5b (FT02, FT07, FT08) and M2. Pass: a modelled value prints 3.4 / 4.0 / 25.6 ±0.1 mm.

Printer ____ · Nozzle ____ mm · Layer ____ mm · Profile name ____ · Ambient ____ °C

| Material | Feature | Modelled (mm) | Measured 1 (mm) | Measured 2 (mm) | Mean | Offset (model − mean) |
|---|---|---|---|---|---|---|
| PETG | M3 clearance | 3.4 | | | | |
| PETG | M3 clearance | 3.6 | | | | |
| PETG | insert hole | 3.8 | | | | |
| PETG | insert hole | 3.9 | | | | |
| PETG | insert hole | 4.0 | | | | |
| PETG | insert hole | 4.1 | | | | |
| PETG | 25.4 bore ring | 25.5 | | | | |
| PETG | 25.4 bore ring | 25.6 | | | | |
| PETG | 25.4 bore ring | 25.7 | | | | |
| PETG | 22.4 joiner bore (FT06 slip fit) | 22.46 | | | | |
| PA6-CF | M3 clearance | 3.4 | | | | |
| PA6-CF | M3 clearance | 3.6 | | | | |
| PA6-CF | insert hole | 3.8 | | | | |
| PA6-CF | insert hole | 3.9 | | | | |
| PA6-CF | insert hole | 4.0 | | | | |
| PA6-CF | insert hole | 4.1 | | | | |
| PA6-CF | 25.4 bore ring | 25.5 | | | | |
| PA6-CF | 25.4 bore ring | 25.6 | | | | |
| PA6-CF | 25.4 bore ring | 25.7 | | | | |
| PA6-CF | 22.4 joiner bore (FT06 slip fit) | 22.46 | | | | |

Chosen model values → as-printed 3.4: ____ · 4.0: ____ · 22.46: ____ · 25.6: ____ (PETG) / ____ · ____ · ____ (PA6-CF). Record in cad/params.mjs notes.

## Result
PASS / FAIL · Deviations: ____ · Signed (TD) ______ Date ______
