davinciucberkeley-collab/DBF-VTOL/docs/test/cards/DS-C02-C03.md

# Data sheet DS-C02 / DS-C03 — Heat-set insert torque-out and pull-out
DBF-TP-001 rev B data sheet · Test C02 / C03 · Date ____ · Operator ____ · Witness ____ · Article/serials ____

Insert: ruthex RX-M3x5.7 (hardware-spec §2c), hole 4.0 mm as-printed (from DS-C01), boss Ø ≥ 8 mm. Install temperature ____ °C, iron ____.

## C02 torque-out (hanging-mass method, hardware-spec §2d: T = m g L)
Lever arm L = ____ m (use 0.100 m: 0.1 kg step = 0.098 N·m). Pass: every insert ≥ 1.0 N·m (hardware-spec M3).

| Material | Insert | Spin-out mass (kg) | Torque = m × 9.81 × L (N·m) | Failure mode (insert spun / boss cracked / screw stripped) | ≥ 1.0? |
|---|---|---|---|---|---|
| PETG | 1 | | | | |
| PETG | 2 | | | | |
| PETG | 3 | | | | |
| PA6-CF | 1 | | | | |
| PA6-CF | 2 | | | | |
| PA6-CF | 3 | | | | |

## C03 pull-out (lever rig, ratio R = long arm / short arm = ____ ; force at insert = m × 9.81 × R)
Pass: minimum ≥ 300 N in PETG, ≥ 400 N in PA6-CF (EST, TEST-PLAN.md C03: 10 × Tmax 30.7 N, results.json struct.Tmax).

| Material | Insert | Pull-out mass at long arm (kg) | Force at insert (N) | Failure mode | Pass? |
|---|---|---|---|---|---|
| PETG | 1 | | | | |
| PETG | 2 | | | | |
| PETG | 3 | | | | |
| PA6-CF | 1 | | | | |
| PA6-CF | 2 | | | | |
| PA6-CF | 3 | | | | |

## C04 floor crush (PA6-CF 4.5 mm floor with the rev B Ø7.5 counterbore, M3 × 8 + Ø7.0 washer to 0.6 N·m = 0.61 kg at L = 0.100 m)
Head mark angle after 24 h at room temperature: ____ ° · after 1 h at ~60 °C EST: ____ ° · Pass ≤ 30° (hardware-spec M3).

## Result
PASS / FAIL · Deviations: ____ · Signed (TD) ______ Date ______
