davinciucberkeley-collab/DBF-VTOL/docs/test/cards/DS-C05.md

# Data sheet DS-C05 — Tube receipt measurement and joiner fit
DBF-TP-001 rev B data sheet · Test C05 · Date ____ · Operator ____ · Witness ____ · Article/serials ____

Reference: hardware-spec §5a/§5b. Tolerances used: OD ±0.102 mm, wall ±0.051 mm. Calipers: ____ (resolution 0.01 mm).

| Tube | Nominal OD (mm) | OD @ end A | OD @ mid | OD @ end B | Wall A | Wall B | In tol? |
|---|---|---|---|---|---|---|---|
| Boom 1, 1.000 × 0.035 in | 25.40 / wall 0.889 | | | | | | |
| Boom 2, 1.000 × 0.035 in | 25.40 / wall 0.889 | | | | | | |
| Socket/legs, 1.000 × 0.058 in | 25.40 / wall 1.473 (ID 22.454) | | | | | | |
| Joiner, 0.875 × 0.058 in | 22.225 / wall 1.473 | | | | | | |

Fits: FT01 joiner in socket: enters by hand L / R: Y/N · measured diametral clearance ____ mm (target −0.076 to +0.534; > 0.30 → one tape wrap) · play at 1.2 m: ____ mm (≤ 5 mm, budget-airframe M4)
FT03 leg in gear socket: ____ · FT04 splice plug in boom: ____ · Straightness of joiner over 0.76 m (feeler under a straight edge): ____ mm

## Result
PASS / FAIL · Deviations: ____ · Signed (TD) ______ Date ______
