davinciucberkeley-collab/DBF-VTOL/docs/test/cards/DS-C08-C09-C10.md

# Data sheet DS-C08 / DS-C09 / DS-C10 — Hover-duty heat, pusher curve, stopped prop
DBF-TP-001 rev B data sheet · Test C08 / C09 / C10 · Date ____ · Operator ____ · Witness ____ · Article/serials ____

## C08 hover-duty heat (thrust held at 1,638 g; IR thermometer on the can and ESC every 15 s)
Pass: can ≤ 80 °C EST after 90 s; ESC ≤ 70 °C EST; no cut-out; time constant ≥ 100 s. Predicted (docs/research/thermal.md 6.1, lift-unit model, rise over ambient EST): can +15 / +28 / +39 K and ESC +11 / +21 / +28 K at 30 / 60 / 90 s (74 / 63 °C at 90 s on a 35 °C day); motor-only lumped check 76 °C at 90 s (cad/README.md). Can > 70 °C after 90 s → hot-day take-off hover limit 45 s (TEST-PLAN §6). Ambient ____ °C.

| Run | t = 0 | 15 s | 30 s | 45 s | 60 s | 75 s | 90 s | ESC at 90 s | Cool-down to 45 °C (s) |
|---|---|---|---|---|---|---|---|---|---|
| 1 | | | | | | | | | |
| 2 | | | | | | | | | |
| 3 | | | | | | | | | |
| 3×90 s / 30 s rest (limit run) | | | | | | | | | |

Time constant fit τ = ____ s (from T(t) = T_amb + ΔT∞ (1 − e^(−t/τ)); use three points).

## C09 pusher curve (X4110S + APC 14×8.5EP on the M6 adapter)
Pass: ≥ 1.5 kgf at 60 %; peak ≤ 40 A; runout < 1 mm. Cruise need 0.88 kgf (sizing, results.json D_cruise) / 0.79 kgf (aero_results drag.cruise.D_N) at 20 m/s.

| Throttle (%) | Thrust (g) | V | I (A) | P (W) | g/W |
|---|---|---|---|---|---|
| 20 | | | | | |
| 40 | | | | | |
| 60 | | | | | |
| 80 | | | | | |
| 100 | | | | | |

Bench M1 (pusher power at full pack; firmware/vtol_c0.param THR_MAX 85 comment: the C0 SITL model gives ≈ 890 W at 100 % on 25.2 V vs the X4110S 615 W rating, ≈ 547 W at 85 % EST). Pack start ____ V (≥ 25.0). 100 % for ≤ 3 s: ____ W ____ A ____ V ____ g · 85 % for 10 s: ____ W ____ A ____ V ____ g · can after ____ °C. Pass: P at THR_MAX ≤ 615 W. THR_MAX kept at 85 / lowered to ____ % · re-check level speed ≥ AIRSPEED_MAX 25 m/s in F08.

## C10 stopped prop at 20 m/s (72 km/h) on the car-roof mast, closed lot
Windmills? Y / N · stop angle from the airflow: ____ ° (≤ 30°) · drag by load cell / luggage scale: ____ N (model 0.54 N, aero_results CdA_per_rotor_unit; ≤ 0.8 N EST) · video file ____

## Result
PASS / FAIL · Deviations: ____ · Signed (TD) ______ Date ______
