davinciucberkeley-collab/DBF-VTOL/docs/test/cards/DS-C12.md

# Data sheet DS-C12 — Servo torque, speed and centering (EMAX ES3005HV × 5: L/R aileron, elevator, L/R rudder)
DBF-TP-001 rev B data sheet · Test C12 · Date ____ · Operator ____ · Witness ____ · Article/serials ____

Supply ____ V (6.0 from the FC BEC / UBEC) · arm 50 mm · masses on the kitchen scale. Rating: 8 kg·cm at 6.0 V (budget-avionics §6). 8 kg·cm at 50 mm = 1.60 kg.
Pass: stall ≥ 6.4 kg·cm (≥ 1.28 kg at 50 mm); centring ≤ 1° (≤ 0.9 mm at 50 mm); five within 10 %; no buzz under 1 kg·cm (0.2 kg). No spare servo in the BOM (rev B): a failed unit is bought from the $103.21 reserve.

| Servo s/n | Stall mass (kg) | Torque (kg·cm) = m × 5 | Centring spread (mm) | 60° sweep time (s) | Buzz at 0.2 kg? | Current at stall (A) | Pass? |
|---|---|---|---|---|---|---|---|
| 1 | | | | | | | |
| 2 | | | | | | | |
| 3 | | | | | | | |
| 4 | | | | | | | |
| 5 | | | | | | | |

## Result
PASS / FAIL · Deviations: ____ · Signed (TD) ______ Date ______
