davinciucberkeley-collab/DBF-VTOL/docs/test/cards/DS-C16-C17-S10.md

# Data sheet DS-C16 / DS-C17 / DS-S10 — First-article fits, joiner slip fit and stops, ballast retention (rev B)
DBF-TP-001 rev B data sheet · Test C16 / C17 / S10 · Date ____ · Operator ____ · Witness ____ · Article/serials ____

## C16 F05 M3 × 30 gear-clamp cross-bolt and motor counterbore Ø7.5 (cad/README.md fasteners; cad/hardware.json; drawing sheet 5)
| Check | Measured | Pass | OK? |
|---|---|---|---|
| F05 head-to-leg-tube clearance (mm) | | ≥ 0.5 | |
| F05 nut-to-leg-tube clearance (mm) | | ≥ 0.5 | |
| Nylock threads past the nut | | ≥ 2 | |
| Ø7.0 washer seats flat in Ø7.5 counterbore (4 of 4) | | flat, no edge contact | |
| Motor screw tip proud of the 4.5 mm floor (mm), 4 screws | | ≤ 3.2 (hardware-spec M4; > 3.3 reaches the windings) | |

## C17 joiner slip fit and Joiner_Stop retention (cad/README.md wing root; hardware.json J11/FT06)
| Check | Measured | Pass | OK? |
|---|---|---|---|
| Push force to slide the joiner through the saddle and into both sockets (kitchen scale, kg) | | ≤ 5 EST | |
| Axial push on the bolted wing from each tip end (bathroom scale, kg) — stop disc holds? | L ____ R ____ | 10 kg (98 N), no movement | |
| Push force after 10 slide cycles (kg) / joiner OD wear (mm) | | unchanged / ≤ 0.05 | |
| Pod transport piece length with the joiner out (m) | | ≤ 0.5 (R4) | |
| Time to slide out and re-insert (s) | | record for G07 | |

## S10 ballast-mount retention (0.5 kg block, mass on the kitchen scale ____ kg; station ____ mm from the LE)
| Direction | Pull (kg) | Force (N) | Movement (mm) | Pass ≤ 2 mm | OK? |
|---|---|---|---|---|---|
| Down | 8.0 | 78 | | | |
| Forward | 8.0 | 78 | | | |
| Sideways | 8.0 | 78 | | | |
| Shake 10 s | — | — | | | |
| After S06 drops | — | — | | | |
Basis: 2 × (0.5 kg × 8 g) = 78 N (S06 limit 8 g, factor 2 EST); 4.5 g ultimate manoeuvre = 22 N.

## Result
PASS / FAIL · Deviations: ____ · Signed (TD) ______ Date ______
