davinciucberkeley-collab/DBF-VTOL/docs/test/cards/DS-S02-S04.md

# Data sheet DS-S02 / DS-S03 / DS-S04 / DS-S05 — Boom stiffness, modal, clamp slip, motor mount
DBF-TP-001 rev B data sheet · Test S02–S05 · Date ____ · Operator ____ · Witness ____ · Article/serials ____

## S02 boom tip deflection (arm 0.462 m from the front clamp, results.json struct.Lb v0.4). Pass: ≤ 4.0 mm at 29.4 N (1.5 × FEA 2.70 mm = 4.05); residual 0; no slip.
| Hung mass (kg) | Force (N) | Deflection boom L (mm) | boom R (mm) | Witness line moved? |
|---|---|---|---|---|
| 1.0 | 9.8 | | | |
| 2.0 | 19.6 | | | |
| 3.0 | 29.4 | | | |
| 0 (residual) | 0 | | | |
Predicted: 2.70 mm FEA (CAD rev D, 0.462 m arm, cad/sim/results.txt boom_disp_max) / 2.84 mm hand (results.json struct.defl_max) at 30.7 N.

## S03 tap test (phone accelerometer app ____ , sample rate ____ Hz, phone taped at the motor mount)
| Boom | Plane | f1 run 1 (Hz) | run 2 | run 3 | mean | within 26–41 Hz? | hover rotor freq (Hz, from C07 rpm/60) | ±15 % of 1× or 2×? |
|---|---|---|---|---|---|---|---|---|
| L | vertical | | | | | | | |
| L | lateral | | | | | | | |
| R | vertical | | | | | | | |
| R | lateral | | | | | | | |
Predicted 32.3 Hz hand (results.json struct.fn), 34.4 Hz FEA (CAD rev D, cad/sim/results.txt boom_f1).

## S04 clamp and splice slip
Torsion 2 kg × 0.25 m = 4.9 N·m at the motor mount: witness moved? L ____ R ____ · at the tail clamp: L ____ R ____
Bending 4.69 kg (46 N = 1.5 × Tmax) at the front motor station: rotation at front clamp ____ ° / rear clamp ____ ° (≤ 1°) · cracks? ____

## S05 motor mount pull: 6.26 kg (2 × Tmax) from the bell for 60 s: crack? ____ insert movement? ____ re-torque angle ____ ° (≤ 30°)

## Result
PASS / FAIL · Deviations: ____ · Signed (TD) ______ Date ______
