davinciucberkeley-collab/DBF-VTOL/docs/test/cards/DS-S06.md

# Data sheet DS-S06 — Landing-gear drop test (0.30 m)
DBF-TP-001 rev B data sheet · Test S06 · Date ____ · Operator ____ · Witness ____ · Article/serials ____

Article: airframe ballasted to 6.55 kg with a jug in the bay (results.json sized.m v0.4); leg fairings fitted; ballast mount (S10) fitted (no flight pack); FC logging (LOG_DISARMED 1, restore after) or phone accelerometer at the CG. Surface: grass. Feet fitted: bare dome / foam / TPU (circle).
Pass: peak ≤ 8 g (review M8.3); no crack or set. Predicted: 2.43 m/s impact; bare legs 8–32 g (results.json struct.strokes) — expected to fail without compliant feet.

| Drop | Height under feet (m) | Peak accel (g) | Source (IMU log / phone) | Leg set? | Gear clamp / boom clamp witness | Fairings ok? | Ballast moved (mm)? | Pod contact? |
|---|---|---|---|---|---|---|---|---|
| 1 | 0.30 | | | | | | | |
| 2 | 0.30 | | | | | | | |
| 3 | 0.30 | | | | | | | |
Estimated stroke from n = 2(1 + h/s): s = 2h/(n − 2) = ____ mm.

## Result
PASS / FAIL · Deviations: ____ · Signed (TD) ______ Date ______
