davinciucberkeley-collab/DBF-VTOL/review/test-plan.html

Skip to content

← Design review DBF-RPT-001DBF-TP-001 Full document

# Test and evaluation plan: C0 lift + cruise VTOL

DBF-TP-001Contents

Section

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

## 1. Purpose and scope

This plan takes the aircraft from incoming parts to a verified full mission (R9) and closes every requirement R1–R20 by Test, Analysis, Inspection or Demonstration with a numeric pass/fail criterion. It covers:

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

## 2. Test philosophy

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

## 3. Roles

Role | Duties | Minimum qualification
Test director (TD) | Owns the test card, calls go/no-go, holds the abort authority, signs the data sheet. | Has read this plan and the card; not the pilot.
Safety officer (SO) | Range clear, fire bag + extinguisher + first-aid kit, LiPo handling, crowd line, calls "abort" for any safety breach. | TRUST or Part 107 (R18).
Pilot in command (PIC) | Flies; is the only person who touches the transmitter; has passed SITL rehearsal E06 (§12 M1 of the review). | TRUST (or Part 107), AMA member for liability (R19), ≥ 1 h SITL on firmware/vtol_c0.param.
GCS operator (GCS) | Reads the handset CRSF telemetry (or Mission Planner over the ELRS MAVLink overlay / CoreWing BLE-WiFi near the pad): battery, mode, altitude, VIBE, EKF status every 30 s; saves logs. | Has run E06 scenarios.
Visual observer (VO) | Keeps VLOS on the aircraft and the sky (R18); part of the 4-person team. | —

Crew roles are the review's (§12 "Crew, field procedure and charging") with the test director added. Names: — (assign in the matrix "Crew" column at sign-off).

## 4. Safety rules

1. Props off for every bench test unless the card says otherwise. Battery is plugged in last through the XT90-S (R20, §10) and unplugged first.
2. Arming. RC arm switch (CH5, RC5_OPTION,153) only; no stick arming (ARMING_RUDDER,0); arming only in VTOL modes (Q_OPTIONS bit 18). Motor emergency stop on CH7 (RC7_OPTION,31). Source: firmware/vtol_c0.param §7–8.
3. LiPo. Charge and store in the LiPo bag inside the ammo can; never unattended; crashed pack isolated outdoors 30 min (§12 review). Fire bag within 5 m of any powered test.
4. Thrust stand and tied-down runs. Prop plane never in line with a person; 3 m clear radius; eye protection; stand bolted or sandbagged so that it cannot move at 3.13 kgf (X4110S max, docs/research/budget-lift.md A3) × 4.
5. Structural tests. Nobody under a loaded wing; load in 1 kg steps; a second person watches the joiner region.
6. Flight. VLOS at all times; geofence FENCE_ALT_MAX,110 m home-relative (SITL breach peak 113.1 m, under the 121.9 m (400 ft) limit, firmware/sitl/README.md scenario F; R18); crowd line 30 m from the take-off point and never under the flight path; flight path over open ground only; no people downrange during transitions.
7. Ballast rule. Without a payload, 0.5 kg of ballast is fitted in the payload bay for every flight (static margin 5.1 % at the empty-bay CG vs 11.8 % at 28 % MAC, aero_results.json neutral_point.static_margin_pct; cad/README.md operating rule; cad/drawings/DBF-DRW-001.PDF sheet 1 note 5).
8. Post-flight. IR thermometer on every motor, ESC and the pack within 30 s of landing (§11 M1 of the review): pack > 60 °C EST or any unit 15 °C hotter than its neighbours grounds the aircraft.
9. Heat (docs/research/thermal.md; review §10 "Heat dissipation across the aircraft"). The thermal model (35 °C day) leaves 17 K on the lift motor and 14 K on its ESC after a 60 s hover but only 2 K and 4 K at the end of the take-off hover + transition, and puts a pack at the C11 resistance limit at 64 °C at touchdown. So: the ≤ 60 s per hover rule (§2 item 3) is load-bearing and stays; the post-flight IR limits above stay; hot-day pack and hover rules are in §6.

## 5. Abort criteria (all tests)

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

Trigger | Threshold | Source
Vibration | VIBE X/Y/Z > 30 m/s² sustained or clipping count rising | ArduPilot "Measuring Vibration" (ardupilot.org/plane/docs/common-measuring-vibration.html, checked 2026-10-21)
Attitude error in hover | > 15° | review §12 F2
Oscillation | Any visible attitude or altitude oscillation | ArduPilot QuadPlane tuning step 5 (ardupilot.org/plane/docs/quadplane-vtol-tuning-process.html, checked 2026-10-21)
Battery | Sag-compensated voltage < 21.0 V (3.5 V/cell) or < 1,950 mAh remaining on any non-mission flight (the firmware's low-battery RTL point) | firmware/vtol_c0.param BATT_LOW_VOLT, BATT_LOW_MAH, BATT_FS_LOW_ACT 1 (RTL); critical 19.8 V / 1,300 mAh → QLAND
Temperature | Motor can > 80 °C EST after a hover; ESC > 70 °C EST | review §11 T3; ESC limit EST (SoloGood publishes none, —)
Wind | Steady > 5 m/s or gusts > 8 m/s (R16); for F01–F06, steady > 3 m/s EST | R16; EST for early flights
RC link | LQ < 70 % EST or any failsafe message | EST
GCS/EKF | "EKF variance", "GPS glitch", compass inconsistent | ArduPilot pre-arm/EKF messages
Fence proximity | Aircraft within 50 m of the 300 m fence circle in fixed-wing flight (a straight transition reaches it ~6 s after "Transition done", firmware/sitl/README.md) | FENCE_RADIUS,300; SITL finding
People or animals inside the range | any | —
Airspace | Any manned aircraft within sight and converging | R18 VLOS and right-of-way

## 6. Go/no-go and weather limits

Go for any flight test requires all of:

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

## 7. Range setup

- Take-off pad: 3 × 3 m flat mown grass or hard surface, clear of obstacles 20 m radius, marked with the geofence home point.
- Crew line 30 m upwind of the pad; spectators behind the crew line. Fire bag, extinguisher and first-aid kit at the crew line.
- Transition runway: a straight ≥ 200 m EST into wind at ≥ 30 m AGL (review M15.1: under 200 m or a ceiling under 30 m blocks R9 at that site). Transitions start at the upwind field edge with an immediate turn after "Transition done" (firmware/README.md §9.6; SITL: a straight transition reached the 300 m fence circle about 6 s after transition end). GPS-walk the field and set FENCE_RADIUS to the usable radius (default 300 m, firmware/vtol_c0.param §10).
- Tether anchor (G05): two sandbag-weighted ground stakes, 2 × 4 m lines of ≥ 50 kg rated cord to the landing-leg clamps, slack so the aircraft can reach 1.5 m.
- Site ceilings: RFS 400 ft, Clark Kerr 200 ft, La Loma 20 ft inside the fences (R19). Only RFS supports transition tests.

## 8. Verification cross-reference matrix

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

Req | Requirement (short) | Method | Test ID(s) | Pass criterion (numeric) | Status
R1 | Lift rotors + pusher + wing; lift rotors stopped in cruise | I, D | I03, F07, F12 | Built aircraft matches cad/drawings/DBF-DRW-001.PDF rev E sheet 1; log shows lift motor outputs (RCOU C5–C8) at Q_M_PWM_MIN (1000) for ≥ 95 % of cruise time | open
R2 | MTOW 8–15 kg target, < 25 kg cap; outcome 6.55 kg | T | S09, G01 | Take-off mass with pack and 0.5 kg ballast ≤ 6.55 × 1.15 = 7.53 kg (calc, review M3.1 margin; sized.m) and < 25 kg | open
R3 | Span 2–3 m | I | I03 | Tip-to-tip 2.40 ± 0.02 m (results.json base.span) | open
R4 | Largest piece fits a standard car | D | S08 | Longest piece ≤ 1.2 m (geo.longestPiece); pod piece ≤ 0.5 m with the joiner slid out (cad/README.md wing root); every piece fits in the team's car with the hatch closed | open
R5 | Two-person carry; assembly ≤ 15 min | D | S08, G07 | Two people carry the assembled aircraft 50 m; median of 3 assembly runs ≤ 15 min | open
R6 | Spend ≤ $2,000 incl. tax and shipping | I | I01 | Ledger of receipts ≤ $2,000.00 (BOM committed $1,896.79) | open
R7 | Second pack, spares, reserve ≥ $100 target | I | I01 | Two packs, spare motor, spare ESCs (3 in the two 4-packs), spare props received; reserve = 2,000 − ledger ≥ $100 (BOM $103.21) | open
R8 | Flight-tested by 2027-04-30 | D | F12 | F12 passed and dated ≤ 2027-04-30 | open
R9 | Mission: VTOL take-off → hover → transition → cruise → back-transition → hover → vertical land | D | F12 | One continuous flight with all phases in the log, no failsafe, undamaged landing | open
R10 | ≥ 10 min cruise + ≥ 2 min hover, ≥ 20 % energy reserve | T, A | C11, F08, F13, F12 | F12 log: cruise ≥ 600 s, hover ≥ 120 s, remaining ≥ 20 % of measured usable capacity (C11) and ≥ 1,300 mAh (BATT_CRT_MAH); cruise power at 20 m/s ≤ 414 W (calc: (0.8 × 144.3 × 0.95 − 915.7 × 160/3600) × 3600/600 = 414 W, sized.P_hover, base) | open
R11 | Cruise 18–22 m/s; stall ≤ 12 m/s; transition complete ≥ 1.3 × Vs | T, A | F08, F09, C09 | Trimmed cruise at 20 ± 2 m/s calibrated airspeed; measured Vs ≤ 12.0 m/s (predicted 11.75 m/s at the design stall target, aero_results.json stall, 2.1 % speed margin; 12.0–12.5 = team decision, aero §9; > 12.5 fail, docs/research/aerodynamics.md M2); AIRSPEED_MIN 16 ≥ 1.3 × measured Vs (Vs ≤ 12.3); airspeed calibration error ≤ 10 % | open
R12 | 0.5 kg payload reserve and bay volume | I, D | G01, G09, S10, F12 | 0.5 kg ballast fits the bay, is retained at 2 × 8 g, and is flown in F12 within CG limits | open
R13 | Hover T/W ≥ 1.6 at MTOW, storage-low voltage | T | C07, F03 | Each motor ≥ 2.62 kgf max at 3.7 V/cell (22.2 V) on the stand (= 1.6 × 6.55 / 4 (calc); maker 3.13 kgf); learned Q_M_THST_HOVER ≤ 0.60 | open
R14 | Lift motor-out: cruise continues (hard); hover (desired, not met by C0) | A, D, I | E06, F07, I03 | SITL motor-fail scenario in hover (documents the accepted limitation; open — not in the A–G set); cruise with lift motors stopped shown in F07; hover limits ≤ 5 m AGL / ≤ 60 s written on every hover card | open
R15 | Pusher-out in cruise → re-enter hover and land | D | E06, F10 | SITL D (transition timeout → QRTL) done; in flight: pusher to idle at ≥ 60 m, Q_ASSIST engages below 13 m/s, QLAND completes, altitude loss ≤ 30 m EST | SITL done; flight open
R16 | Operate in steady wind ≤ 5 m/s, gusts ≤ 8 m/s | D, A | F07, F12 | At least one F07 or F12 flight in recorded steady wind 3–5 m/s with attitude error < 15°; gusts to 8 m/s by analysis only (margin: AIRSPEED_MIN 16 vs Vs 11.75) | open
R17 | Open-source autopilot with maintained VTOL support | I | E11 | Flight firmware is ArduPlane 4.7.2 stable for CoreWingF405WingV2 (firmware/vtol_c0.param header; docs/research/firmware.md §4 R10/R20: beta risk closed) | open (firmware identified; flash check pending)
R18 | FAA: 44809/Part 107, TRUST, registration, Remote ID, VLOS, ≤ 400 ft | I, T | I02, E12 | Documents on file; BeeID serial on uasdoc.faa.gov; broadcast seen on a Remote ID app; FENCE_ALT_MAX 110 m (SITL peak 113.1 m) | open
R19 | Campus: flight request, post-flight report, $1M liability | I | I02 | Approved request on file ≥ 7 business days before each on-campus flight; AMA card per pilot | open
R20 | Arming switch/kill, failsafe RTL-then-land, geofence | T, D | E05, E06, F05, F10 | SITL B/C/E/F/G done (firmware/sitl/results/summary.json; repeated on the C0 airframe model 2026-10-25, firmware/sitl/results_c0.json); bench and in flight: RC loss → QLAND (hover) / RTL → QRTL (cruise); low battery → RTL, critical → QLAND; fence breach → RTL; XT90-S disconnect and CH7 E-stop demonstrated | SITL done; hardware/flight open

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

## 9. Test series

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

1. 9.1 Series C: component and coupon tests
2. 9.2 Series S: structural tests on the built airframe
3. 9.3 Series E: electrical and avionics bench tests
4. 9.4 Series G: ground tests on the complete aircraft
5. 9.5 Series F: flight tests
6. 9.6 Series I: documentary inspections

### 9.1 Series C: component and coupon tests

#### C01: Printed hole and bore coupon (first article)

- Objective. Set the printer's as-printed offsets so every bore and insert hole meets docs/research/hardware-spec.md §5b (FT02, FT07, FT08) and the rev E drawing tolerance block (cad/README.md drawing set).
- Article. One coupon per material (ELEGOO PETG, Polymaker PA6-CF20) printed on the team printer: M3 clearance holes modelled 3.4 / 3.6 mm, insert holes 3.8 / 3.9 / 4.0 / 4.1 mm, a 25.4 mm bore ring modelled 25.5 / 25.6 / 25.7 mm (hardware-spec M2), plus a 22.4 mm joiner bore ring (FT06 slip fit, 22.455 ± 0.20).
- Instrumentation. Calipers (hand tools, R6) or drill-shank gauges.
- Procedure. (1) Print both coupons with the production profile. (2) Measure each hole at two diameters. (3) Choose the model value that prints 3.4, 4.0, 22.46 and 25.6 ± 0.1 mm. (4) Record the offsets in cad/params.mjs notes.
- Data. Hole ID vs modelled value, per material.
- Pass. A model value exists for each target within ± 0.1 mm; otherwise adjust flow/scale and reprint (fail = no setting reaches ± 0.2 mm).
- Predicted. Desktop FDM ± 0.5 %, floor ± 0.5 mm (Xometry FDM tolerances via hardware-spec §5b, checked 2026-10-21): expect holes 0.2–0.4 mm undersize.
- Risk. PA6-CF needs a hardened nozzle (review §16 "Prints"); if the printer cannot, PETG mounts are not acceptable near motors (HDT ~68 °C, review M8.2) → Gap list.
- Duration 3 h print + 0.5 h. Crew 1. Prereq. Filament received (Order B).

#### C02: Heat-set insert torque-out, PETG and PA6-CF

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

#### C03: Heat-set insert pull-out, PETG and PA6-CF

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

#### C04: Motor-floor crush and relaxation (PA6-CF)

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

#### C05: Tube receipt measurement and joiner fit

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

#### C06: Thrust-stand build and calibration (review T1, accuracy 2 % of reading)

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

#### C07: Lift motor thrust curve, every motor (review T2, R13 strict)

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

#### C08: Hover-duty heat (review T3, expanded)

- Objective. Validate the lift-unit thermal model (docs/research/thermal.md §6.1) and the lumped motor model (90 s hover ≈ 76 °C, cad/README.md), and replace the 20 % loss estimate that sets every lift-unit temperature (thermal.md §6.1 sensitivity) with a measured rise and time constant.
- Setup. C06 stand; thrust held at 1,638 g (hover) by throttle; IR thermometer on the motor can (bell) and ESC heat-shrink every 15 s; ambient logged.
- Procedure. (1) Start at ambient. (2) Hold hover thrust 90 s, reading temperatures every 15 s. (3) Cool with the prop at idle until the can < 45 °C. (4) Repeat 3 times. (5) One run of 3 × 90 s with only 30 s rests (worst case, never flown) to find the limit. (6) Fit the time constant.
- Pass. Can ≤ 80 °C EST after one 90 s run; no ESC cut-out; ESC ≤ 70 °C EST; measured time constant ≥ 100 s (review M10.2: under 100 s invalidates the lumped model).
- Predicted. Lift-unit model (docs/research/thermal.md §6.1; SOLIDWORKS transient, motor + PA6-CF mount + boom + ESC in prop wash, 45.8 W = 20 % of 229 W per motor EST, ESC 4 % EST): rise above ambient at 30 / 60 / 90 s can +15 / +28 / +39 K, ESC +11 / +21 / +28 K (74 °C / 63 °C at 90 s on a 35 °C day, 59 °C / 48 °C on a 20 °C day); the can crosses 80 °C at ≈ 110 s and the ESC 70 °C at ≈ 125 s of continuous hover; τ ≈ 300 s. Motor-only lumped check 76 °C at 90 s (c 470 J/kgK EST, 74–83 °C for c 500–385, cad/README.md); steady upper bound 143.9 °C at 45.8 W, h = 50 W/m²K EST (cad/sim/results.txt motor_T_steady, re-run 2026-10-25 on CAD rev D). A can > 70 °C after 90 s triggers the hot-day 45 s take-off hover limit (§6).
- Duration 2 h. Crew 2. Prereq. C07.

#### C09: Pusher thrust curve, X4110S + APC 14 × 8.5EP (review T4, expanded)

- Objective. Static thrust and current of the pusher set; set TKOFF_THR_MAX, confirm the transition current budget, and confirm THR_MAX 85 by bench measurement M1 (pusher power at full pack).
- Setup. C06 stand with the pusher adapter (M6 bolt-on, hardware-spec J03b); throttle 20–100 % in 10 % steps. M1: a pack at ≥ 25.0 V (full charge); 100 % for ≤ 3 s, then 85 % (THR_MAX) for 10 s; record W, A, V, thrust and the can temperature by IR.
- Pass. Static thrust ≥ 1.5 kgf at 60 % throttle (review T4); peak current ≤ 40 A (review M8.3; above that drop to a 13 × 8 prop); prop runout by eye < 1 mm at the tip (FT10 spin check); M1: electrical power at THR_MAX on a full pack ≤ 615 W (X4110S rating at 22.2 V, docs/research/budget-lift.md A3), else lower THR_MAX and re-check the level speed at full throttle ≥ AIRSPEED_MAX 25 m/s in F08.
- Predicted. — (no vendor table for 14 × 8.5EP on the X4110S, docs/research/pusher-battery-servo.md §1b). Cruise thrust needed 8.6 N = 0.88 kgf at 20 m/s (sizing, sized.D_cruise) or 7.7 N (aero build-up, aero_results.json drag.cruise.D_N); P_cruise 337 W / 15.2 A (sizing) or 302 W / 13.6 A (aero) at η_prop 0.6 EST (sized.P_cruise, aero_results.json mission). C0 SITL model (firmware/sitl/README.md trim validation, APC 14 × 8.5 data, EST motor model): cruise 233 W / 14.0 A at η_prop ≈ 0.74; static 3.35 kgf at 626 W / 28 A on 22.2 V; ≈ 890 W at 100 % on 25.2 V, so THR_MAX 85 ≈ 547 W (est., throttle³ scaling, firmware/vtol_c0.param).
- Duration 1 h. Crew 2. Prereq. C06.

#### C10: Stopped-prop behaviour and drag (review T5 + §14 M1)

- Objective. Confirm an unpowered lift prop does not windmill at cruise speed and measure its drag.
- Setup (zero-cost). Motor + prop on a mast on a car roof rack (or held out of a window on a 1 m pole by a passenger — only on a closed lot), unpowered, 20 m/s = 72 km/h = 45 mph by the car speedometer; phone video; for drag, the unit on a pivot arm with a luggage scale (Gaps) or the HX711 load cell reading the arm force.
- Pass. No windmilling (review T5); prop stops ≤ 30° from the airflow direction (review M14.1); drag ≤ 0.8 N per stopped unit EST (model 0.54 N = ½ ρ V² CdA with CdA_rotor 0.00222 m², aero_results.json drag.CdA_per_rotor_unit (calc); docs/research/aerodynamics.md M3: ΔP > 60 W across four units means the prop Cd EST is low and a prop-parking scheme is needed).
- Risk. Road safety: closed lot, driver only drives, ≤ 72 km/h.
- Duration 1 h. Crew 3. Prereq. C07.

#### C11: Battery capacity, sag and internal resistance

- Objective. Measure usable energy, voltage sag at hover and transition current, and per-cell internal resistance of both Ovonic 6S 6500 packs.
- Setup. Discharge load = two lift motors on the C06 stand or the tied-down airframe at a constant current near cruise (15 A, sized.I_cruise 15.2 A; review M7.4 said 16 A) with the watt meter logging Wh, V, A; the IR thermometer on the pack; cell voltages by the charger's balance readout at rest.
- Procedure. (1) Full charge (4.20 V/cell). (2) Rest 30 min; record resting V. (3) Discharge at 15 ± 2 A until 3.50 V/cell under load (21.0 V); log Wh, Ah, V every 30 s (watt meter readout on phone video). (4) At 50 % delivered Ah, pause and apply a 10 s step to 41 A (hover, sized.I_hover 41.2 A) and a 3 s step to ≈ 76 A (sized.I_trans 75.7 A, four lift motors at ≈ 60 % plus pusher, or two motors at full): record V before and during. (5) Rest 30 min; record recovery voltage and pack temperature. (6) Recharge, log mAh returned. (7) Reduce with docs/test/analysis/battery_test.py.
- Pass. Delivered ≥ 110 Wh from 4.20 to 3.50 V/cell at 15 A (0.8 × 144.3 × 0.95 = 109.7 Wh (calc): the energy the sizing assumes usable before the 20 % reserve); sag ≥ 3.4 V/cell at 41 A and ≥ 3.2 V/cell at the 76 A step (review M8.4); per-cell internal resistance ≤ 7.3 mΩ (= (3.70 − 3.40) / 41.2 A (calc), EST); hot-day acceptance: > 5 mΩ/cell is a hot-day no-go (§6; docs/research/thermal.md §6.4 item 2: the XPS bay is adiabatic, so a pack at the 7.5 mΩ/cell limit ends a 35 °C mission at 64 °C; > 5 mΩ/cell means a > 20 K rise) — write the measured value on the pack label; pack ≤ 60 °C EST after discharge; both packs within 3 % of each other.
- Predicted. 144.3 Wh nameplate (packs[0].Wh); loaded-pack voltage 21.0 V at hover (firmware/vtol_c0.param BATT_LOW_VOLT comment); mission needs 102.0 Wh from the pack (96.93 / 0.95 (calc, sized.E_Wh, base.etaBatt)), landing at 29 % of nameplate (calc: (144.3 − 102.0) / 144.3). Pack temperature rise over a full mission ≈ 3.9 K per mΩ/cell (calc: 29.1 K at 7.5 mΩ/cell, thermal.md §5; 28 K at the 7.3 mΩ/cell pass limit); with the battery-bay vents (BUILD-MANUAL 8.2a) about 56 °C at touchdown from 35 °C at the limit pack (thermal.md §6.4 item 1, EST).
- Risk. Over-discharge: watch 3.5 V/cell; LiPo bag under the pack.
- Duration 2 h per pack. Crew 2. Prereq. C06.

#### C12: Servo torque, speed and centering (EMAX ES3005HV × 5, no spare)

- Objective. Confirm each of the five flight servos (2 ailerons, elevator, 2 rudders; docs/purchasing/C0_BOM.csv) meets its rating at the FC servo-rail voltage and centres repeatably. The BOM carries no spare servo: a failed servo is replaced from the $103.21 reserve (BOM "Crash reserve").
- Setup. Servo on a bench block, 50 mm arm, luggage scale or hanging jug on a string over a pulley (zero-cost: masses only), bench 6.0 V from the FC BEC or a UBEC (hardware kit, BOM); servo tester or FC output.
- Procedure. (1) Centre at 1500 µs; mark. (2) Hang masses at 50 mm until the arm stalls (torque = m g × 0.05 m: 8 kg·cm = 0.785 N·m needs 1.60 kg at 50 mm (calc)); hold ≤ 2 s to avoid heating. (3) Command ± 45°, measure travel. (4) Return to centre 10 times from each side; measure the arm tip position. (5) Time a 60° sweep by phone video (30 fps).
- Pass. Stall ≥ 6.4 kg·cm at 6.0 V (80 % of the 8 kg·cm rating, EST; rating from docs/research/budget-avionics.md §6, shop.emax-usa.com checked 2026-10-13); centring repeatability ≤ 1° (≤ 0.9 mm at 50 mm (calc), EST); no buzzing at centre under 1 kg·cm; all five within 10 % of each other.
- Predicted. 8 kg·cm at 6.0 V, 10 at 7.4 V (budget-avionics §6). Hinge-moment need: ≤ 4 kg·cm per aileron (review M17.3; measured in S07). Pushrods: 2-56 Du-Bro Kwik-Link cut to the CAD lengths (ailerons 48 mm, elevator 40 mm, rudders 102 mm, cad/mesh/meta.json; cad/params.txt rodAileron / rodElevator / rodRudder); the 5-pack covers five surfaces with no spare pushrod.
- Duration 1.5 h. Crew 1. Prereq. Order B.

#### C13: Harness, connector and ESC heating

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

#### C14: Tape-skin mass sample (review M6.4)

- Objective. Check the wing skin mass assumption before the sizing is frozen for the build.
- Procedure. Cut a 0.5 m² XPS sample, weigh on the kitchen scale, tape one side as per the build, weigh again.
- Pass. ≤ 0.1 kg/m² per side (review M6.4); otherwise update base.wGlass (0.06 kg/m², results.json) and re-run analysis/sizing.mjs.
- Duration 0.5 h. Crew 1. Prereq. Foam and tape received.

#### C15: Prop and hub inspection

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

#### C17: Joiner slip fit and joiner-stop retention (new in rev B)

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

### 9.2 Series S: structural tests on the built airframe

#### S01: Wing static proof load (limit load, 3.0 g)

- Objective. Prove the wing, joiner, joiner stops, sockets and saddle at limit load and compare tip deflection with the FEA.
- Article. Complete wing (both panels on the saddle and joiner, M5 wing bolts torqued to 1.0 N·m EST, hardware-spec J10), no aileron servos needed.
- Setup. Wing inverted on two padded supports at the pod width (saddle edges, ≈ 0.1 m each side of centre); ruler or dial gauge at each tip against a fixed reference; sandbags or water jugs (kitchen-scale-weighed, ± 10 g) at six stations per side.
- Load schedule. Total 15.5 kg = n × (m − m_wing) = 3.0 × (6.55 − 1.39) (calc; sized.m, sized.m_wing; the wing's own 1.39 kg already loads the spar in the inverted position, so this is slightly above 3.0 g at the root — conservative). Elliptic spanwise: per side, stations at 0.1 / 0.3 / 0.5 / 0.7 / 0.9 / 1.1 m from centre: 1.64 / 1.59 / 1.49 / 1.33 / 1.08 / 0.62 kg (calc: elliptic integral over 0.2 m bins, data sheet cards/DS-S01.md). Chordwise at 30 % chord (spar line; chord 0.284 m, sized.chord).
- Procedure. (1) Zero the tip gauges. (2) Load symmetrically in four increments (25, 50, 75, 100 % of schedule), reading both tips each step; listen for cracking; look at the socket foam cover and the saddle bolts. (3) Hold 100 % for 30 s (review M6.1). (4) Unload in the same steps. (5) Record residual tip deflection after 5 min. (6) Slide the joiner out and inspect for marks or bow against a straight edge; check the stop discs are still bonded.
- Pass. Tip deflection at 100 % ≤ 120 mm (10 % of the 1.2 m semi-span, review M6.1); residual ≤ 2 mm EST; no permanent set in the joiner (straightness ≤ 0.5 mm over 0.76 m, EST); no foam crush at the sockets; no bolt loosening; stop discs intact.
- Predicted. Spar tip 15.5 mm at 3.0 g, scaled from the FEA 23.2 mm at 4.5 g (cad/sim/results.txt spar_tip_disp × 3/4.5 (calc); FEA re-run 2026-10-25 on CAD rev D at the root moment 73.6 N·m, struct.Mroot, cad/README.md simulations). The FEA bonds an idealised joiner (OD = socket ID), so the real wing with 0.23 mm joiner clearance and foam compliance will deflect more; between 15 and 60 mm is the expected band (EST). Root moment at 3.0 g: 49.1 N·m = n W b / (3π) (calc; struct.Mroot 73.6 × 3/4.5); joiner stress 105 MPa, RF 2.62 on 275 MPa yield (struct.sigJ 157.5 MPa × 3/4.5 (calc)).
- Risk. A failure drops 15 kg of bags: nobody under the wing; pad the floor.
- Duration 2 h. Crew 3. Prereq. C05, C17, wing built.

#### S02: Boom static stiffness (review M10.1)

- Objective. Measure boom tip deflection under a known load with the real printed clamp to check the FEA boundary condition.
- Setup. One boom clamped in its front and rear wing clamps on the wing (or in a bench fixture using the real clamps); a jug of known mass hung at the front motor station (arm Lb = 0.462 m, struct.Lb); ruler/dial gauge at the motor station.
- Procedure. Hang 1.0, 2.0, 3.0 kg (9.8–29.4 N, up to the 30.7 N full-thrust case struct.Tmax); read deflection each step and after removal.
- Pass. Deflection at 3.0 kg ≤ 1.5 × prediction = 4.0 mm (review M10.1 rule; 1.5 × FEA 2.70 mm = 4.05 mm (calc), rounded down); residual 0; no clamp slip (witness line).
- Predicted. 2.84 mm hand (P L³ / 3EI, struct.defl_max), 2.70 mm FEA at 30.7 N (cad/sim/results.txt boom_disp_max, re-run 2026-10-25 on CAD rev D at the arm Lb 0.462 m).
- Duration 1 h. Crew 2. Prereq. Booms built.

#### S03: Boom modal tap test (review M6.2)

- Objective. First bending frequency of each boom with the lift unit fitted, vs the hand 32.3 Hz / FEA 34.4 Hz.
- Setup. Aircraft assembled on its gear; phone taped to the motor mount running a free accelerometer logging app (e.g. phyphox, phyphox.org, free; EST adequacy: phone IMU rates 100–400 Hz give ≤ 50–200 Hz bandwidth); tap the motor with a rubber mallet handle.
- Procedure. 10 taps per boom, vertical then lateral; export the accelerometer CSV; FFT in the app or with numpy; read the first peak.
- Pass. f1 within 26–41 Hz EST (hand 32.3 Hz − 20 % to FEA 34.4 Hz + 20 % (calc)) in both planes; and not within ± 15 % of the hover rotor frequency or twice it (review M6.2). Hover rpm comes from C07 throttle and the no-load 8,880 rpm × throttle fraction EST (BLHeli_S has no telemetry on these ESCs, —).
- Predicted. 32.3 Hz hand at the 0.462 m arm (struct.fn), 34.4 Hz FEA (cad/sim/results.txt boom_f1, re-run 2026-10-25 on CAD rev D); a compliant clamp lowers it (analysis/sizing.mjs comment on fn).
- Duration 1 h. Crew 2. Prereq. S02.

#### S04: Boom clamp and splice slip proof (hardware-spec M7, review M6.5)

- Objective. Prove the printed clamps and the rear splice do not slip under full thrust or torsion.
- Procedure. (1) Torsion: hang 2 kg on a 0.25 m lever (4.9 N·m, hardware-spec M7) from a motor mount, then from the tail clamp; check the paint witness line. (2) Bending: hang 1.5 × Tmax = 46.0 N (4.69 kg (calc; struct.Tmax)) from the front motor station with the rear free (review M6.5); check rotation at the clamps with a protractor app.
- Pass. Witness line unmoved; rotation ≤ 1°; no crack (review M6.5).
- Predicted. Clamp friction capacity about 16 N·m about the boom axis at 0.5 N·m per screw, μ 0.3 EST (hardware-spec J04); clamp moment 14.2 N·m (struct.Mclamp); socket shear 11.3 MPa (struct.tauSock).
- Duration 1 h. Crew 2. Prereq. C02, booms built.

#### S05: Motor-mount pull and insert test on real parts

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

#### S06: Landing-gear drop test (review M6.3)

- Objective. Measure peak deceleration in a 0.3 m drop and decide on compliant feet; check the leg fairings survive.
- Setup. Empty airframe (no pack; ballast to flight mass with a jug strapped in the bay, total 6.55 kg) with the FC powered by a bench battery and logging (LOG_DISARMED,1 temporarily) or a phone accelerometer in the bay; grass surface; leg fairings fitted (cad/README.md gear: printed 3:1 teardrop, 170 mm, taped at the clamp).
- Procedure. Lift to 0.30 m under the feet (tape measure), release level, three drops; inspect legs, gear clamps, boom clamps, fairings and the ballast mount (S10) after each.
- Pass. Peak ≤ 8 g (review M6.3) — otherwise fit softer feet (foam/TPU, about 100 mm travel keeps n ≤ 8, review §6 "Landing loads"); no crack or permanent bend in the 0.205 m legs; fairings undamaged and still taped.
- Predicted. Impact speed 2.43 m/s = √(2 g h) (review §6 Load cases); bare aluminium legs as springs: n = 2(1 + h/s) = 32 g at 20 mm stroke, 8 g at 100 mm (struct.strokes). So without compliant feet the test is expected to fail; run it first with the planned feet.
- Risk. Damage to the pod: the drop is onto the gear only, pad the pod with foam.
- Duration 1 h. Crew 2. Prereq. S01, S10, gear built.

#### S07: Control-surface hinge moment and joiner/spar post-test inspection

- Objective. (a) Measure the aileron hinge moment to size the servo margin (review M17.3); (b) inspect the joiner, sockets and saddle after S01 and S06.
- Procedure. (a) Spring/luggage scale (Gaps; zero-cost: hang a jug from a string over the trailing edge) on a built aileron at 25 % of its chord behind the hinge with the surface held by the servo at 20° in a 20 m/s stream (car-roof, as C10) or, failing that, static estimate from Ch = ½ ρ V² S_a c_a Ch_δ δ with Ch_δ EST −0.5/rad and the hand calc on the card. (b) Slide the joiner out; straight-edge; look for socket foam crush and saddle bolt witness marks.
- Pass. (a) Hinge moment ≤ 4 kg·cm (review M17.3, half of 8 kg·cm). (b) No set > 0.5 mm; no crush.
- Predicted. — (hinge moment not computed in the repo, docs/research/pusher-battery-servo.md caveat 5).
- Duration 1.5 h. Crew 2. Prereq. S01.

#### S08: Transport, car fit and two-person carry (R4, R5)

- Objective. Demonstrate break-down into the measured car and the assembled carry.
- Procedure. (1) Measure the team car's load space (review M3.2). (2) Break the aircraft into its transport pieces (wing panels off the saddle, joiner slid out of the pod piece, booms off at the field breakdown joint — 4 screws per boom, hardware-spec J05; tail off with four screws, cad/README.md tail). (3) Load everything with the pack box and tools; close the hatch. (4) Two people carry the assembled aircraft 50 m over grass and set it down; no part touched the ground.
- Pass. All pieces fit; longest piece 1.20 m (geo.longestPiece) ≤ measured clear length (R4 working envelope 1.5 × 0.5 × 0.4 m, docs/DESIGN-BASIS.md R4); pod piece ≤ 0.5 m with the joiner out; carry completed without strain or contact.
- Duration 1 h. Crew 2. Prereq. C17, airframe built.

#### S09: Built component masses and empty weight (review M3.1)

- Objective. Weigh every part as it comes off the bench and the empty airframe, and compare with the sizing mass roll-up and the CAD roll-up.
- Procedure. Kitchen scale (5 kg, 1 g) per part; bathroom scale or two kitchen scales for the assembled airframe; log against cad/verification.txt "Mass roll-up" (modelled 6.36 kg incl. pack; fasteners 228 g, printed 1.38 kg, tubes 1.67 kg, foam 0.95 kg without skins, vendor 2.12 kg) and the sizing items (cg.items).
- Pass. Empty mass without pack and payload ≤ 5.23 kg × 1.15 = 6.02 kg (sized.m − 0.82 − 0.5 (calc), review M3.1); otherwise re-run analysis/sizing.mjs.
- Predicted. Wing 1.39, booms + clamps 0.626, lift units 0.968, tail 0.141, pod 0.6 EST, gear 0.443 EST (CAD legs 433 g + fairings 101.5 g + clamps 210 g), avionics 0.25 EST, pusher set 0.227, servos (5) 0.216, wiring 0.37 EST kg (cg.items; cad/verification.txt).
- Duration ongoing. Crew 1. Prereq. none.

#### S10: Ballast-mount retention (new in rev B)

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

### 9.3 Series E: electrical and avionics bench tests

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

#### E01: Power-up, smoke test and sensor calibration

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

#### E02: ESC protocol, motor order, direction and spin thresholds

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

#### E03: Servo direction, throws and centering on the airframe (5 servos)

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

#### E04: RC link: channel map, switches, telemetry and range walk

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

#### E05: Failsafe bench test (hardware portion; SITL portion done)

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

#### E06: SITL rehearsal (review F0, §12 M1): scripted portion done, pilot portion open

- Done. Scripted scenarios A–G passed 2026-10-21 (firmware/sitl/README.md; firmware/sitl/results/): nominal AUTO mission with VTOL land 0.1 m from home, forward transition 10 s, "Transition airspeed reached 16.0" 5 s after start. Attitude-tracking RMS 0.67°/0.62° (VTOL), 4.5°/1.7° (fixed wing). C0 airframe model, 2026-10-25 (firmware/sitl/results_c0.json): 7/7 again; scenario A forward transition 13 s / 144 m with no altitude loss, 17.5 m/s at "Transition done", peak 70.6 A; back-transition 7 s / 34 m with 1.7 m altitude loss and a −17°/+33° pitch swing (the airbrake phase pitches to the 30° VTOL limit and stalls the wing); VTOL land 0.0 m from home.
- Open. (1) Each pilot hand-flies the C0 airframe model (firmware/sitl/run_c0_sitl.ps1, Mission Planner on TCP 127.0.0.1:5760; the generic QuadPlane only if the model will not start) with the Pocket Crush as a joystick: three back-transitions from 20 m/s to see the airbrake pitch-up (F06–F13 watch item), QLOITER take-off, FBWA transition from the upwind edge with an immediate turn, failed transition (throttle low → QRTL), RC loss in cruise, RC loss in hover, low battery, fence; (2) SIM_ENGINE_FAIL on one lift motor in hover (documents the R14 limitation; not in the A–G set).
- Pass. Every pilot recovers a failed transition and a pusher-out without ground contact in 3 of 3 attempts and keeps inside the 300 m fence after a transition (review M12.1: a pilot who cannot does not fly F06–F12).
- Duration 2 h per pilot. Crew PIC + GCS. Prereq. E11.

#### E07: Compass and GPS calibration

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

#### E08: Airspeed sensor bench check (MS5525DSO at 0x77)

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

#### E09: Bench vibration and ESC thermal soak (tied-down, props on)

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

#### E10: Telemetry links

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

#### E11: Firmware and parameter inspection (R17)

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

#### E12: Remote ID check (R18)

- Procedure. Look up the BeeID serial at uasdoc.faa.gov (review M15.3); power the module; confirm broadcast with a free Remote ID receiver app on a phone (e.g. OpenDroneID OSM, free, Android) showing the serial and position.
- Pass. Serial listed; broadcast received at 30 m EST.
- Duration 0.5 h. Crew 1. Prereq. BeeID received, registration done.

### 9.4 Series G: ground tests on the complete aircraft

#### G01: Weight and balance (review M9.1)

- Procedure. Two kitchen scales under the wing at known stations (or one scale and a pivot): weigh with pack and 0.5 kg ballast; compute CG from the moments. Mark the CG target on the pod. Move the pack to bring the CG within 2 cm of the thrust centroid.
- Pass. Take-off mass ≤ 7.53 kg (R2 line); CG at 28 ± 2 % MAC (target cg.pct.target 28; ± 2 % MAC = ± 5.7 mm (calc, MAC = chord 0.2842 m)) with ballast; CG never aft of 31.8 % MAC (= neutral point 39.8 % − 8 % SM, aero_results.json neutral_point.AVL_pod_pct_MAC, review M9.1 rule (calc)); CG within 20 mm of the thrust centroid at x = −0.0796 m from the LE (cg.thrustCentroid).
- Predicted. CG at 26.7–29.3 % MAC over the battery travel (cg.pctFwd, pctAft); static margin 11.8 % at 28 % (aero, AVL with pod), 11.5 % by the sizing (geo.SM).
- Duration 1 h. Crew 2. Prereq. S09, avionics fitted.

#### G09: CG with and without ballast; ballast rule check (new in rev B)

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

#### G02: Hand-carry sensor sanity walk

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

#### G03: Full-system tied-down run (review T6, expanded; includes C13, E09)

- Objective. All four lift motors and the pusher under load on the airframe: pack sag, harness heat, vibration, EMI, and the pitch/roll authority check.
- Setup. Aircraft strapped to a heavy bench or to ground stakes by the landing-leg clamps with ≥ 4 ratchet or rope ties rated ≥ 50 kg each (total restraint > 4 × 3.13 kgf = 12.5 kgf, budget-lift.md A3); props on; everyone ≥ 5 m away behind a barrier; watt meter in line; IR thermometer; logging.
- Procedure. (1) Arm in QSTABILIZE; raise throttle to the C07 hover throttle (~52 %) for 60 s; (2) 3 s at 100 % on all four (review M8.4 burst); (3) in FBWA, pusher to 100 % for 10 s (G06 may be combined); (4) full transition current: hover throttle plus pusher 75 % (TKOFF_THR_MAX) for 10 s; (5) read temperatures within 30 s; (6) download the log.
- Pass. Pack ≥ 3.4 V/cell at hover draw and ≥ 3.2 V/cell in the burst (review T6, §7 M1); hover current 41.2 A ± 15 % EST; transition current ≤ 85 A (Q_M_BAT_CURR_MAX); VIBE < 30 m/s², clipping 0; motors/ESCs/connectors within the C08/C13 limits; no desync; no loose fasteners after (witness marks).
- Predicted. 41.2 A hover at 22.2 V, 43.6 A at 21 V, 75.7 A transition (sized.I_hover, I_hover_loaded, I_trans).
- Risk. Restraint failure: tie to the leg clamps not the legs; check knots; nobody in the rotor plane.
- Duration 2 h. Crew 3. Prereq. S04, E02, E03, E05, G01.

#### G04: Compass interference (compassmot) check

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

#### G05: Tethered hover (review F2)

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

#### G06: Pusher ground run on the airframe

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

#### G07: Assembly and breakdown time (R5)

- Procedure. Stopwatch, two people, from the loaded car to armed pre-flight (review M3.3), including sliding the joiner in and bolting both panels (C17), the booms (4 screws each) and the tail (4 screws); three runs on different days; then breakdown back into the car.
- Pass. Median assembly ≤ 15 min; no tool other than the hex keys; witness marks aligned after assembly.
- Duration 1.5 h. Crew 2. Prereq. S08.

#### G08: Field procedure rehearsal

- Procedure. Full dry run of a flight session at the site without arming: set-up, pre-flight checklist, crew calls, abort call, post-flight temperatures, log download, pack change, field charging (review M12.2: time one full charge at the field supply).
- Pass. Checklist completed with no missed item; charge time per pack ≤ 1.5 h (review M12.2) on the field supply (— source to be found, Gaps).
- Duration 2 h. Crew 4. Prereq. G05 planned.

### 9.5 Series F: flight tests

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

ID | Title | Review step | Build-up points | Pass criteria (summary; full on the card) | Prereq
F01 | First lift-off, QSTABILIZE hops | F3 start | lift-off and set down; 1 m hover 10 s; ± 5° roll/pitch inputs | no oscillation; attitude error < 15°; VIBE < 30; clipping 0 | G05
F02 | QHOVER hover-throttle learn and notch log (two 60 s batch-logged hovers) | F3 | 1–3 m, 2 × 60 s with INS_LOG_BAT_MASK,1, INS_LOG_BAT_OPT,4 (docs/research/firmware.md D13) | learned Q_M_THST_HOVER 0.3–0.6 and ≤ 0.60; FFT peak identified; front/rear output split ≤ 15 % (review M9.2) | F01
F03 | QLOITER free hover, 3 × 60 s, thermal | F3 | ≤ 5 m AGL; position hold; 1 m/s translations | hold within 2 m EST; motors ≤ 80 °C; cooled < 45 °C between; hover current 41.2 A ± 15 % | F02
F04 | Q-mode handling at low forward speed | F4 | box pattern at 5–8 m/s, ≤ 10 m AGL | no unexpected Q_ASSIST; attitude error < 15°; airspeed sensor reads 5–8 m/s ± 2 | F03
F05 | Hover failsafes and R20 demonstration | — | at 20 m AGL EST over the pad: RC off → QLAND; FENCE_ALT_MAX temporarily 25 m, climb → RTL; low battery forced → RTL; critical forced → QLAND | each action within timeout; touchdown within 5 m of the pad EST | F04, E05
F06 | Partial transitions (Q_ASSIST on) | F5 | ≥ 30 m AGL from the upwind edge; FBWA with throttle until 12 m/s then back to QHOVER; × 3; watch the back-transition pitch-up (C0 SITL model, ≤ 2 m loss) | airspeed rising within 6 s (review F5); altitude loss ≤ 10 m EST; lift motors re-engage on back-transition | F05, I02 (RFS)
F07 | Full transition, circuit, back-transition, QLAND | F6 | after 3 × F06: FBWA to AIRSPEED_MIN 16 from the upwind edge, immediate turn, one circuit at 18 m/s, back-transition, QLAND | transition ≤ 15 s and ≤ 100 m (review M17.2); turn started ≤ 3 s after "Transition done"; lift outputs at min in cruise (R1); QLAND touchdown ≤ 1 m/s EST | F06 × 3
F08 | Airspeed calibration and cruise performance | F6+ | ARSPD_AUTOCAL 5 min circuits; then 2 × 60 s legs at 20 m/s reciprocal headings; record current | ARSPD_RATIO 1.5–3.0 and airspeed vs GPS mean error ≤ 10 % (review M17.1); cruise power ≤ 414 W / 18.6 A at 20 m/s (calc, R10 line); predicted 302–337 W, 13.6–15.2 A; pusher can ≤ 80 °C EST by IR after the legs (thermal.md §6.3: 90 °C model bound) | F07
F13 | Gear-fairing A/B at 20 m/s (new in rev B) | — | same reciprocal legs as F08 with fairings on, then (separate flight) fairings removed; watt-meter/BAT power at 20 m/s | with fairings ≤ 414 W (R10); predicted 302 W faired vs 482 W bare (aero_results.json drag.gear_faired_case, gear_round_case); ΔP ≥ 100 W confirms the fairings are load-bearing for R10 | F08
F09 | Stall-speed determination in fixed-wing mode (new in rev B; replaces the rev A margin approach) | aero M2 | ≥ 80 m AGL EST, Q_ASSIST forced off, FBWA, idle, decelerate ≤ 0.3 m/s² to the pitch break; three runs; recover; then with Q_ASSIST auto note the assist speed | measured Vs (calibrated) ≤ 12.0 m/s = pass (R11; predicted 11.75); 12.0–12.5 = team decision (aero §9 option: accept); > 12.5 = fail; altitude loss ≤ 30 m EST; AIRSPEED_MIN 16 ≥ 1.3 × Vs (Vs ≤ 12.3) | F08
F10 | Fixed-wing failsafes: pusher-out (R15), RC loss in cruise (R20) | — | ≥ 60 m AGL EST: pusher throttle to idle in FBWA → Q_ASSIST → QLAND; separate flight: RC off in cruise → RTL → QRTL | hover re-entered with altitude loss ≤ 30 m EST; RTL → QRTL → land within RTL_RADIUS 100 m of home | F09
F11 | Mission dress rehearsal (half duration) | F7 prep | 1 min hover, transition, 5 min cruise at 20 m/s, back-transition, 1 min hover, land | energy used ≤ 60 % of C11 usable (predicted 58.6 Wh = 53 % (calc)); all phases logged; no failsafe | F10, F13
F12 | Full mission (R8, R9, R10) | F7 | ≥ 1 min hover, transition, ≥ 10 min cruise at 18–22 m/s, back-transition, ≥ 1 min hover, vertical land; with 0.5 kg ballast; fairings on; wind 3–5 m/s if available (R16) | landing ≥ 20 % of C11 usable energy and ≥ 1,300 mAh; no failsafe; aircraft undamaged; dated ≤ 2027-04-30 | F11 × 2

Cards: docs/test/cards/FTC-F01.md … FTC-F13.md.

### 9.6 Series I: documentary inspections

ID | Title | Req | Procedure | Pass
I01 | Budget ledger audit | R6, R7 | Every receipt (goods, tax, shipping) logged against docs/purchasing/C0_BOM.csv "Actual USD"; sum; spares (motor, 3 ESCs, prop pair) and second pack checked in; note that no spare servo or pushrods are held | Total ≤ $2,000.00; reserve ≥ $100 target (BOM: $1,896.79 committed, $103.21 reserve); spares on the shelf
I02 | Legal and site compliance | R18, R19 | Checklist from review §15 "Compliance checklist": legal path chosen (by 2026-11-06), TRUST per pilot, registration + marking, BeeID serial (E12), AMA per pilot, flight request ≥ 7 business days, post-flight report ≤ 3 business days, site ceiling in FENCE_ALT_MAX (≤ 110) | All items "done" before the first flight; a request on file for each flight date
I03 | Configuration inspection | R1, R3, R14 | Built aircraft against cad/drawings/DBF-DRW-001.PDF rev E sheet 1: 4 lift rotors, pusher, wing, tail with rudders; span 2.40 m; disc clearance pusher-to-rear-lift ≥ 20 mm (cad/verification.txt 79.0 mm); pusher ground clearance ≥ 40 mm (41.9 mm); ballast note 5 and hover limits printed on hover cards | Matches drawing; span 2.40 ± 0.02 m; clearances met; cards carry the limits

## 10. Data management

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

Reduction scripts (each ships with a sample dataset and has been run on it):

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

## 11. Schedule

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

Critical dependencies: any Order B item arriving after 2027-02-15 pushes first hover past 2027-03-13 (review M15.2); the RFS approval decides whether F06–F13 can happen at all (review risk register).

## 13. Gaps: equipment not in the BOM

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

Need | Zero-cost substitute used in this plan | If the substitute fails | Price, URL (date checked)
Masses for proof load and calibration | Water jugs (1 L = 1 kg) and sandbags weighed on a kitchen scale | — | $0
Kitchen scale (5 kg, 1 g) and bathroom scale | Borrow; most households have one | Amazon kitchen scale | — (not priced; typical $10–15 EST)
Luggage/spring scale (pusher pull, hinge moment, stopped-rotor drag) | HX711 load cell from the thrust stand in line | Hanging luggage scale 50 kg | — (not priced; typical $8–12 EST)
Calipers, multimeter, hex keys | Hand tools on hand (R6 "hand tools") | — | $0 if on hand; otherwise —
Torque wrench 0.1–1 N·m | Hanging-mass method on the hex key (hardware-spec §2d) | — | $0
Phone accelerometer / spectrum app | phyphox (free, phyphox.org) or similar | — | $0
Anemometer | Phone app + nearest METAR/NWS; improvised wind sock | Hand-held anemometer | — (typical $12–20 EST)
Telemetry during transitions | CRSF telemetry on the handset; ELRS MAVLink overlay for a GCS (docs/research/firmware.md §4) | — (no radio needed) | $0
Field power for the charger | Charge at home between sessions; two packs = 2 flights per session | Car 12 V (the HTRC C150 is AC/DC, docs/research/budget-energy-test.md §2) with a 12 V lead | —
Compliant landing feet (S06) | FOAMULAR offcuts under the dome feet; TPU print if a spool is on hand | TPU filament | —
Spare servo / pushrods (removed from the BOM) | None: a failure ends the session; buy from the reserve | EMAX ES3005HV $19.99 (shop.emax-usa.com, checked 2026-10-13 in docs/research/budget-avionics.md §6); Du-Bro 2-56 pushrods $12.48 (BOM line) | from the $103.21 reserve
Ballast block | Sand or lead shot in a taped block, 0.500 kg on the kitchen scale | — | $0
Tether lines and stakes | Rope and tent stakes on hand | — | $0
Hardened nozzle for PA6-CF | Check the team printer (review §16) | Hardened steel nozzle | —
Remote ID receiver app | OpenDroneID OSM (free Android app) | — | $0
pymavlink for log reduction | Mission Planner text export + log_summary.py text mode | pip install pymavlink (free; already used for SITL, firmware/sitl/README.md) | $0

## 14. Open items for team sign-off

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

## Appendix A. Revision notes

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

## Appendix B. Inconsistencies: rev A list and their rev B status

# | Rev A item | Rev B status

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
