davinciucberkeley-collab/DBF-VTOL/cad/sim/thermal/results.txt

# SOLIDWORKS Simulation thermal results, key=value|unit|note  (generated 2026-10-25 03:38)
val_simcs_T_steady=141.13|degC|motor-only steady with cad/Sim.cs inputs (thermQ 44.620672 W, h 50.000000), compare cad/sim/results.txt motor_T_steady
val_simcs_T_hand=140.679|degC|hand: T_amb + Q/(h A), A = 0.008445 m2
motor_only_T_steady=163.855|degC|motor-only steady, Q 45.79 W, h 42.93 W/m2K (Hilpert at v_i), 35 C
motor_only_T_hand=161.283|degC|hand: T_amb + Q/(h A)
val_motor_steps=18|-|transient steps saved (API: initial temperature load + SaveResultsForSolutionStepsOption; see docs/research/thermal.md)
val_motor_T90=76.1621|degC|motor-only 90 s FEA, cp 470 J/kgK, Sim.cs inputs
val_motor_T90_lumped=75.9381|degC|lumped T_amb + dT (1 - exp(-t/tau)), tau 183.7 s (review/src/app.js TH)
# SOLIDWORKS Simulation thermal results, key=value|unit|note  (generated 2026-10-25 03:51)
lift_steady_ESC=96.0515|degC|lift unit steady hover, 35 C, max in body
lift_steady_Motor=168.944|degC|lift unit steady hover, 35 C, max in body
lift_steady_Pad=96.0507|degC|lift unit steady hover, 35 C, max in body
lift_steady_Boom=36.1862|degC|lift unit steady hover, 35 C, max in body
lift_steady_Mount=168.937|degC|lift unit steady hover, 35 C, max in body
lift_hover30_Motor=50.141|degC|lift unit hover transient from 35 C, max in body
lift_hover60_Motor=62.8367|degC|lift unit hover transient from 35 C, max in body
lift_hover90_Motor=73.9226|degC|lift unit hover transient from 35 C, max in body
lift_hover120_Motor=83.6655|degC|lift unit hover transient from 35 C, max in body
lift_hover30_Mount=48.9271|degC|lift unit hover transient from 35 C, max in body
lift_hover60_Mount=61.6369|degC|lift unit hover transient from 35 C, max in body
lift_hover90_Mount=72.8066|degC|lift unit hover transient from 35 C, max in body
lift_hover120_Mount=82.6594|degC|lift unit hover transient from 35 C, max in body
lift_hover30_Boom=35.1801|degC|lift unit hover transient from 35 C, max in body
lift_hover60_Boom=35.3606|degC|lift unit hover transient from 35 C, max in body
lift_hover90_Boom=35.5141|degC|lift unit hover transient from 35 C, max in body
lift_hover120_Boom=35.6402|degC|lift unit hover transient from 35 C, max in body
lift_hover30_ESC=46.251|degC|lift unit hover transient from 35 C, max in body
lift_hover60_ESC=55.5883|degC|lift unit hover transient from 35 C, max in body
lift_hover90_ESC=63.1971|degC|lift unit hover transient from 35 C, max in body
lift_hover120_ESC=69.3794|degC|lift unit hover transient from 35 C, max in body
lift_hover30_Pad=46.2448|degC|lift unit hover transient from 35 C, max in body
lift_hover60_Pad=55.5831|degC|lift unit hover transient from 35 C, max in body
lift_hover90_Pad=63.1927|degC|lift unit hover transient from 35 C, max in body
lift_hover120_Pad=69.3757|degC|lift unit hover transient from 35 C, max in body
# SOLIDWORKS Simulation thermal results, key=value|unit|note  (generated 2026-10-25 04:25)
lift_steady_Motor=168.944|degC|lift unit steady hover, 35 C, max in body
lift_steady_Pad=96.0507|degC|lift unit steady hover, 35 C, max in body
lift_steady_Boom=36.1859|degC|lift unit steady hover, 35 C, max in body
lift_steady_Mount=168.937|degC|lift unit steady hover, 35 C, max in body
lift_steady_ESC=96.0515|degC|lift unit steady hover, 35 C, max in body
lift_hover30_Motor=50.141|degC|lift unit hover transient from 35 C, max in body
lift_hover60_Motor=62.8367|degC|lift unit hover transient from 35 C, max in body
lift_hover90_Motor=73.9226|degC|lift unit hover transient from 35 C, max in body
lift_hover120_Motor=83.6655|degC|lift unit hover transient from 35 C, max in body
lift_hover30_Mount=48.9271|degC|lift unit hover transient from 35 C, max in body
lift_hover60_Mount=61.6369|degC|lift unit hover transient from 35 C, max in body
lift_hover90_Mount=72.8066|degC|lift unit hover transient from 35 C, max in body
lift_hover120_Mount=82.6594|degC|lift unit hover transient from 35 C, max in body
lift_hover30_Boom=35.1801|degC|lift unit hover transient from 35 C, max in body
lift_hover60_Boom=35.3605|degC|lift unit hover transient from 35 C, max in body
lift_hover90_Boom=35.5139|degC|lift unit hover transient from 35 C, max in body
lift_hover120_Boom=35.64|degC|lift unit hover transient from 35 C, max in body
lift_hover30_ESC=46.251|degC|lift unit hover transient from 35 C, max in body
lift_hover60_ESC=55.5883|degC|lift unit hover transient from 35 C, max in body
lift_hover90_ESC=63.1971|degC|lift unit hover transient from 35 C, max in body
lift_hover120_ESC=69.3794|degC|lift unit hover transient from 35 C, max in body
lift_hover30_Pad=46.2448|degC|lift unit hover transient from 35 C, max in body
lift_hover60_Pad=55.5831|degC|lift unit hover transient from 35 C, max in body
lift_hover90_Pad=63.1927|degC|lift unit hover transient from 35 C, max in body
lift_hover120_Pad=69.3757|degC|lift unit hover transient from 35 C, max in body
lift_mission_max_Motor=78.0787|degC|lift unit mission peak, hot day 35 C
lift_mission_end_Motor=76.6739|degC|lift unit at mission end (after the landing hover)
lift_mission_max_Mount=76.111|degC|lift unit mission peak, hot day 35 C
lift_mission_end_Mount=75.6113|degC|lift unit at mission end (after the landing hover)
lift_mission_max_Boom=35.5517|degC|lift unit mission peak, hot day 35 C
lift_mission_end_Boom=35.5442|degC|lift unit at mission end (after the landing hover)
lift_mission_max_ESC=66.4834|degC|lift unit mission peak, hot day 35 C
lift_mission_end_ESC=64.7217|degC|lift unit at mission end (after the landing hover)
lift_mission_max_Pad=66.4739|degC|lift unit mission peak, hot day 35 C
lift_mission_end_Pad=64.7175|degC|lift unit at mission end (after the landing hover)
# SOLIDWORKS Simulation thermal results, key=value|unit|note  (generated 2026-10-25 04:59)
pod_mission_max_Battery=64.0537|degC|pod hot-day mission peak, max in body
pod_mission_end_Battery=64.0537|degC|pod at mission end
pod_mission_max_FC=96.7761|degC|pod hot-day mission peak, max in body
pod_mission_end_FC=96.7761|degC|pod at mission end
pod_mission_max_Foam=35|degC|pod hot-day mission peak, max in body
pod_mission_end_Foam=35|degC|pod at mission end
# SOLIDWORKS Simulation thermal results, key=value|unit|note  (generated 2026-10-25 15:22)
pusher_steady_Foam=62.0567|degC|pusher steady cruise, 35 C, max in body
pusher_steady_CupFloor=91.9246|degC|pusher steady cruise, 35 C, max in body
pusher_steady_CupWall=88.1676|degC|pusher steady cruise, 35 C, max in body
pusher_steady_Motor=91.902|degC|pusher steady cruise, 35 C, max in body
pusher_endcruise_Motor=90.796|degC|pusher after 600 s cruise from 35 C, max in body
pusher_endcruise_CupFloor=90.8225|degC|pusher after 600 s cruise from 35 C, max in body
pusher_endcruise_CupWall=87.1234|degC|pusher after 600 s cruise from 35 C, max in body
pusher_endcruise_Foam=61.2323|degC|pusher after 600 s cruise from 35 C, max in body
