davinciucberkeley-collab/DBF-VTOL/docs/test/analysis/sample/battery_sample.csv

t_s | volt_V | curr_A | step
0 | 24.356 | 16.0
30 | 24.257 | 16.0
60 | 24.159 | 16.0
90 | 24.062 | 16.0
120 | 23.965 | 16.0
150 | 23.869 | 16.0
180 | 23.773 | 16.0
210 | 23.679 | 16.0
240 | 23.585 | 16.0
270 | 23.491 | 16.0
300 | 23.399 | 16.0
330 | 23.307 | 16.0
360 | 23.216 | 16.0
390 | 23.125 | 16.0
420 | 23.036 | 16.0
450 | 22.947 | 16.0
480 | 22.859 | 16.0
510 | 22.772 | 16.0
540 | 22.686 | 16.0
570 | 22.601 | 16.0
600 | 21.700 | 40.0 | hover
601 | 21.693 | 40.0 | hover
602 | 21.686 | 40.0 | hover
603 | 21.679 | 40.0 | hover
604 | 21.672 | 40.0 | hover
605 | 21.665 | 40.0 | hover
606 | 21.658 | 40.0 | hover
607 | 21.651 | 40.0 | hover
608 | 21.644 | 40.0 | hover
609 | 21.637 | 40.0 | hover
610 | 22.447 | 16.0
640 | 22.364 | 16.0
670 | 22.282 | 16.0
700 | 22.201 | 16.0
730 | 20.184 | 73.0 | transition
731 | 20.172 | 73.0 | transition
732 | 20.160 | 73.0 | transition
733 | 22.086 | 16.0
763 | 22.007 | 16.0
793 | 21.930 | 16.0
823 | 21.854 | 16.0
853 | 21.780 | 16.0
883 | 21.706 | 16.0
913 | 21.634 | 16.0
943 | 21.563 | 16.0
973 | 21.494 | 16.0
1003 | 21.426 | 16.0
1033 | 21.359 | 16.0
1063 | 21.295 | 16.0
1093 | 21.232 | 16.0
1123 | 21.171 | 16.0
1153 | 21.111 | 16.0
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
