davinciucberkeley-collab/DBF-VTOL/firmware/sitl/results/scenario_D_transition_timeout.csv

t | mode | armed | alt | aspd | gspd | thr | volt | curr | dist | wp
612.04 | QLOITER | 0 | 0.06 | 0.63 | 0.01 | 0 | 25.2 | 0.0 | 0.8 | 0
613.04 | QLOITER | 1 | -0.09 | 0.27 | 0.01 | 0 | 25.2 | 0.0 | 0.8 | 0
614.04 | QLOITER | 1 | -0.07 | 0.82 | 0.01 | 0 | 25.2 | 0.0 | 0.8 | 0
615.04 | QLOITER | 1 | 1.52 | 0.8 | 0.0 | 20 | 24.88 | 32.4 | 0.7 | 0
616.04 | QLOITER | 1 | 3.23 | 0.33 | 0.2 | 13 | 24.96 | 22.8 | 0.5 | 0
617.04 | QLOITER | 1 | 4.88 | 0.34 | 0.15 | 14 | 24.96 | 23.0 | 0.4 | 0
618.04 | QLOITER | 1 | 6.59 | 0.67 | 0.03 | 14 | 24.95 | 23.1 | 0.4 | 0
619.04 | QLOITER | 1 | 8.29 | 0.04 | 0.05 | 14 | 24.95 | 23.2 | 0.5 | 0
620.04 | QLOITER | 1 | 9.99 | 0.32 | 0.1 | 14 | 24.94 | 23.3 | 0.6 | 0
621.04 | QLOITER | 1 | 11.7 | 0.61 | 0.1 | 14 | 24.94 | 23.3 | 0.7 | 0
622.04 | QLOITER | 1 | 13.4 | 0.33 | 0.08 | 14 | 24.93 | 23.2 | 0.8 | 0
623.03 | QLOITER | 1 | 15.08 | 1.06 | 0.06 | 14 | 24.92 | 23.3 | 0.8 | 0
624.04 | QLOITER | 1 | 16.78 | 0.55 | 0.03 | 14 | 24.92 | 23.2 | 0.8 | 0
625.03 | QLOITER | 1 | 18.51 | 0.5 | 0.01 | 14 | 24.92 | 23.3 | 0.8 | 0
626.03 | QLOITER | 1 | 20.2 | 0.54 | 0.01 | 14 | 24.91 | 23.1 | 0.8 | 0
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
