davinciucberkeley-collab/DBF-VTOL/analysis/thermal/img/thermal_mission_history.png

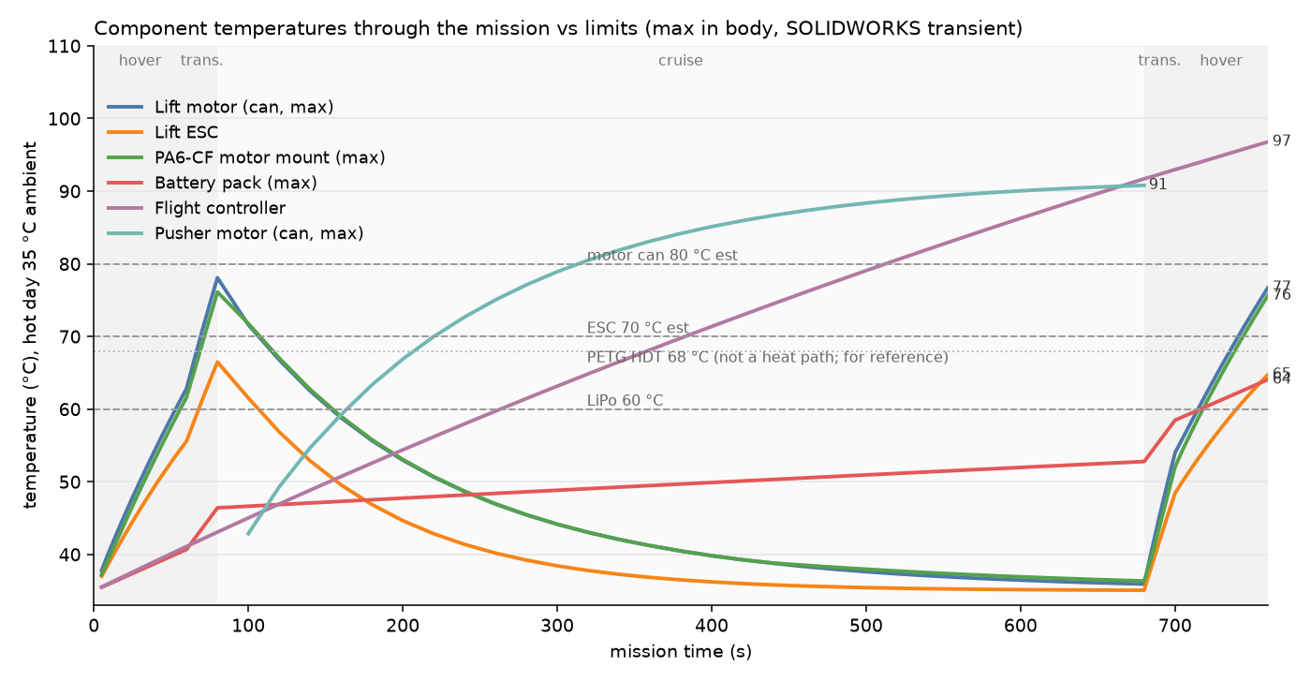
analysis/thermal/img/thermal_mission_history.png
