davinciucberkeley-collab/DBF-VTOL/cad/params.txt

foil=-0.284206,0.000447;-0.283437,0.000634;-0.281136,0.001191;-0.277327,0.002100;-0.272049,0.003331;-0.265356,0.004846;-0.257317,0.006600;-0.248014,0.008543;-0.237546,0.010622;-0.226023,0.012782;-0.213569,0.014967;-0.200315,0.017122;-0.186407,0.019190;-0.171995,0.021117;-0.157237,0.022848;-0.142297,0.024330;-0.127341,0.025512;-0.112526,0.026348;-0.097892,0.026738;-0.083745,0.026615;-0.070253,0.025974;-0.057578,0.024825;-0.045871,0.023198;-0.035269,0.021137;-0.025895,0.018700;-0.017853,0.015955;-0.011230,0.012976;-0.006095,0.009832;-0.002494,0.006589;-0.000458,0.003299;0.000000,0.000000;-0.001098,-0.003144;-0.003716,-0.005976;-0.007814,-0.008483;-0.013338,-0.010651;-0.020219,-0.012467;-0.028378,-0.013921;-0.037723,-0.015009;-0.048154,-0.015740;-0.059563,-0.016129;-0.071835,-0.016205;-0.084846,-0.016007;-0.098469,-0.015582;-0.112567,-0.014982;-0.127131,-0.014217;-0.141879,-0.013279;-0.156644,-0.012213;-0.171265,-0.011063;-0.185585,-0.009868;-0.199446,-0.008660;-0.212696,-0.007468;-0.225188,-0.006314;-0.236781,-0.005218;-0.247347,-0.004198;-0.256763,-0.003270;-0.264924,-0.002449;-0.271735,-0.001752;-0.277117,-0.001192;-0.281007,-0.000781;-0.283359,-0.000531;-0.284147,-0.000447
foilWing=NACA 2415|m=0.02|p=0.4
foilTail=NACA 0009|m=0|p=0|t=0.09
foilTE=cad=-0.1015|aero=-0.1036
podProfile=ellipse-parallel-smoothstep|noseX=0.45|noseA=0.22|parallelTo=0.5
chord=0.284176
panelLen=1.120000
tc=0.150000
sparXfrac=0.300000
sparX=-0.085253
sparY=0.005328
sparOD=0.025400
sparID=0.022454
sparLen=0.800000
joinOD=0.022225
joinID=0.019279
joinLen=0.760000
boomOD=0.025400
boomID=0.023622
segF=0.991014
segR=0.485900
fusL=0.850000
fusR=0.080000
tailR=0.030000
motorD=0.048000
motorH=0.032000
liftProp=0.431800
propW=0.035000
propT=0.008000
pushMotorD=0.048000
pushMotorL=0.032000
pushProp=0.355600
hC=0.101524
hSpan=0.917400
vH=0.199605
vC=0.159684
elevSpan=0.845800
battL=0.155000
battH=0.050000
battW=0.048000
legOD=0.025400
legID=0.022454
legLen=0.205000
pitotD=0.006000
pitotL=0.250000
xFront=0.390938
xRear=-0.550076
xStub0=-1.035976
yIn=0.433700
feaBoomL=0.461982
feaTipForce=30.694814
feaTipMass=0.242000
feaNult=4.500000
feaWingForce=153.381813
feaRootMomentTarget=73.623270
feaHandSigJ=157454370.000000
feaHandSigB=34984676.000000
feaHandDefl=0.002840
feaHandFn=32.313526
thermQ=45.786146
thermH=50.000000
thermAmbK=308.150000
thermTime=90.000000
matLib=6061-T6 (SS)
matE=69000000000.000000
matNu=0.330000
matRho=2700.000000
matSig=275000000.000000
motorMass=0.165000
motorCp=896.000000
gearClampBot=-0.028700
legSocketDepth=0.014000
legBoltY=-0.021700
fairBore=0.025600
fairWall=0.000800
fairChord=0.081600
fairLen=0.170000
fairY0=0.020000
clampTopF=0.014009
clampTopR=0.023840
yB=-0.030000
tailT=0.009137
yMotor=-0.009000
yProp=0.027000
yGround=-0.249700
xFinLE=-0.815976
yStabBot=-0.014300
yStabTop=-0.005163
yFin=-0.002163
xTC=-0.849876
finRootBlock=0.021000
rudderY0=0.022000
shoeWall=0.020000
shoeFloor=0.003000
shoeFlangeX=0.032000
boltZ=0.065000
boltX=-0.198923
yU70=0.017278
yL70=-0.008752
yMid70=0.004263
zBoomPanel=0.353700
yL30=-0.015991
yL80=-0.006160
yL55=-0.012264
yL78=-0.006692
yL21=-0.016172
zHornPanel=0.596400
zServoPanel=0.556500
xServo=-0.156297
yServo=-0.000264
servoL=0.038600
servoW=0.018800
servoH=0.034900
servoTabZ=0.024000
servoTabT=0.002500
servoTabX=0.023000
servoTabY=0.005000
servoShaftX=0.009500
servoArmLen=0.020000
trayBodyY=-0.010900
trayPlateZ=0.021000
trayPlateT=0.003000
pitotX=-0.050000
pitotY=-0.025672
pitotZ=-1.000000
hornHpX=-0.213132
tailX=-0.400000
yPod=-0.030000
battX=0.189000
battY=-0.052000
bayX0=0.150000
bayX1=0.300000
bayY0=-0.020000
bayY1=0.015000
bayZ=0.040000
canopyX0=0.070000
canopyX1=0.330000
canopyR=0.055000
canopyY=0.015000
mtow=6.551516
ailFrac=0.550000
ailSpan=0.616000
thick30=0.042639
pillarH=0.026030
pillarD=0.016000
pillarBoreD=0.016400
pillarNutDepth=0.009600
pillarSpot=0.002000
pillarSlotFloor=0.009615
joinBoreD=0.022455
legStock=2.438400
fast_F01=F01_M3x8_SHCS|SHCS|3|8|5.68|3|2.5|A2 (18-8) stainless|ISO 4762 M3x0.5 x 8 A2 (18-8) stainless: Motor to motor plate (4 lift + pusher), from below through the PA6-CF floor into the motor base
fast_F02=F02_M3x16_SHCS|SHCS|3|16|5.68|3|2.5|A2 (18-8) stainless|ISO 4762 M3x0.5 x 16 A2 (18-8) stainless: Split-clamp screws (motor mounts, tail clamps), stabiliser/fin shoe screws, provisional lift-prop screws
fast_F03=F03_M3x20_SHCS|SHCS|3|20|5.68|3|2.5|A2 (18-8) stainless|ISO 4762 M3x0.5 x 20 A2 (18-8) stainless: Gear clamp split screws
fast_F04=F04_M3x40_SHCS|SHCS|3|40|5.68|3|2.5|A2 (18-8) stainless|ISO 4762 M3x0.5 x 40 A2 (18-8) stainless: Boom splice cross-bolts (rear motor mount) and rear boom-clamp bolts to the wing hardpoint
fast_F05=F05_M3x30_SHCS|SHCS|3|30|5.68|3|2.5|A2 (18-8) stainless|ISO 4762 M3x0.5 x 30 A2 (18-8) stainless: Landing-leg retaining cross-bolt through gear clamp and leg
fast_F06=F06_M3x35_SHCS|SHCS|3|35|5.68|3|2.5|A2 (18-8) stainless|ISO 4762 M3x0.5 x 35 A2 (18-8) stainless: Front boom clamp bolts to the spar-collar hardpoint in the wing
fast_F07=F07_M3x8_BHCS|BHCS|3|8|5.7|1.65|2|A2 (18-8) stainless|ISO 7380-1 button head M3x0.5 x 8 A2 (18-8) stainless: Light-duty screws into inserts: pusher cup radial screws, canopy hatch, pitot clamp, FC tray (provisional)
fast_F08=F08_M3x12_SHCS|SHCS|3|12|5.68|3|2.5|A2 (18-8) stainless|ISO 4762 M3x0.5 x 12 A2 (18-8) stainless: Wing saddle to pod frame
fast_F09=F09_M5x20_BHCS|BHCS|5|20|9.5|2.75|3|A2 (18-8) stainless|ISO 7380-1 button head M5x0.8 x 20 A2 (18-8) stainless: Wing panel retention bolt (one per side, 70 % chord, through the saddle bolt pillar and the panel root tongue)
fast_F10=F10_M2x10_SHCS|SHCS|2|10|3.98|2|1.5|A2 (18-8) stainless|ISO 4762 M2x0.4 x 10 A2 (18-8) stainless: Servo mounting screws (provisional: servo tab hole size and spacing not published)
fast_F11=F11_M2x14_PAN|PAN|2|14|3.8|1.5|0|—|— M2x0.4 x 14 —: Control-horn screws (supplied with the horn kit, kit item 7)
fast_F13=F13_M3x8_SHCS|SHCS|3|8|5.68|3|2.5|— (supplied)|— M3x0.5 x 8 — (supplied): Pusher M6 bolt-on adapter to the X4110S hub: 4 screws supplied with the motor (maker drawing View A-A, dia 3.2 / dia 5.7 counterbores on dia 12). Length not published: 8 mm EST in the CAD (flange 5.0 EST, counterbore 3.0, engagement 6.0 < 8.0 limit)
fast_N01=N01_M3_Nylock|NYLOCK|3|4|5.5|0|0|A2 (18-8) stainless|DIN 985 nylon-insert lock nut M3x0.5, s 5.5 h 4
fast_N02=N02_M5_Nylock|NYLOCK|5|5|8|0|0|A2 (18-8) stainless|DIN 985 nylon-insert lock nut M5x0.8, s 8 h 5
fast_N03=N03_M2_Hex_Nut|HEXNUT|2|1.6|4|0|0|A2 (18-8) stainless|DIN 934 hex nut M2x0.4, s 4 h 1.6
fast_N04=N04_M6_Bullet_Nut|BULLET|6|19.5|10|12|0|steel (supplied with motor)|M6 x 1.0 bullet prop nut, supplied with the X4110S (height 19.5 from the maker drawing; across-flats EST 10)
fast_W01=W01_M3_Washer|WASHER|3.2|0.5|7|0|0|A2 (18-8) stainless|DIN 125 (vendor) M3 flat washer OD 7 ID 3.2 t 0.5
fast_I01=I01_M3_Insert|INSERT|3|5.7|4.6|0|0|brass, lead free|ruthex RX-M3x5.7 heat-set insert OD 4.6 x 5.7, hole 4 (knurl shown as two bands)
sched_F01=F01|ISO 4762 (DIN 912)|M3x0.5 x 8|20|30|J01 lift motor to motor plate (x4 motors, 4 each); J12 pusher motor to cup (4)|0.6|Loctite 242, one drop on the last 2-3 threads only; keep off the PA6-CF (TDS: not for thermoplastics)|Bolt Depot|6379|0.06
sched_F02=F02|ISO 4762 (DIN 912)|M3x0.5 x 16|36|50|J02 motor mount upper/lower clamp (4 per mount x4); J08 tail clamp to rear stub (4 per side); J09 fin shoe + stabiliser to tail clamp (2 per side); J03 lift prop plate to motor hub (2 per motor, provisional)|0.5|none (brass insert in plastic); witness mark|Bolt Depot|6382|0.06
sched_F03=F03|ISO 4762 (DIN 912)|M3x0.5 x 20|16|24|J06 gear clamp halves on boom (4 per clamp x4)|0.5|none|Bolt Depot|6383|0.07
sched_F04=F04|ISO 4762 (DIN 912)|M3x0.5 x 40|8|12|J04 boom splice at rear motor mount (2 per side); J05b rear boom clamp to wing hardpoint (2 per side)|0.5|none (nylock)|Bolt Depot|6387|0.15
sched_F05=F05|ISO 4762 (DIN 912)|M3x0.5 x 30|4|8|J07 landing leg in gear clamp socket (1 per leg)|0.5|none (nylock)|Bolt Depot|6385 (M3 x 30 socket cap; number and price not verified, EST)|0.1
sched_F06=F06|ISO 4762 (DIN 912)|M3x0.5 x 35|4|8|J05a front boom clamp to wing spar collar (2 per side)|0.5|none|Bolt Depot|6386|0.15
sched_F07=F07|ISO 7380-1 button head (vendor lists no standard; dims match)|M3x0.5 x 8|11|20|J12 pusher cup to pod tail ring; J13 canopy hatch to pod frame; J16 pitot clamp; J15 FC to tray (provisional)|0.4|none|Bolt Depot|7219|0.06
sched_F08=F08|ISO 4762 (DIN 912)|M3x0.5 x 12|4|12|J11 wing saddle root-plate flange to pod frame (4)|0.5|none|Bolt Depot|6381|0.06
sched_F09=F09|ISO 7380-1 button head (vendor lists no standard; dims match)|M5x0.8 x 20|2|6|J10 wing panel to saddle (1 per side)|1|none (nylock)|Bolt Depot|6635|0.18
sched_F10=F10|ISO 4762 (DIN 912)|M2x0.4 x 10|20|30|J14 servo to printed servo tray (4 per servo x5)|0.15|none|Bolt Depot|6365|0.12
sched_F11=F11|— (supplier states M2x14 only)|M2x0.4 x 14|10|0|J17 horn to aileron hardpoint (2 per horn x2); J17 horn through elevator and rudders with kit backplate (2 per horn x3)|0.15|none (nylon horn)|Amazon (kit item 7)|B0B58ZSC8J|0
sched_F12=F12|ISO 4762 (DIN 912)|M3x0.5 x 16|8|0|J03 JeeFly 1755 prop to X4110S hub (2 of the 4 M3 holes on the 12 mm circle)|0.8|Loctite 242 on the screw tip (metal into motor hub)|Bolt Depot (from F02 or F08 stock)|6382 / 6381|0
sched_F13=F13|— (supplied; ISO 4762 geometry assumed in the CAD)|M3x0.5 x 8|4|0|J03b adapter to pusher hub (4)|0.8|Loctite 242 (metal to metal)|SunnySky (in motor box)|—|0
sched_N01=N01|DIN 985 nylon-insert lock nut (vendor: hex nylon insert lock nut)|M3x0.5 x 4|8|16|J04 splice cross-bolts (4); J07 leg cross-bolts (4)|—|—|Bolt Depot|4792|0.07
sched_N02=N02|DIN 985 nylon-insert lock nut|M5x0.8 x 5|2|6|J10 wing bolts|—|—|Bolt Depot|4794|0.09
sched_N03=N03|DIN 934 hex nut|M2x0.4 x 1.6|30|100|J14 servo screws (20); J17 horn screws (10)|—|—|Bolt Depot|7362|0.0221
sched_N04=N04|M6x1.0 bullet (acorn) prop nut, supplied with motor|M6x1.0 x 19.5|1|0|J03b pusher prop on M6 adapter|—|—|SunnySky (in motor box)|—|0
sched_W01=W01|DIN 125 (vendor)|M3 7 x 0.5|28|100|J01/J12 motor screws (20); J04/J07 cross-bolt heads (8)|—|—|Bolt Depot|4513|0.0145
sched_I01=I01|ruthex RX-M3x5.7|M3 x 5.7|67|100||—|—|Amazon (ruthex)|B08BCRZZS3|0.0999
rodRudder=0.102392
rodAileron=0.048385
rodElevator=0.039637
discClear=0.078964
pushX=-0.441000
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
xcomp=Pitot_Tube|-0.05000|-0.02567|-1.30000|1,0,0,0,1,0,0,0,1
xcomp=Pitot_Clamp|-0.05000|-0.01617|-1.30000|1,0,0,0,1,0,0,0,1
xcomp=F07_M3x8_BHCS|-0.05000|-0.08767|-1.30000|1,0,0,0,-1,0,0,0,-1
xcomp=I01_M3_Insert|-0.05000|0.01283|-1.30000|1,0,0,0,-1,0,0,0,-1
