davinciucberkeley-collab/DBF-VTOL/inventory/v031/cad/params.txt

foil=-0.238700,0.000375;-0.238054,0.000533;-0.236122,0.001001;-0.232923,0.001764;-0.228490,0.002797;-0.222868,0.004070;-0.216116,0.005543;-0.208303,0.007175;-0.199511,0.008922;-0.189833,0.010736;-0.179373,0.012571;-0.168241,0.014380;-0.156560,0.016117;-0.144455,0.017736;-0.132061,0.019190;-0.119513,0.020434;-0.106952,0.021427;-0.094509,0.022129;-0.082218,0.022457;-0.070336,0.022354;-0.059005,0.021815;-0.048359,0.020850;-0.038526,0.019484;-0.029622,0.017753;-0.021749,0.015706;-0.014995,0.013401;-0.009432,0.010898;-0.005119,0.008258;-0.002095,0.005534;-0.000385,0.002771;0.000000,0.000000;-0.000922,-0.002641;-0.003121,-0.005019;-0.006563,-0.007125;-0.011202,-0.008946;-0.016982,-0.010471;-0.023834,-0.011692;-0.031683,-0.012606;-0.040444,-0.013220;-0.050026,-0.013547;-0.060333,-0.013611;-0.071261,-0.013444;-0.082702,-0.013087;-0.094543,-0.012583;-0.106775,-0.011941;-0.119162,-0.011153;-0.131563,-0.010257;-0.143843,-0.009292;-0.155870,-0.008288;-0.167512,-0.007274;-0.178640,-0.006272;-0.189131,-0.005303;-0.198869,-0.004383;-0.207742,-0.003526;-0.215651,-0.002746;-0.222506,-0.002057;-0.228226,-0.001471;-0.232746,-0.001001;-0.236013,-0.000656;-0.237989,-0.000446;-0.238650,-0.000375
chord=0.238675
panelLen=1.120000
tc=0.150000
sparXfrac=0.300000
sparX=-0.071603
sparY=0.004475
sparOD=0.025400
sparID=0.022454
sparLen=0.800000
joinOD=0.022225
joinID=0.019279
joinLen=0.760000
boomOD=0.025400
boomID=0.023622
segF=0.955000
segR=0.516000
fusL=0.850000
fusR=0.080000
tailR=0.030000
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
comp=Landing_Leg|-0.41458|-0.24370|0.43370
comp=H_Tail|-0.77048|-0.01390|0.00000
comp=Elevator|-0.77048|-0.01390|0.00000
comp=Pusher_Motor|-0.40000|-0.03000|0.00000
comp=Pusher_Prop_14in|-0.43800|-0.03000|0.00000
comp=Spinner|-0.44200|-0.03000|0.00000
comp=Pitot_Tube|-0.05000|-0.02000|-1.00000
