davinciucberkeley-collab/DBF-VTOL/firmware/sitl/sitl_c0_defaults.parm

# sitl_c0_defaults.parm - SITL base defaults for the C0 physics model (--model JSON:127.0.0.1).
# Loaded FIRST, before vtol_c0.param and sitl_c0_overrides.param.
# Only the simulator sensor-calibration and RC-range items of ArduPilot's
# Tools/autotest/default_params/quadplane.parm are kept (github.com/ArduPilot/ardupilot, checked 2026-10-21).
# The tuning gains that file carries (Q_A_RAT_*, RLL_RATE_*, PTCH_RATE_*, NAVL1_PERIOD, Q_M_THST_EXPO ...)
# are deliberately left out: they are the tune of ArduPilot's generic SITL quadplane, not of C0. The C0
# model therefore flies the firmware defaults plus vtol_c0.param, exactly as the real aircraft would.
COMPASS_OFS2_X   -0.420265
COMPASS_OFS2_Y   -0.726942
COMPASS_OFS2_Z   6.665476
COMPASS_OFS3_X   -0.420265
COMPASS_OFS3_Y   -0.726942
COMPASS_OFS3_Z   6.665476
COMPASS_OFS_X    -0.453570
COMPASS_OFS_Y    -0.585846
COMPASS_OFS_Z    6.815743
EK3_ENABLE       1
INS_ACC2OFFS_X   0.001000
INS_ACC2OFFS_Y   0.001000
INS_ACC2OFFS_Z   0.001000
INS_ACC2SCAL_X   1.001000
INS_ACC2SCAL_Y   1.001000
INS_ACC2SCAL_Z   1.001000
INS_ACCOFFS_X    0.001000
INS_ACCOFFS_Y    0.001000
INS_ACCOFFS_Z    0.001000
INS_ACCSCAL_X    1.001000
INS_ACCSCAL_Y    1.001000
INS_ACCSCAL_Z    1.001000
INS_GYR_CAL      0
RC1_DZ           30
RC1_MAX          1886
RC1_MIN          1087
RC1_TRIM         1500
RC3_MAX          2000
RC3_MIN          1000
SCHED_LOOP_RATE  300
