davinciucberkeley-collab/DBF-VTOL/analysis/aero/out/su2/L1_SA_ap02.0/case.cfg

% SU2 8.5.0 incompressible RANS, NACA 2415, chord 1, Re 389174 (analysis/aero/su2_2d.py)
SOLVER= INC_RANS
KIND_TURB_MODEL= SA

MATH_PROBLEM= DIRECT
RESTART_SOL= NO
INC_DENSITY_MODEL= CONSTANT
INC_DENSITY_INIT= 1.225
INC_VELOCITY_INIT= ( 19.987817, 0.697990, 0.0 )
INC_NONDIM= INITIAL_VALUES
VISCOSITY_MODEL= CONSTANT_VISCOSITY
MU_CONSTANT= 6.29538554e-05
FREESTREAM_TURBULENCEINTENSITY= 0.001
FREESTREAM_TURB2LAMVISCRATIO= 10.0
AOA= 2.0
REF_ORIGIN_MOMENT_X= 0.25
REF_ORIGIN_MOMENT_Y= 0.0
REF_ORIGIN_MOMENT_Z= 0.0
REF_LENGTH= 1.0
REF_AREA= 1.0
MARKER_HEATFLUX= ( airfoil, 0.0 )
MARKER_FAR= ( farfield )
MARKER_PLOTTING= ( airfoil )
MARKER_MONITORING= ( airfoil )
NUM_METHOD_GRAD= WEIGHTED_LEAST_SQUARES
CFL_NUMBER= 2.0
CFL_ADAPT= YES
CFL_ADAPT_PARAM= ( 0.5, 1.2, 1.0, 50.0 )
ITER= 4000
LINEAR_SOLVER= FGMRES
LINEAR_SOLVER_PREC= LU_SGS
LINEAR_SOLVER_ERROR= 1E-5
LINEAR_SOLVER_ITER= 10
CONV_NUM_METHOD_FLOW= FDS
MUSCL_FLOW= YES
SLOPE_LIMITER_FLOW= VENKATAKRISHNAN
VENKAT_LIMITER_COEFF= 0.05
LIMITER_ITER= 300
TIME_DISCRE_FLOW= EULER_IMPLICIT
CONV_NUM_METHOD_TURB= SCALAR_UPWIND
MUSCL_TURB= NO
TIME_DISCRE_TURB= EULER_IMPLICIT
CONV_FIELD= ( RMS_PRESSURE, LIFT, DRAG )
CONV_RESIDUAL_MINVAL= -9
CONV_STARTITER= 200
CONV_CAUCHY_ELEMS= 200
CONV_CAUCHY_EPS= 2E-6
MESH_FILENAME= naca2415_L1.su2
MESH_FORMAT= SU2
TABULAR_FORMAT= CSV
CONV_FILENAME= history
SURFACE_FILENAME= surface_flow
OUTPUT_FILES= ( SURFACE_CSV )
OUTPUT_WRT_FREQ= 100000
HISTORY_OUTPUT= ( ITER, RMS_RES, AERO_COEFF, CAUCHY, LINSOL )
SCREEN_OUTPUT= ( INNER_ITER, RMS_PRESSURE, RMS_VELOCITY-X, LIFT, DRAG, CAUCHY_DRAG )
SCREEN_WRT_FREQ_INNER= 100
WRT_RESTART_OVERWRITE= YES
