davinciucberkeley-collab/DBF-VTOL/fusion/export_stl_fusion.py

import adsk.core, adsk.fusion, traceback, os, json, time, re
app = adsk.core.Application.get()
GROUPS = {}
for n in ('Wing_Panel_R','Wing_Panel_L','Aileron_R','Aileron_L','Spar_Tube','Wing_Joiner','Wing_Saddle','Wing_Bolt','Boom_Front','Boom_Rear_Stub','Boom_Clamp_Front','Boom_Clamp_Rear','Motor_Mount','H_Tail','Elevator','Fin','Fuselage_Pod','Canopy','Pitot_Tube'): GROUPS[n]='airframe'
for n in ('Lift_Motor','Pusher_Motor','Lift_Prop','Pusher_Prop_14in','Spinner'): GROUPS[n]='propulsion'
for n in ('Gear_Clamp','Landing_Leg'): GROUPS[n]='gear'
GROUPS['Battery_6S_LiPo']='electronics'; GROUPS['Proposed_Wheels']='proposed'

def color_of(occ):
    try:
        for b in occ.component.bRepBodies:
            ap = b.appearance
            if ap is None: continue
            c = adsk.core.ColorProperty.cast(ap.appearanceProperties.itemByName('Color'))
            if c: return [round(c.value.red/255.0,3), round(c.value.green/255.0,3), round(c.value.blue/255.0,3)]
    except Exception: pass
    return [0.6,0.6,0.6]

def nbodies(occ):
    n = occ.component.bRepBodies.count
    for o in occ.component.allOccurrences: n += o.component.bRepBodies.count
    return n

def export(des, geom, path, refine):
    em = des.exportManager
    o = em.createSTLExportOptions(geom, path)
    o.isBinaryFormat = True
    o.sendToPrintUtility = False
    o.meshRefinement = refine
    em.execute(o)
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
