davinciucberkeley-collab/DBF-VTOL/(commit log)

2026-10-19 README: add status, interactive outputs (review, CAD viewer, flight sim), artifact links and sim results
    Claude-Session: https://claude.ai/code/session_01BoGkgR3KP795byqnkkcvJ5
2026-10-19 Inventory Czar overview (DBF-INV-001), inventory master list and Google Sheet seed
    - inventory/build_inventory.mjs: 63 stock lines from C0_BOM.csv and the CAD
    assembly (40 buy, 21 make, 2 proposed Nautical Wings carbon props), kits K1-K7
    - inventory/build_overview.mjs -> Inventory-Overview.html: overview, 3D model
    coloured by inventory status (explode, isolate by kit, part cards), inventory
    table, budget and orders, fabrication and kits, NWA props, receiving
    - inventory/build_sheet.py: Google Sheet seed CSV and formatted xlsx;
    live sheet link in inventory/sheet.json
    - docs/research/nautical-wings-props.md: NWA findings, prop spec sheet,
    acceptance tests
    - README: inventory overview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
    [DBF-Inventory-sheet.csv, DBF-Inventory.xlsx, inventory.csv]
2026-10-19 Electrical architecture, wiring blueprint, wheeled gear proposal and NWA sponsorship
    - docs/research/electrical-architecture.md + inventory/electrical/*.json:
    power and signal trees, FC output/UART map (ArduPilot QuadPlane), power
    budget, wire gauges, connectors, breakdown joints J1-J3, test plan,
    wheeled landing gear geometry (pusher clearance 36 -> 84 mm EST)
    - Inventory-Overview.html: 3D model now shows avionics, ESCs, servos, wire
    runs and proposed wheels; new Electrical and Wiring & tests sections
    (blueprint DBF-ELE-001, wire schedule, harness by joint); gear proposal;
    NWA founders' verbal sponsorship offer with a message to send
    - inventory: NWA status, proposed lines G-01.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
    [DBF-Inventory-sheet.csv, DBF-Inventory.xlsx, inventory.csv]
2026-10-21 Inventory overview: Impeccable distill pass
    Team working tool first: each section opens with its task (orders by
    vendor, wire schedule, inventory table, kit bins, NWA message); method,
    background and long notes move behind disclosures; repeated facts said
    once and linked; one 'Open live inventory' button. Visible text -45 %,
    total content kept (97 %); all numbers, sources, EST and safety
    conflicts unchanged. Deep links open their disclosure; print expands all.
    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
2026-11-02 Full-detail Fusion model, hardware schedule and print tolerances
    - fusion/: scripts that build the aircraft in Autodesk Fusion (airframe,
    613 hardware pieces, servos, pushrods, clevises, hinges, wheel axle
    blocks, toleranced holes) and export it; interference report
    - inventory/fusion/: STEP, .f3d, per-part STL meshes, manifest, renders
    - inventory/hardware/: hardware schedule, mechanisms, tolerances, new lines
    - docs/research/hardware-schedule.md, tolerance-analysis.md
    - Inventory overview: Fusion viewer with joint cards (§2), print fits and
    stack-ups (§7)
    Claude-Session: https://claude.ai/code/session_01BoGkgR3KP795byqnkkcvJ5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
    [ASPD1.stl, Aileron_L.stl, Aileron_R.stl, BUS1.stl, Battery_6S_LiPo.stl, Boom_Clamp_Front_1.stl, Boom_Clamp_Front_2.stl, Boom_Clamp_Rear_1.stl]
2026-11-02 Concept models: eleven literature VTOL concepts as 3D models on the C0 envelope
    Concept-Models.html, built by concepts/build.mjs from cad/params.txt and
    analysis/results.json. A0 is C0 as placed in the CAD parameters; the other
    ten reuse its parts (proportions EST, not sized). Orbit, hover-to-cruise
    transition, battery and 3 m span overlays, per-concept checks and one
    literature claim with its source each. README lists it as output 5.
2026-11-02 Fusion assembly joints, kinematics and animations
    - fusion/: joint builder (5 rigid groups, 24 revolute, 5 slider joints,
    5 servo-to-surface motion links), four-bar kinematics generator,
    animation renderer
    - inventory/fusion/kinematics/: kinematics.json (pivots, axes, limits,
    exact servo-to-surface and pushrod tables) and moving-part STLs;
    static STLs and manifest regenerated so nothing is drawn twice
    - inventory/fusion/animations/: control surfaces, props, wheels and
    transport breakdown (MP4 + GIF)
    - Inventory overview: live roll/pitch/yaw sliders, spin props, roll
    wheels and breakdown in the Fusion viewer
    Claude-Session: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
    [ASPD1.stl, Aileron_L.stl, Aileron_R.stl, Arm_Aileron_L.stl, Arm_Aileron_R.stl, Arm_Elevator.stl, Arm_Rudder_L.stl, Arm_Rudder_R.stl]
2026-11-02 Motion clearance: sweep every joint and fix all collisions
    - Full-range sweep of the 5 control mechanisms, props, wheels and the
    breakdown sliders in Fusion; 0 rigid collisions after the fixes
    - Wing panels: trailing-edge coves, pushrod exit slots, arm reliefs;
    elevator end reliefs; tail saddle and rudder horn reliefs; longer
    battery pocket (battery slider now -4..+7 mm)
    - Re-exported affected STLs, STEP and .f3d (with joints); re-rendered
    animations; breakdown order canopy, H-tail, wing panels on the page
    - fusion/motion_clearance.md and motion_clearance_report.json
    Claude-Session: https://claude.ai/code/session_01BoGkgR3KP795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
    [Elevator.stl, Fuselage_Pod.stl, J-16_Tail_fin_and_L.stl, J-16_Tail_fin_and_R.stl, Rudder_L.stl, Rudder_R.stl, VTOL_Fusion.f3d, VTOL_Fusion.step]
2026-11-03 Alternative designs A1-A3: variant designs, inventories and Fusion models
    Builds out the three group A concepts from James's concept page (the
    least experimental: refinements that keep lift + cruise) as full
    variants of C0:
    - A1 wingtip cruise propellers, A2 boundary-layer-ingesting pusher,
    A3 aligned, faired stopped rotors
    - concepts/variants/<id>/: design note, geometry change list, complete
    inventory vs C0 (same/changed/removed/new, live prices), metrics
    - Fusion: each variant is a saveAs copy of VTOL C0 full in project
    DBF-VTOL, with all new parts and hardware, joints and clearance
    checks; STEP, .f3d, STLs and renders in concepts/variants/<id>/fusion
    - Inventory overview section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
    [BUS1.stl, Battery_6S_LiPo.stl, Battery_Tray_Ext.stl, CAP_P.stl, CAP_T_L.stl, CAP_T_R.stl, Canopy.stl, ESC_P.stl]
2026-11-04 Inventory overview: cut the text and make every section visual
    Impeccable distill pass (about 9,000 fewer words; design notes linked
    instead of embedded, duplicated test list removed), then charts, tiles,
    step flows and a harness schematic in place of prose and lists:
    budget bar and kit tiles, current-vs-rating bars, E1-E7 test flow,
    vendor bars, fit and stack-up plots, NWA and receiving step flows.
    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
